davidkellis/keyboards/tkl/tkl1/README.md

# TKL v1: initial layout and KiCad design

This snapshot preserves the first TKL design iteration after the original
[v0 project](../tkl0/README.md). The existing source and layout files are
preserved byte for byte.

- Open [tkl.kicad_pro](tkl.kicad_pro) in KiCad.
- [PCB](tkl.kicad_pcb) and [schematic](tkl.kicad_sch)
- [Layout data](keyboard-layout.json)
- [Layout preview](keyboard-layout.png) and [alternate preview](keyboard-layout2.png)
- [Plate outline](keyboard-plate.svg)

The KiCad project is still named `tkl`; the directory name identifies this
snapshot as v1. See the [repository index](../../README.md) for later revisions.
