davidkellis/keyboards/tkl/tkl8/manufacturing/drill-report.txt

Drill report for keyboard.kicad_pcb
Created on 2026-09-25T14:55:08

Copper Layer Stackup:
    =============================================================
    L1 :  F.Cu                      front
    L2 :  In1.Cu                    in1
    L3 :  In2.Cu                    in2
    L4 :  B.Cu                      back

Drill file 'keyboard-PTH.drl' contains
    plated through holes:
    =============================================================
    T1  0.300mm  0.0118"  (188 holes))
    T2  0.305mm  0.0120"  (93 holes))
    T3  0.600mm  0.0236"  (4 holes)  (with 4 slots)
    T4  0.750mm  0.0295"  (4 holes))
    T5  1.200mm  0.0472"  (172 holes))
    T6  1.600mm  0.0630"  (86 holes))

    Total plated holes count 547

Drill file 'keyboard-NPTH.drl' contains
    unplated through holes:
    =============================================================
    T1  0.650mm  0.0256"  (2 holes))
    T2  0.900mm  0.0354"  (2 holes))
    T3  0.991mm  0.0390"  (3 holes))
    T4  5.050mm  0.1988"  (86 holes))

    Total unplated holes count 93
