davidkellis/keyboards/tkl/tkl5/keyboard-layout2.png

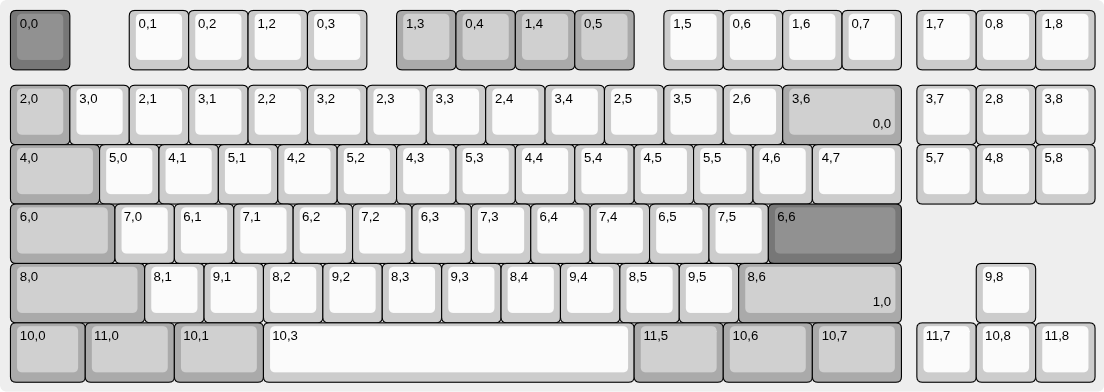
tkl/tkl5/keyboard-layout2.png
