davidkellis/keyboards/tkl/tkl5/keyboard-layout.png

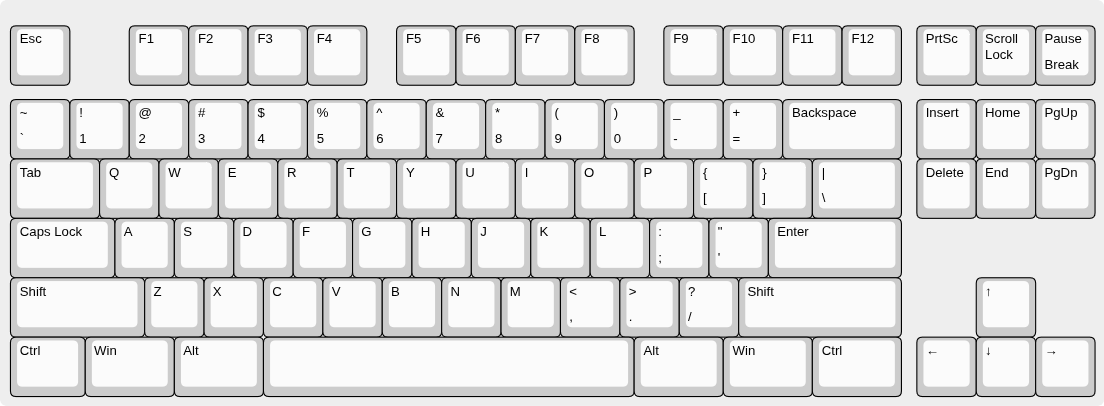
tkl/tkl5/keyboard-layout.png
