davidkellis/keyboards/tkl/tkl7.5/reference/usb-extension-dimensions-listing.png

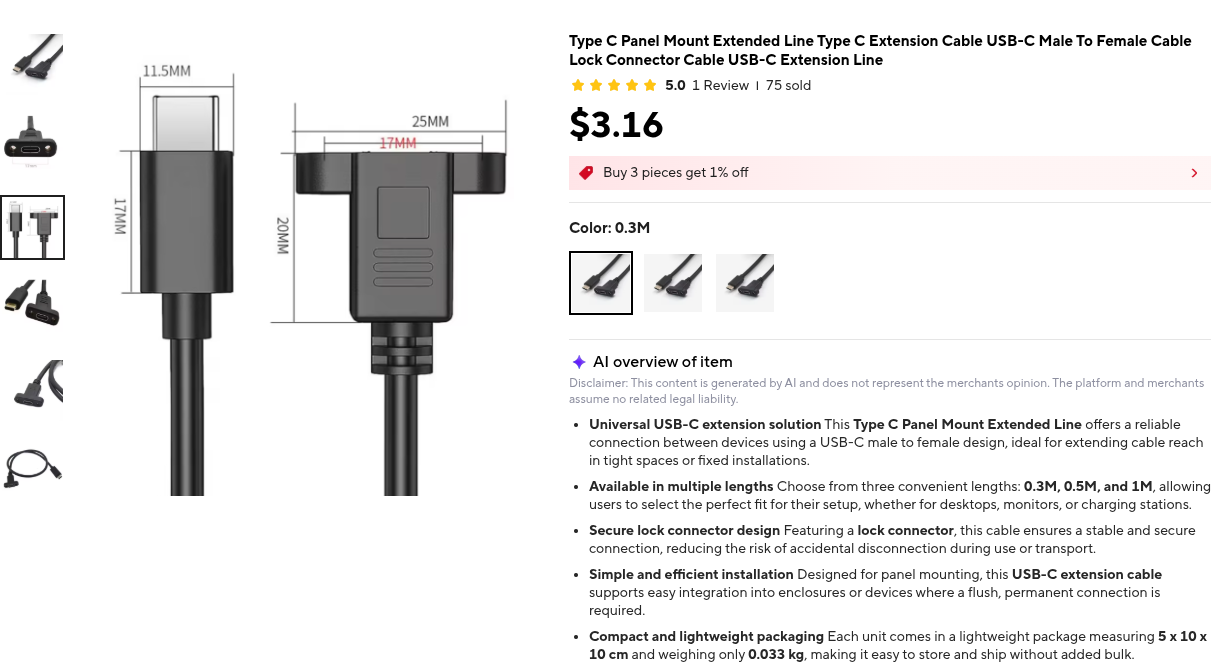
tkl/tkl7.5/reference/usb-extension-dimensions-listing.png
