davidkellis/keyboards/tkl/tkl7.5/reference/usb-extension-front-listing.png

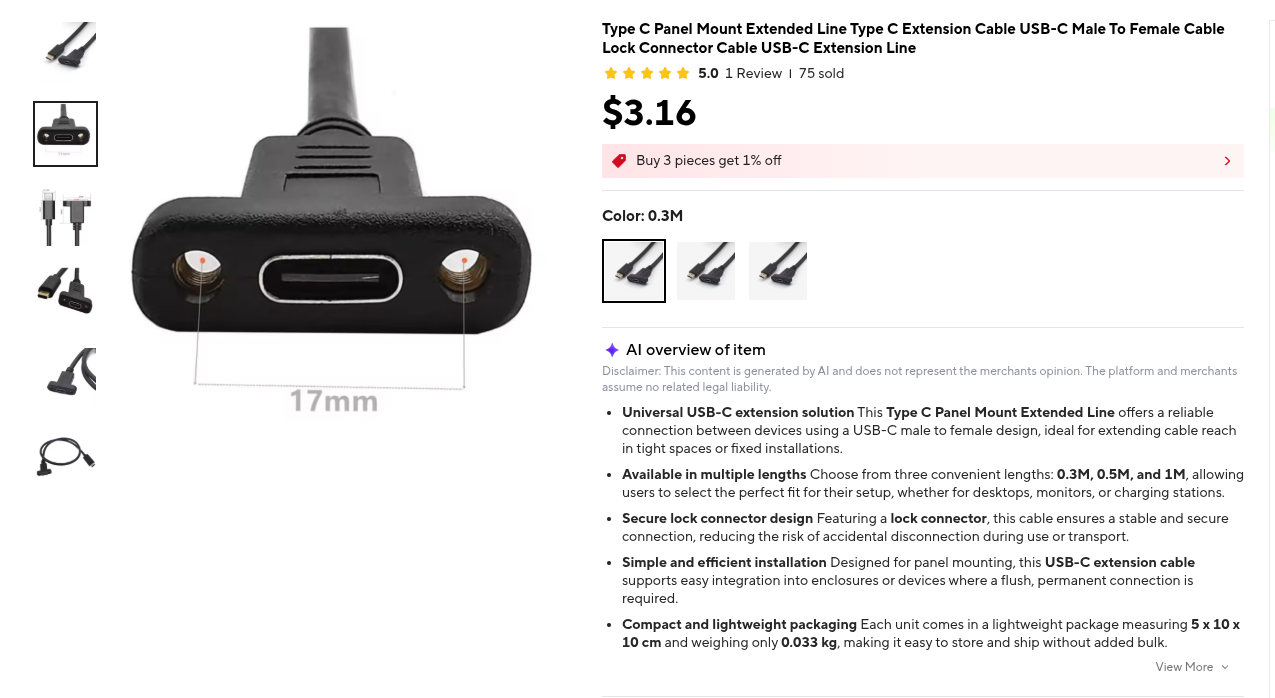
tkl/tkl7.5/reference/usb-extension-front-listing.png
