davidkellis/keyboards/tkl/tkl8/case/fit-preview.png

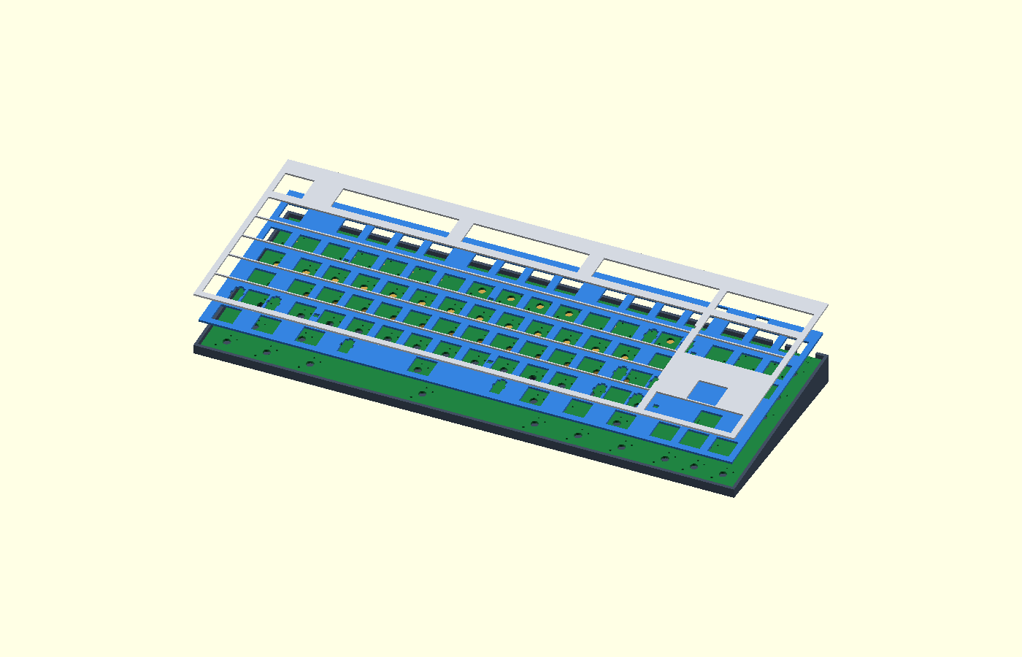
tkl/tkl8/case/fit-preview.png
