davidkellis/keyboards/tkl/tkl9.1/case/upper-preview.png

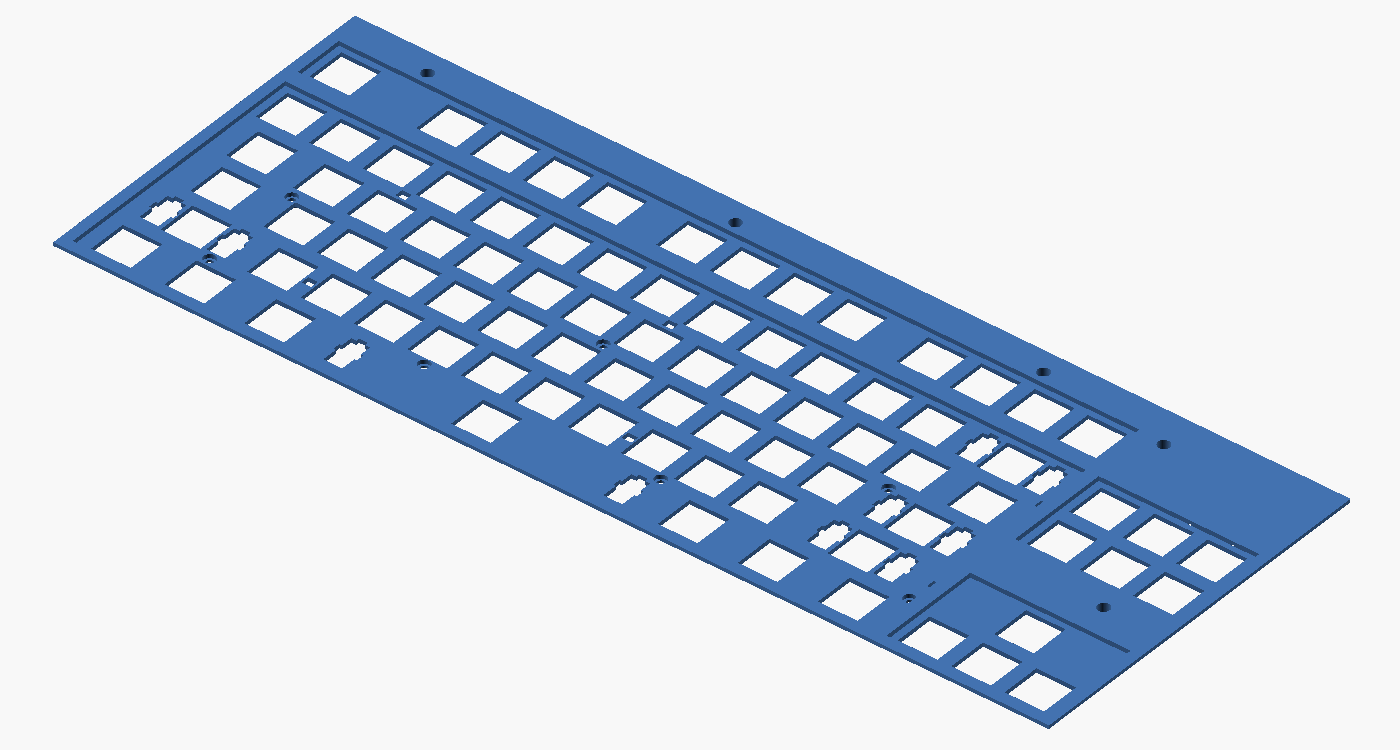
tkl/tkl9.1/case/upper-preview.png
