davidkellis/keyboards/tkl/tkl9.1/reference/tenstar-clone-reference.png

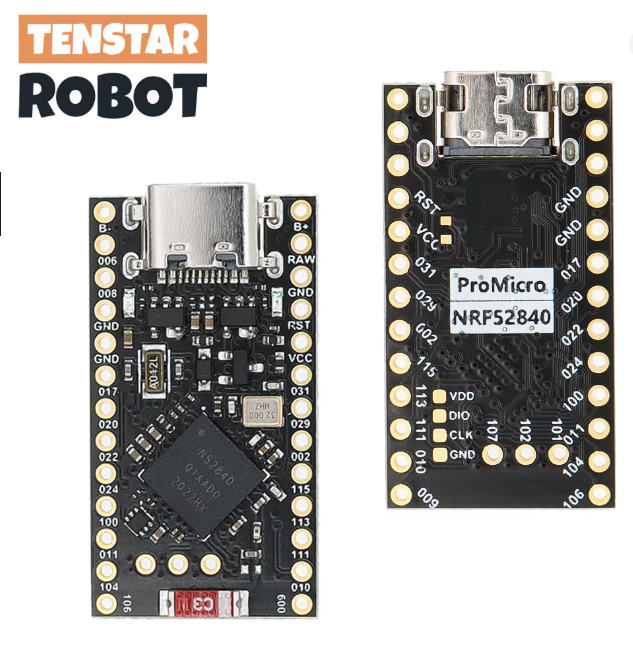
tkl/tkl9.1/reference/tenstar-clone-reference.png
