davidkellis/keyboards/tkl/tkl9.1/reference/tenstar-dimensions-listing.png

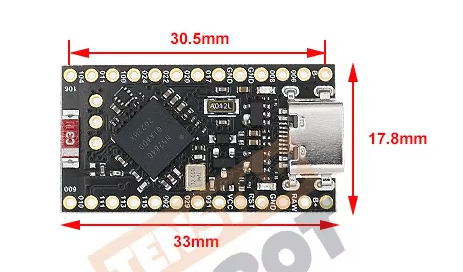
tkl/tkl9.1/reference/tenstar-dimensions-listing.png
