davidkellis/keyboards/tkl/tkl10/case-18650-study/comparison.png

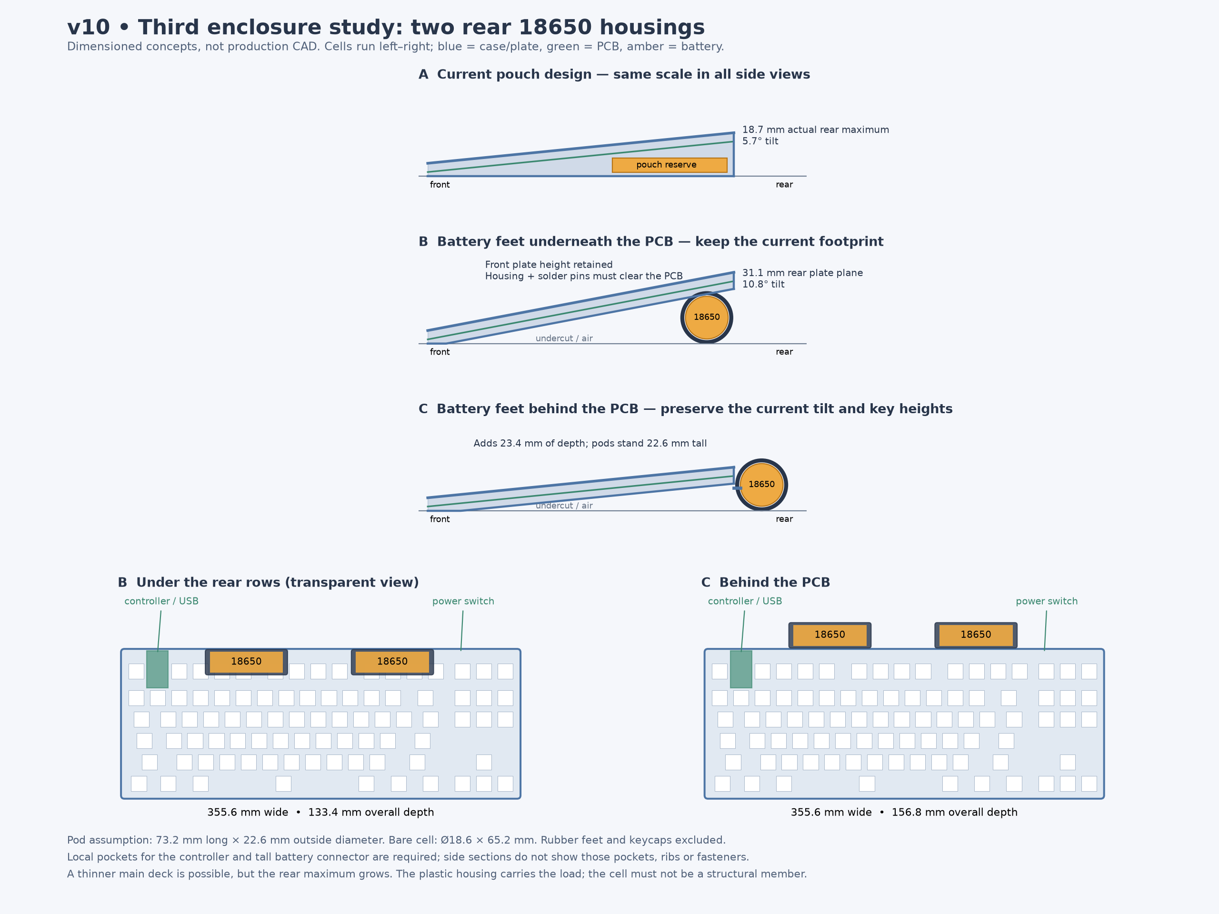
tkl/tkl10/case-18650-study/comparison.png
