davidkellis/keyboards/tkl/tkl10/case-hidden-mounts/completed-overview.png

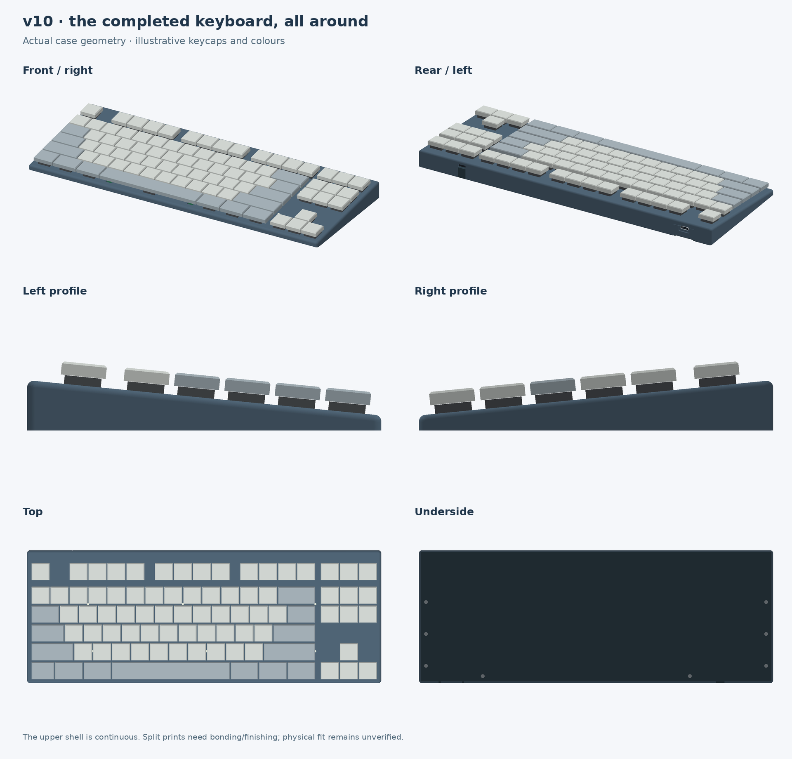
tkl/tkl10/case-hidden-mounts/completed-overview.png
