davidkellis/keyboards/tkl/tkl10/case-hidden-mounts/completed-views/bottom.png

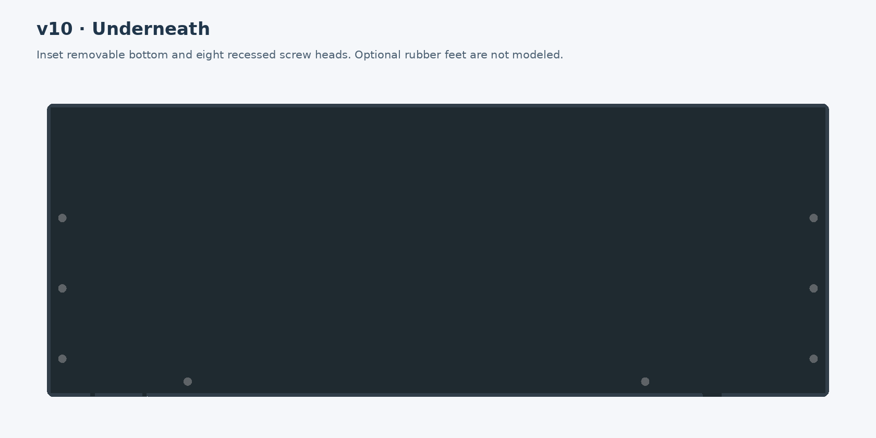
tkl/tkl10/case-hidden-mounts/completed-views/bottom.png
