davidkellis/keyboards/tkl/tkl10/case-hidden-mounts/completed-views/front.png

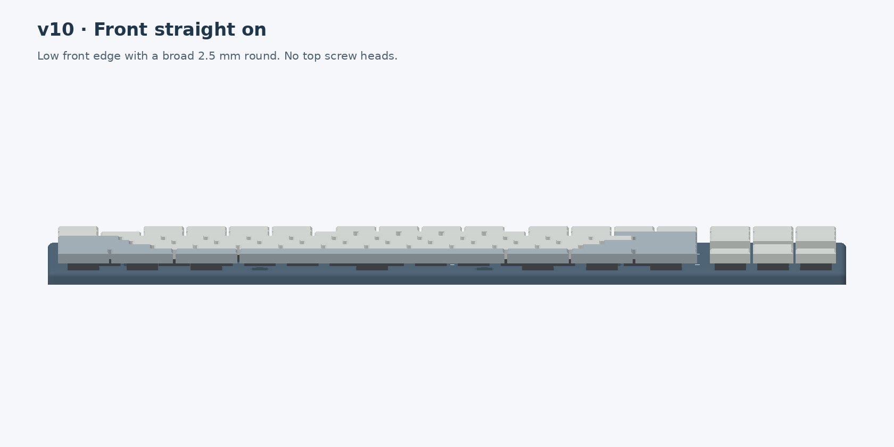
tkl/tkl10/case-hidden-mounts/completed-views/front.png
