davidkellis/keyboards/tkl/tkl10/case-hidden-mounts/completed-views/left.png

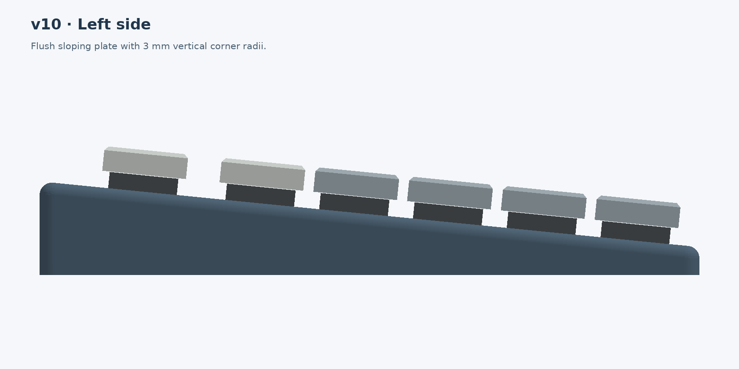
tkl/tkl10/case-hidden-mounts/completed-views/left.png
