davidkellis/keyboards/tkl/tkl10/case-hidden-mounts/completed-views/orbit-02.png

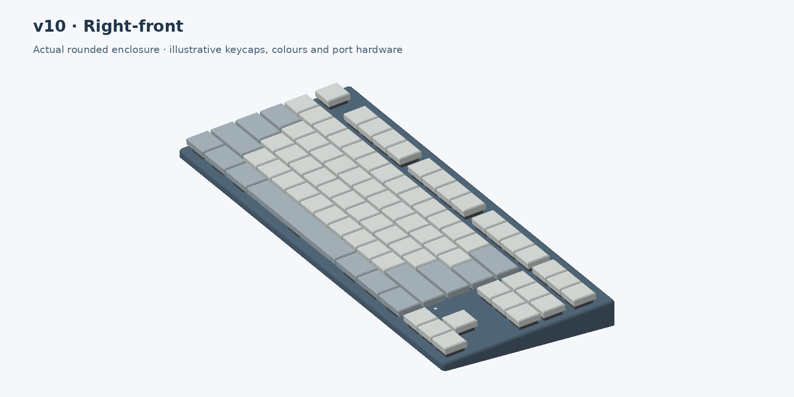
tkl/tkl10/case-hidden-mounts/completed-views/orbit-02.png
