davidkellis/keyboards/tkl/tkl10/case-hidden-mounts/completed-views/orbit-09.png

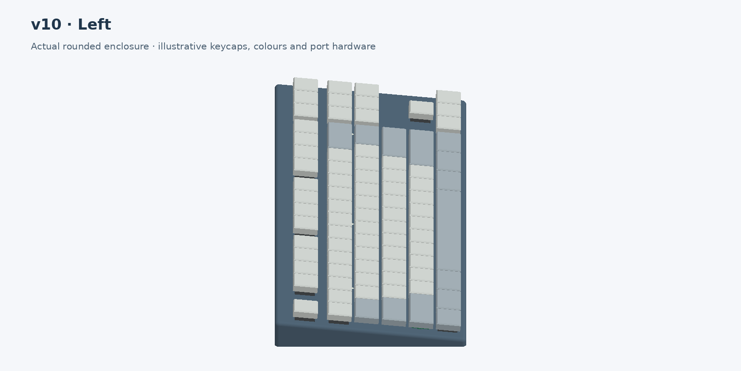
tkl/tkl10/case-hidden-mounts/completed-views/orbit-09.png
