davidkellis/keyboards/tkl/tkl10/case-hidden-mounts/completed-views/rear.png

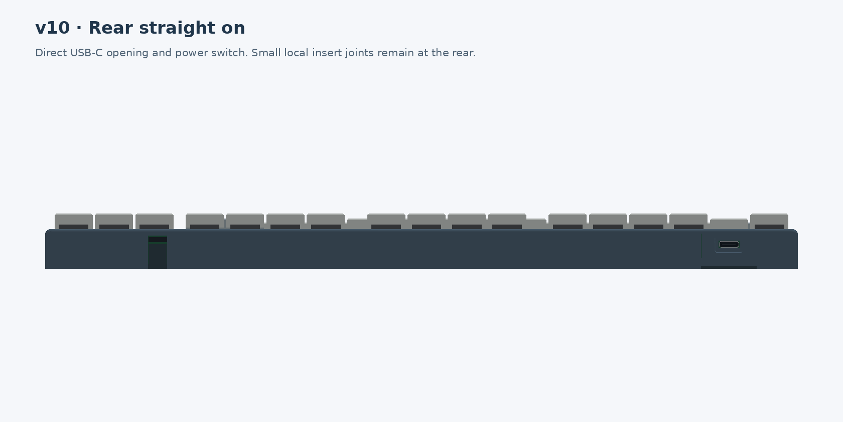
tkl/tkl10/case-hidden-mounts/completed-views/rear.png
