davidkellis/keyboards/tkl/tkl10/case-hidden-mounts/completed-views/right.png

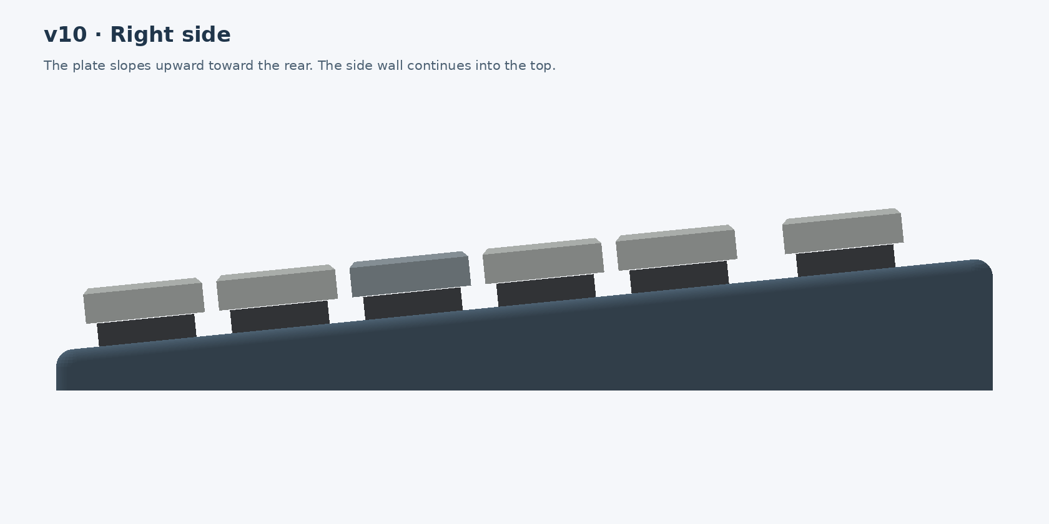
tkl/tkl10/case-hidden-mounts/completed-views/right.png
