davidkellis/keyboards/tkl/tkl10/case-hidden-mounts/completed-views/top.png

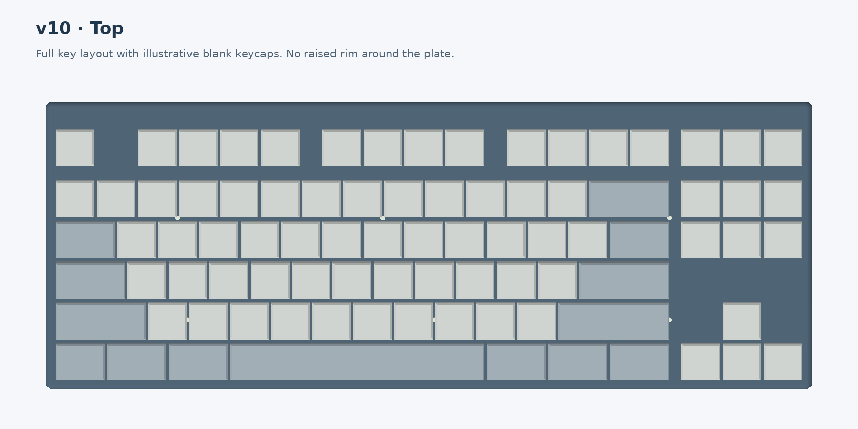
tkl/tkl10/case-hidden-mounts/completed-views/top.png
