davidkellis/keyboards/tkl/tkl10/case-hidden-mounts/exploded-preview.png

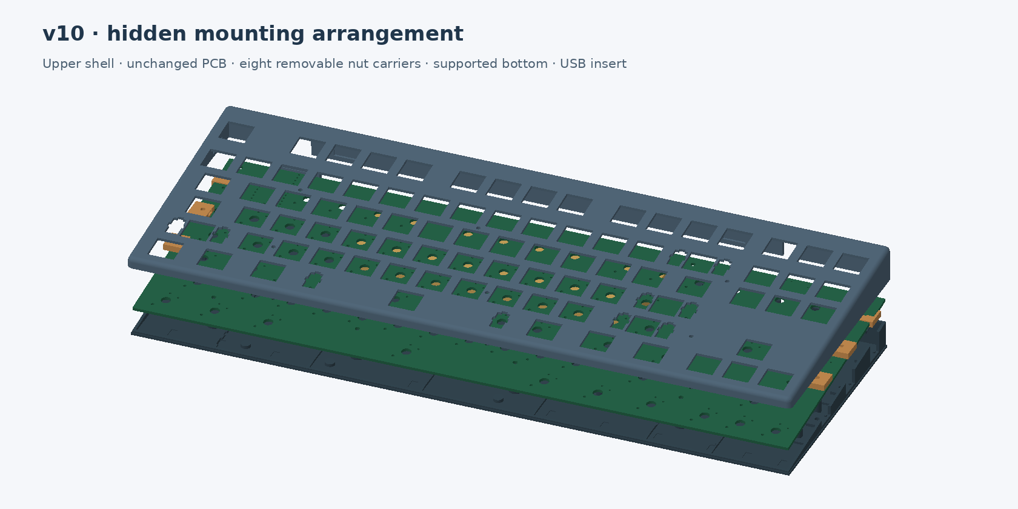
tkl/tkl10/case-hidden-mounts/exploded-preview.png
