davidkellis/keyboards/tkl/tkl10/case-hidden-mounts/mount-detail.png

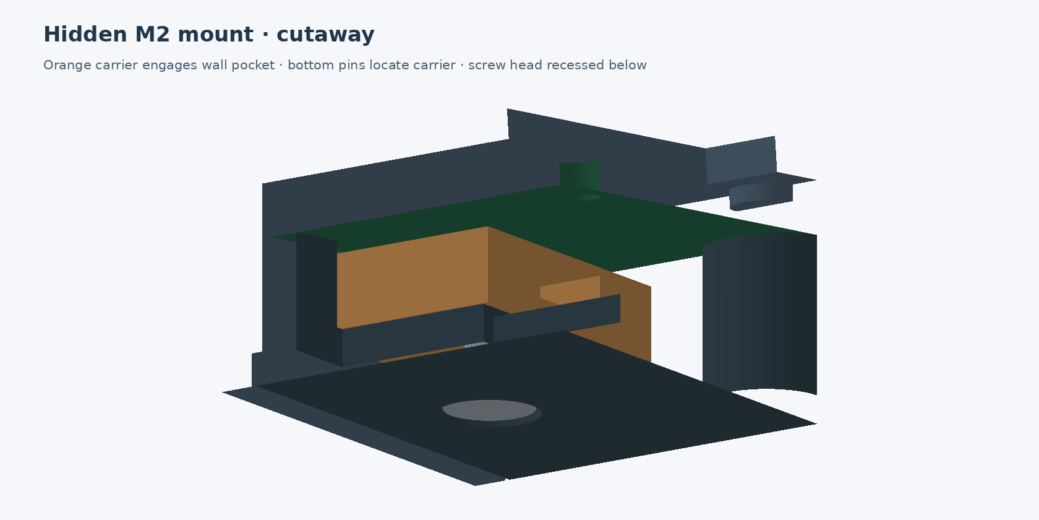
tkl/tkl10/case-hidden-mounts/mount-detail.png
