davidkellis/keyboards/tkl/tkl10/case-hidden-mounts/rounded-edge-detail.png

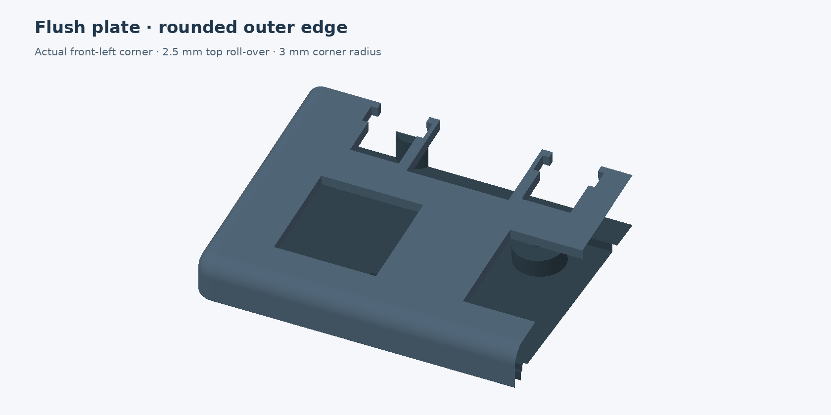
tkl/tkl10/case-hidden-mounts/rounded-edge-detail.png
