davidkellis/keyboards/tkl/tkl10/case-hidden-mounts/shell-section.png

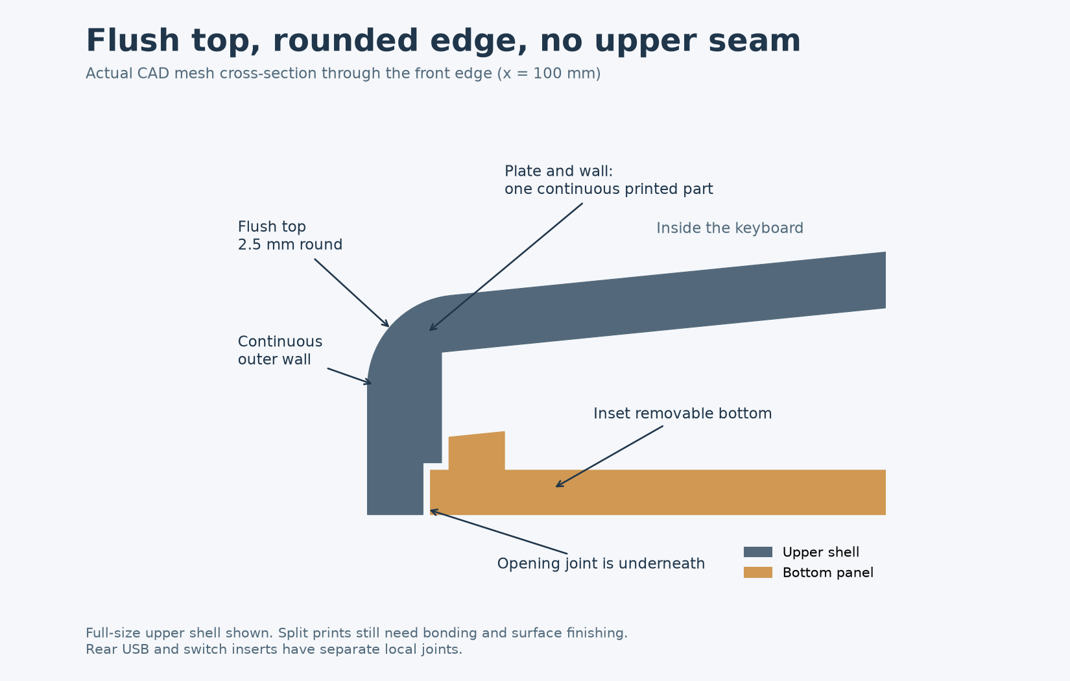
tkl/tkl10/case-hidden-mounts/shell-section.png
