davidkellis/keyboards/tkl/tkl10/case-hidden-mounts/top-preview.png

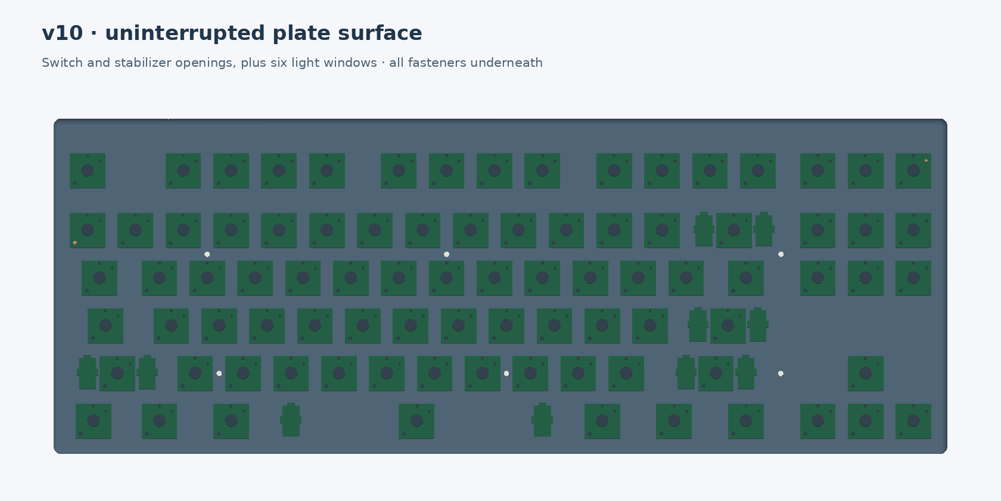
tkl/tkl10/case-hidden-mounts/top-preview.png
