davidkellis/keyboards/tkl/tkl10/case-hidden-mounts/underside-preview.png

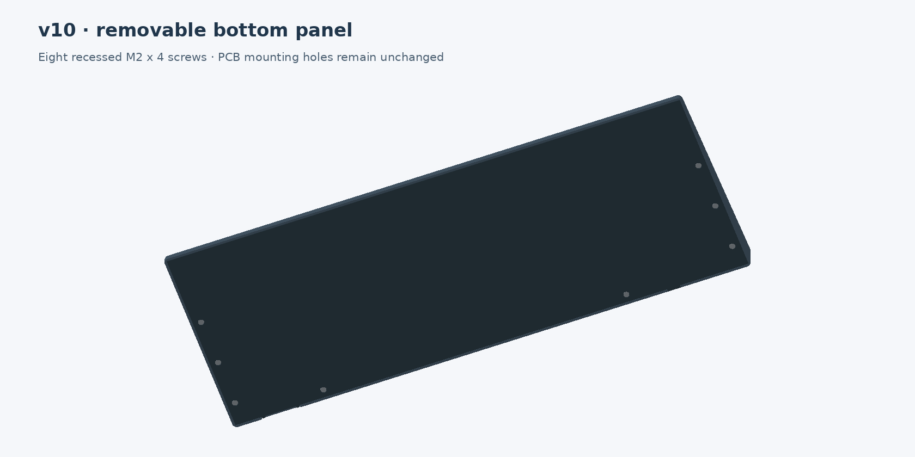
tkl/tkl10/case-hidden-mounts/underside-preview.png
