davidkellis/keyboards/tkl/tkl10/case-hidden-mounts/with-keycaps-preview.png

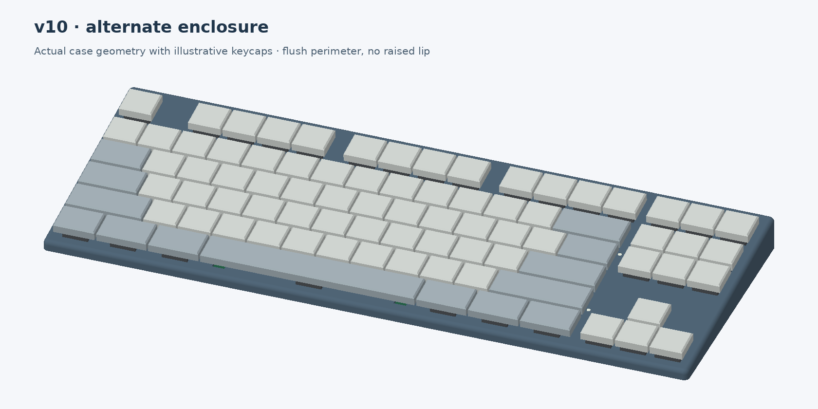
tkl/tkl10/case-hidden-mounts/with-keycaps-preview.png
