davidkellis/keyboards/tkl/tkl10/case-slim-study/height-options.png

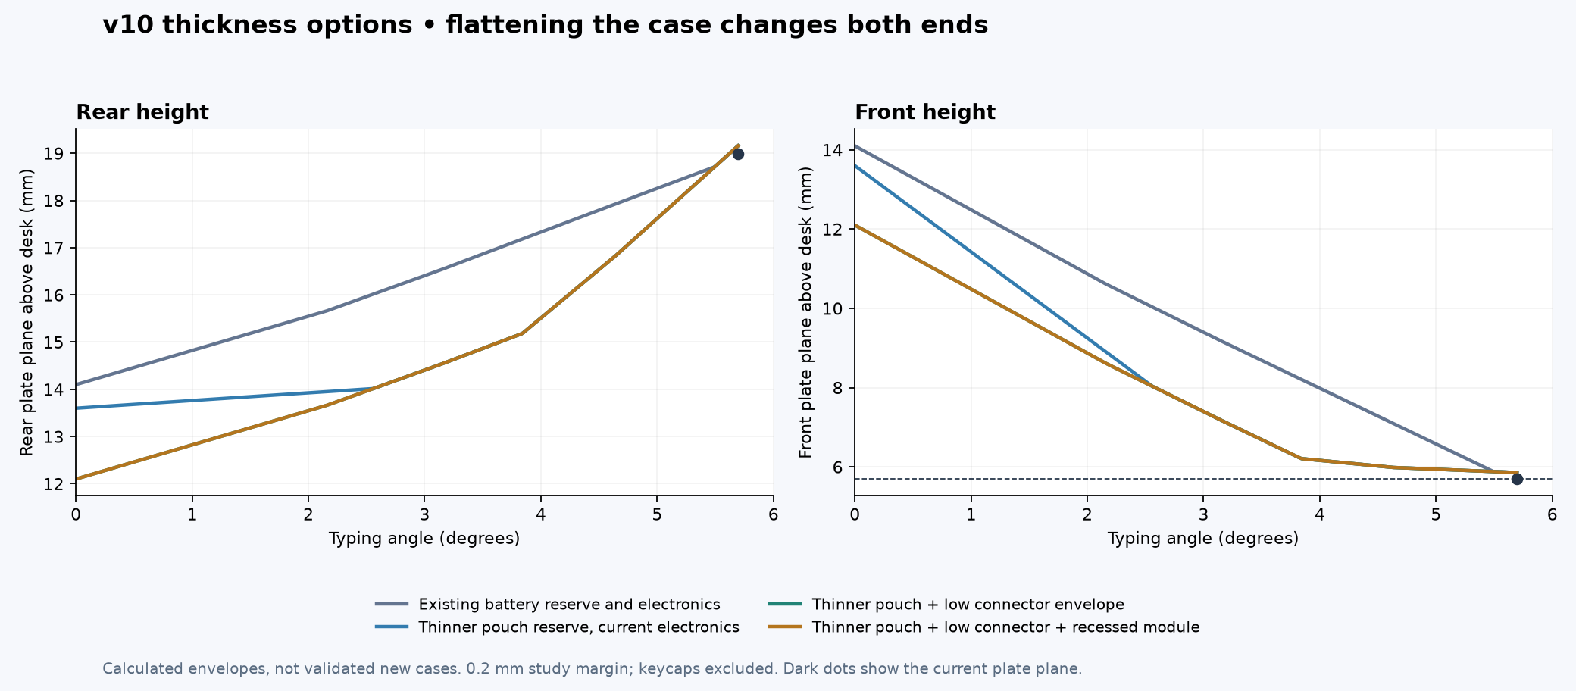
tkl/tkl10/case-slim-study/height-options.png
