davidkellis/keyboards/tkl/tkl10/case/base-preview.png

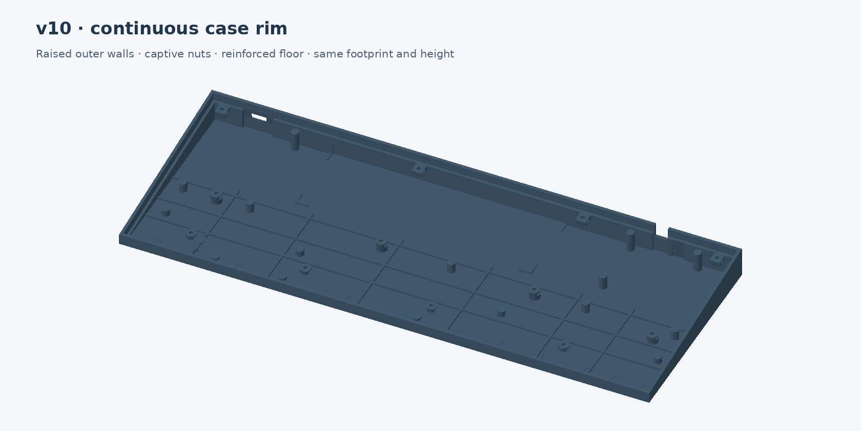
tkl/tkl10/case/base-preview.png
