davidkellis/keyboards/tkl/tkl10/case/module-fit.png

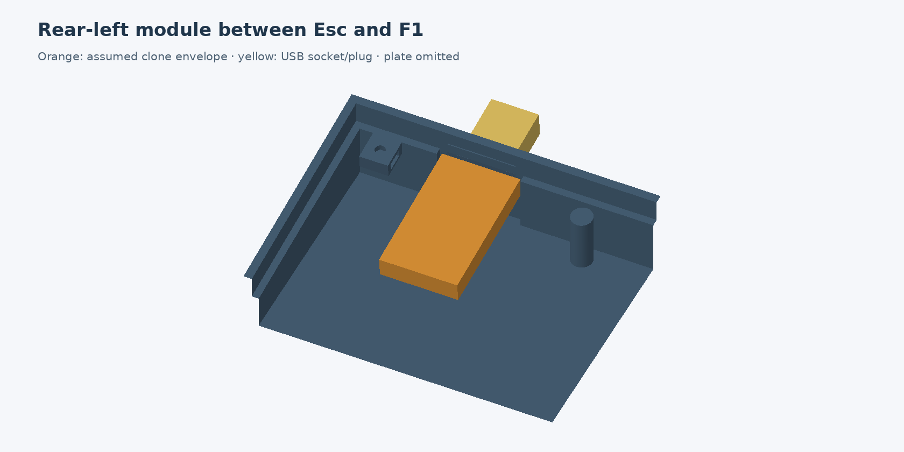
tkl/tkl10/case/module-fit.png
