davidkellis/keyboards/tkl/tkl10/case/mounting-plan.png

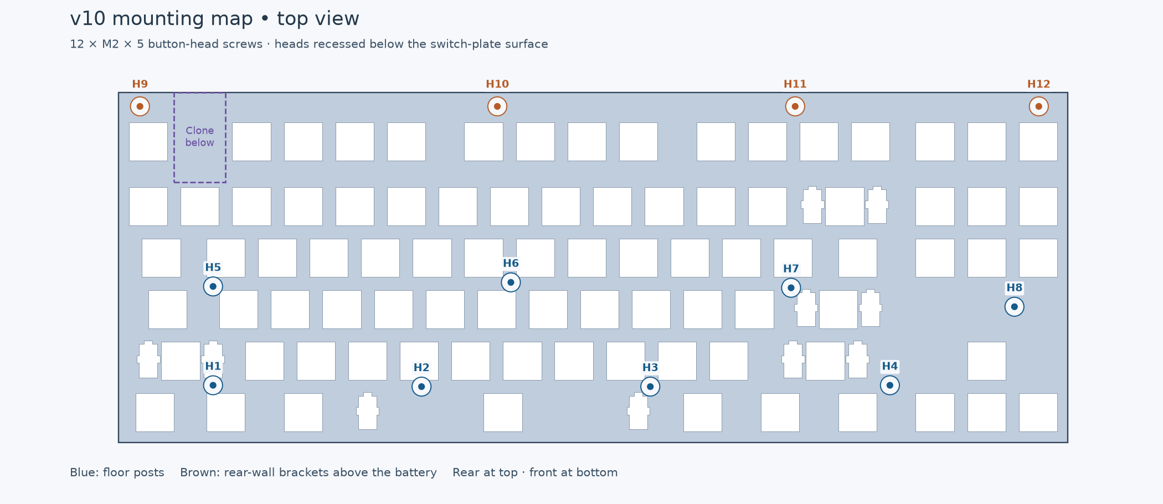
tkl/tkl10/case/mounting-plan.png
