davidkellis/keyboards/tkl/tkl10/case/plate-preview.png

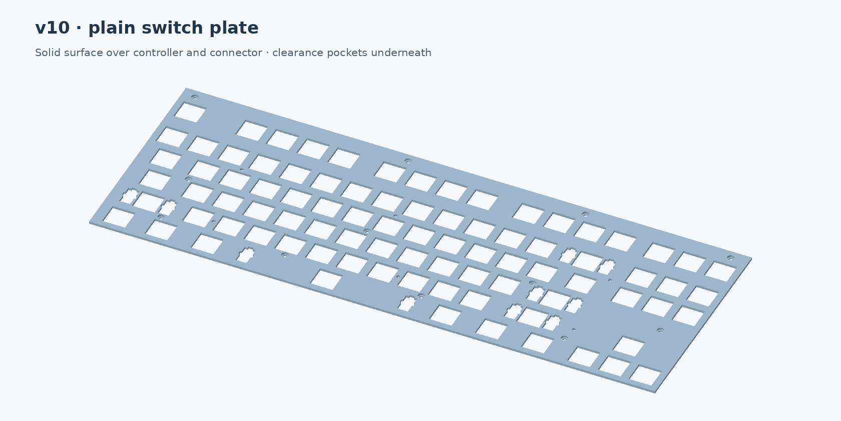
tkl/tkl10/case/plate-preview.png
