davidkellis/keyboards/tkl/tkl10/case/rear-detail.png

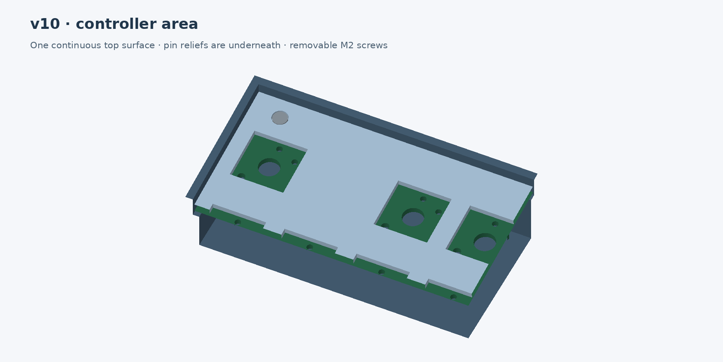
tkl/tkl10/case/rear-detail.png
