davidkellis/keyboards/tkl/tkl10/case/usb-surround.png

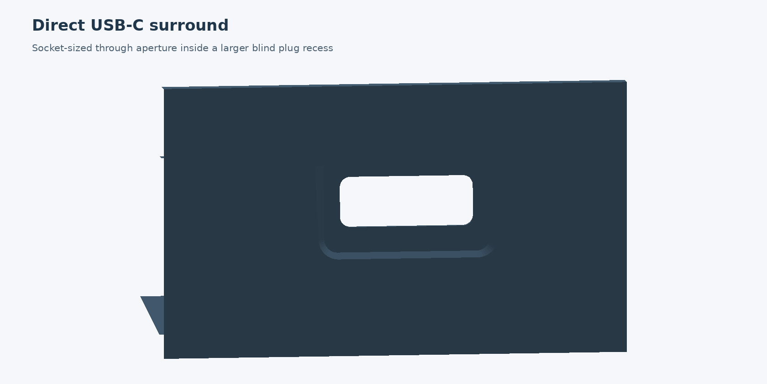
tkl/tkl10/case/usb-surround.png
