davidkellis/keyboards/tkl/tkl10/lighting-engineering-study/design-preview.png

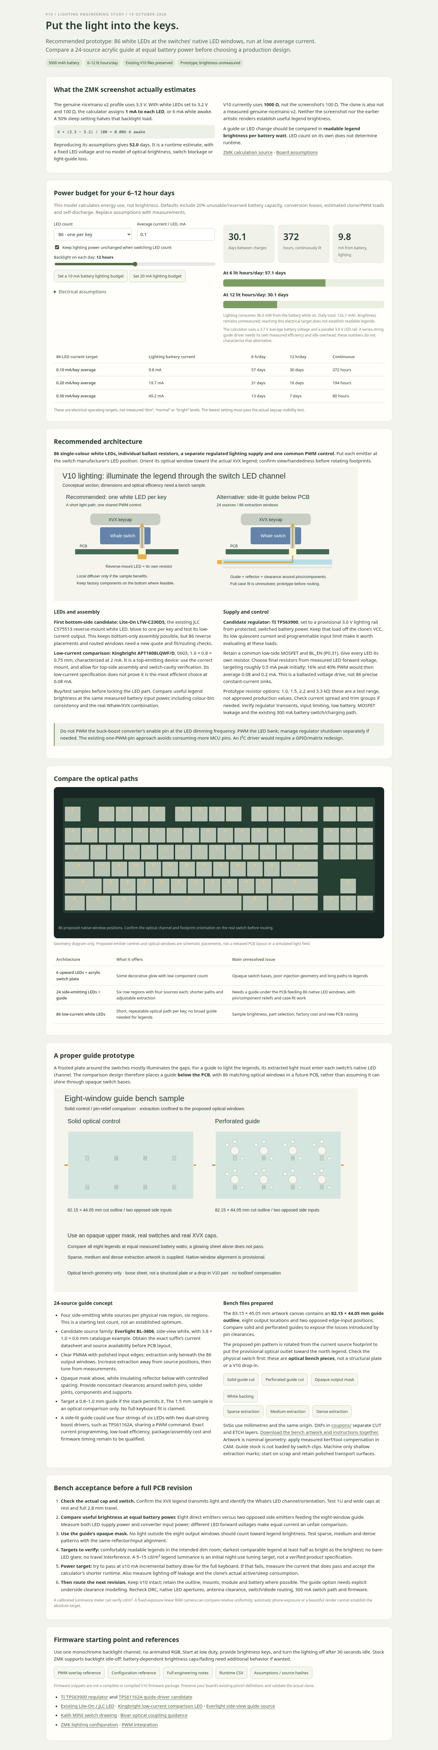
tkl/tkl10/lighting-engineering-study/design-preview.png
