davidkellis/keyboards/tkl/tkl10/lighting-engineering-study/lighting-section.png

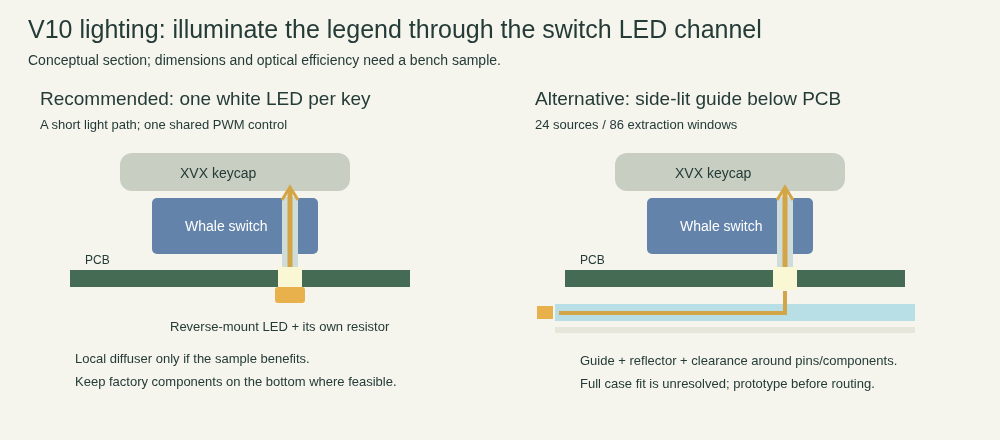
tkl/tkl10/lighting-engineering-study/lighting-section.png
