davidkellis/keyboards/tkl/tkl10/lighting-engineering-study/mobile-preview.png

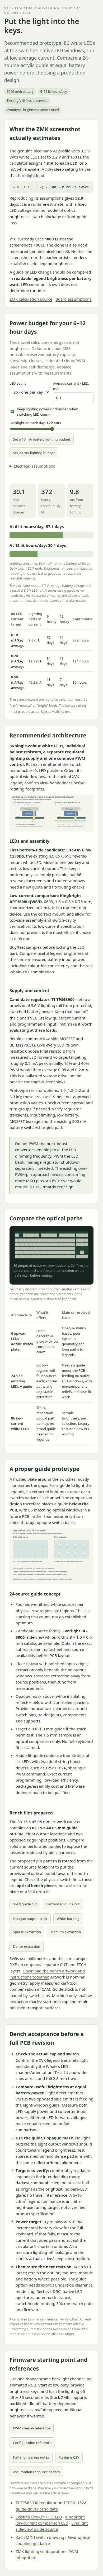
tkl/tkl10/lighting-engineering-study/mobile-preview.png
