davidkellis/keyboards/tkl/tkl10/lighting-engineering-study/power-budget-preview.png

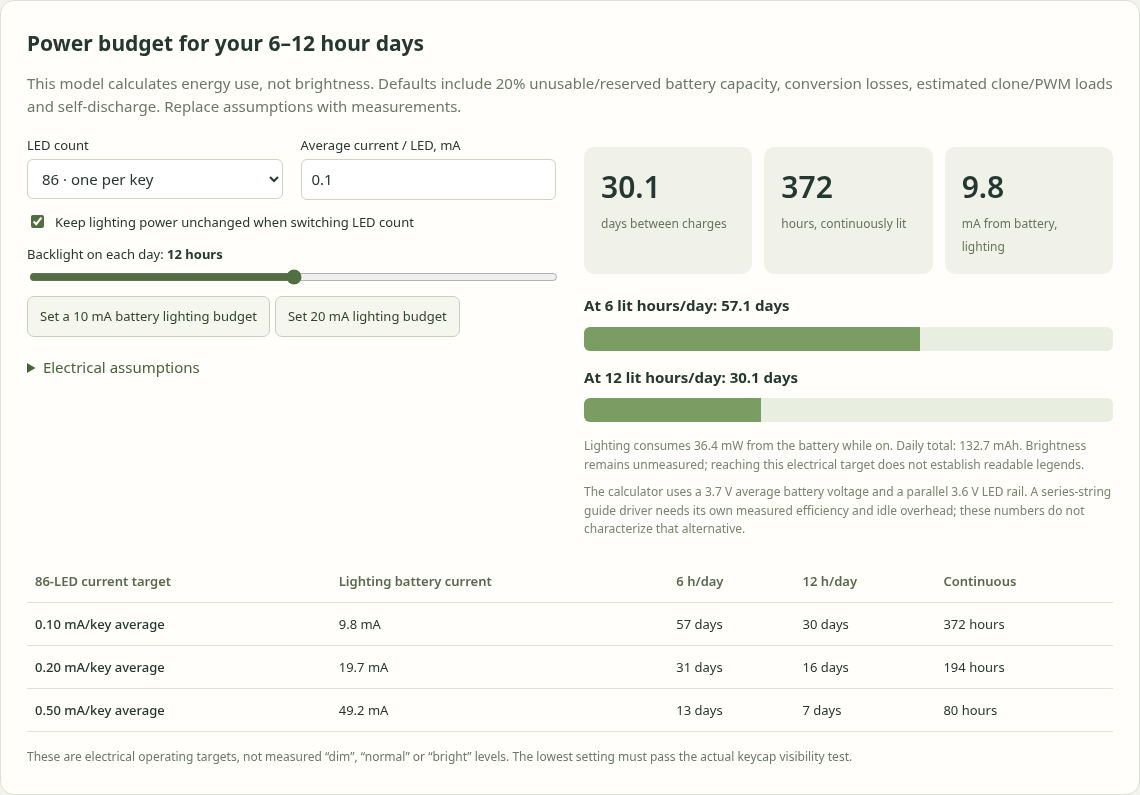
tkl/tkl10/lighting-engineering-study/power-budget-preview.png
