davidkellis/keyboards/tkl/tkl10/lighting-guide-12-study/design-preview.png

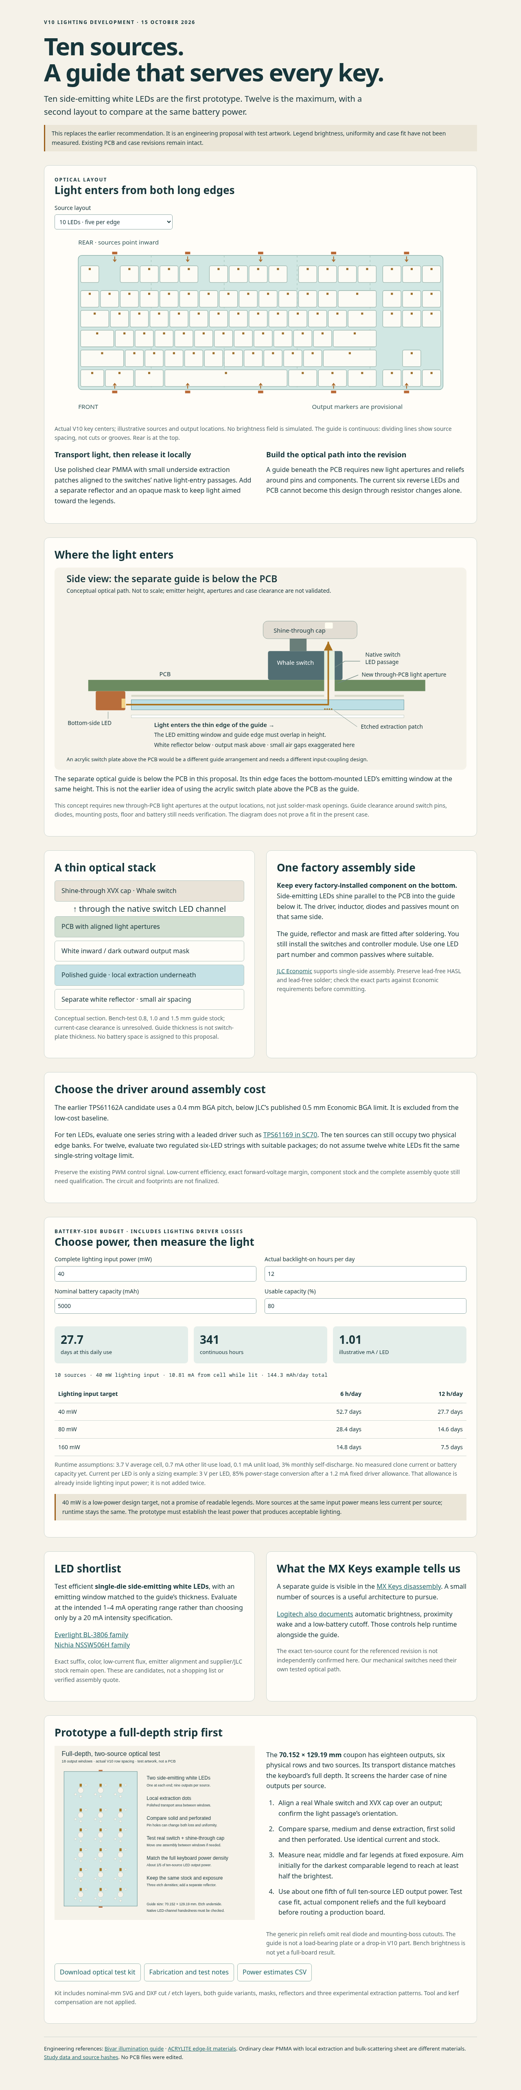
tkl/tkl10/lighting-guide-12-study/design-preview.png
