davidkellis/keyboards/tkl/tkl10/render-360/bottom.png

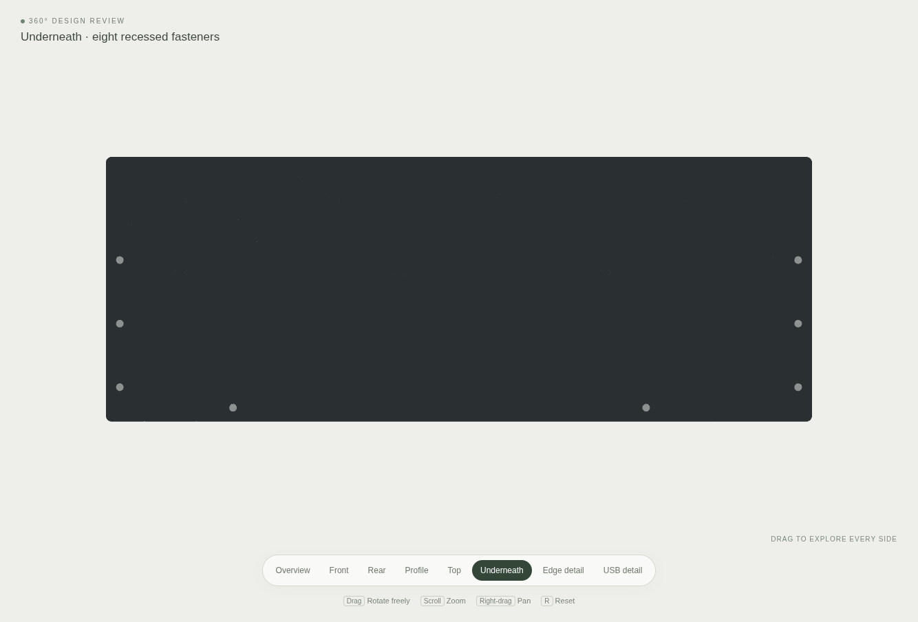
tkl/tkl10/render-360/bottom.png
