davidkellis/keyboards/tkl/tkl10/render-360/edge.png

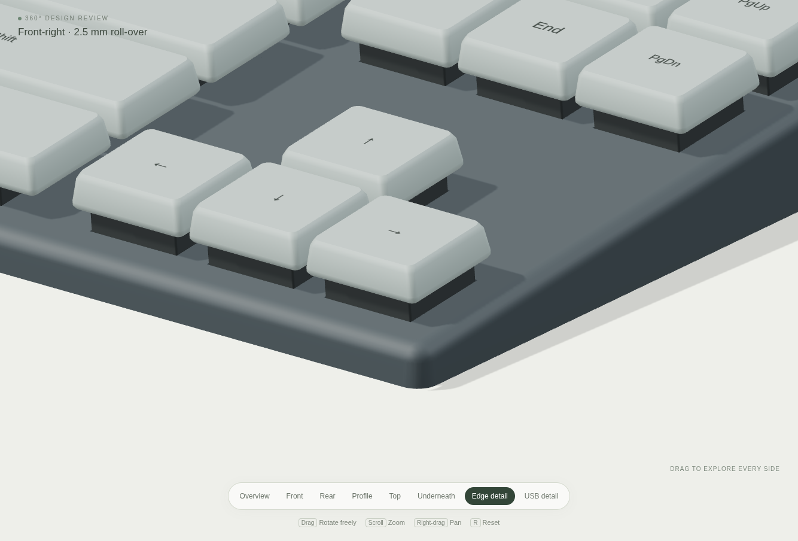
tkl/tkl10/render-360/edge.png
