davidkellis/keyboards/tkl/tkl10/render-360/front.png

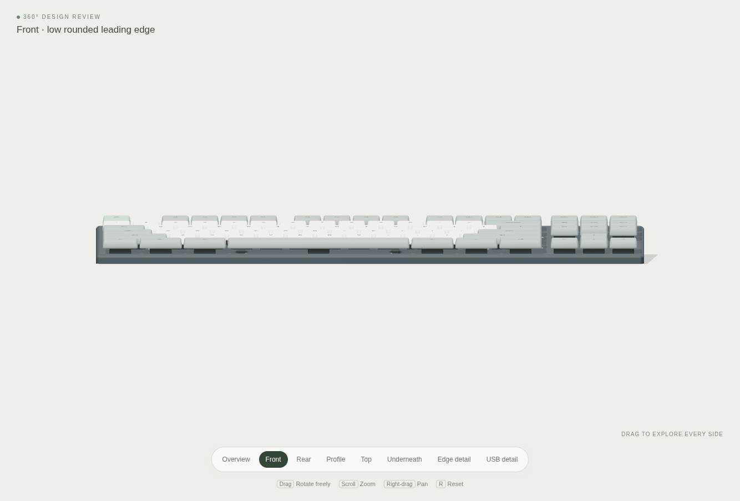
tkl/tkl10/render-360/front.png
