davidkellis/keyboards/tkl/tkl10/render-360/hero.png

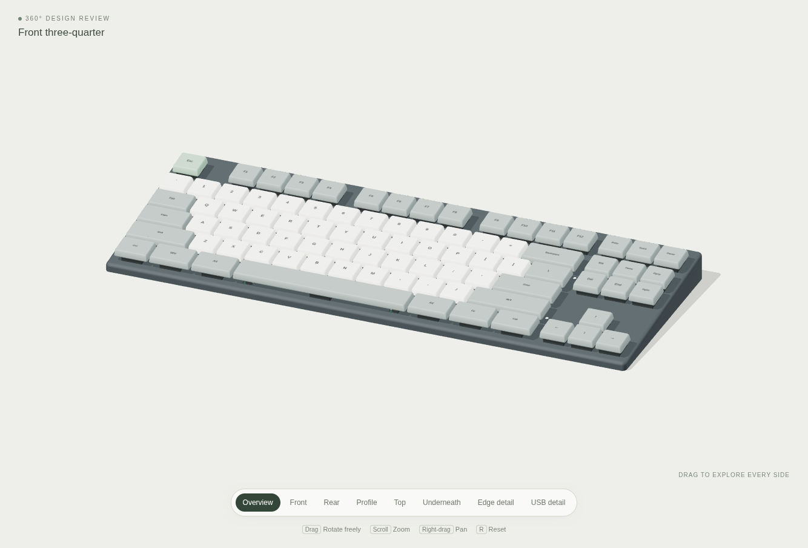
tkl/tkl10/render-360/hero.png
