davidkellis/keyboards/tkl/tkl10/render-360/mobile-preview.png

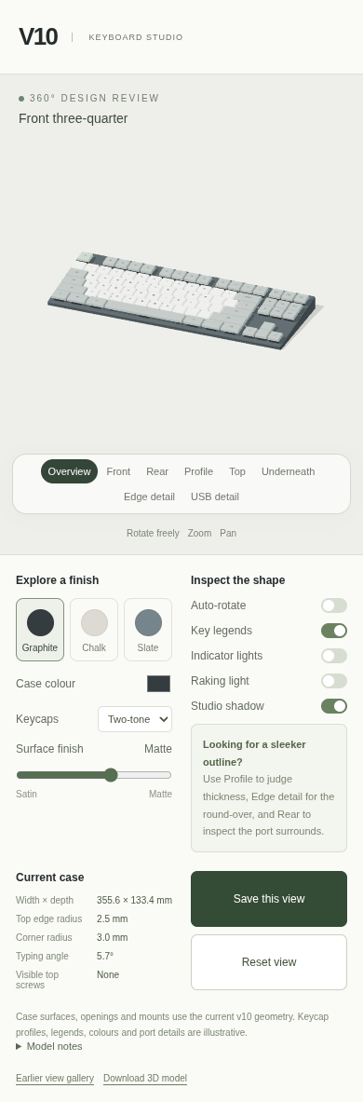
tkl/tkl10/render-360/mobile-preview.png
