davidkellis/keyboards/tkl/tkl10/render-360/rear.png

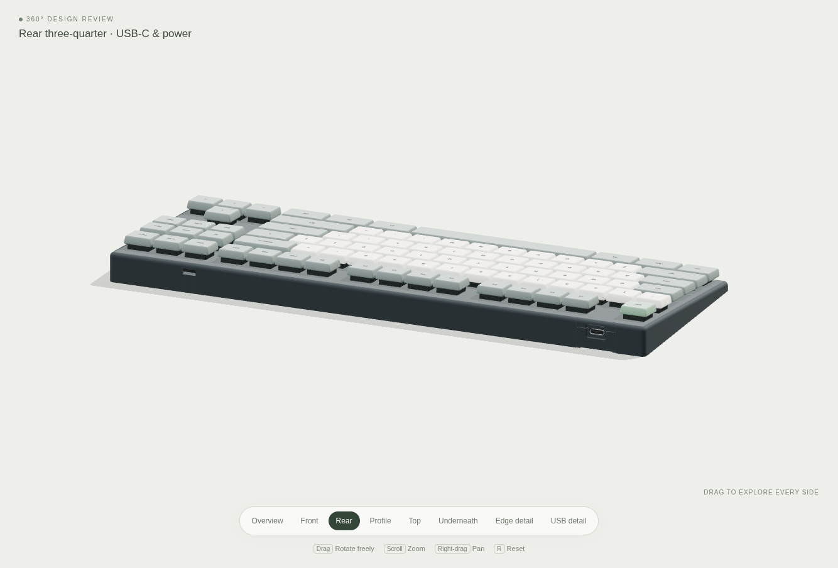
tkl/tkl10/render-360/rear.png
