davidkellis/keyboards/tkl/tkl10/render-360/side.png

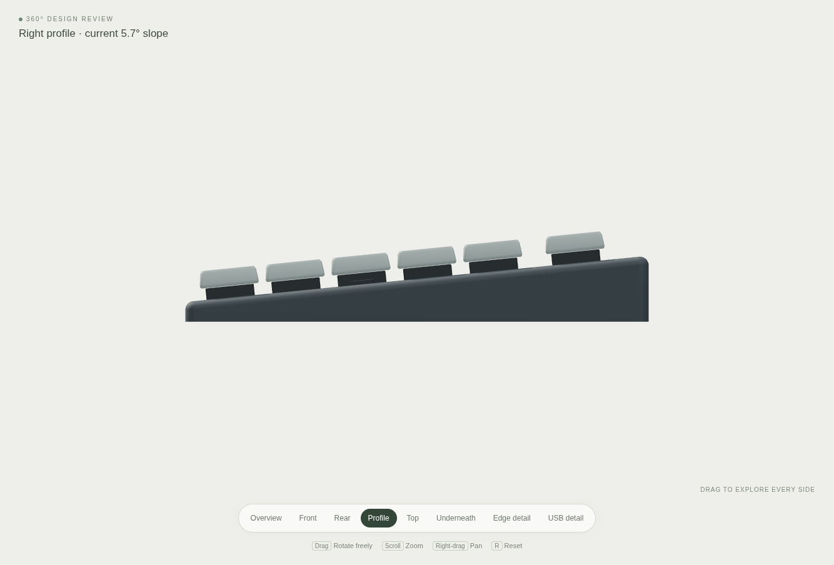
tkl/tkl10/render-360/side.png
