davidkellis/keyboards/tkl/tkl10/render-360/studio-preview.png

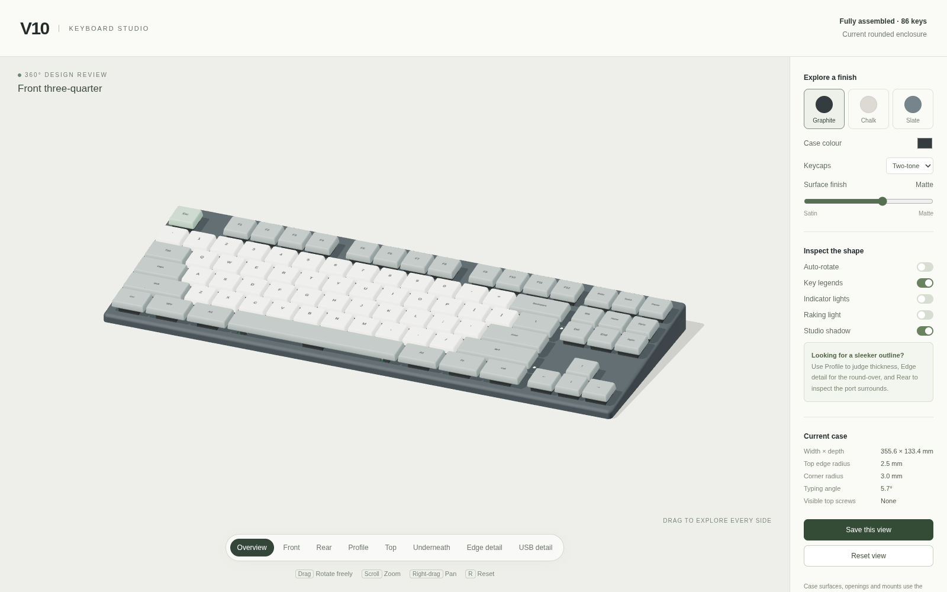
tkl/tkl10/render-360/studio-preview.png
