davidkellis/keyboards/tkl/tkl10/render-360/top.png

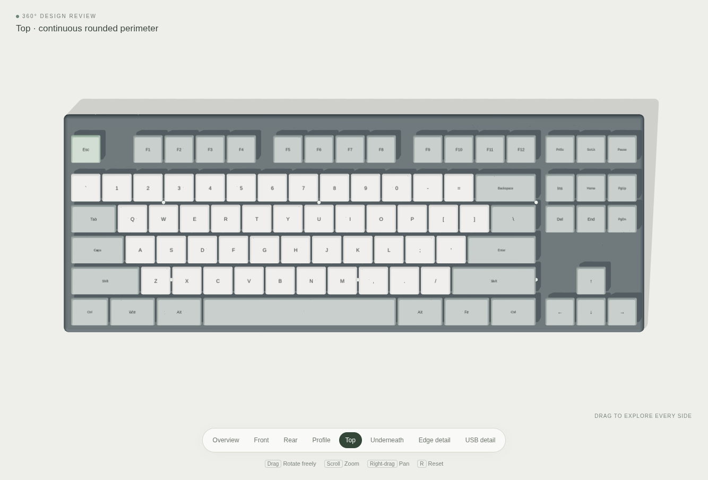
tkl/tkl10/render-360/top.png
