davidkellis/keyboards/tkl/tkl10/render-360/usb.png

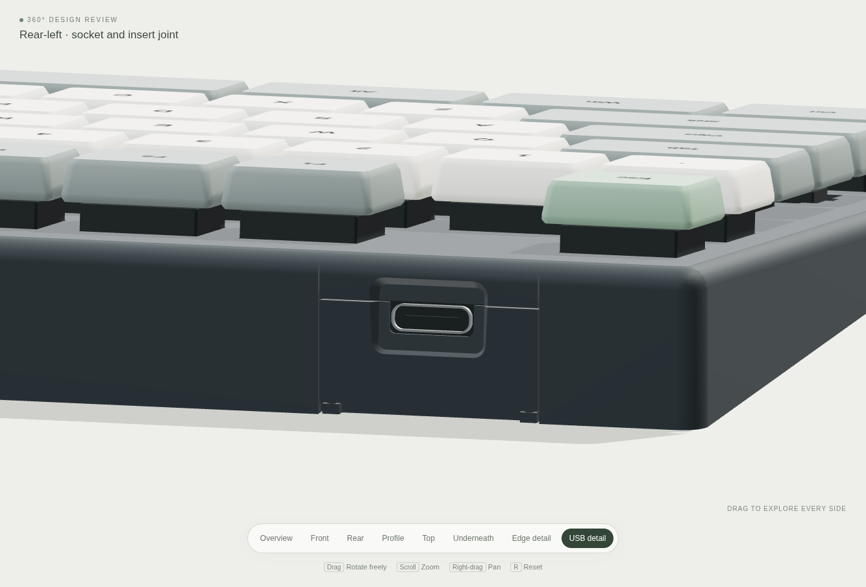
tkl/tkl10/render-360/usb.png
