davidkellis/keyboards/tkl/tkl10/render-360/v10-hero-high-resolution.png

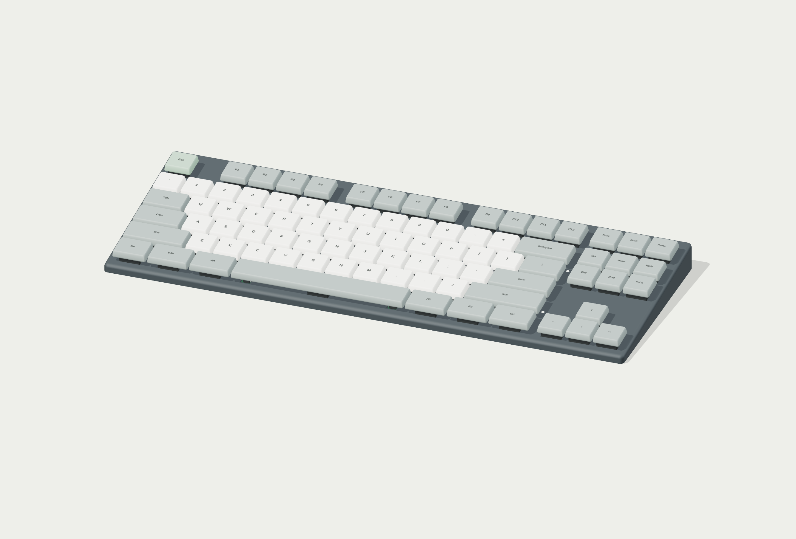
tkl/tkl10/render-360/v10-hero-high-resolution.png
