davidkellis/keyboards/tkl/tkl10/render-acrylic-study/acrylic-comparison.png

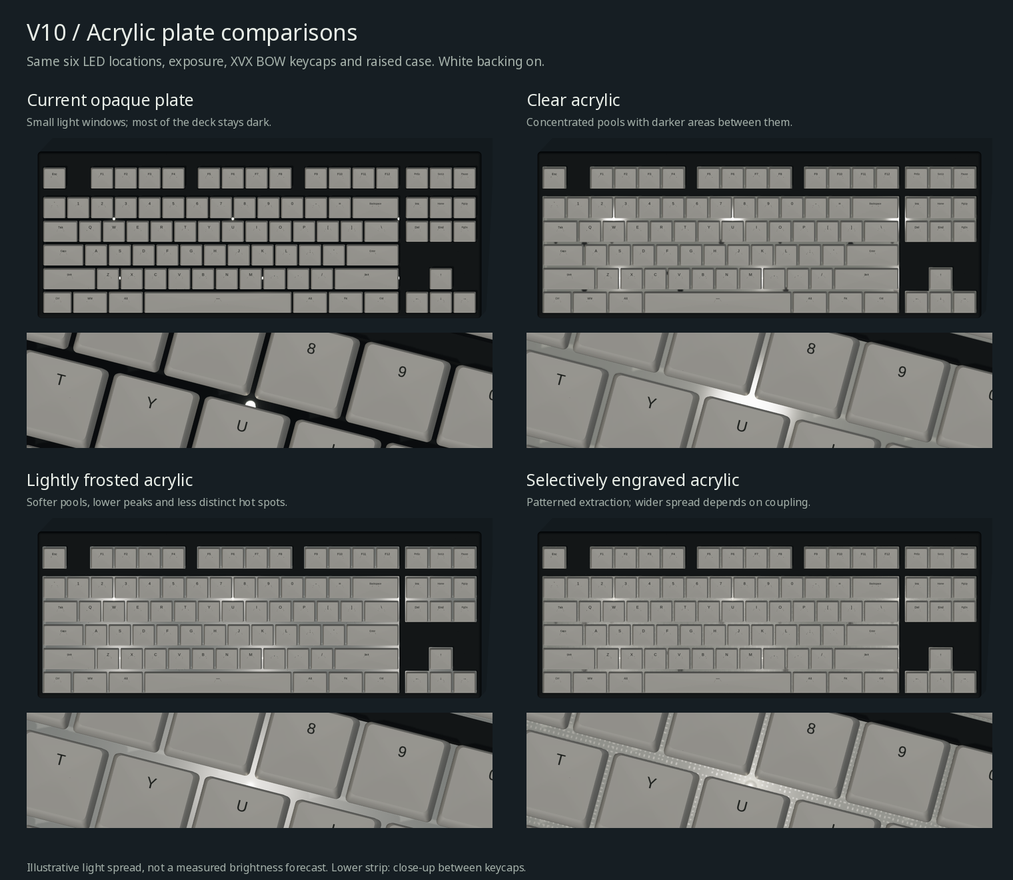
tkl/tkl10/render-acrylic-study/acrylic-comparison.png
