davidkellis/keyboards/tkl/tkl10/render-acrylic-study/acrylic-plate-revealed.png

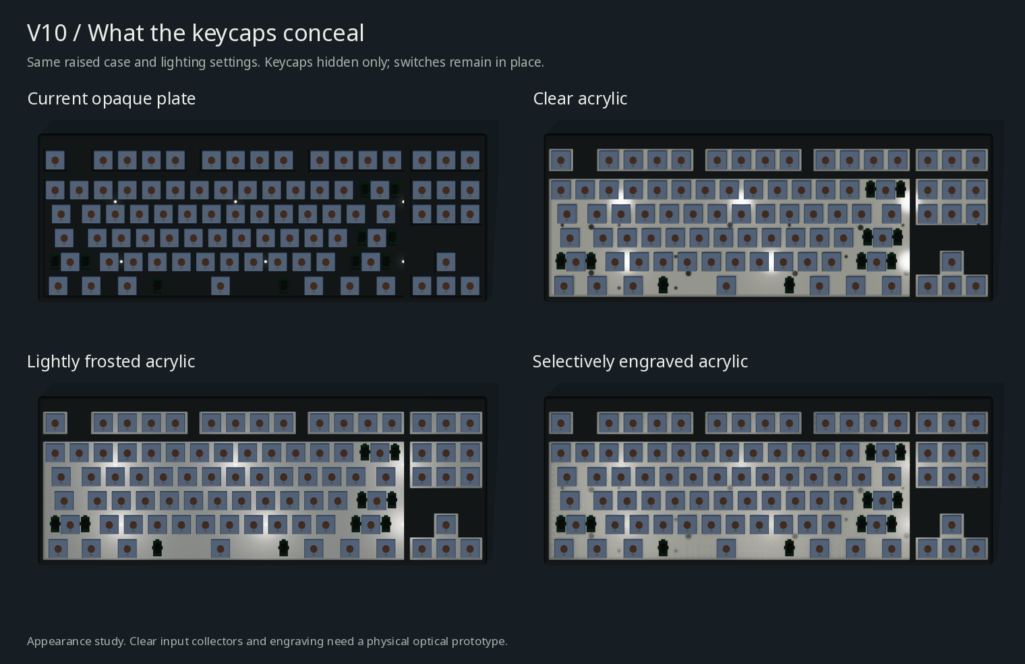
tkl/tkl10/render-acrylic-study/acrylic-plate-revealed.png
