davidkellis/keyboards/tkl/tkl10/render-acrylic-study/mobile-preview.png

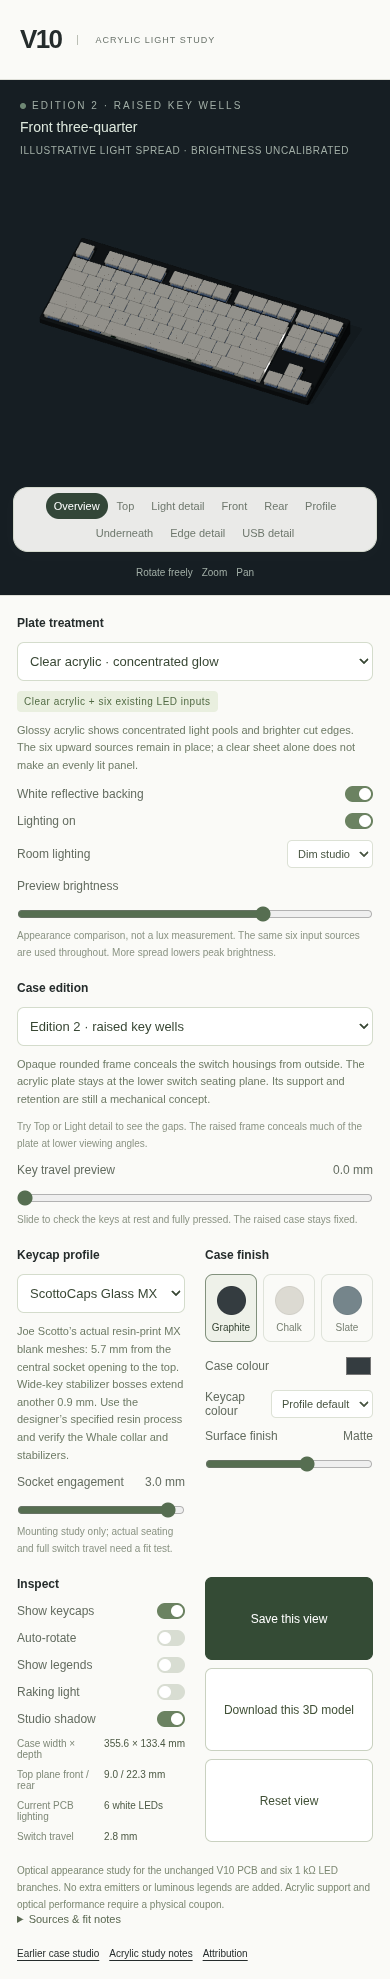
tkl/tkl10/render-acrylic-study/mobile-preview.png
