davidkellis/keyboards/tkl/tkl10/render-acrylic-study/studio-preview.png

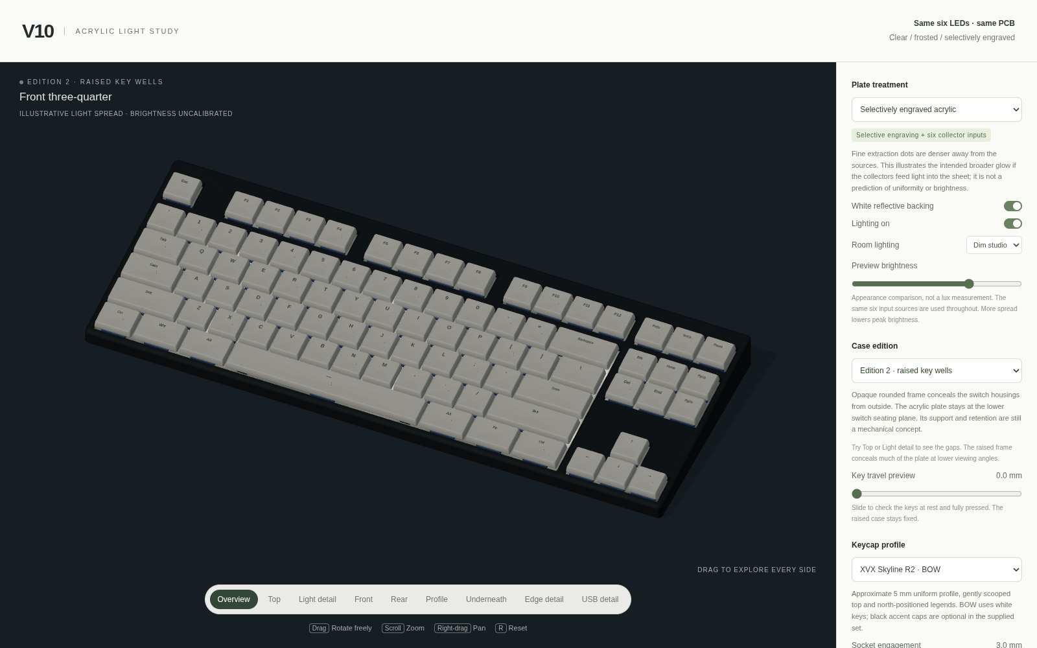
tkl/tkl10/render-acrylic-study/studio-preview.png
