davidkellis/keyboards/tkl/tkl10/render-acrylic-study/v10-acrylic-preview.png

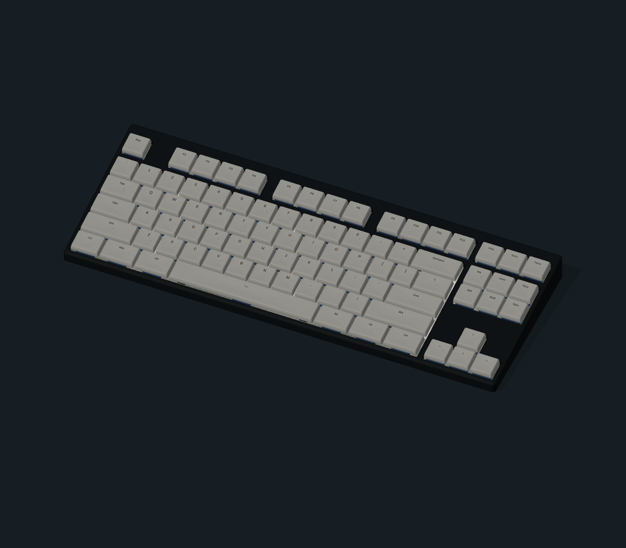
tkl/tkl10/render-acrylic-study/v10-acrylic-preview.png
