davidkellis/keyboards/tkl/tkl10/render-acrylic-study/views/caps-flat-frosted.png

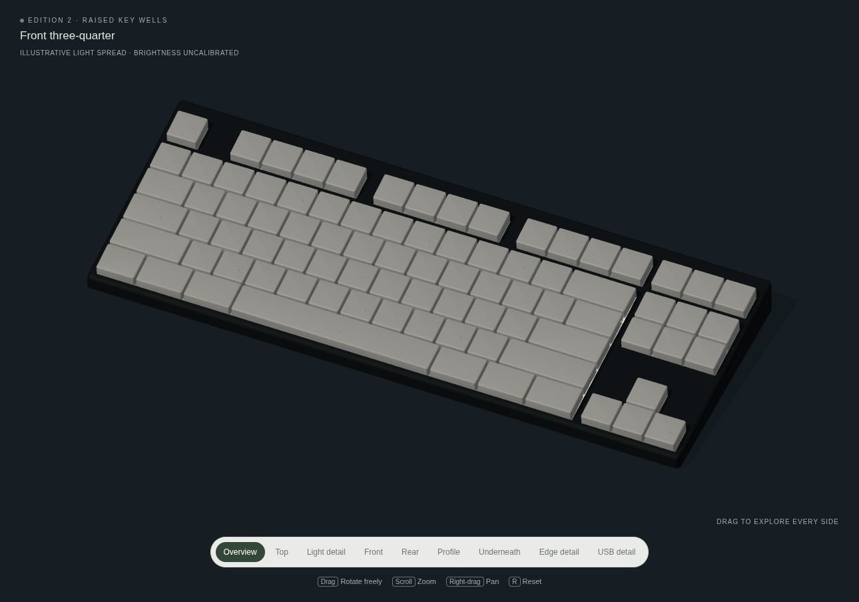
tkl/tkl10/render-acrylic-study/views/caps-flat-frosted.png
