davidkellis/keyboards/tkl/tkl10/render-acrylic-study/views/caps-xvx-wob-frosted.png

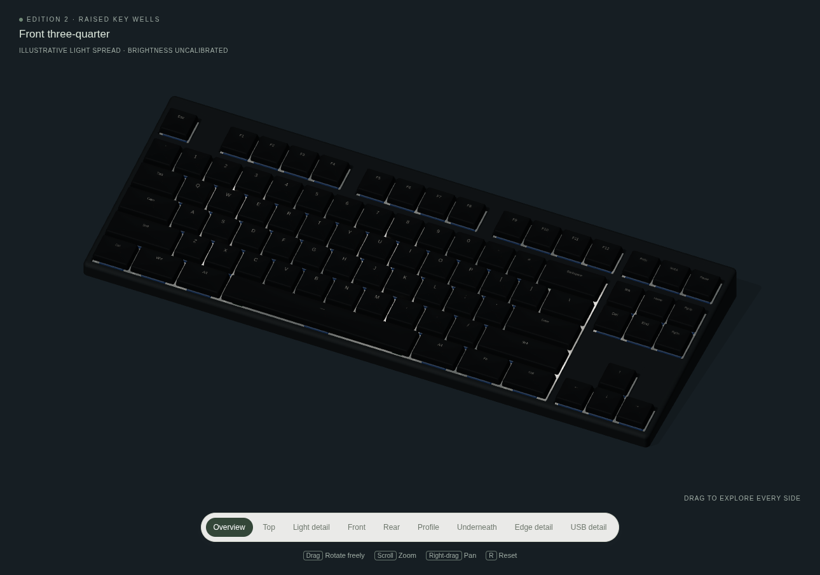
tkl/tkl10/render-acrylic-study/views/caps-xvx-wob-frosted.png
