davidkellis/keyboards/tkl/tkl10/render-acrylic-study/views/current-clear-top.png

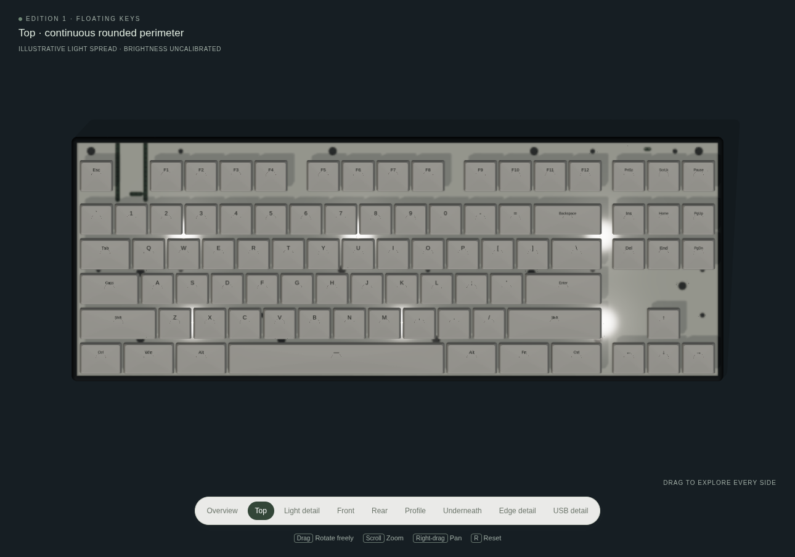
tkl/tkl10/render-acrylic-study/views/current-clear-top.png
