davidkellis/keyboards/tkl/tkl10/render-acrylic-study/views/current-etched-top.png

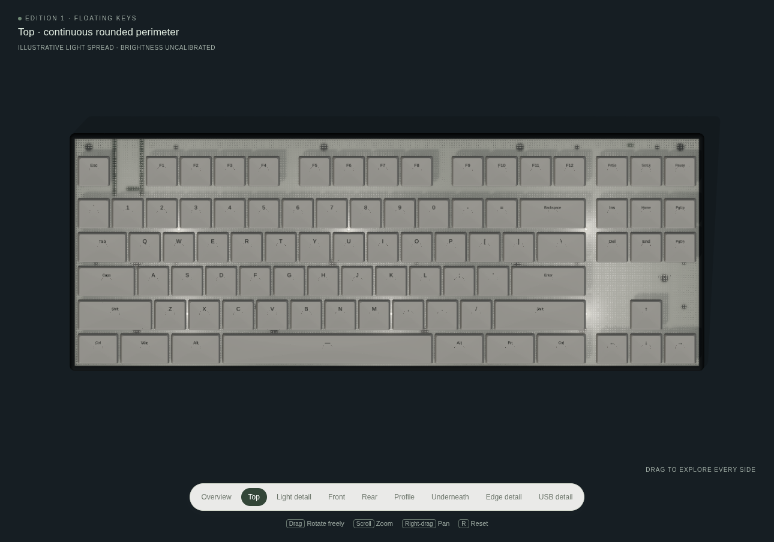
tkl/tkl10/render-acrylic-study/views/current-etched-top.png
