davidkellis/keyboards/tkl/tkl10/render-acrylic-study/views/current-original-top.png

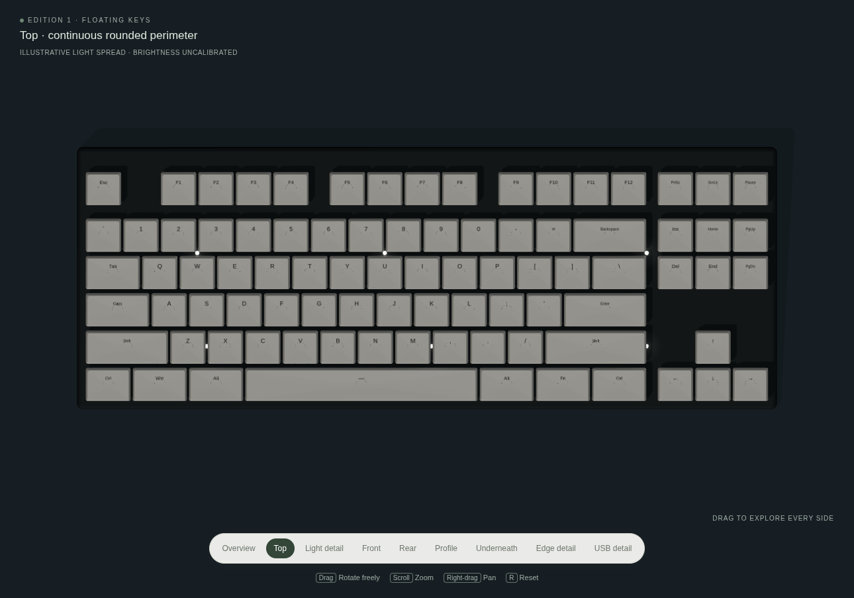
tkl/tkl10/render-acrylic-study/views/current-original-top.png
