davidkellis/keyboards/tkl/tkl10/render-acrylic-study/views/daylight-frosted-hero.png

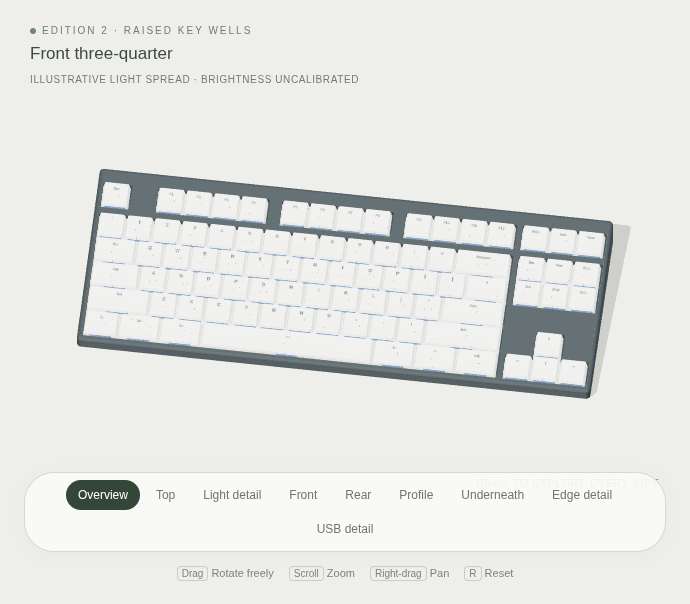
tkl/tkl10/render-acrylic-study/views/daylight-frosted-hero.png
