davidkellis/keyboards/tkl/tkl10/render-acrylic-study/views/etched-without-backing-top.png

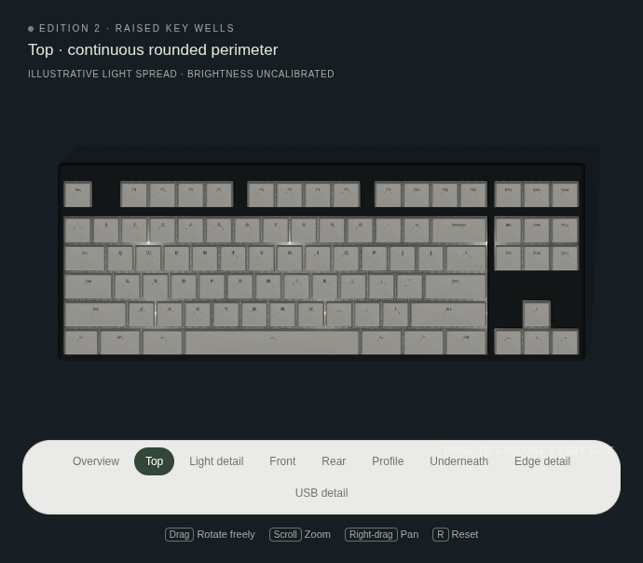
tkl/tkl10/render-acrylic-study/views/etched-without-backing-top.png
