davidkellis/keyboards/tkl/tkl10/render-acrylic-study/views/lights-off-top.png

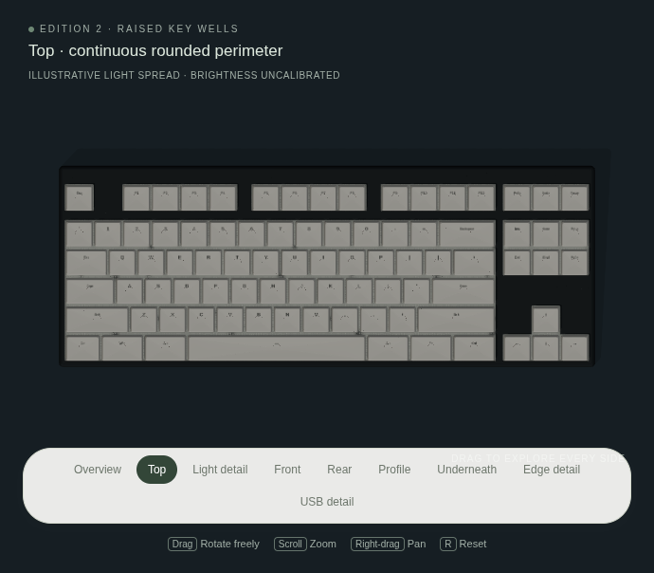
tkl/tkl10/render-acrylic-study/views/lights-off-top.png
