davidkellis/keyboards/tkl/tkl10/render-acrylic-study/views/raised-clear-detail.png

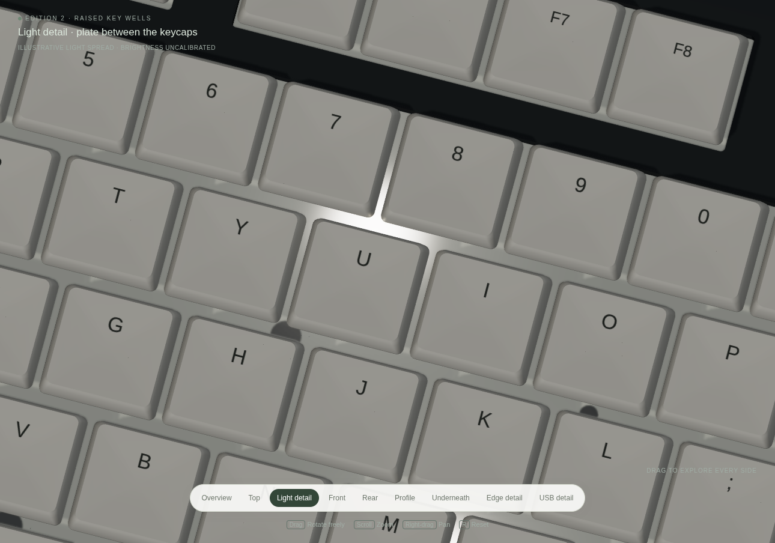
tkl/tkl10/render-acrylic-study/views/raised-clear-detail.png
