davidkellis/keyboards/tkl/tkl10/render-acrylic-study/views/raised-clear-plate.png

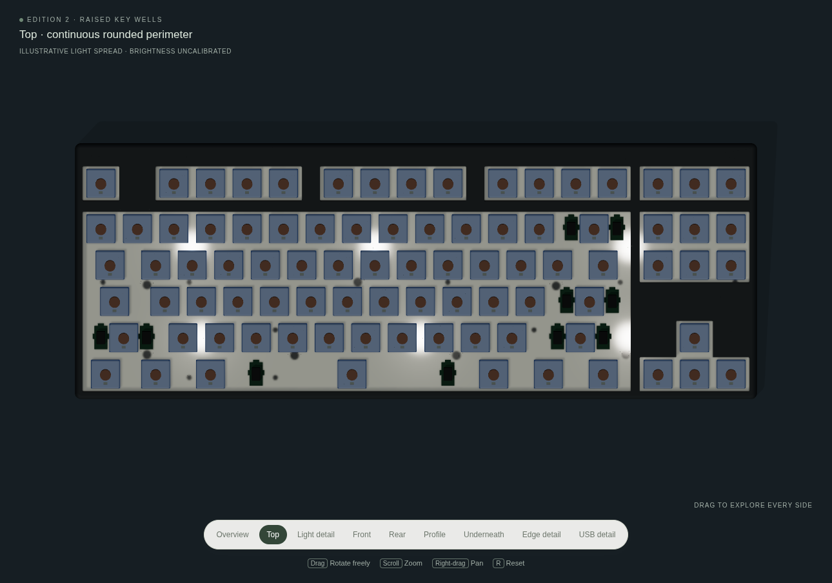
tkl/tkl10/render-acrylic-study/views/raised-clear-plate.png
