davidkellis/keyboards/tkl/tkl10/render-acrylic-study/views/raised-etched-detail.png

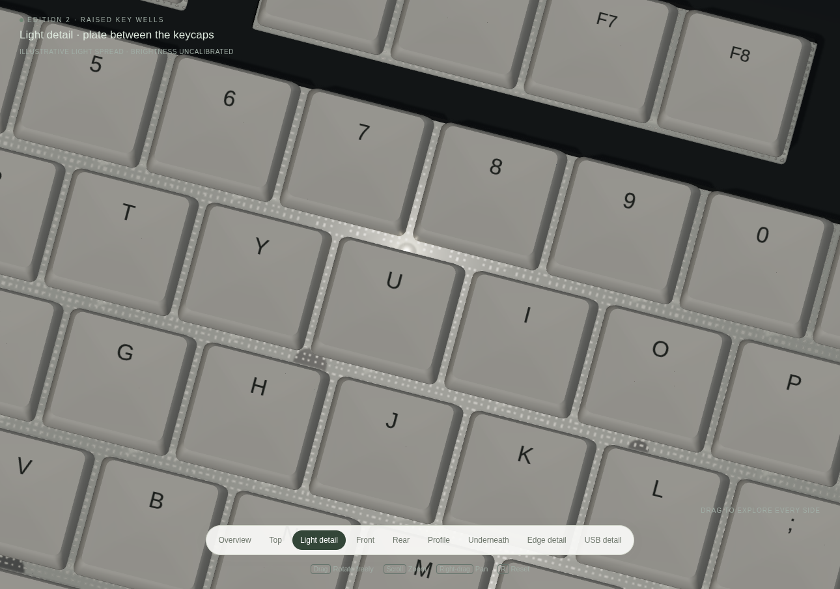
tkl/tkl10/render-acrylic-study/views/raised-etched-detail.png
