davidkellis/keyboards/tkl/tkl10/render-acrylic-study/views/raised-frosted-detail.png

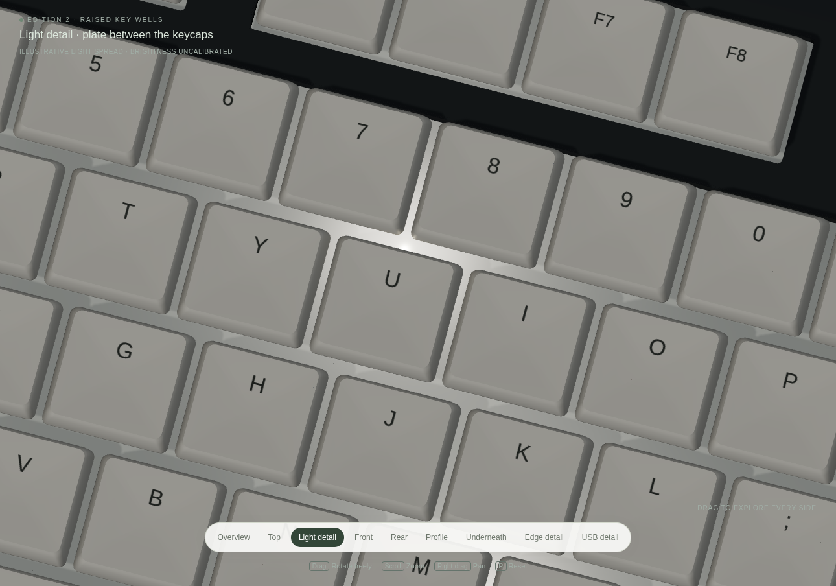
tkl/tkl10/render-acrylic-study/views/raised-frosted-detail.png
