davidkellis/keyboards/tkl/tkl10/render-acrylic-study/views/raised-original-detail.png

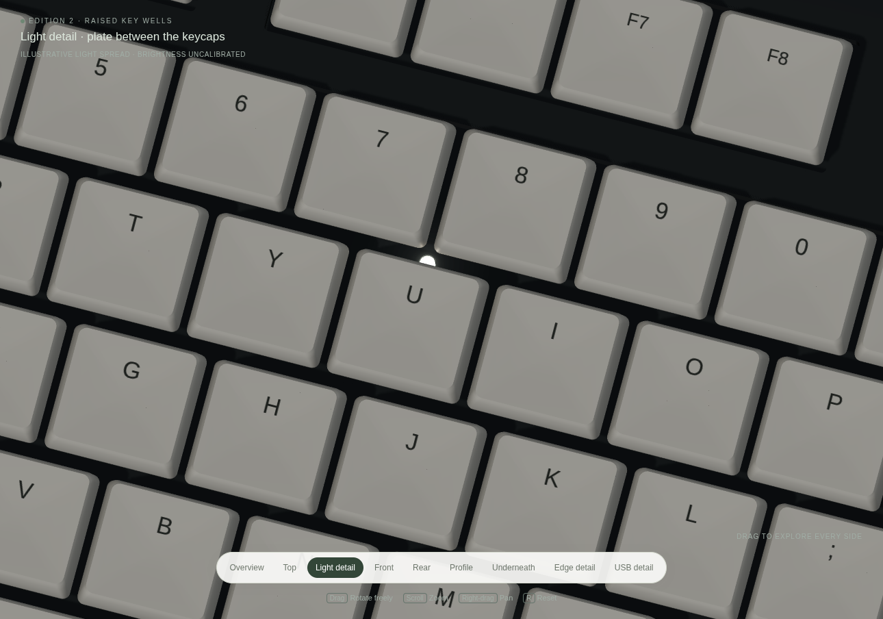
tkl/tkl10/render-acrylic-study/views/raised-original-detail.png
