davidkellis/keyboards/tkl/tkl10/render-acrylic-study/views/raised-original-plate.png

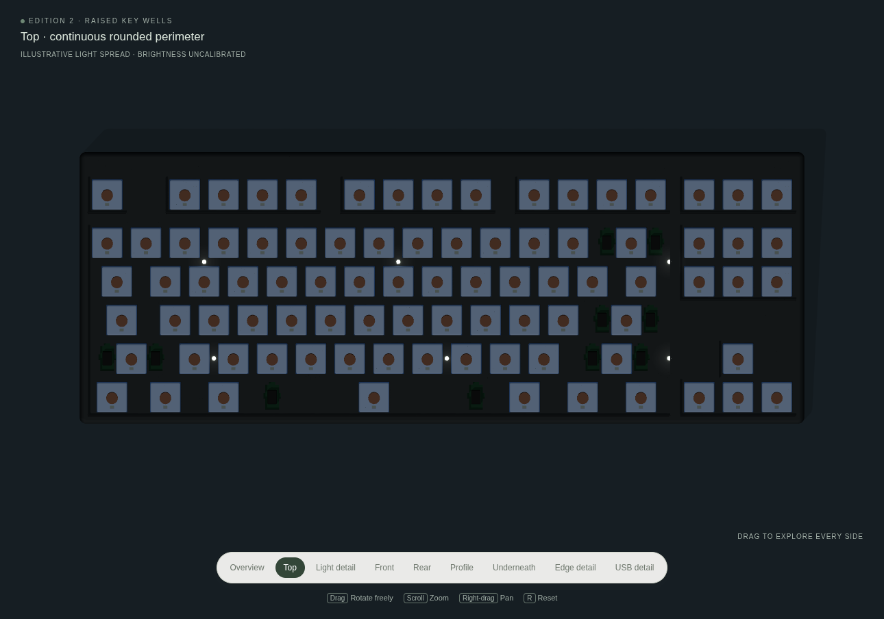
tkl/tkl10/render-acrylic-study/views/raised-original-plate.png
