davidkellis/keyboards/tkl/tkl10/render-case-editions/case-editions-comparison.png

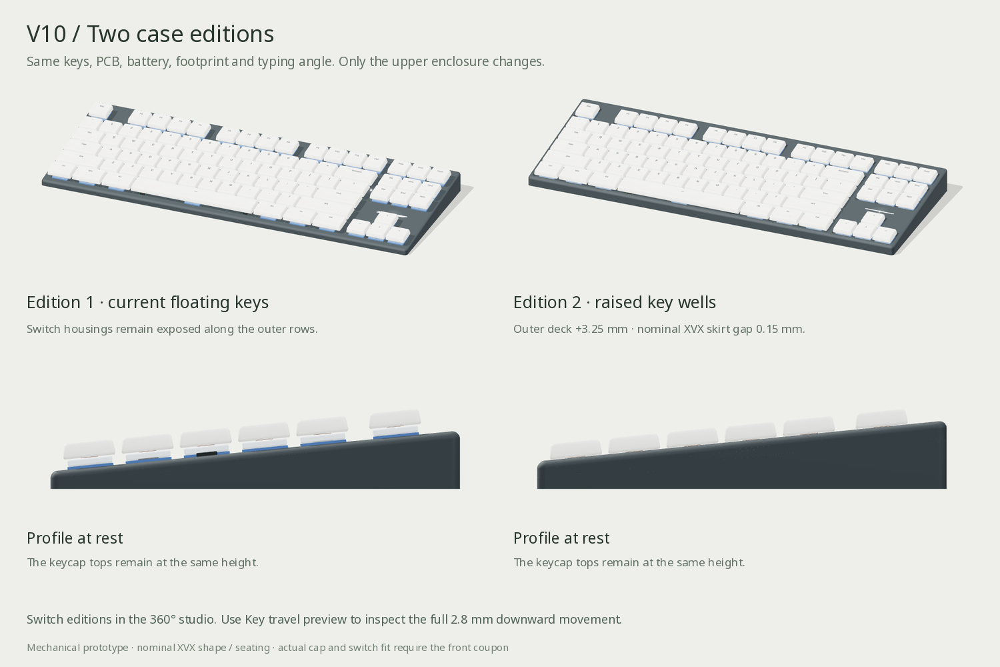
tkl/tkl10/render-case-editions/case-editions-comparison.png
