davidkellis/keyboards/tkl/tkl10/render-case-editions/mobile-preview.png

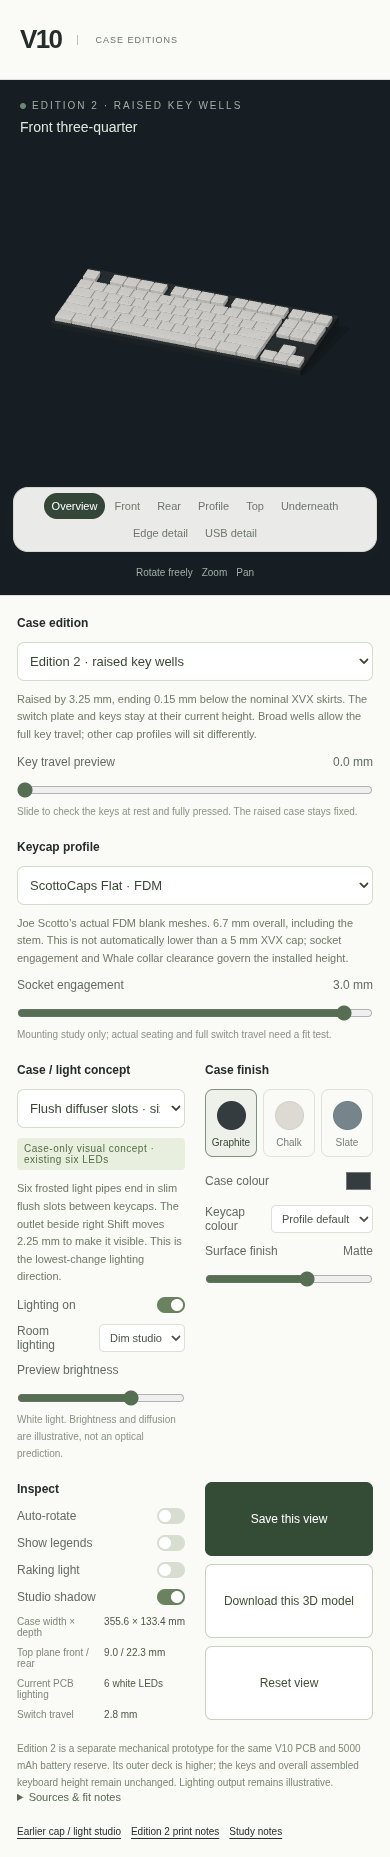
tkl/tkl10/render-case-editions/mobile-preview.png
