davidkellis/keyboards/tkl/tkl10/render-case-editions/studio-preview.png

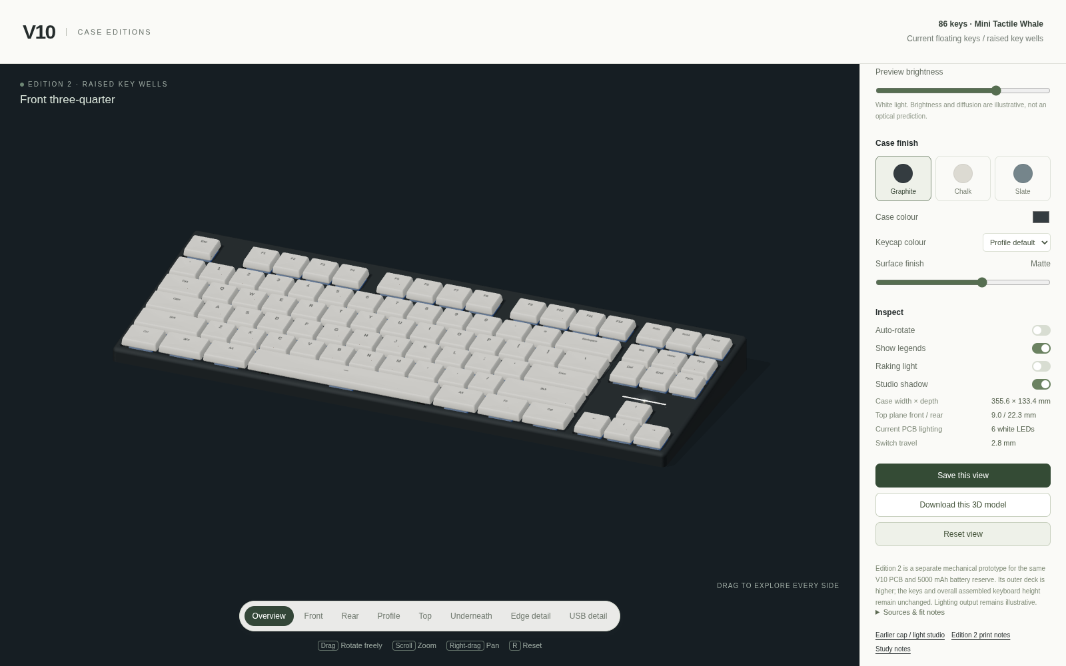
tkl/tkl10/render-case-editions/studio-preview.png
