davidkellis/keyboards/tkl/tkl10/render-case-editions/views/bottom.png

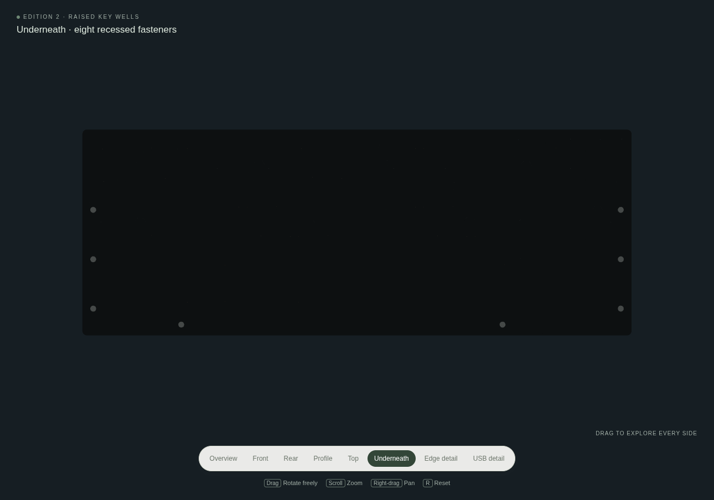
tkl/tkl10/render-case-editions/views/bottom.png
