davidkellis/keyboards/tkl/tkl10/render-case-editions/views/caps-flat-hero.png

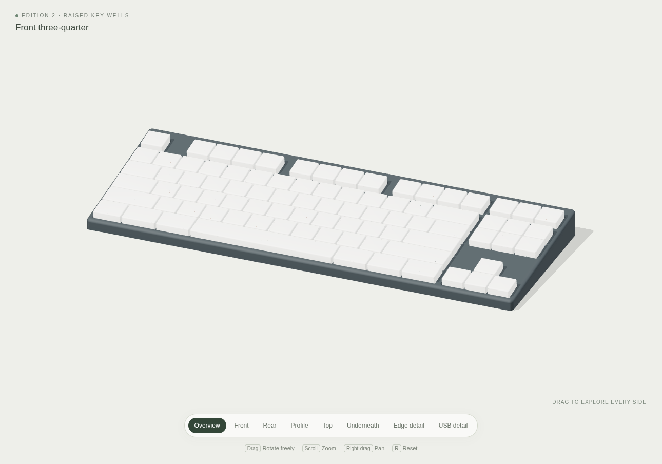
tkl/tkl10/render-case-editions/views/caps-flat-hero.png
