davidkellis/keyboards/tkl/tkl10/render-case-editions/views/caps-xvx-wob-hero.png

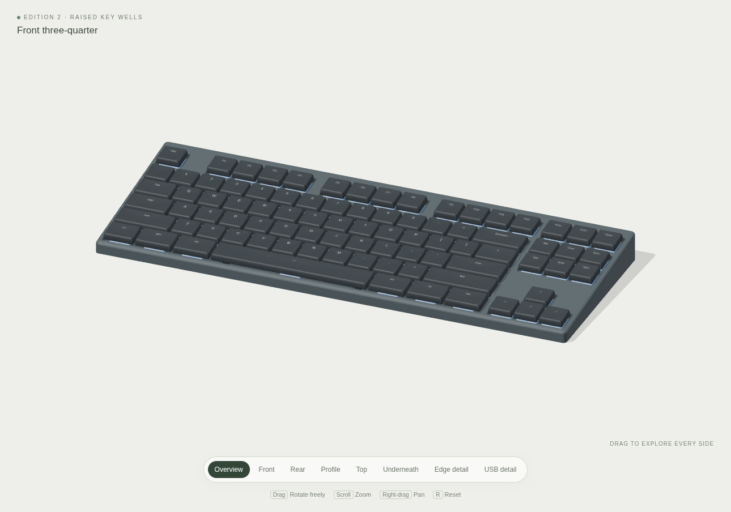
tkl/tkl10/render-case-editions/views/caps-xvx-wob-hero.png
