davidkellis/keyboards/tkl/tkl10/render-case-editions/views/current-edge.png

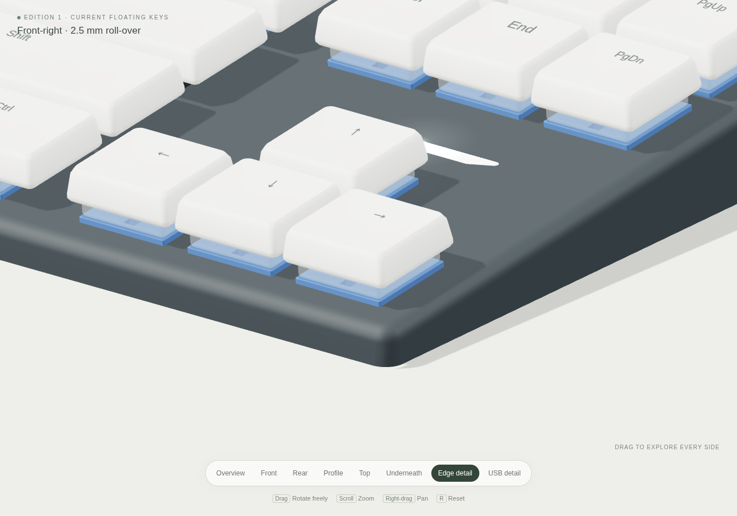
tkl/tkl10/render-case-editions/views/current-edge.png
