davidkellis/keyboards/tkl/tkl10/render-case-editions/views/current-front.png

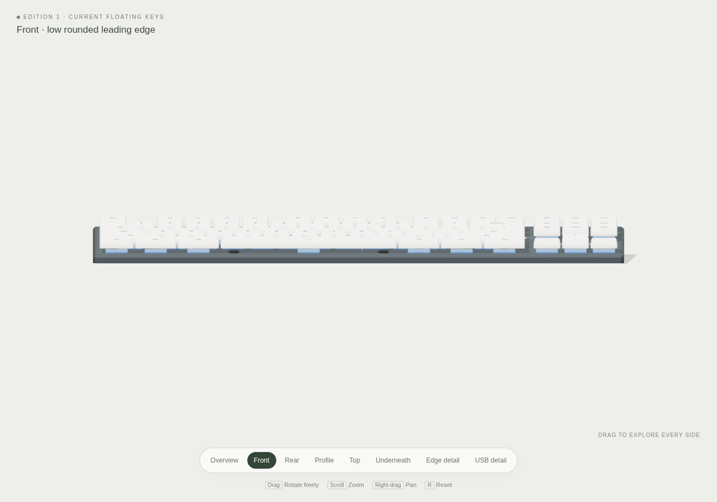
tkl/tkl10/render-case-editions/views/current-front.png
