davidkellis/keyboards/tkl/tkl10/render-case-editions/views/edge.png

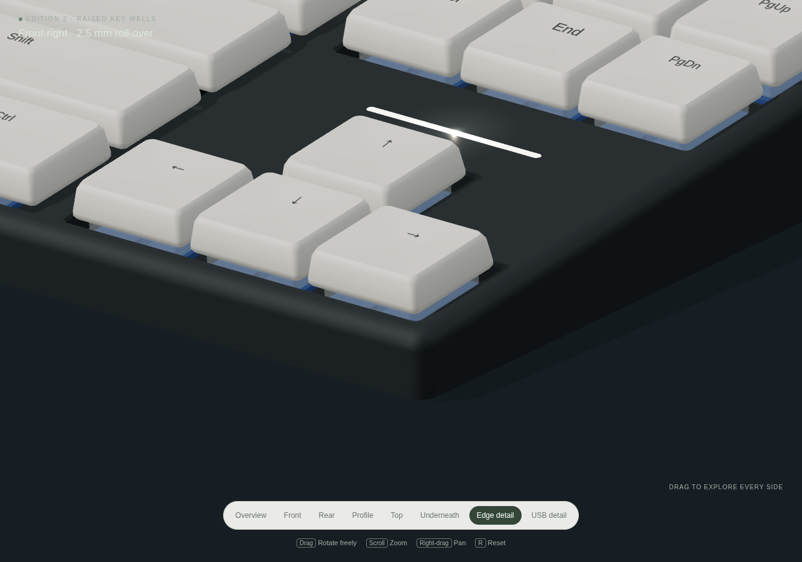
tkl/tkl10/render-case-editions/views/edge.png
