davidkellis/keyboards/tkl/tkl10/render-case-editions/views/front.png

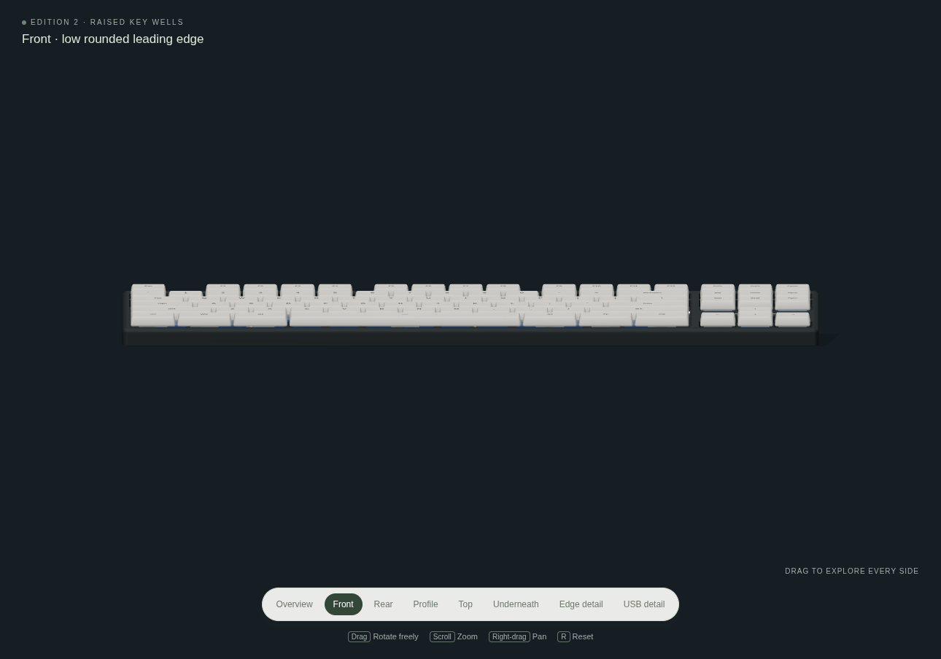
tkl/tkl10/render-case-editions/views/front.png
