davidkellis/keyboards/tkl/tkl10/render-case-editions/views/hero.png

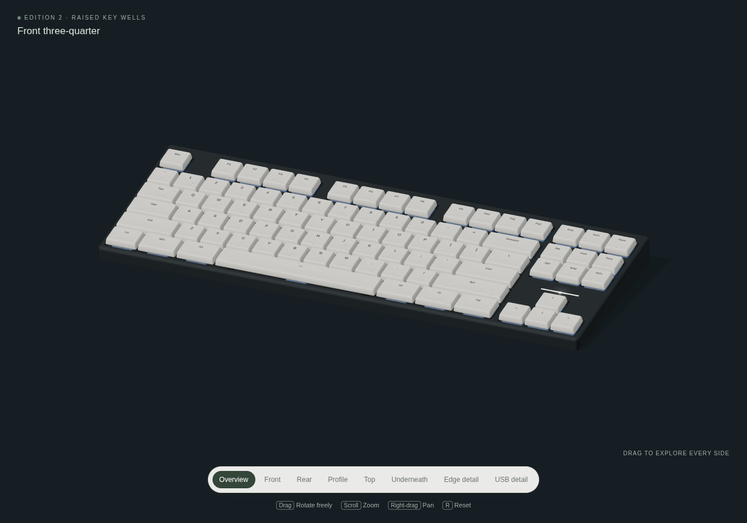
tkl/tkl10/render-case-editions/views/hero.png
