davidkellis/keyboards/tkl/tkl10/render-case-editions/views/lighting-deck.png

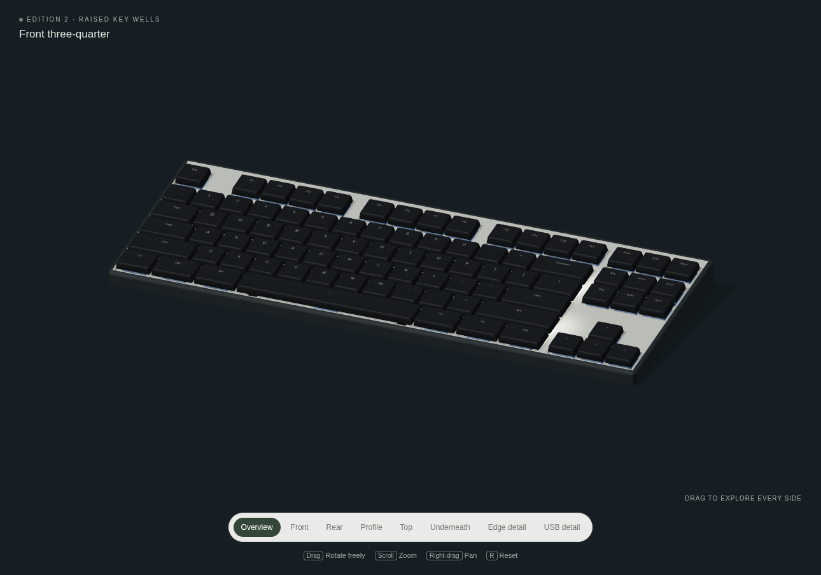
tkl/tkl10/render-case-editions/views/lighting-deck.png
