davidkellis/keyboards/tkl/tkl10/render-case-editions/views/lighting-halo.png

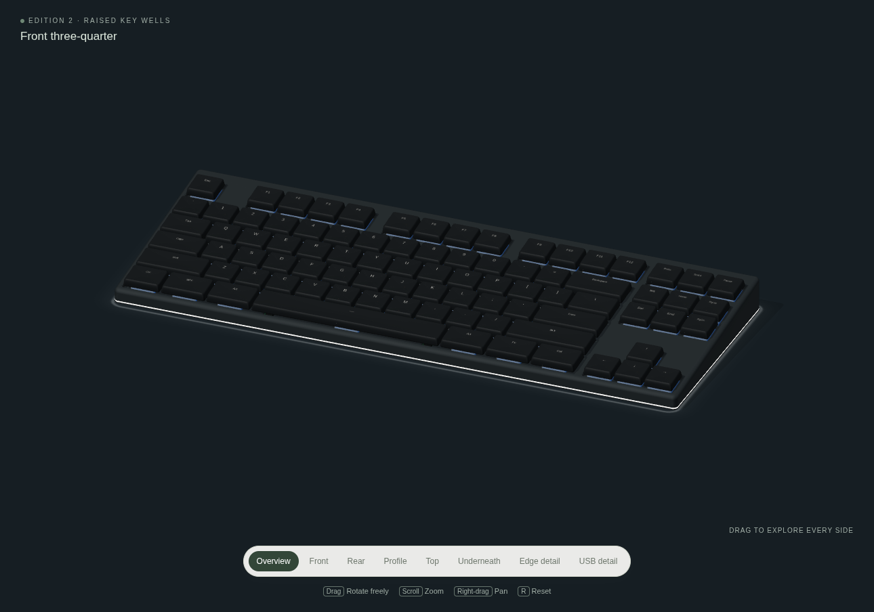
tkl/tkl10/render-case-editions/views/lighting-halo.png
