davidkellis/keyboards/tkl/tkl10/render-case-editions/views/rear.png

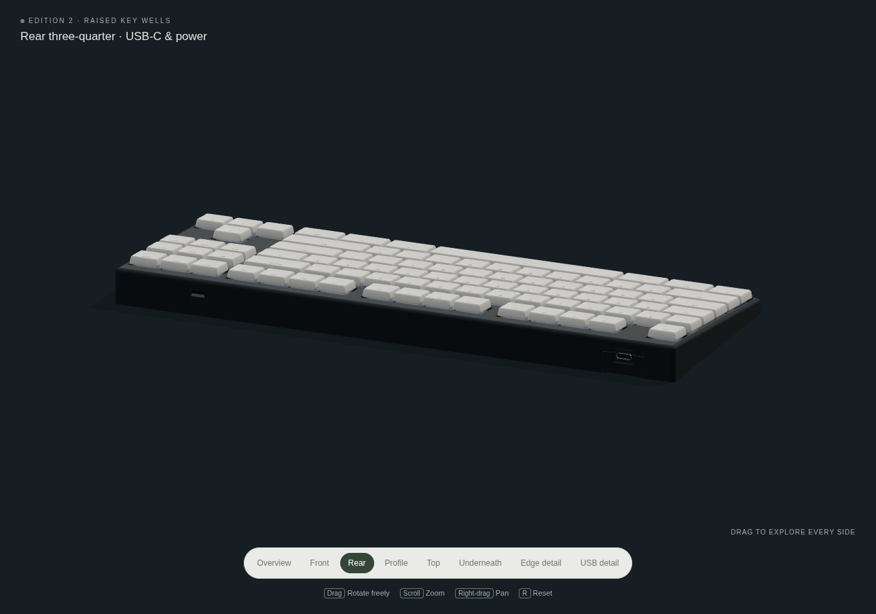
tkl/tkl10/render-case-editions/views/rear.png
