davidkellis/keyboards/tkl/tkl10/render-case-editions/views/side.png

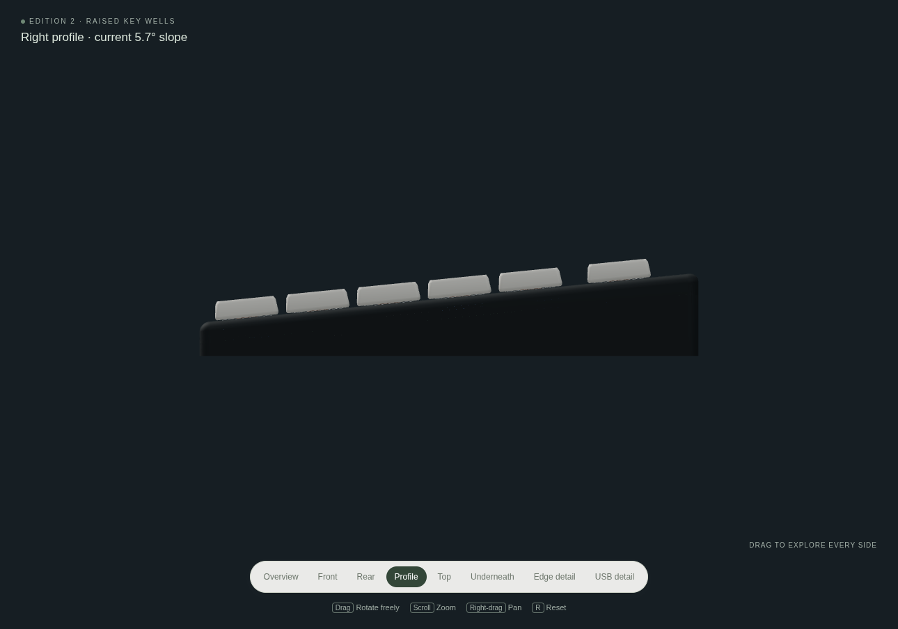
tkl/tkl10/render-case-editions/views/side.png
