davidkellis/keyboards/tkl/tkl10/render-case-editions/views/usb.png

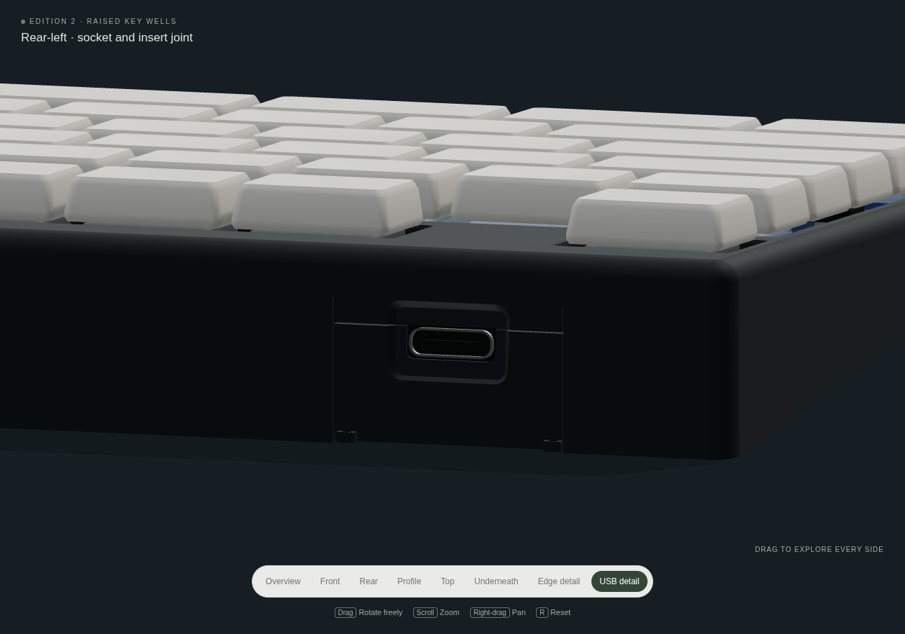
tkl/tkl10/render-case-editions/views/usb.png
