davidkellis/keyboards/tkl/tkl10/render-keycaps-lighting/keycap-comparison.png

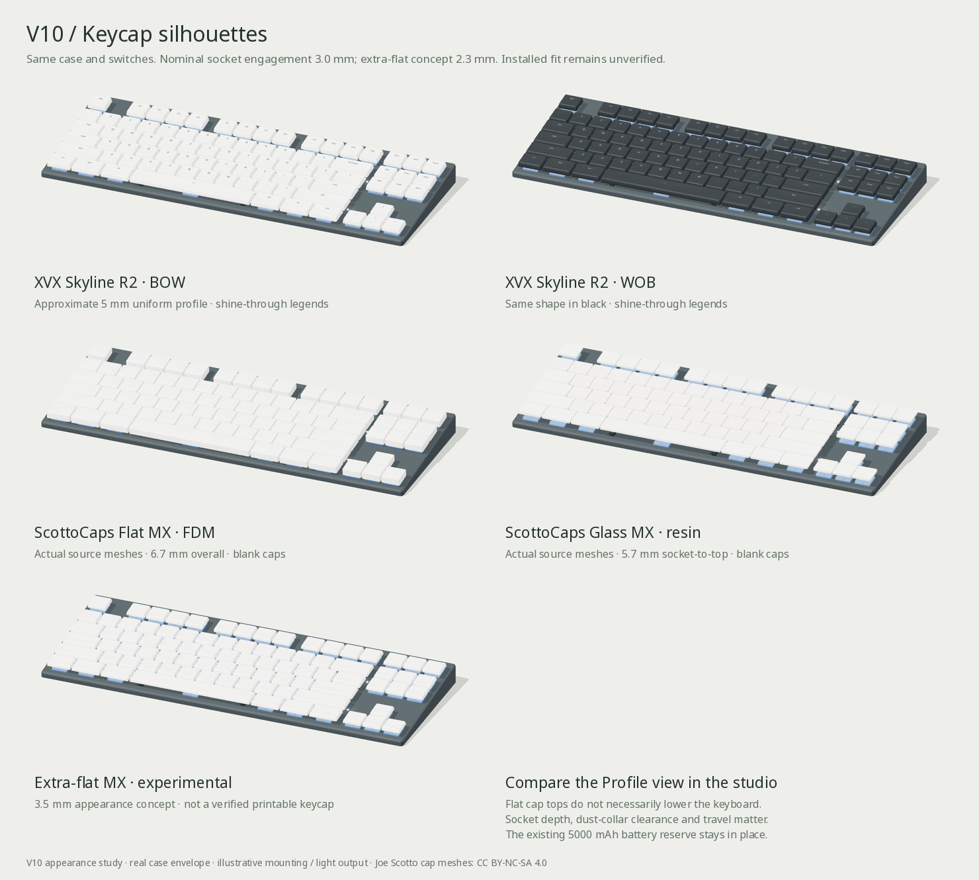
tkl/tkl10/render-keycaps-lighting/keycap-comparison.png
