davidkellis/keyboards/tkl/tkl10/render-keycaps-lighting/lighting-comparison.png

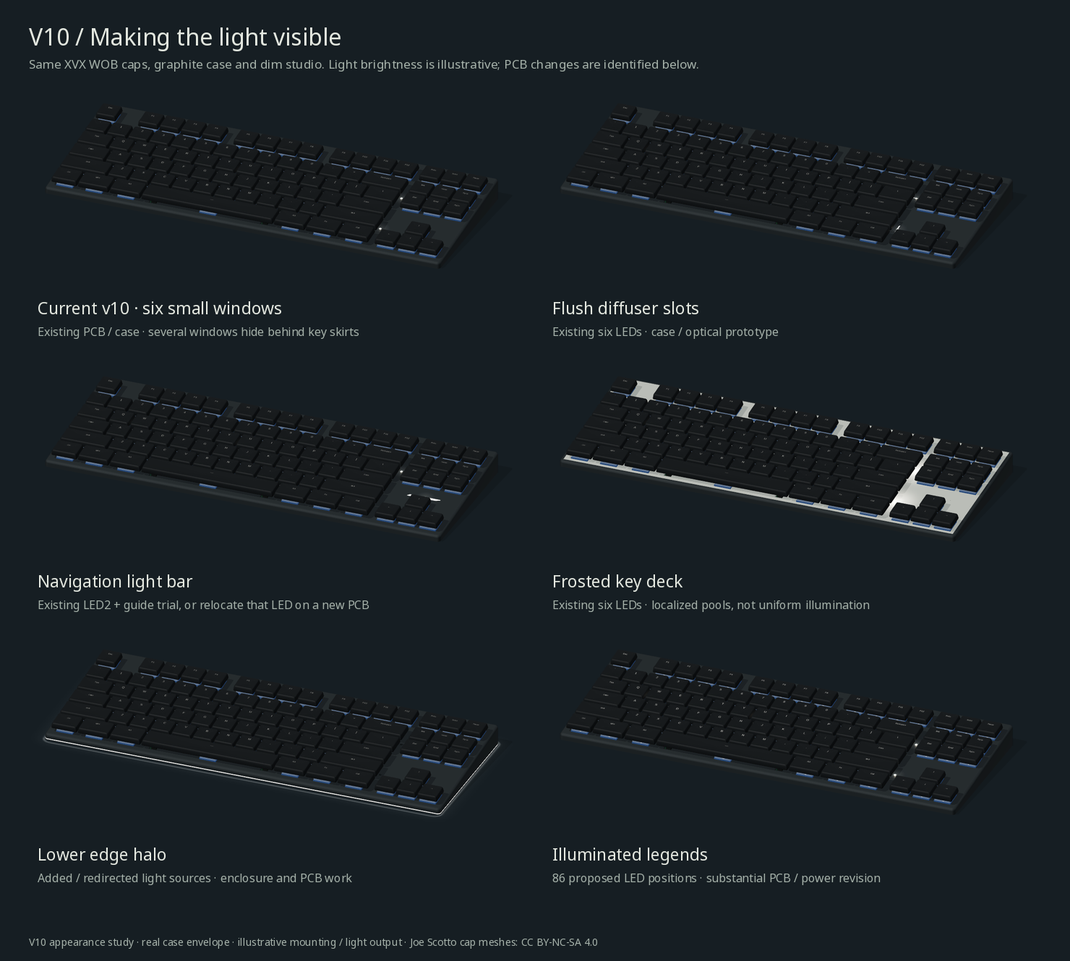
tkl/tkl10/render-keycaps-lighting/lighting-comparison.png
