davidkellis/keyboards/tkl/tkl10/render-keycaps-lighting/mobile-preview.png

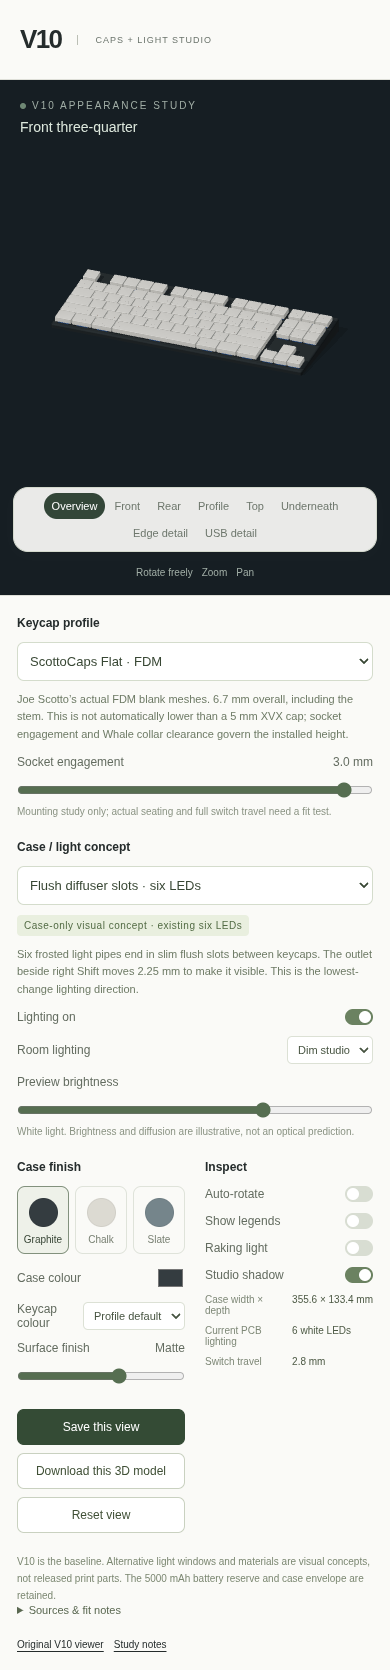
tkl/tkl10/render-keycaps-lighting/mobile-preview.png
