davidkellis/keyboards/tkl/tkl10/render-keycaps-lighting/views/edge.png

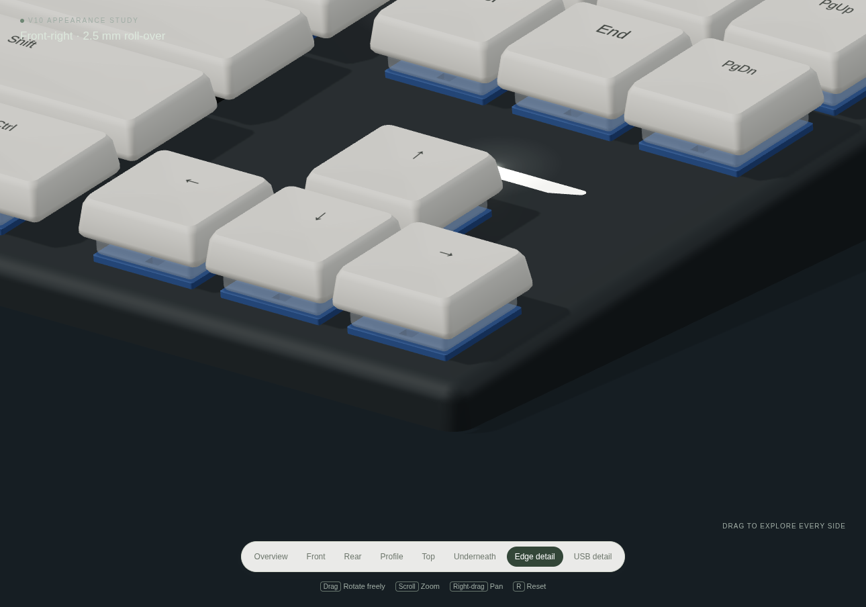
tkl/tkl10/render-keycaps-lighting/views/edge.png
