davidkellis/keyboards/tkl/tkl11/case/led1-placement.png

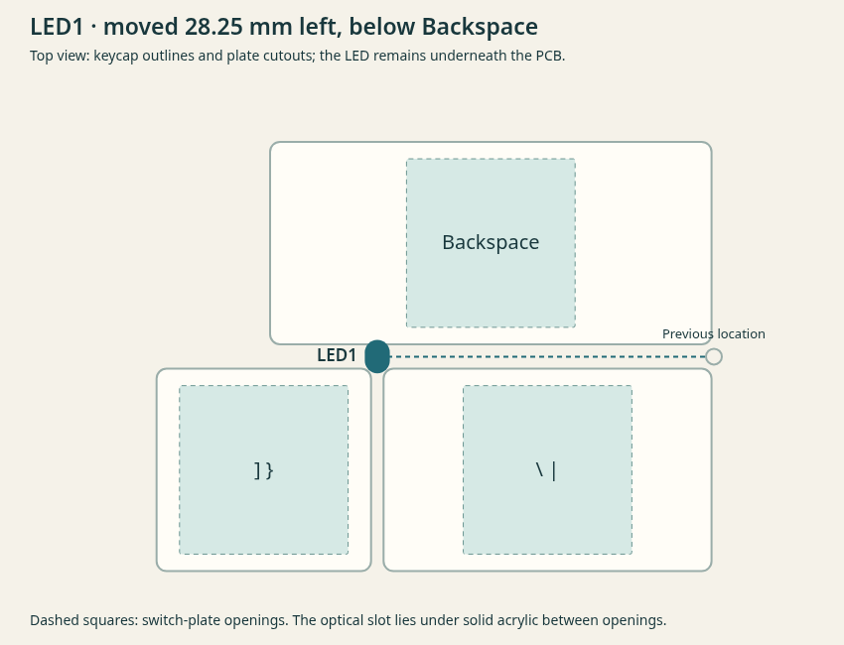
tkl/tkl11/case/led1-placement.png
