davidkellis/keyboards/tkl/tkl11/case/lighting-layout.png

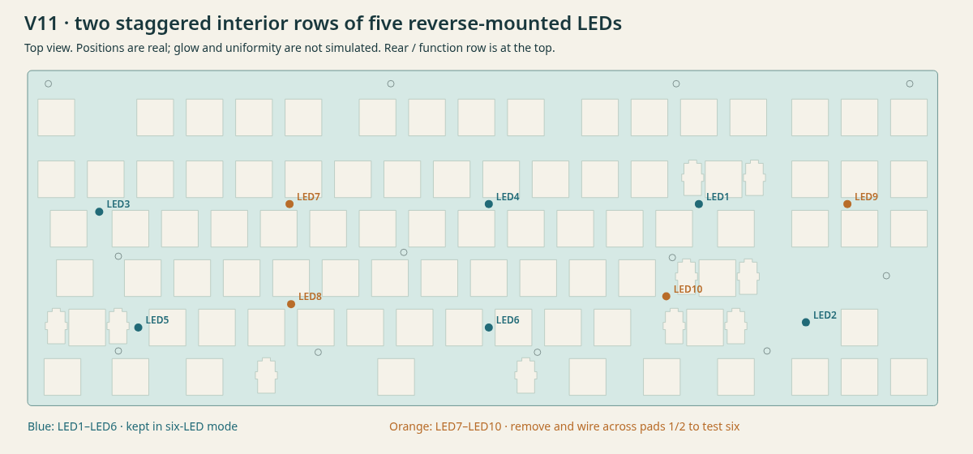
tkl/tkl11/case/lighting-layout.png
