davidkellis/keyboards/tkl/tkl11/case/v11-overview.png

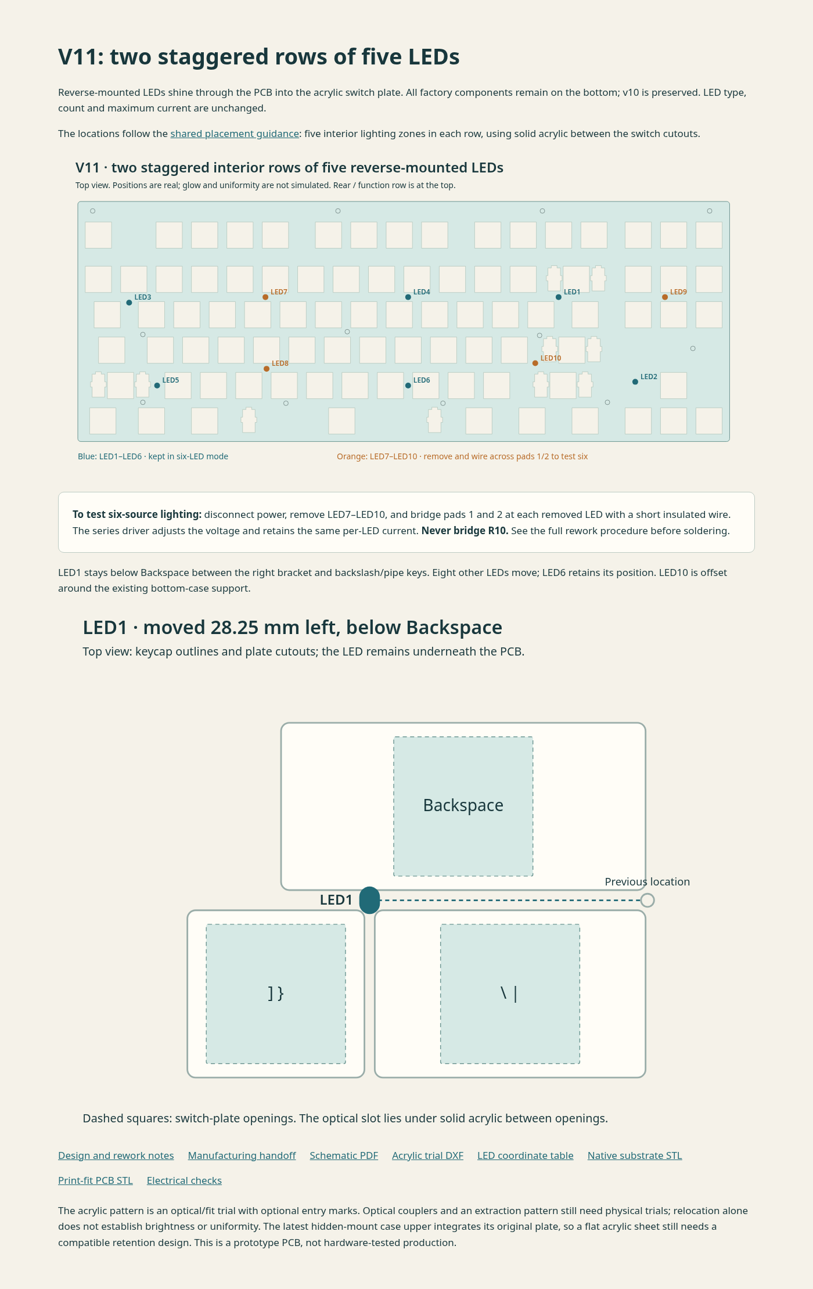
tkl/tkl11/case/v11-overview.png
