davidkellis/keyboards/tkl/tkl11/reference/switch-compatibility-study-2026-10-16/detailed-dimensions/footprint-comparison.png

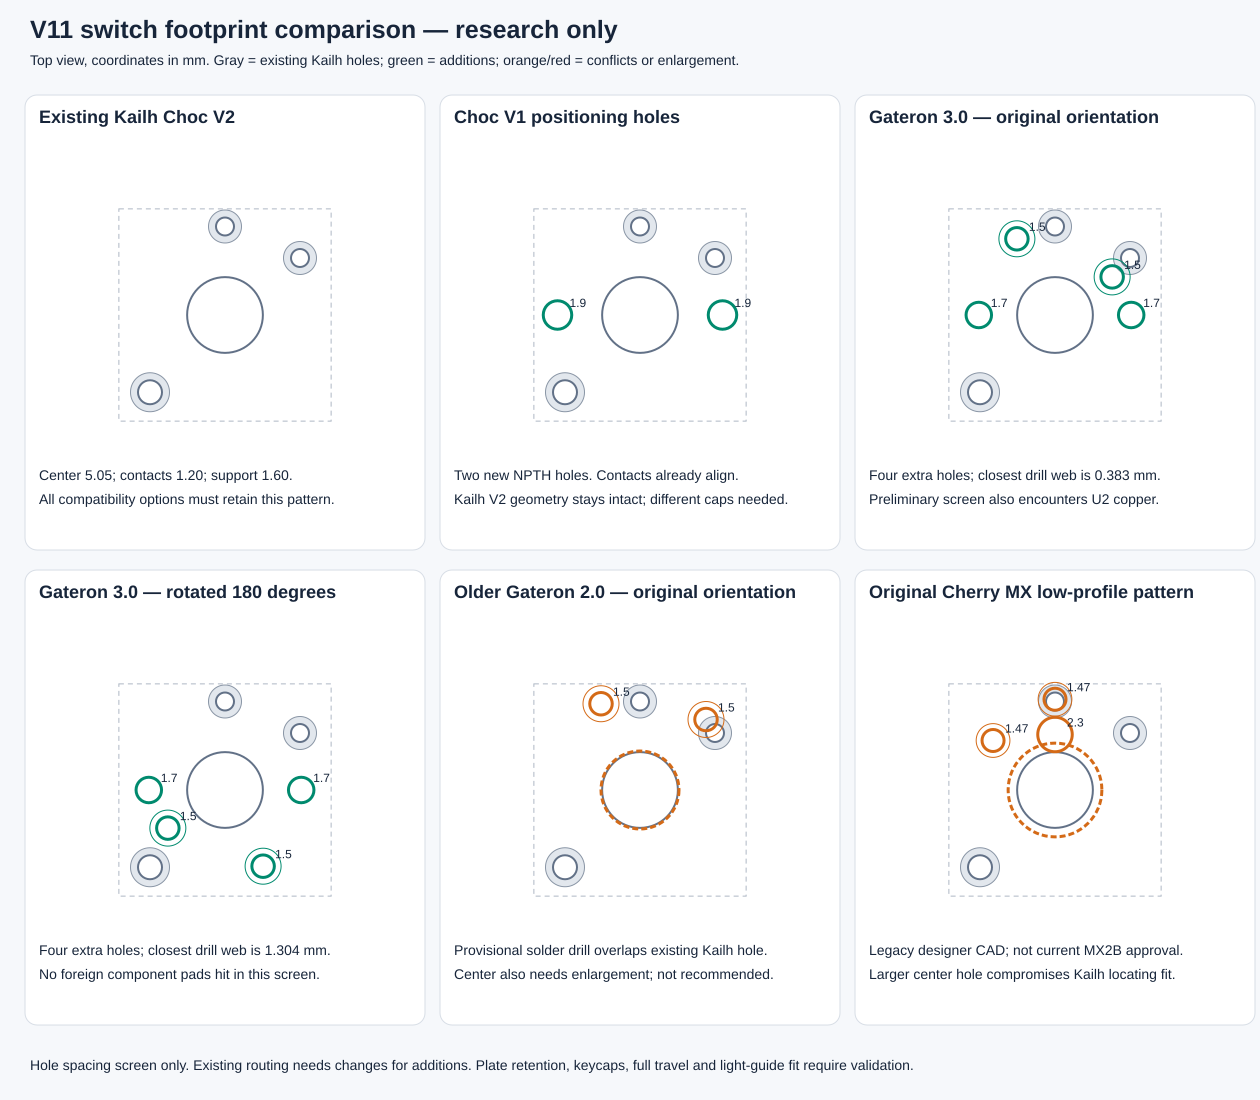
tkl/tkl11/reference/switch-compatibility-study-2026-10-16/detailed-dimensions/footprint-comparison.png
