davidkellis/keyboards/tkl/tkl12/back.png

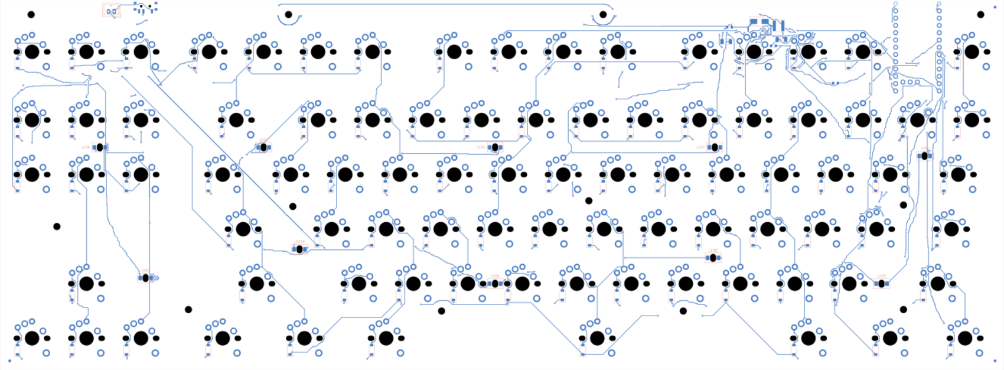
tkl/tkl12/back.png
