davidkellis/keyboards/tkl/tkl12/front.png

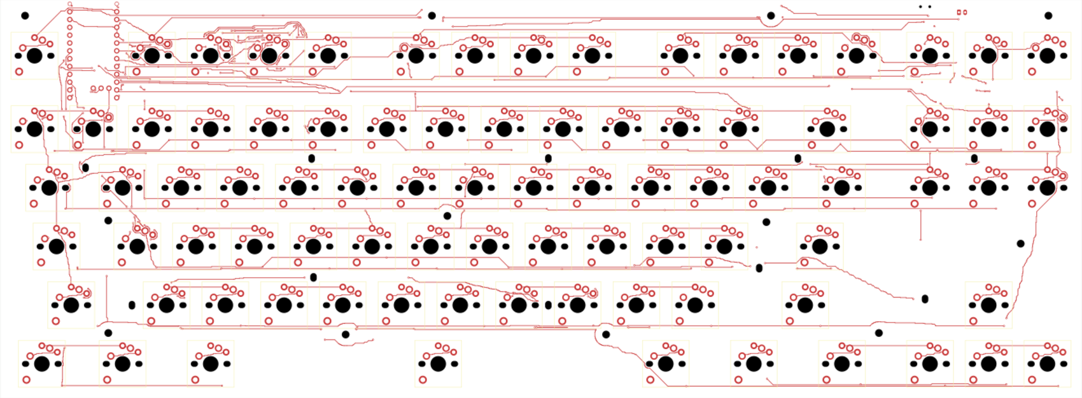
tkl/tkl12/front.png
