davidkellis/keyboards/tkl/tkl12/reference/switch-pattern.png

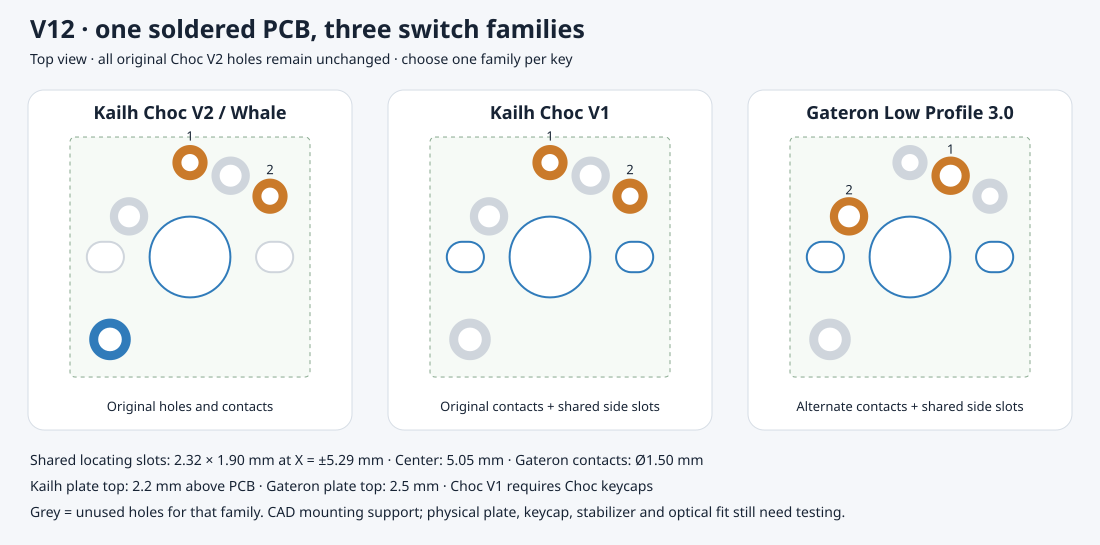
tkl/tkl12/reference/switch-pattern.png
