davidkellis/keyboards/tkl/tkl12/render-switches/views/chalk-two-tone.png

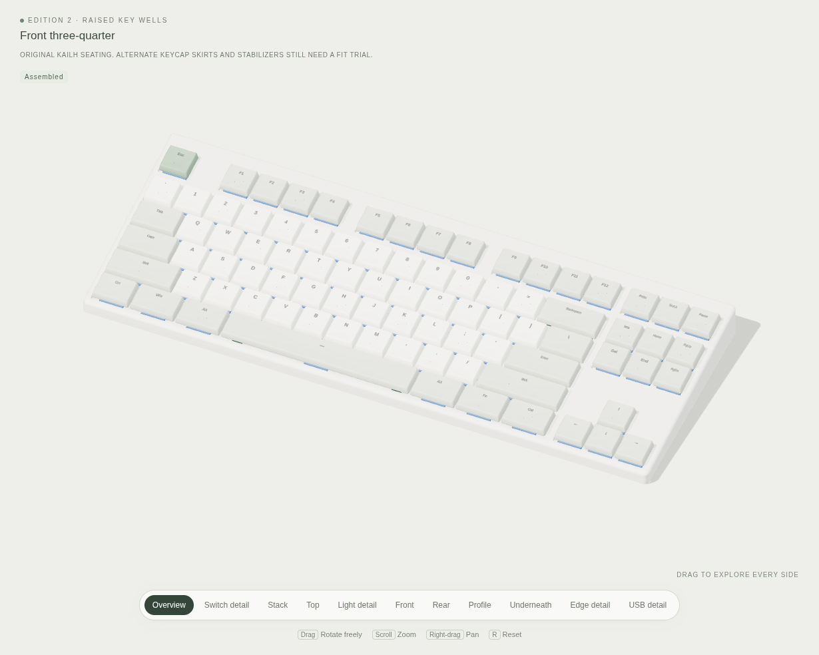
tkl/tkl12/render-switches/views/chalk-two-tone.png
