davidkellis/keyboards/tkl/tkl12/render-switches/views/choc-v1-cfx-white.png

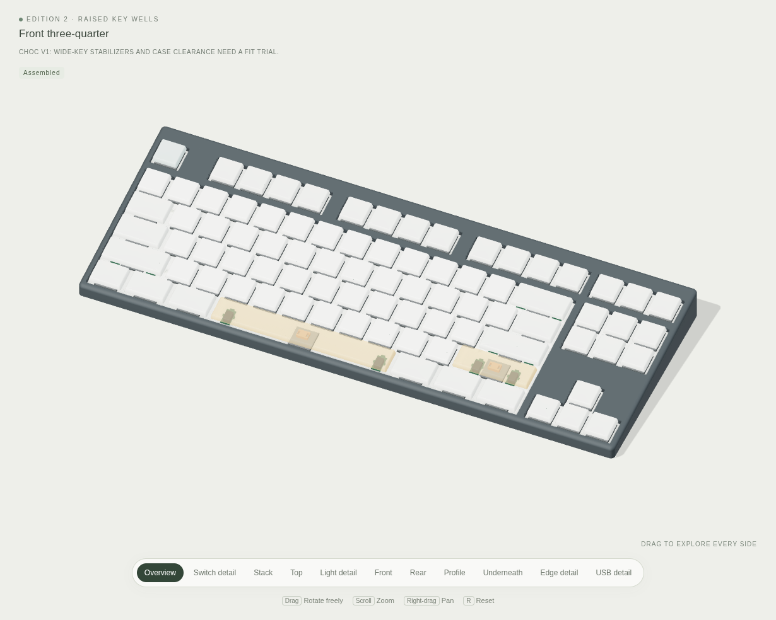
tkl/tkl12/render-switches/views/choc-v1-cfx-white.png
