davidkellis/keyboards/tkl/tkl12/render-switches/views/choc-v1-stems.png

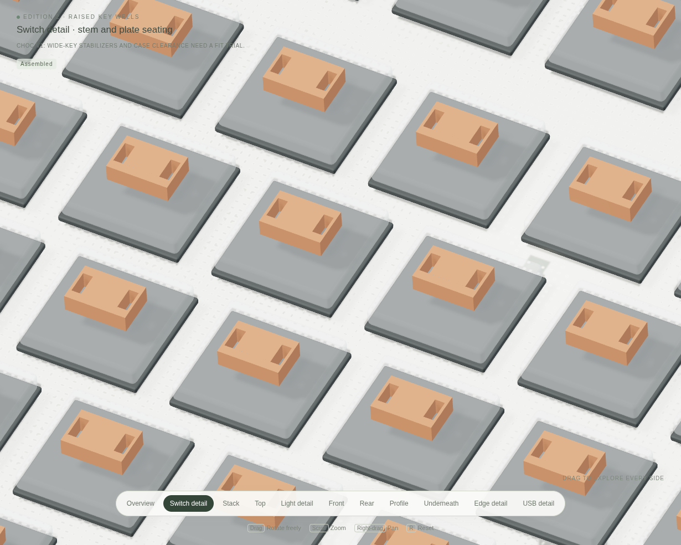
tkl/tkl12/render-switches/views/choc-v1-stems.png
