davidkellis/keyboards/tkl/tkl12/render-switches/views/choc-v2-flat.png

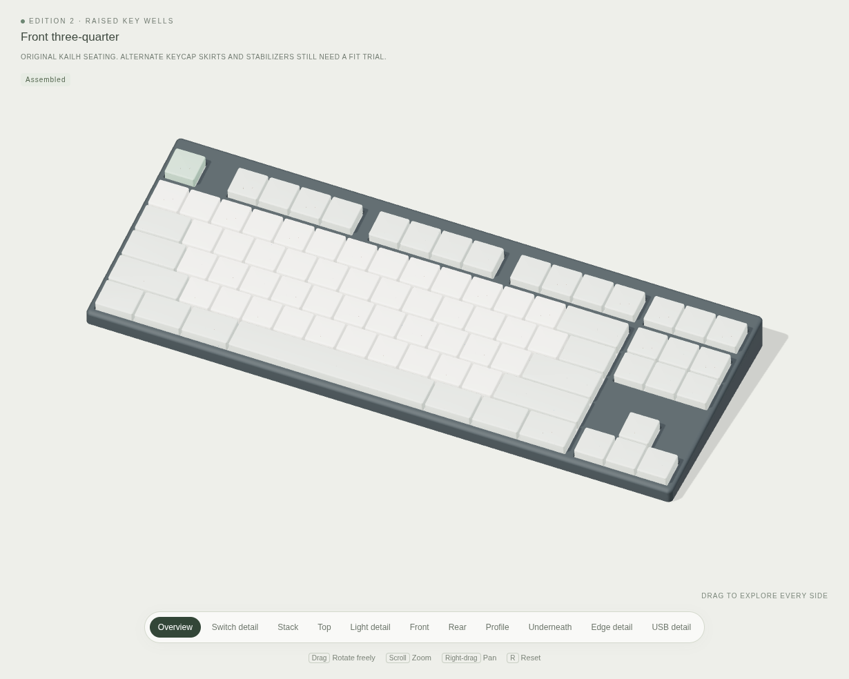
tkl/tkl12/render-switches/views/choc-v2-flat.png
