davidkellis/keyboards/tkl/tkl12/render-switches/views/choc-v2-nsa-coast.png

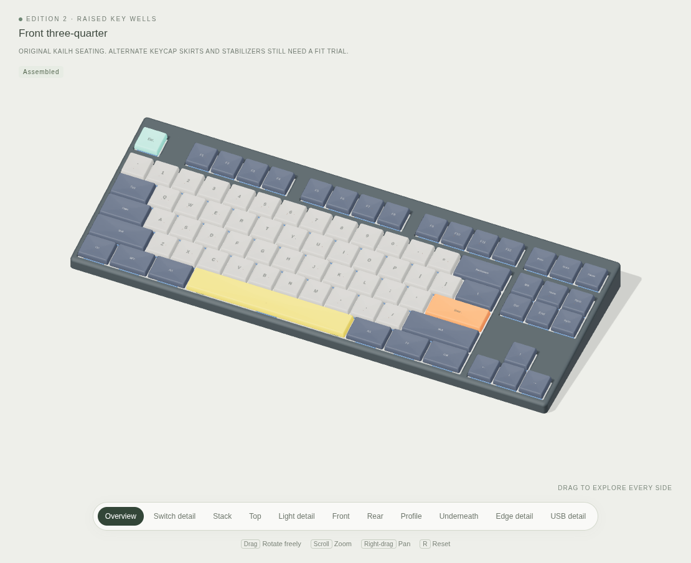
tkl/tkl12/render-switches/views/choc-v2-nsa-coast.png
