davidkellis/keyboards/tkl/tkl12/render-switches/views/choc-v2-xvx-wob.png

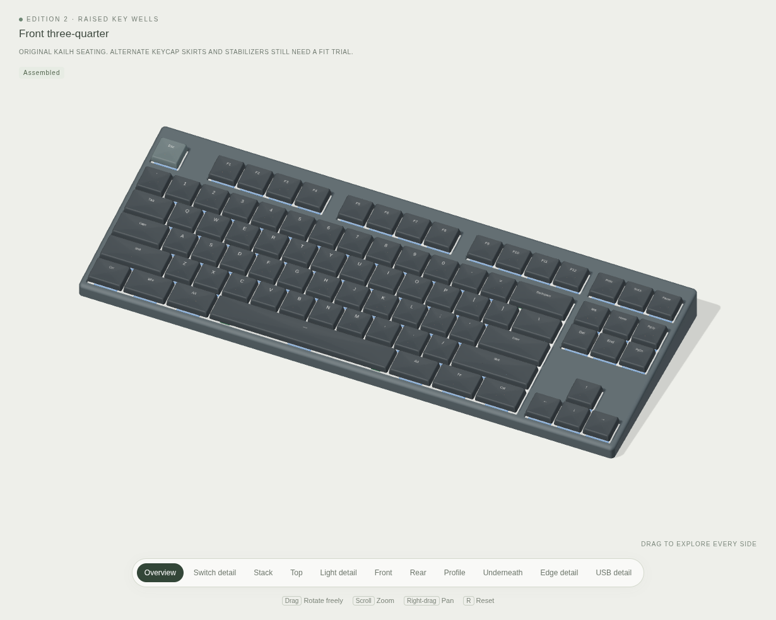
tkl/tkl12/render-switches/views/choc-v2-xvx-wob.png
