davidkellis/keyboards/tkl/tkl12/render-switches/views/dim-acrylic.png

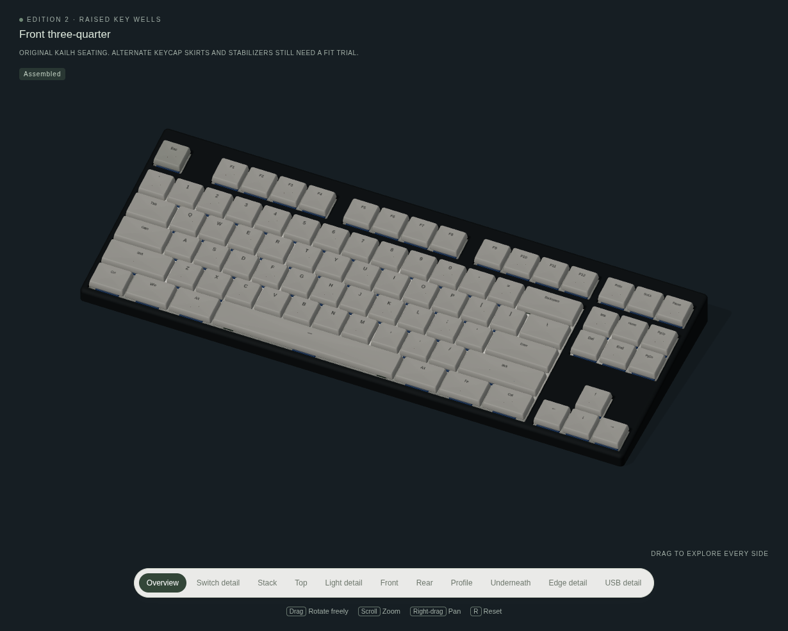
tkl/tkl12/render-switches/views/dim-acrylic.png
