davidkellis/keyboards/tkl/tkl12/render-switches/views/exploded.png

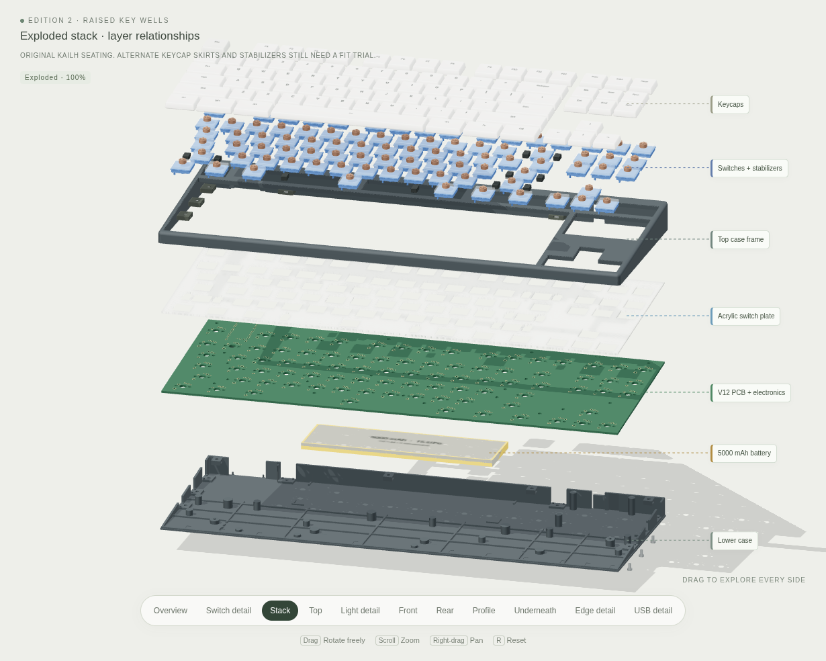
tkl/tkl12/render-switches/views/exploded.png
