davidkellis/keyboards/tkl/tkl12/render-switches/views/gateron-heron-stems.png

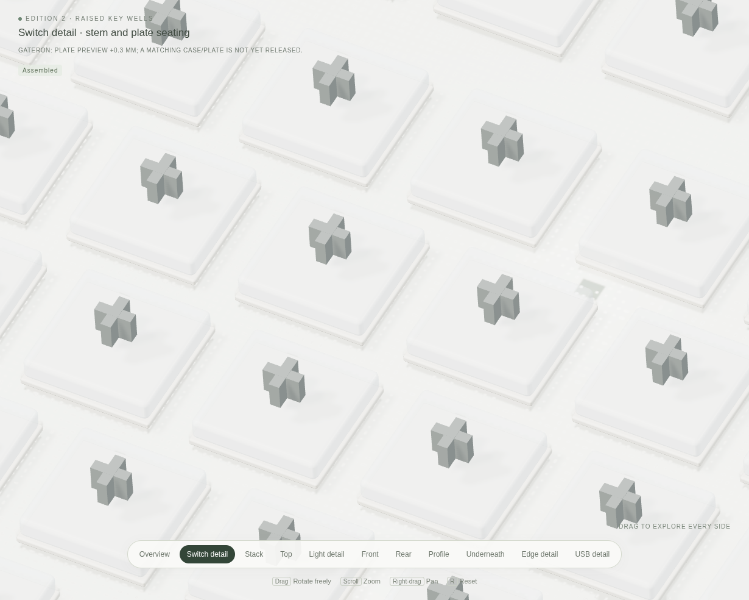
tkl/tkl12/render-switches/views/gateron-heron-stems.png
