davidkellis/keyboards/tkl/tkl12/render-switches/views/gateron-silver-stems.png

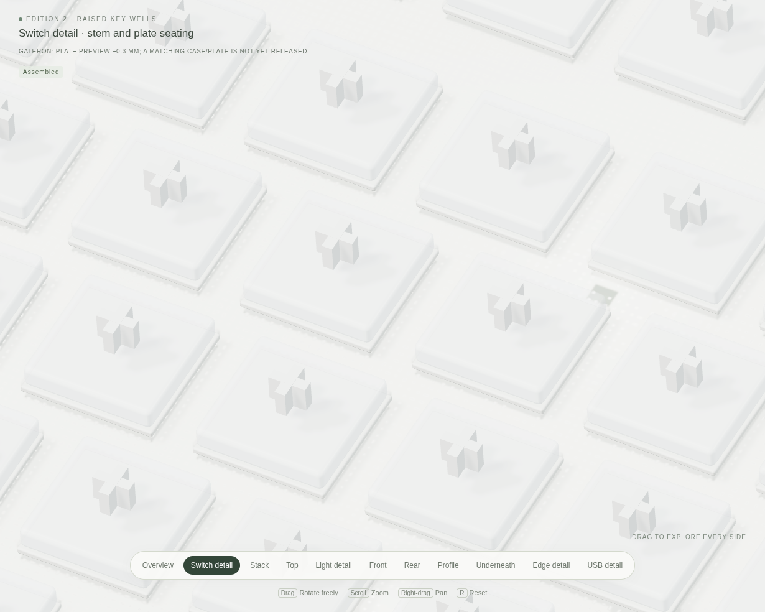
tkl/tkl12/render-switches/views/gateron-silver-stems.png
