davidkellis/keyboards/tkl/tkl12/render-switches/views/mobile.png

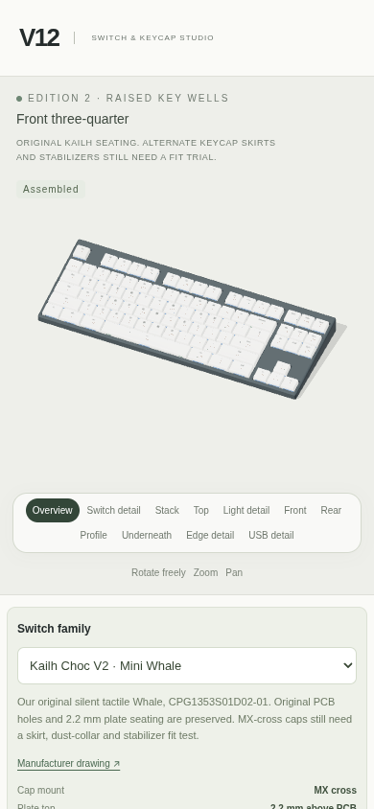
tkl/tkl12/render-switches/views/mobile.png
