davidkellis/keyboards/tkl/tkl7/manufacturing/quote-2026-09-25/economic-bom-screen.txt

24
SMT

Holiday Notice: JLCPCB factories will be closed on Sep. 25, Sep. 27 & Oct. 1–4. Please order 3–5 days early to prevent delays. Learn more>

24-hour PCB production. Fast Delivery to United States.
 Coupons
 Download APP
USD 
JLCPCB
Products
Capabilities
Support 
About Us 
1
Order Now
My Account 
tkl-v7.1-gerbers 
Automatically saved, last updated on 25 September, 13:49
PCB
Bill of Materials
Component Placements
Quote & Order
Bottom Side
Total  
31
  parts detected
 
31
  Parts confirmed
Complete File
 Upload BOM/CPL
Uploaded BOM Data	Review Matched Parts	
Bottom Designator	Comment	Footprint	Matched Part Detail	Qty	Source	Lib Type	Total Cost	
 Select 
	
C1,C2,C17,C18
	
GRM1555C1H120GA01D
	
0402
	
GRM1555C1H120GA01D
C161527
12pF 50V C0G ±2% 0402 Multilayer Ceramic Capacitors MLCC - SMD/SMT ROHS
	
30
	
JLCPCB
	
Extended
	
$0.4500

C3
	
GJM1555C1H1R0WB01D
	
0402
	
GJM1555C1H1R0WB01D
C72134
1pF 50V C0G 0402 Multilayer Ceramic Capacitors MLCC - SMD/SMT ROHS
	
20
	
JLCPCB
	
Extended
	
$0.6640

C4
	
GJM1555C1H1R2WB01D
	
0402
	
GJM1555C1H1R2WB01D
C76899
1.2pF 50V C0G 0402 Multilayer Ceramic Capacitors MLCC - SMD/SMT ROHS
	
20
	
JLCPCB
	
Extended
	
$0.6140

C5,C7,C8,C12
	
CL05B104KO5NNNC
	
0402
	
CL05B104KO5NNNC
C1525
100nF 16V X7R ±10% 0402 Multilayer Ceramic Capacitors MLCC - SMD/SMT ROHS
	
20
	
JLCPCB
	
Basic
	
$0.0900

C6,C19,C20,C21,C23,C24
	
GRM188Z71A475KE15D
	
0603
	
GRM188Z71A475KE15D
C913474
10V 4.7uF X7R ±10% 0603 Multilayer Ceramic Capacitors MLCC - SMD/SMT ROHS
	
35
	
JLCPCB
	
Extended
	
$2.3765

C9
	
GRM1555C1H821JA01D
	
0402
	
GRM1555C1H821JA01D
C85943
50V 820pF C0G ±5% 0402 Multilayer Ceramic Capacitors MLCC - SMD/SMT ROHS
	
20
	
JLCPCB
	
Extended
	
$0.1460

C11
	
GRM1555C1H101JA01D
	
0402
	
GRM1555C1H101JA01D
C77177
100pF 50V C0G ±5% 0402 Multilayer Ceramic Capacitors MLCC - SMD/SMT ROHS
	
20
	
JLCPCB
	
Extended
	
$0.2160

C14,C15,C22
	
0603B105K160CT
	
0603
	
0603B105K160CT
C108463
16V 1uF X7R ±10% 0603 Multilayer Ceramic Capacitors MLCC - SMD/SMT ROHS
	
25
	
JLCPCB
	
Extended
	
$0.4025

C16
	
GRM155R71H473KE14D
	
0402
	
GRM155R71H473KE14D
C117757
47nF 50V X7R ±10% 0402 Multilayer Ceramic Capacitors MLCC - SMD/SMT ROHS
	
20
	
JLCPCB
	
Extended
	
$0.2380

C25
	
CL10B104KB8NNNC
	
0603
	
CL10B104KB8NNNC
C1591
100nF 50V X7R ±10% 0603 Multilayer Ceramic Capacitors MLCC - SMD/SMT ROHS
	
20
	
JLCPCB
	
Extended
	
$0.1740

D1,D2,D3,D4,D5,D6,D7,D8,D9,D10,D11,D12,D13,D14,D15,D16,D17,D18,D19,D20,D21,D22,D23,D24,D25,D26,D27,D28,D29,D30,D31,D32,D33,D34,D35,D36,D37,D38,D39,D40,D41,D42,D43,D44,D45,D46,D47,D48,D49,D50,D51,D52,D53,D54,D55,D56,D57,D58,D59,D60,D61,D62,D63,D64,D65,D66,D67,D68,D69,D70,D71,D72,D73,D74,D75,D76,D77,D78,D79,D80,D81,D82,D83,D84,D85,D86
	
BAT46W-7-F
	
SOD-123
	
BAT46W-7-F
C83152
-55℃~+125℃ 1 Independent 100V 150mA 2uA@75V 450mV@10mA 750mA SOD-123 Schottky Diodes ROHS
	
435
	
JLCPCB
	
Extended
	
$39.6720

J1,J5
	
B2B-PH-K-S(LF)(SN)
	
JSTPH2.00mmTHTvertical
	
B2B-PH-K-S(LF)(SN)
C131337
-25℃~+85℃ 1 100V 1x2P 2 2A 2P 2mm 4.5mm 5.9mm 6mm Brass K Pin PA66 PH Through Hole Tin UL94V-0 White 插件,P=2mm Wire To Board Connector ROHS
	
11
	
JLCPCB
	
Extended
	
$0.3883

J3
	
HC-TYPE-C-16P-01A
	
USB-C16-pinSMThybrid
	
HC-TYPE-C-16P-01A
C2894897 
-55℃~+85℃ 1 16P 20V 5A 7.35mm Black Female Surface Mount, Right Angle Type-C SMD USB Connectors ROHS
	
0
	
JLCPCB
	
Extended

J4
	
U.FL-R-SMT-1(10)
	
U.FLSMT
	
U.FL-R-SMT-1(10)
C88373
-40℃~+90℃ 1 1.25mm 2mm 50Ω 6GHz Board Side IPEX Male Pin SMD Coaxial Connectors (RF) ROHS
	
5
	
JLCPCB
	
Extended
	
$1.1085

L1
	
LQW15AN4N7G80D
	
0402
	
LQW15AN4N7G80D
C412337
1.2A 4.7nH 71mΩ Unshielded Inductor ±2% 0402 Power Inductors ROHS
	
9
	
JLCPCB
	
Extended
	
$0.6363

L2,L4
	
LQM18DN100M70L
	
0603
	
LQM18DN100M70L
C713281
1.365Ω 100mA 10uH 300mA 32MHz ±20% 0603 Inductors (SMD) ROHS
	
14
	
JLCPCB
	
Extended
	
$1.4574

L3
	
LQG15HN15NJ02D
	
0402
	
LQG15HN15NJ02D
C97979
15nH 2.3GHz 400mA 450mΩ 8@100MHz ±5% 0402 Inductors (SMD) ROHS
	
20
	
JLCPCB
	
Extended
	
$0.5700

L5
	
LQW15AN2N2G80D
	
0402
	
LQW15AN2N2G80D
C412264
2.2nH 2.53A 22mΩ Unshielded Inductor ±2% 0402 Power Inductors ROHS
	
9
	
JLCPCB
	
Extended
	
$0.7038

LED1,LED2,LED3,LED4,LED5,LED6
	
LTW-C230DS
	
1206reverse-mount
	
LTW-C230DS
C575513 
-30℃~+85℃ 130° 20mA 3.2V 315mcd 72mW Discrete Diode Reverse Mount White Yellow Lens 1206 LED Indication - Discrete ROHS
	
32
	
JLCPCB
	
Extended
	
$2.1536

Q1
	
DMN2056U-7
	
SOT-23
	
DMN2056U-7
C332302
-55℃~+150℃ 1 N-channel 1V 20V 339pF 34pF 4.3nC@4.5V 45mΩ@2.5V 47pF 4A 940mW N-Channel SOT-23 MOSFETs ROHS
	
9
	
JLCPCB
	
Extended
	
$0.5994

R1,R2,R3,R4,R5,R6
	
0603WAF1001T5E
	
0603
	
0603WAF1001T5E
C21190
-55℃~+155℃ 100mW 1kΩ 75V Thick Film Resistor ±1% ±100ppm/℃ 0603 Chip Resistor - Surface Mount ROHS
	
30
	
JLCPCB
	
Basic
	
$0.0780

R9
	
0603WAF1003T5E
	
0603
	
0603WAF1003T5E
C25803
-55℃~+155℃ 100kΩ 100mW 75V Thick Film Resistor ±1% ±100ppm/℃ 0603 Chip Resistor - Surface Mount ROHS
	
5
	
JLCPCB
	
Basic
	
$0.0155

R11
	
0603WAF2001T5E
	
0603
	
0603WAF2001T5E
C22975
-55℃~+155℃ 100mW 2kΩ 75V Thick Film Resistor ±1% ±100ppm/℃ 0603 Chip Resistor - Surface Mount ROHS
	
5
	
JLCPCB
	
Basic
	
$0.0120

R12
	
0603WAF3481T5E
	
0603
	
0603WAF3481T5E
C22996
-55℃~+155℃ 100mW 3.48kΩ 75V Thick Film Resistor ±1% ±100ppm/℃ 0603 Chip Resistor - Surface Mount ROHS
	
20
	
JLCPCB
	
Extended
	
$0.0560

R13,R14
	
0603WAF5101T5E
	
0603
	
0603WAF5101T5E
C23186
-55℃~+155℃ 100mW 5.1kΩ 75V Thick Film Resistor ±1% ±100ppm/℃ 0603 Chip Resistor - Surface Mount ROHS
	
10
	
JLCPCB
	
Basic
	
$0.0150

SW87
	
PCM12SMTR
	
PCM12SMTSPDT
	
PCM12SMTR
C221841
-20℃~+85℃ 6V PC Pin Rectangular Columnar SPDT Surface Mount,Vertical SMD Slide Switches ROHS
	
5
	
JLCPCB
	
Extended
	
$8.2255

U1
	
NRF52840-QIAA-R7
	
aQFN73-7x7
	
NRF52840-QIAA-R7
C1851953
-95dBm 1.7V~5.5V 2.4GHz 2.4GHz~2.4835GHz 2Mbps 4.82mA 6.26mA 8dBm SPI、USB、UART、I2S、PDM、PWM ZigBee、Bluetooth transceiver AQFN-73-EP(7x7) RF Transceiver ICs ROHS
	
5
	
JLCPCB
	
Extended
	
$30.3270
	
Standard Only

U2
	
BQ24072RGTR
	
VQFN16-3x3-EP
	
BQ24072RGTR
C140288
-40℃~+125℃ 1 1.5A 1.5mA 4.2V 4.35V~6.6V Charging IC Lithium Battery Support QFN-16-EP(3x3) Battery Management ROHS
	
5
	
JLCPCB
	
Extended
	
$5.4325

U3
	
USBLC6-2SC6
	
SOT-23-6
	
USBLC6-2SC6
C7519
-40℃~+125℃ 150nA 17V 2 3.5pF 5.25V 5A 6V ESD IEC 61000-4-2 Unidirectional SOT-23-6L ESD and Surge Protection (TVS/ESD) ROHS
	
7
	
JLCPCB
	
Extended
	
$1.2313

X1
	
X201632MKB4SI
	
2016-4P
	
X201632MKB4SI
C718072
-40℃~+85℃ 32MHz 80Ω 8pF Crystal Oscillator ±10ppm ±20ppm SMD2016-4P Crystals ROHS
	
7
	
JLCPCB
	
Extended
	
$0.7665

X2
	
FC31M2-32.768-N09LLDT
	
3215-2P
	
FC31M2-32.768-N09LLDT
C2848222
-40℃~+85℃ 32.768kHz 50kΩ 9pF Crystal Oscillator ±20ppm ±20ppm SMD3215-2P Crystals ROHS
	
5
	
JLCPCB
	
Extended
	
$1.1555
	
+ Add Part

Please carefully check the packages of selected parts before proceeding.

NEXT
Online Chat >
Chat with our live agent for fast reply.
Mon-Fri: 24 hours, Sat: 9am-6pm, GMT+8
Email Us >
Contact us at supportjlcpcb.com
Typically reply within hours.
Help Center >
Get instant answers.
24/7 Available.
PCB Service
FR-4 PCBs
Flexible PCBs
Metal Core PCBs
High-Frequency PCBs
PCBA Service
PCB Layout
SMT Stencil
Flex Heater
Support
Help Center
Contact Us
Community
Shipping Guide
Payment Methods
How to Order
How to Track
After-Sales Service
Blog
Company
About Us
Quality Assurance
How We Work
Certifications
Security
Environment
JLCAPI
News
Cooperation
Electronics
EasyEDA
JLCPCB
JLCDFM
LCSC
OSHWLAB
Mechanical
JLC3DP
JLCCNC
JLCMC
Order on JLCONE Desktop, Save $1–$20 Every Time
Windows
MAC
Android
IOS
CONNECT WITH US
© 2026 JLCPCB.COM All Rights Reserved.
Privacy Policy
Terms & Conditions
Cookies Policy
Do Not Sell or Share My Personal Information
