davidkellis/keyboards/tkl/tkl12/manufacturing/jlcpcb-bom.csv

Comment | Designator | Footprint | LCSC Part # | Quantity | Manufacturer | Manufacturer Part Number
BAT46W | D1,D2,D3,D4,D5,D6,D7,D8,D9,D10,D11,D12,D13,D14,D15,D16,D17,D18,D19,D20,D21,D22,D23,D24,D25,D26,D27,D28,D29,D30,D31,D32,D33,D34,D35,D36,D37,D38,D39,D40,D41,D42,D43,D44,D45,D46,D47,D48,D49,D50,D51,D52,D53,D54,D55,D56,D57,D58,D59,D60,D61,D62,D63,D64,D65,D66,D67,D68,D69,D70,D71,D72,D73,D74,D75,D76,D77,D78,D79,D80,D81,D82,D83,D84,D85,D86 | SOD-123 | C54110 | 86 | Jiangsu Changjing Electronics Technology Co., Ltd. | BAT46W
LTW-C230DS | LED1,LED2,LED3,LED4,LED5,LED6,LED7,LED8,LED9,LED10 | 1206 reverse-mount | C575513 | 10 | Lite-On | LTW-C230DS
B2B-PH-K-S(LF)(SN) | J1 | JST PH 2.00mm THT vertical | C131337 | 1 | JST | B2B-PH-K-S(LF)(SN)
PCM12SMTR | SW87 | PCM12 SMT SPDT | C221841 | 1 | C&K | PCM12SMTR
0603WAF1004T5E | R9,R11 | 0603 | C22935 | 2 | UNI-ROYAL | 0603WAF1004T5E
TPS61169DCKR | U2 | SC-70-5 | C71045 | 1 | Texas Instruments | TPS61169DCKR
FNR4018S100MT | L1 | 4x4x1.8mm shielded | C167808 | 1 | cjiang | FNR4018S100MT
SS16 | D87 | SMA | C3034074 | 1 | ShunYe | SS16
CL31B475KBHNNNE | C1,C2 | 1206 | C51205 | 2 | Samsung Electro-Mechanics | CL31B475KBHNNNE
0603WAF1000T5E | R10 | 0603 | C22775 | 1 | UNI-ROYAL | 0603WAF1000T5E
