davidkellis/keyboards/tkl/tkl5/jlcpcb/bom-top.csv

Comment | Designator | Footprint | LCSC Part #
White LED 0603 | LED1,LED2,LED3,LED4,LED5,LED6 | 0603 | C84265
560R 1% 0603 | R1,R2,R3,R4,R5,R6 | 0603 | C114629
100K 1% 0603 | R9 | 0603 | C25803
AO3400A | Q1 | SOT-23 | C20917
