davidkellis/keyboards/tkl/tkl9/validation/preorder-2026-09-26/bench-test-connections.csv

Emulated switch | Column net | Column GPIO to switch | Row net | Row GPIO to diode cathode
SW1 | COL0 | P0.06 | ROW0 | P1.06
SW2 | COL1 | P0.08 | ROW0 | P1.06
SW10 | COL2 | P0.17 | ROW1 | P0.09
SW17 | COL0 | P0.06 | ROW2 | P0.10
SW64 | COL0 | P0.06 | ROW9 | P1.01
SW71 | COL1 | P0.08 | ROW9 | P1.01
SW77 | COL0 | P0.06 | ROW10 | P1.02
SW83 | COL0 | P0.06 | ROW11 | P1.07
