davidkellis/keyboards/tkl/research/module-controller-2026-09-25/removed-quote-groups.csv

Scenario | References | Part | FiveBoardQuotedPartCostUSD | FeederFeeUSD
controller_only_keep_carrier_charger_and_usb | C1,C2,C17,C18 | GRM1555C1H120GA01D | 0.4500 | 1.50
controller_only_keep_carrier_charger_and_usb | C3 | GJM1555C1H1R0WB01D | 0.6640 | 1.50
controller_only_keep_carrier_charger_and_usb | C4 | GJM1555C1H1R2WB01D | 0.6140 | 1.50
controller_only_keep_carrier_charger_and_usb | C5,C7,C8,C12 | CL05B104KO5NNNC | 0.1350 | 1.50
controller_only_keep_carrier_charger_and_usb | C9 | GRM1555C1H821JA01D | 0.1460 | 1.50
controller_only_keep_carrier_charger_and_usb | C11 | GRM1555C1H101JA01D | 0.2160 | 1.50
controller_only_keep_carrier_charger_and_usb | C16 | GRM155R71H473KE14D | 0.2380 | 1.50
controller_only_keep_carrier_charger_and_usb | J4 | U.FL-R-SMT-1(10) | 1.1085 | 1.50
controller_only_keep_carrier_charger_and_usb | L1 | LQW15AN4N7G80D | 0.6363 | 1.50
controller_only_keep_carrier_charger_and_usb | L2,L4 | LQM18DN100M70L | 1.4574 | 1.50
controller_only_keep_carrier_charger_and_usb | L3 | LQG15HN15NJ02D | 0.5700 | 1.50
controller_only_keep_carrier_charger_and_usb | L5 | LQW15AN2N2G80D | 0.7038 | 1.50
controller_only_keep_carrier_charger_and_usb | U1 | NRF52840-QIAA-R | 29.5800 | 1.50
controller_only_keep_carrier_charger_and_usb | X1 | X201632MKB4SI | 0.7665 | 1.50
controller_only_keep_carrier_charger_and_usb | X2 | FC31M2-32.768-N09LLDT | 1.1555 | 1.50
controller_plus_module_usb_and_charger_conditional | C1,C2,C17,C18 | GRM1555C1H120GA01D | 0.4500 | 1.50
controller_plus_module_usb_and_charger_conditional | C3 | GJM1555C1H1R0WB01D | 0.6640 | 1.50
controller_plus_module_usb_and_charger_conditional | C4 | GJM1555C1H1R2WB01D | 0.6140 | 1.50
controller_plus_module_usb_and_charger_conditional | C5,C7,C8,C12 | CL05B104KO5NNNC | 0.1350 | 1.50
controller_plus_module_usb_and_charger_conditional | C6,C19,C20,C21,C23,C24 | GRM188Z71A475KE15D | 2.3765 | 1.50
controller_plus_module_usb_and_charger_conditional | C9 | GRM1555C1H821JA01D | 0.1460 | 1.50
controller_plus_module_usb_and_charger_conditional | C11 | GRM1555C1H101JA01D | 0.2160 | 1.50
controller_plus_module_usb_and_charger_conditional | C14,C15,C22 | 0603B105K160CT | 0.4025 | 1.50
controller_plus_module_usb_and_charger_conditional | C16 | GRM155R71H473KE14D | 0.2380 | 1.50
controller_plus_module_usb_and_charger_conditional | C25 | CL10B104KB8NNNC | 0.1740 | 1.50
controller_plus_module_usb_and_charger_conditional | J3 | HC-TYPE-C-16P-01A | 0.4980 | 1.50
controller_plus_module_usb_and_charger_conditional | J4 | U.FL-R-SMT-1(10) | 1.1085 | 1.50
controller_plus_module_usb_and_charger_conditional | L1 | LQW15AN4N7G80D | 0.6363 | 1.50
controller_plus_module_usb_and_charger_conditional | L2,L4 | LQM18DN100M70L | 1.4574 | 1.50
controller_plus_module_usb_and_charger_conditional | L3 | LQG15HN15NJ02D | 0.5700 | 1.50
controller_plus_module_usb_and_charger_conditional | L5 | LQW15AN2N2G80D | 0.7038 | 1.50
controller_plus_module_usb_and_charger_conditional | R11 | 0603WAF2001T5E | 0.0480 | 1.50
controller_plus_module_usb_and_charger_conditional | R12 | 0603WAF3481T5E | 0.0560 | 1.50
controller_plus_module_usb_and_charger_conditional | R13,R14 | 0603WAF5101T5E | 0.0300 | 1.50
controller_plus_module_usb_and_charger_conditional | U1 | NRF52840-QIAA-R | 29.5800 | 1.50
controller_plus_module_usb_and_charger_conditional | U2 | BQ24072RGTR | 5.4325 | 1.50
controller_plus_module_usb_and_charger_conditional | U3 | USBLC6-2SC6 | 1.2313 | 1.50
controller_plus_module_usb_and_charger_conditional | X1 | X201632MKB4SI | 0.7665 | 1.50
controller_plus_module_usb_and_charger_conditional | X2 | FC31M2-32.768-N09LLDT | 1.1555 | 1.50
