davidkellis/keyboards/tkl/tkl10/case-raised-deck/reference/upper-assembly.stl

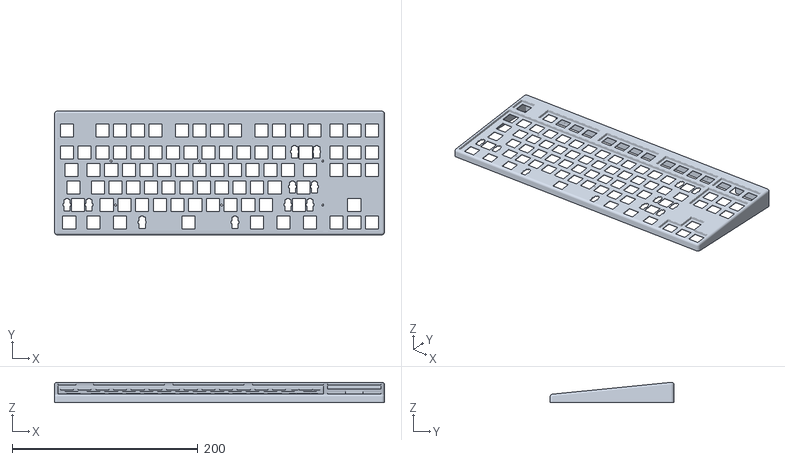
[picture p119: CAD file, 2026-10-31]
tkl/tkl10/case-raised-deck/reference/upper-assembly.stl
355.6 x 133.4 x 22.0
