davidkellis/keyboards/tkl/tkl10/case-hidden-mounts/mount-coupon-assembly.step

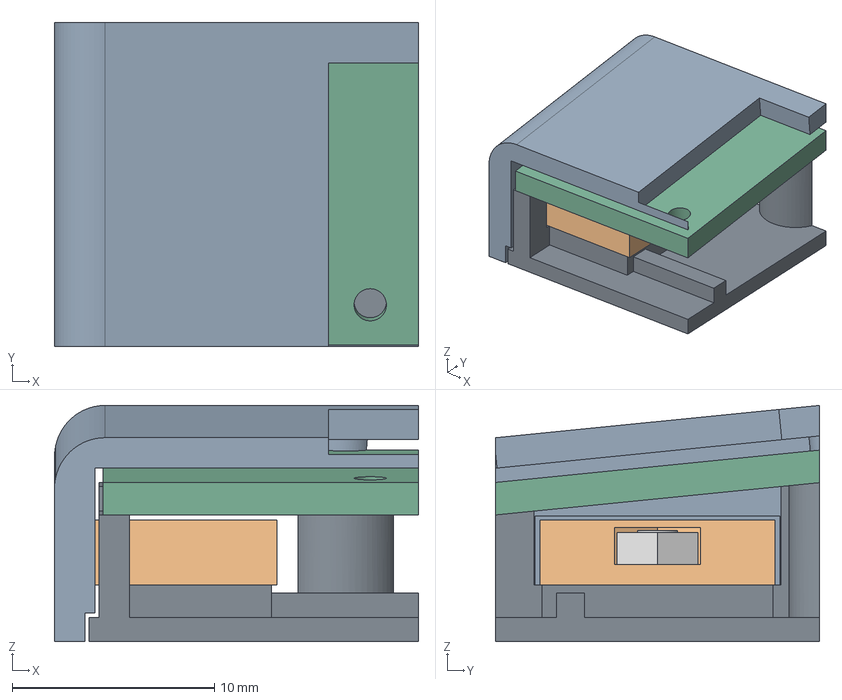
[picture p120: CAD file, 2026-10-31]
tkl/tkl10/case-hidden-mounts/mount-coupon-assembly.step
18.0 x 16.0 x 11.7 mm
upper
bottom
PCB
carrier
screw
nut
