davidkellis/keyboards/tkl/tkl10/case/fit-assembly.step

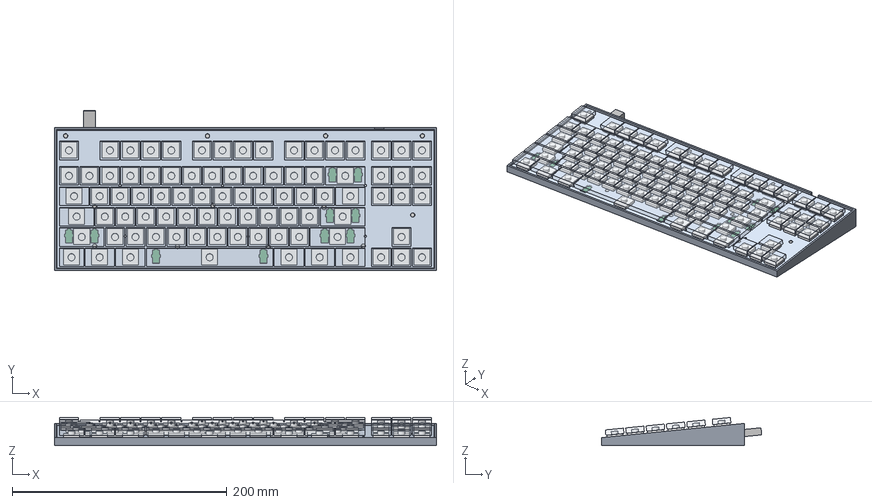
[picture p121: CAD file, 2026-10-31]
tkl/tkl10/case/fit-assembly.step
355.6 x 149.4 x 26.1 mm
case
separate-plate
LED1-diffuser
LED2-diffuser
LED3-diffuser
LED4-diffuser
LED5-diffuser
LED6-diffuser
H1-screw
H1-nut
H2-screw
H2-nut
H3-screw
H3-nut
H4-screw
H4-nut
H5-screw
H5-nut
H6-screw
H6-nut
H7-screw
H7-nut
H8-screw
H8-nut
H9-screw
H9-nut
H10-screw
H10-nut
H11-screw
H11-nut
H12-screw
H12-nut
PCB
D1
D10
D11
D12
D13
D14
D15
D16
D17
D18
D19
D2
D20
D21
D22
D23
D24
D25
D26
D27
D28
D29
D3
D30
D31
D32
D33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
