davidkellis/keyboards/tkl/tkl10/case-raised-deck/reference/navigation-guide-assembly.stl

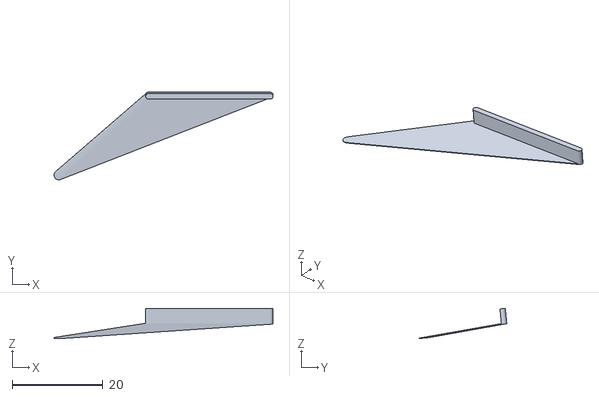
[picture p122: CAD file, 2026-10-31]
tkl/tkl10/case-raised-deck/reference/navigation-guide-assembly.stl
48.2 x 19.3 x 6.66
