davidkellis/keyboards/tkl/tkl10/case-hidden-mounts/reference/M7-carrier-assembly.stl

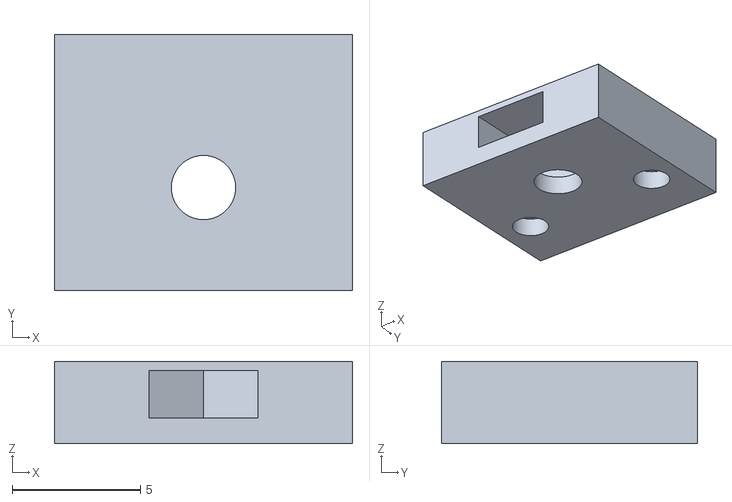
[picture p123: CAD file, 2026-10-31]
tkl/tkl10/case-hidden-mounts/reference/M7-carrier-assembly.stl
11.6 x 9.95 x 3.20
