davidkellis/keyboards/tkl/tkl10/case-hidden-mounts/usb-coupon-assembly.step

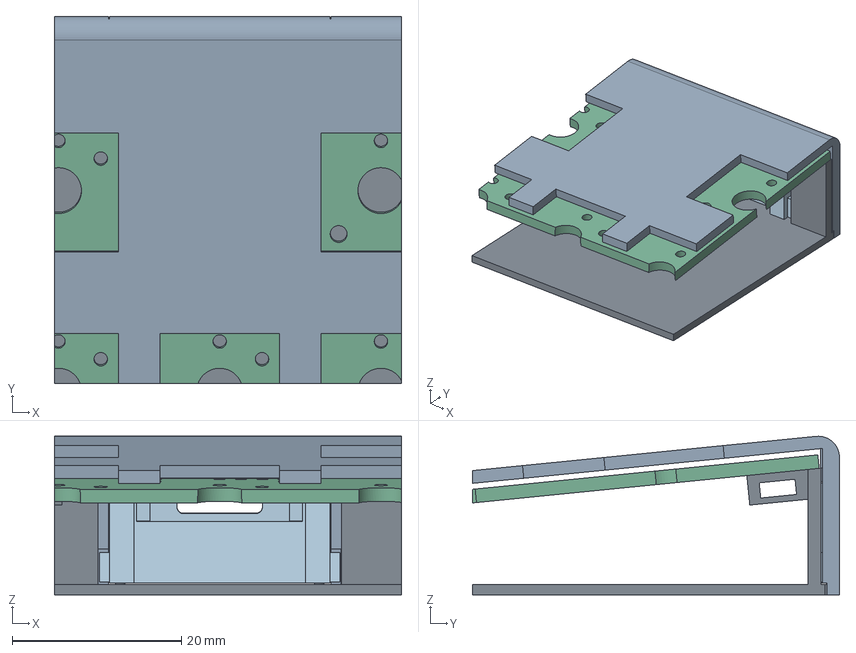
[picture p125: CAD file, 2026-10-31]
tkl/tkl10/case-hidden-mounts/usb-coupon-assembly.step
41.0 x 43.4 x 18.7 mm
upper
bottom
PCB-gauge
USB-insert
