davidkellis/keyboards/tkl/tkl10/case-hidden-mounts/reference/bezel-assembly.stl

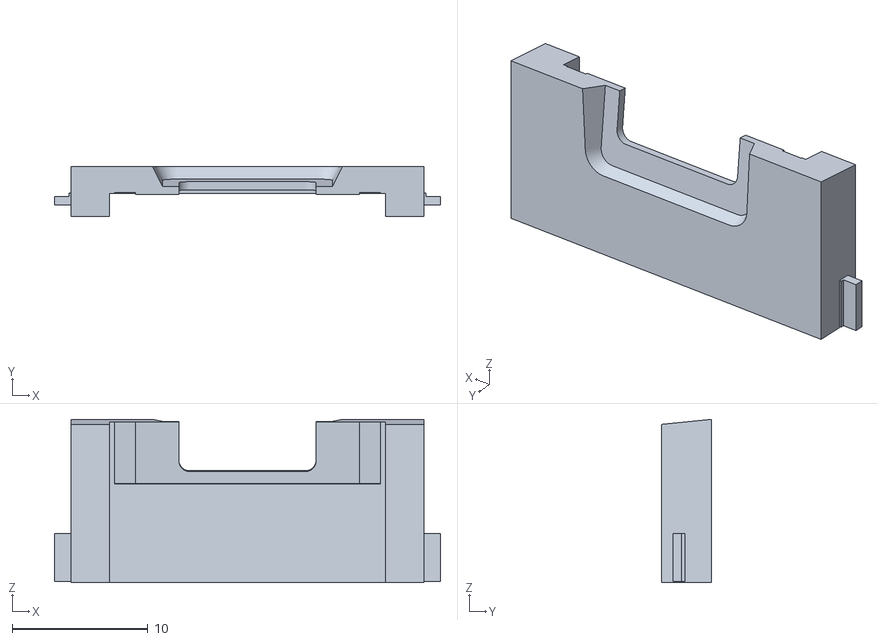
[picture p126: CAD file, 2026-10-31]
tkl/tkl10/case-hidden-mounts/reference/bezel-assembly.stl
28.4 x 3.70 x 12.0
