davidkellis/keyboards/tkl/tkl10/case/mount-coupon-assembly.step

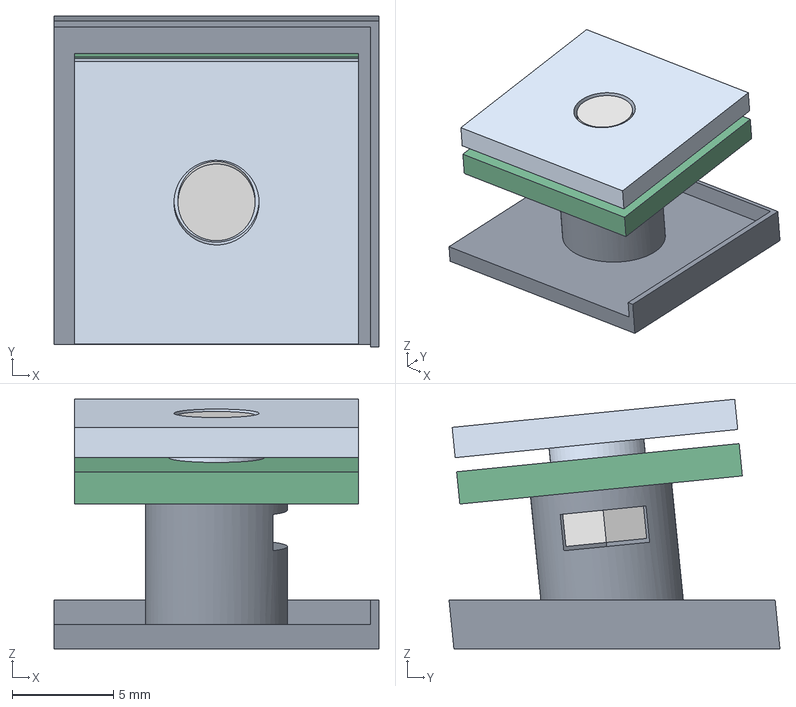
[picture p127: CAD file, 2026-10-31]
tkl/tkl10/case/mount-coupon-assembly.step
16.0 x 16.3 x 12.3 mm
case
pcb
upper
H5-screw
H5-nut
