davidkellis/keyboards/tkl/tkl8/case/stabilizer-test/2u-assembly.step

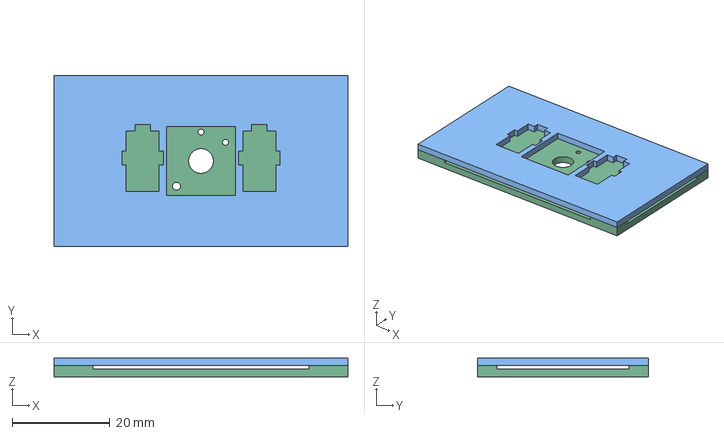
[picture p128: CAD file, 2026-10-31]
tkl/tkl8/case/stabilizer-test/2u-assembly.step
60.0 x 35.0 x 3.80 mm
PCB-with-0.7mm-supports
plate-top-2.2mm-above-PCB
