davidkellis/keyboards/tkl/tkl10/case/rim-coupon-assembly.step

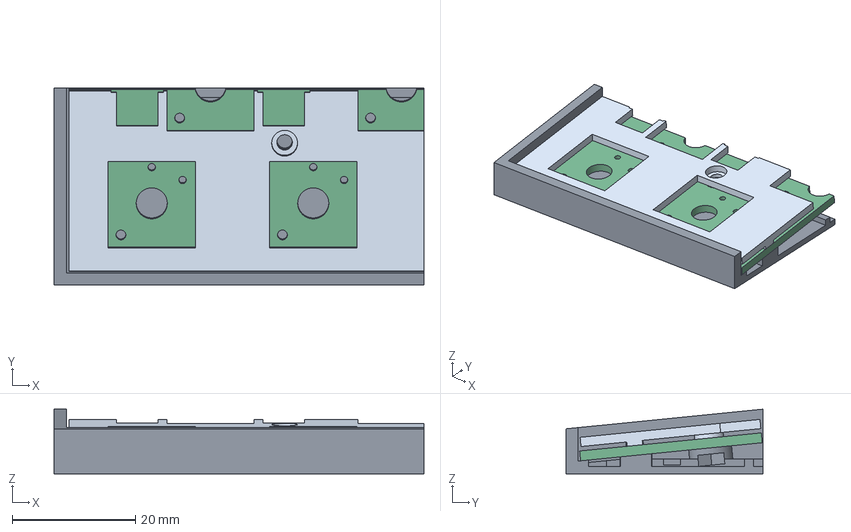
[picture p129: CAD file, 2026-10-31]
tkl/tkl10/case/rim-coupon-assembly.step
60.0 x 32.0 x 10.5 mm
case
plate
pcb
