davidkellis/keyboards/tkl/tkl10/case-hidden-mounts/assembly.step

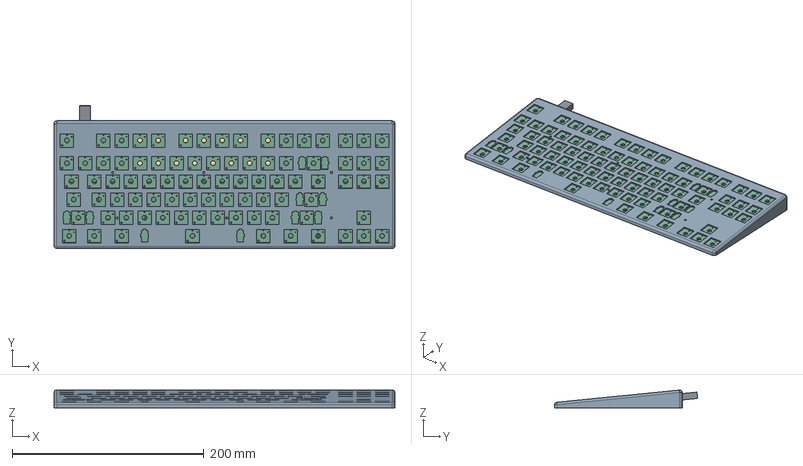
[picture p130: CAD file, 2026-10-31]
tkl/tkl10/case-hidden-mounts/assembly.step
355.6 x 149.4 x 18.7 mm
plate-upper
case-bottom
usb-bezel
unchanged-v10-PCB
battery-reserve
M1-carrier
M2-carrier
M3-carrier
M4-carrier
M5-carrier
M6-carrier
M7-carrier
M8-carrier
M1-screw
M1-nut
M2-screw
M2-nut
M3-screw
M3-nut
M4-screw
M4-nut
M5-screw
M5-nut
M6-screw
M6-nut
M7-screw
M7-nut
M8-screw
M8-nut
D1
D10
D11
D12
D13
D14
D15
D16
D17
D18
D19
D2
D20
D21
D22
D23
D24
D25
D26
D27
D28
D29
D3
D30
D31
D32
D33
D34
D35
D36
D37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
