davidkellis/keyboards/tkl/tkl10/case-hidden-mounts/reference/board-assembly.stl

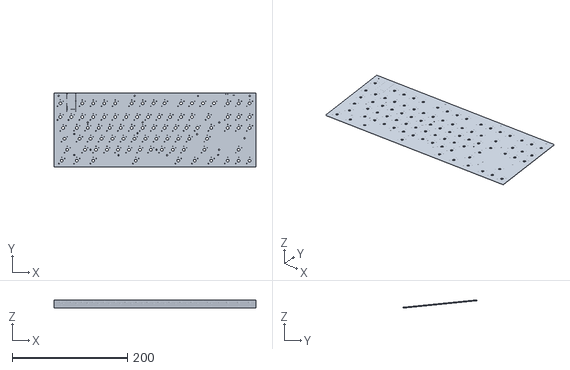
[picture p131: CAD file, 2026-10-31]
tkl/tkl10/case-hidden-mounts/reference/board-assembly.stl
350.8 x 128.7 x 14.4
