davidkellis/keyboards/tkl/tkl10/case-hidden-mounts/reference/upper-assembly.stl

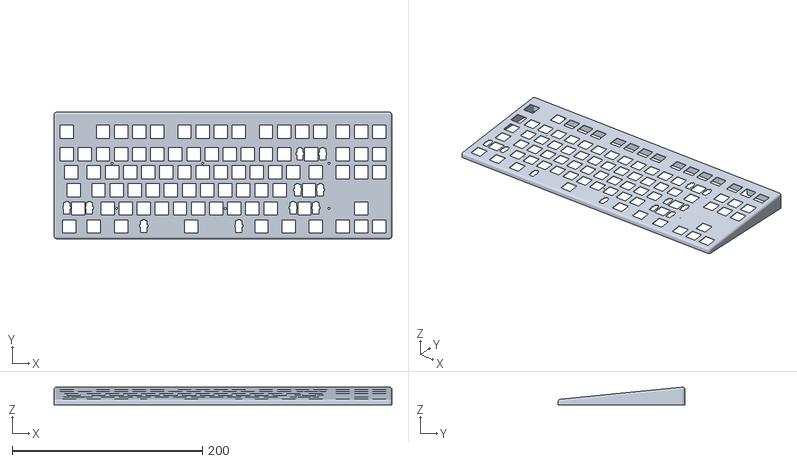
[picture p132: CAD file, 2026-10-31]
tkl/tkl10/case-hidden-mounts/reference/upper-assembly.stl
355.6 x 133.4 x 18.7
