davidkellis/keyboards/tkl/tkl10/case-hidden-mounts/reference/battery-assembly.stl

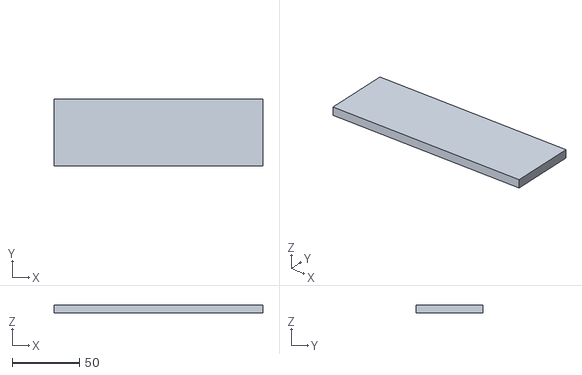
[picture p133: CAD file, 2026-10-31]
tkl/tkl10/case-hidden-mounts/reference/battery-assembly.stl
155.0 x 50.0 x 6.30
