davidkellis/keyboards/tkl/tkl10/case-hidden-mounts/reference/bottom-assembly.stl

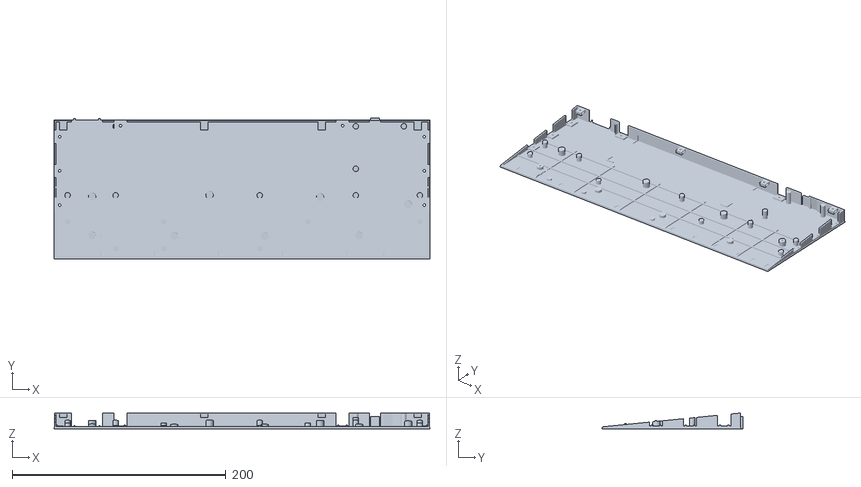
[picture p134: CAD file, 2026-10-31]
tkl/tkl10/case-hidden-mounts/reference/bottom-assembly.stl
352.2 x 131.7 x 15.0
