davidkellis/keyboards/tkl/tkl10/case/led-diffuser-assembly.step

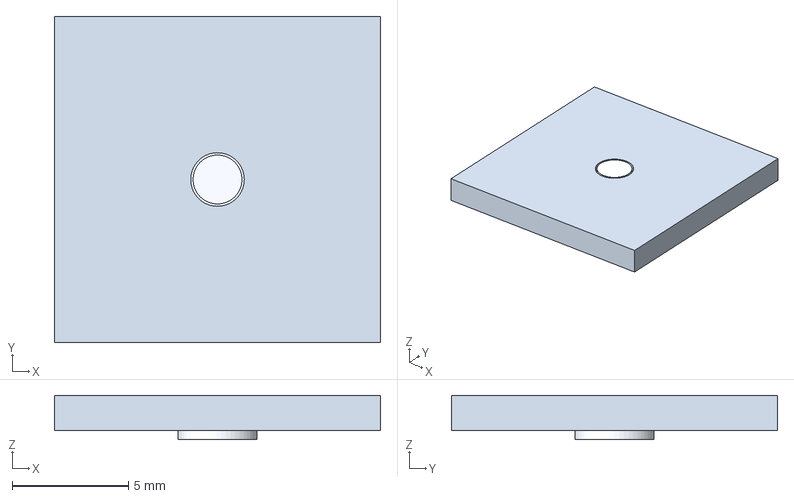
[picture p135: CAD file, 2026-10-31]
tkl/tkl10/case/led-diffuser-assembly.step
14.0 x 14.0 x 1.90 mm
plate
translucent-insert
