davidkellis/keyboards/tkl/tkl10/case-raised-deck/prints/plate-upper-left.stl

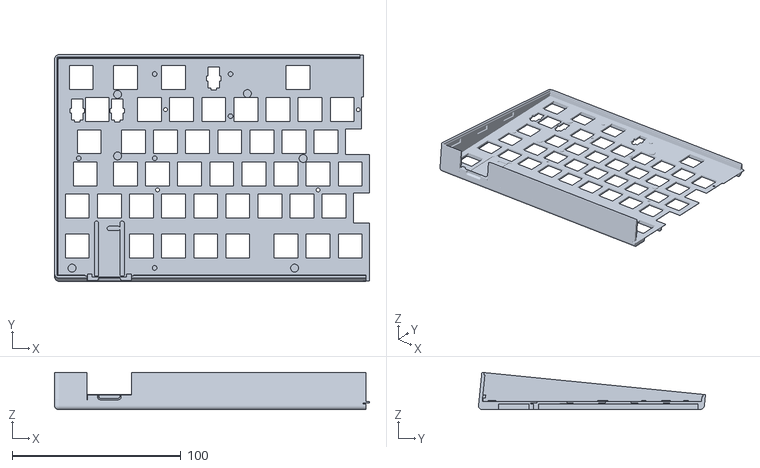
[picture p136: CAD file, 2026-10-31]
tkl/tkl10/case-raised-deck/prints/plate-upper-left.stl
186.8 x 134.7 x 22.1
