davidkellis/keyboards/tkl/tkl10/case/case-left.stl

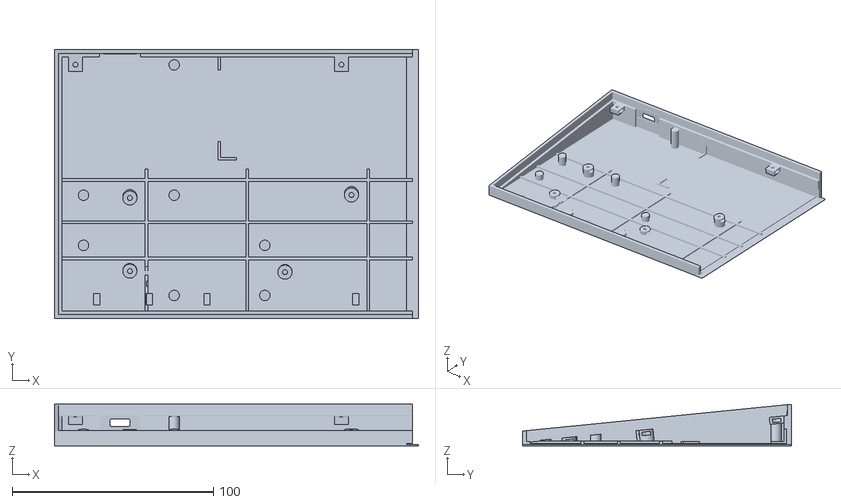
[picture p137: CAD file, 2026-10-31]
tkl/tkl10/case/case-left.stl
180.7 x 133.4 x 20.6
