davidkellis/keyboards/tkl/tkl10/render-case-editions/reference/glass-1.00u.stl

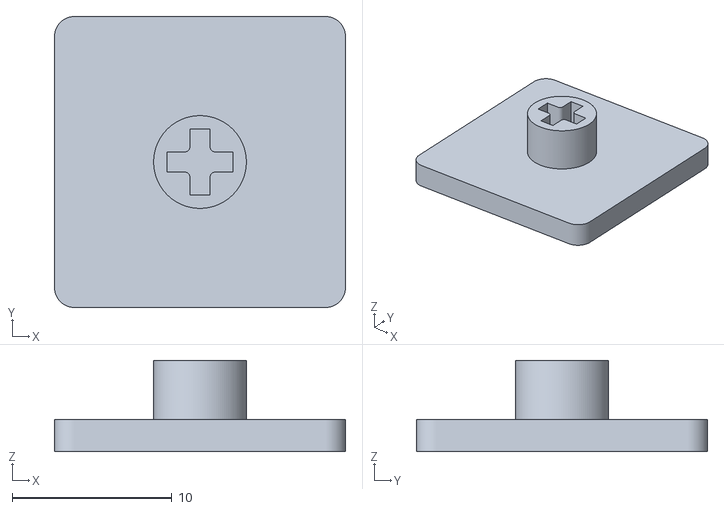
[picture p139: CAD file, 2026-10-31]
tkl/tkl10/render-case-editions/reference/glass-1.00u.stl
18.2 x 18.2 x 5.70
