davidkellis/keyboards/tkl/tkl10/render-keycaps-lighting/reference/flat-6.25u.3mf

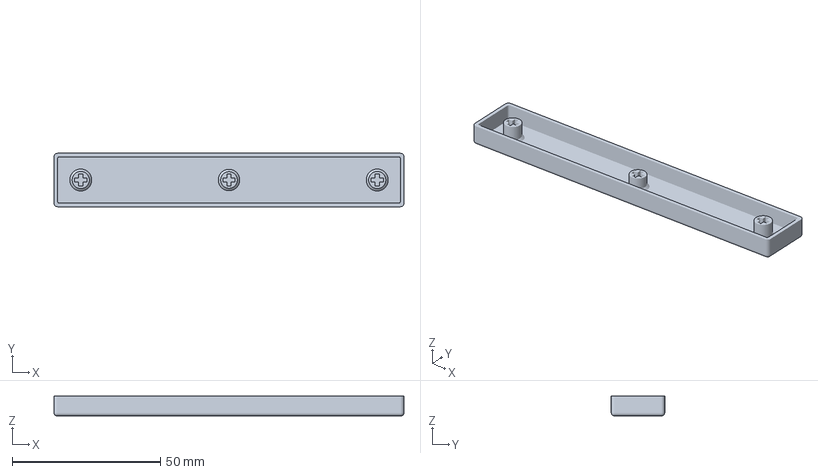
[picture p140: CAD file, 2026-10-31]
tkl/tkl10/render-keycaps-lighting/reference/flat-6.25u.3mf
118.1 x 18.0 x 6.70 mm
