davidkellis/keyboards/tkl/tkl12/case/switch-fit-coupon.stl

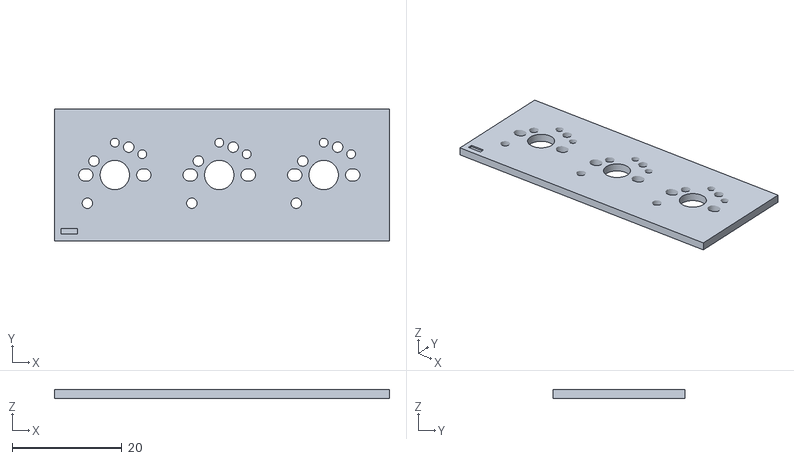
[picture p141: CAD file, 2026-10-31]
tkl/tkl12/case/switch-fit-coupon.stl
61.1 x 24.0 x 1.60
