davidkellis/keyboards/tkl/tkl6/case/keycaps-right.stl

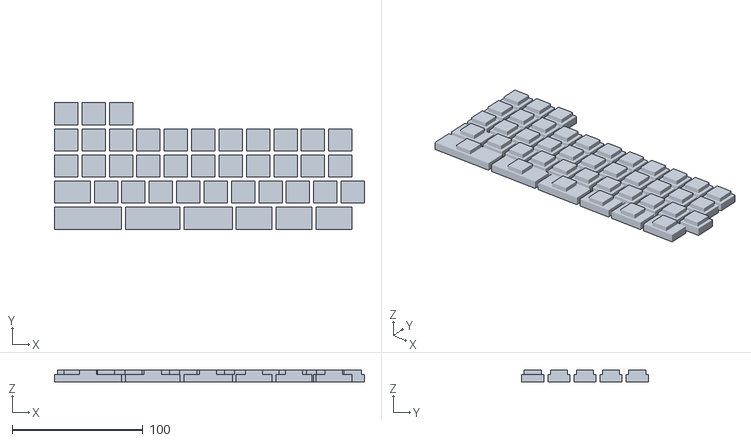
[picture p142: CAD file, 2026-10-31]
tkl/tkl6/case/keycaps-right.stl
237.5 x 97.0 x 9.40
