davidkellis/keyboards/tkl/tkl7.5/case/usb_male-reported-6.6mm-gauge.stl

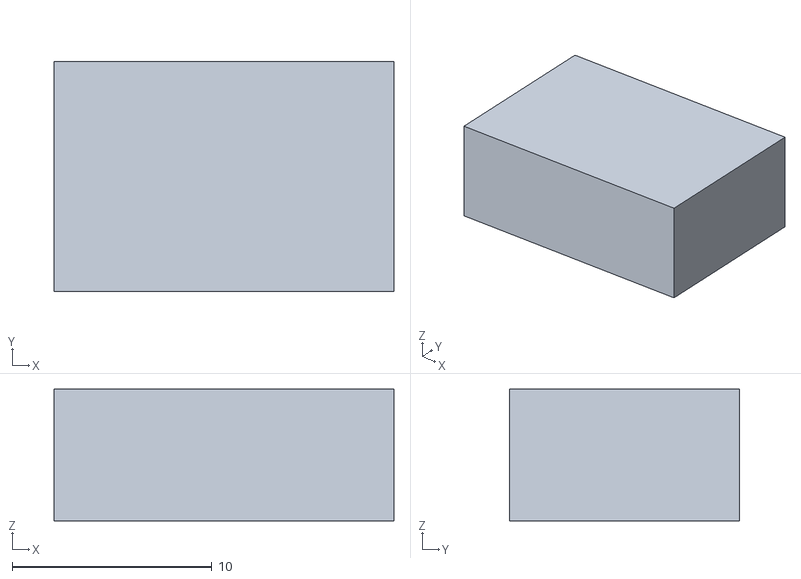
[picture p143: CAD file, 2026-10-31]
tkl/tkl7.5/case/usb_male-reported-6.6mm-gauge.stl
17.0 x 11.5 x 6.60
