davidkellis/keyboards/tkl/tkl7/keyboard-plate.dxf

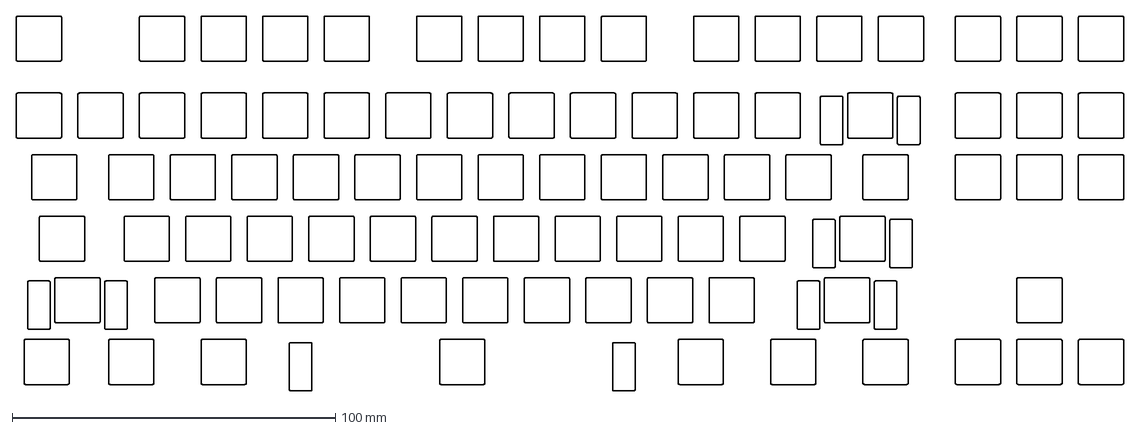
[picture p144: CAD file, 2026-10-31]
tkl/tkl7/keyboard-plate.dxf
342.6 x 116.0 mm
