davidkellis/keyboards/tkl/tkl8/case/stabilizer-test/2u-pcb-for-1.5mm-plate.stl

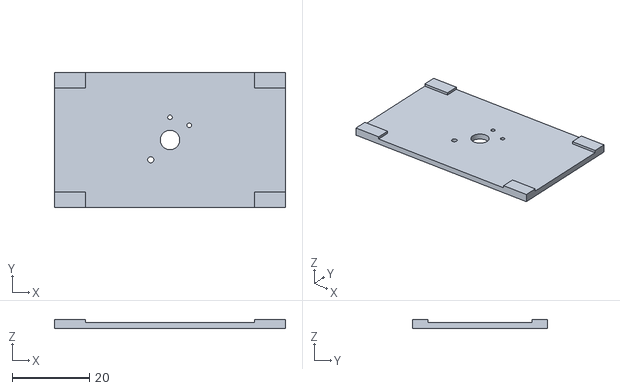
[picture p145: CAD file, 2026-10-31]
tkl/tkl8/case/stabilizer-test/2u-pcb-for-1.5mm-plate.stl
60.0 x 35.0 x 2.30
