davidkellis/keyboards/tkl/tkl9.1/case/battery-reserve-gauge-270x52x6.3-right.stl

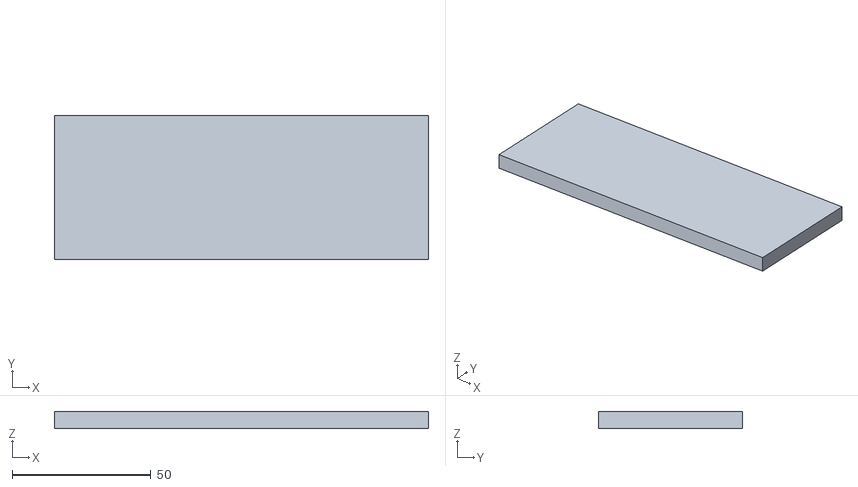
[picture p146: CAD file, 2026-10-31]
tkl/tkl9.1/case/battery-reserve-gauge-270x52x6.3-right.stl
135.0 x 52.0 x 6.30
