davidkellis/keyboards/tkl/tkl9.2/case/battery-reserve-gauge-270x52x6.3.stl

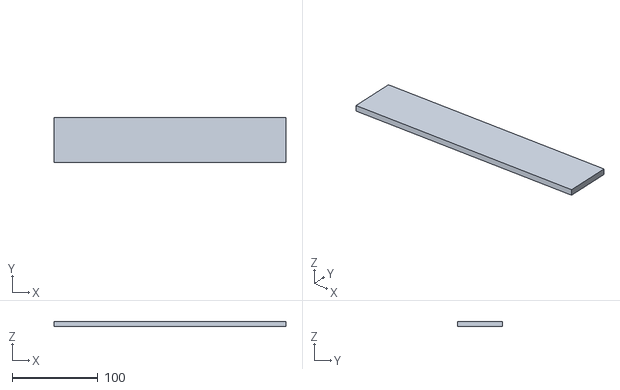
[picture p147: CAD file, 2026-10-31]
tkl/tkl9.2/case/battery-reserve-gauge-270x52x6.3.stl
270.0 x 52.0 x 6.30
