davidkellis/keyboards/tkl/tkl9.3/case/battery-pack-max-gauge-264x50x5.5-right.stl

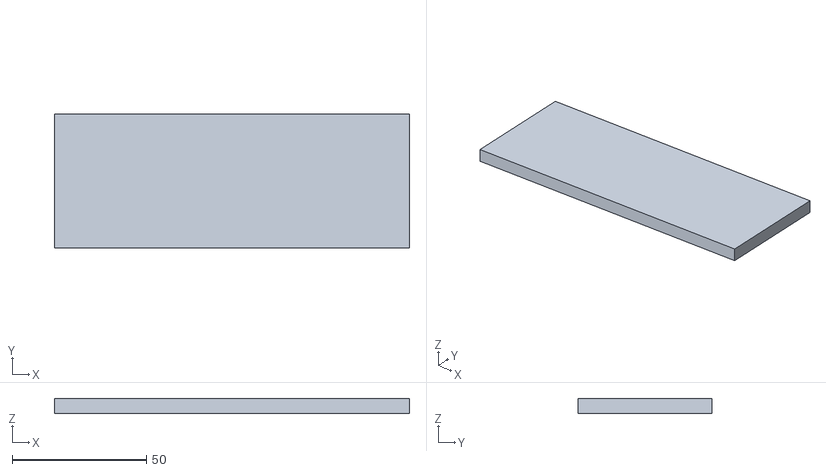
[picture p148: CAD file, 2026-10-31]
tkl/tkl9.3/case/battery-pack-max-gauge-264x50x5.5-right.stl
132.0 x 50.0 x 5.50
