davidkellis/keyboards/tkl/tkl9/case/plate-supported-right.stl

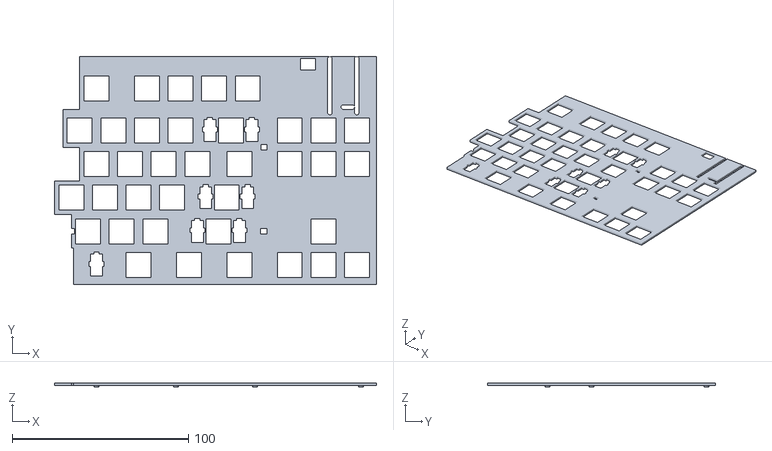
[picture p149: CAD file, 2026-10-31]
tkl/tkl9/case/plate-supported-right.stl
182.5 x 129.2 x 2.20
