davidkellis/keyboards/tkl/tkl10/case-raised-deck/prints/plate-upper-navigation-right.stl

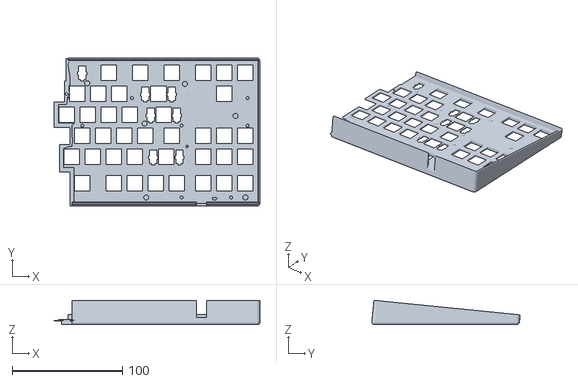
[picture p150: CAD file, 2026-10-31]
tkl/tkl10/case-raised-deck/prints/plate-upper-navigation-right.stl
186.8 x 134.7 x 22.1
