davidkellis/keyboards/tkl/tkl10/case/print-fit/pcb-right-easy-fit.stl

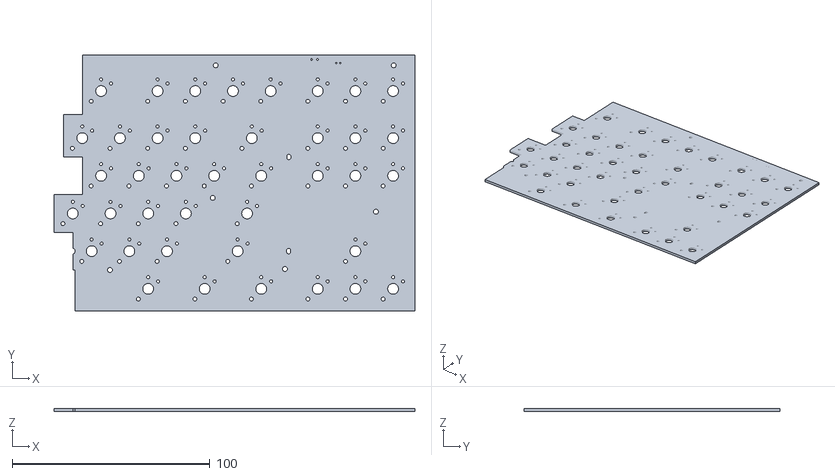
[picture p151: CAD file, 2026-10-31]
tkl/tkl10/case/print-fit/pcb-right-easy-fit.stl
182.5 x 129.2 x 1.60
