davidkellis/keyboards/tkl/tkl10/render-case-editions/reference/flat-2.00u.3mf

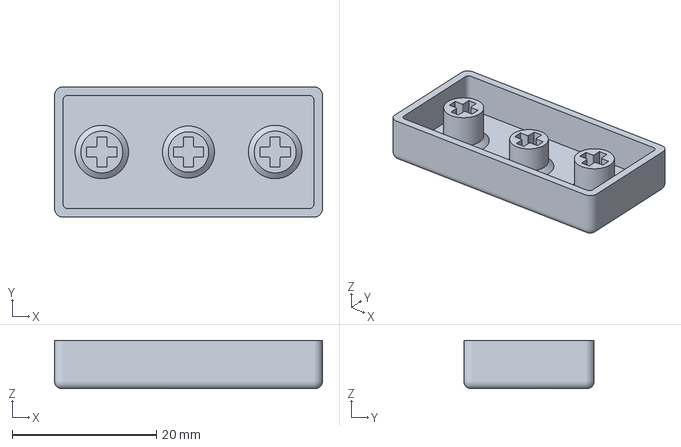
[picture p152: CAD file, 2026-10-31]
tkl/tkl10/render-case-editions/reference/flat-2.00u.3mf
37.1 x 18.0 x 6.70 mm
