davidkellis/keyboards/tkl/tkl10/render-keycaps-lighting/reference/flat-1.00u.3mf

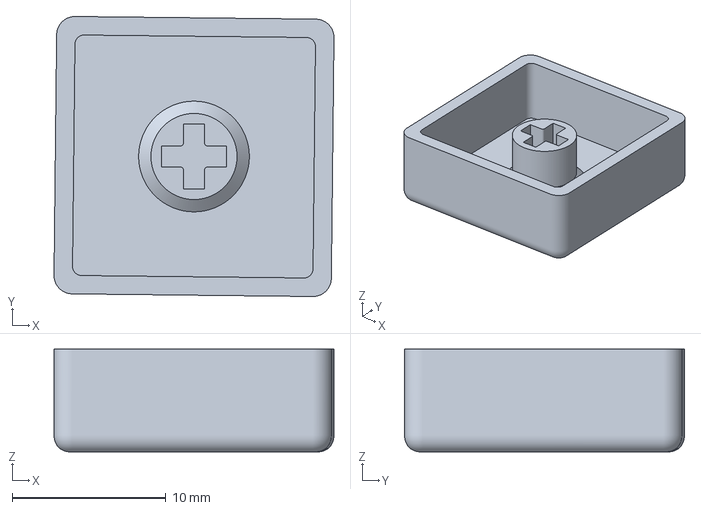
[picture p153: CAD file, 2026-10-31]
tkl/tkl10/render-keycaps-lighting/reference/flat-1.00u.3mf
18.2 x 18.2 x 6.70 mm
