davidkellis/keyboards/tkl/tkl12/case/pcb-fit-check.stl

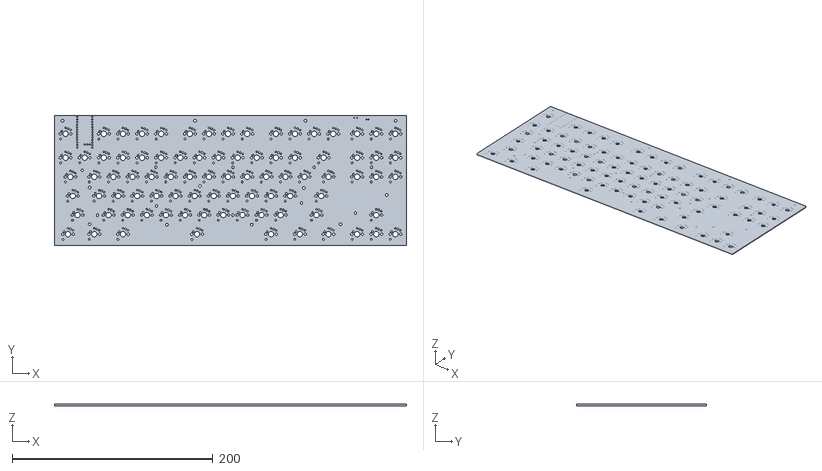
[picture p154: CAD file, 2026-10-31]
tkl/tkl12/case/pcb-fit-check.stl
350.8 x 129.2 x 1.60
