davidkellis/keyboards/tkl/tkl7.5/case/usb_male-envelope.stl

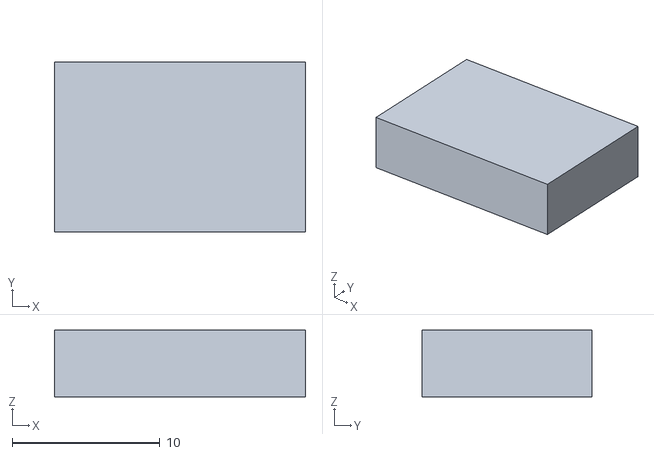
[picture p155: CAD file, 2026-10-31]
tkl/tkl7.5/case/usb_male-envelope.stl
17.0 x 11.5 x 4.53
