davidkellis/keyboards/tkl/tkl7/tklplate.stl

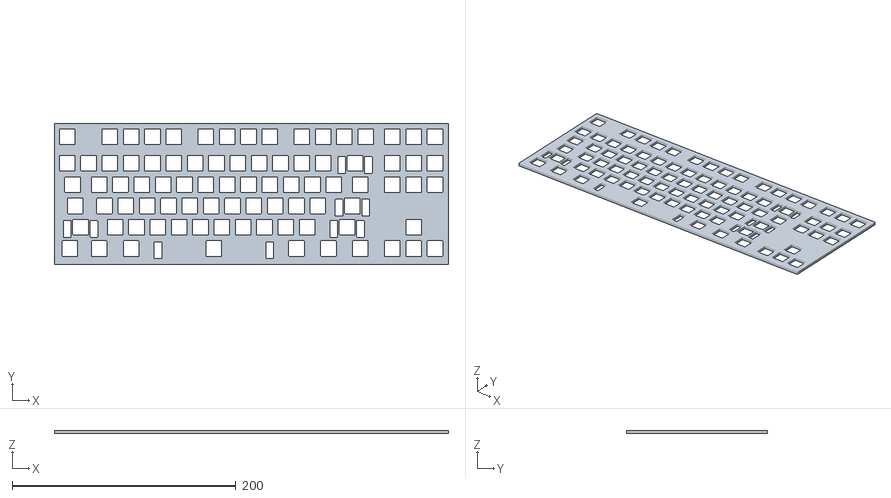
[picture p156: CAD file, 2026-10-31]
tkl/tkl7/tklplate.stl
352.1 x 125.8 x 3.00
