davidkellis/keyboards/tkl/tkl8/case/stabilizer-test/spacebar-6.25u-plate-1.2mm.stl

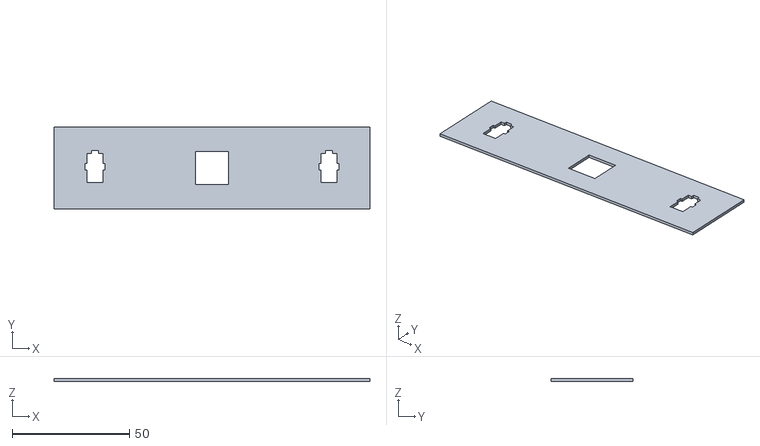
[picture p157: CAD file, 2026-10-31]
tkl/tkl8/case/stabilizer-test/spacebar-6.25u-plate-1.2mm.stl
135.0 x 35.0 x 1.20
