davidkellis/keyboards/tkl/tkl9.2/case/battery-pack-max-gauge-264x50x5.5.stl

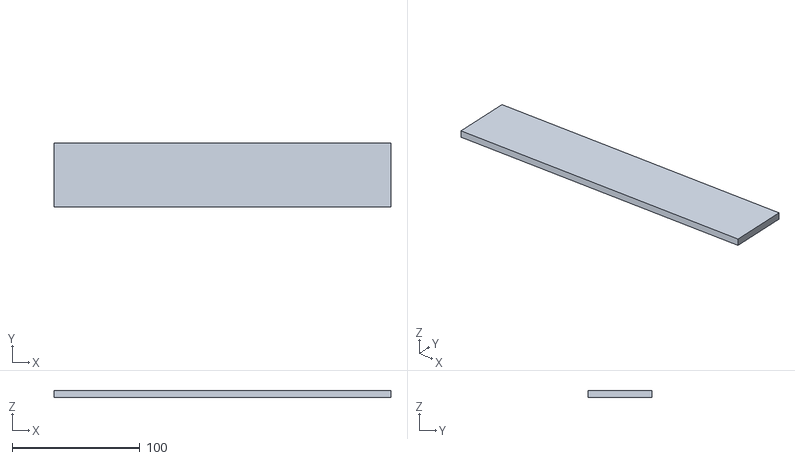
[picture p159: CAD file, 2026-10-31]
tkl/tkl9.2/case/battery-pack-max-gauge-264x50x5.5.stl
264.0 x 50.0 x 5.50
