davidkellis/keyboards/tkl/tkl9/case/cover.stl

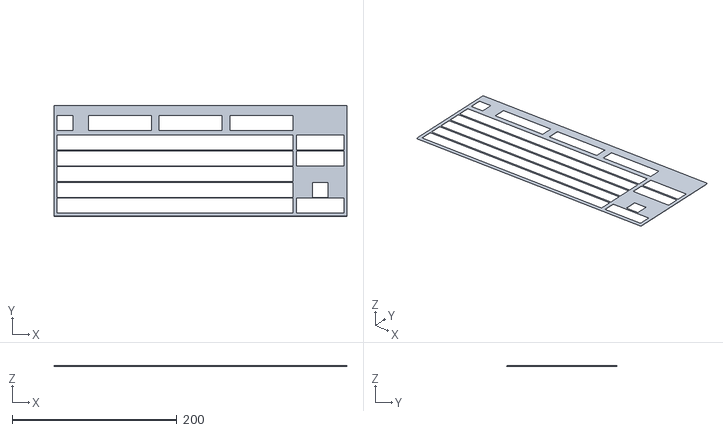
[picture p160: CAD file, 2026-10-31]
tkl/tkl9/case/cover.stl
355.6 x 134.1 x 1.60
