davidkellis/keyboards/tkl/tkl10/case-hidden-mounts/usb-coupon-pcb.stl

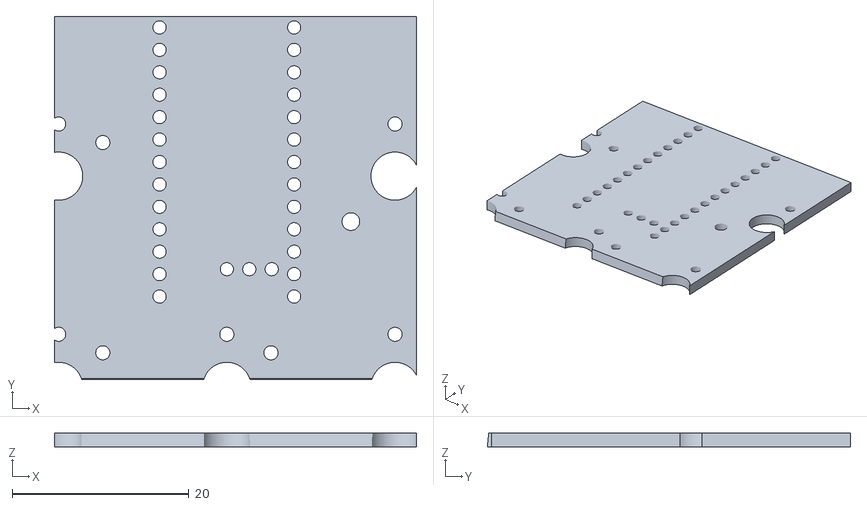
[picture p161: CAD file, 2026-10-31]
tkl/tkl10/case-hidden-mounts/usb-coupon-pcb.stl
41.0 x 41.2 x 1.60
