davidkellis/keyboards/tkl/tkl10/case/print-fit/single-switch-easy-fit.stl

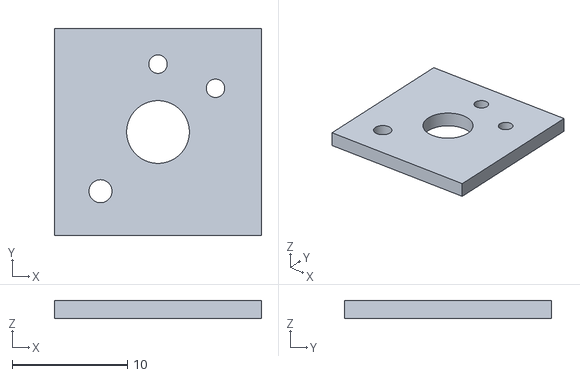
[picture p162: CAD file, 2026-10-31]
tkl/tkl10/case/print-fit/single-switch-easy-fit.stl
18.0 x 18.0 x 1.60
