davidkellis/keyboards/tkl/tkl10/render-case-editions/reference/flat-1.75u.3mf

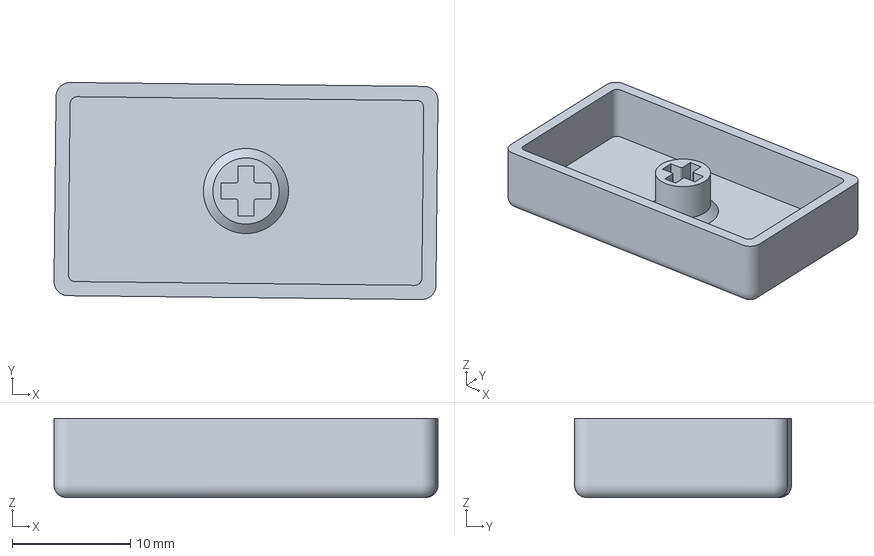
[picture p163: CAD file, 2026-10-31]
tkl/tkl10/render-case-editions/reference/flat-1.75u.3mf
32.5 x 18.4 x 6.70 mm
