davidkellis/keyboards/tkl/tkl12/case/pcb-bare.stl

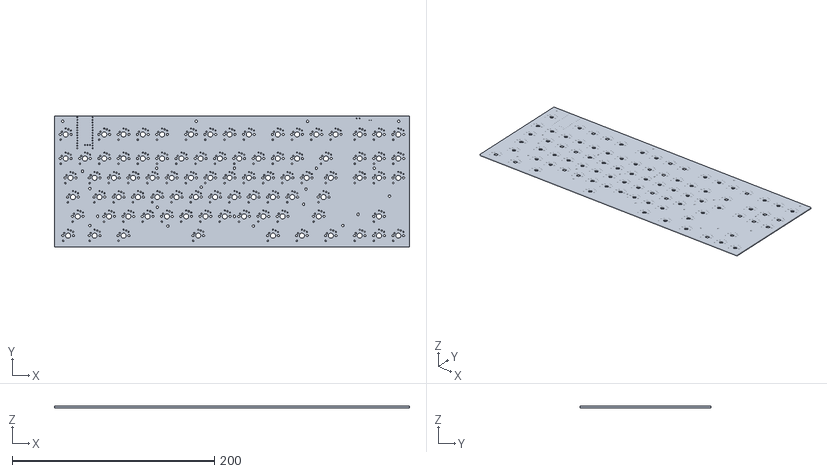
[picture p164: CAD file, 2026-10-31]
tkl/tkl12/case/pcb-bare.stl
350.8 x 129.2 x 1.53
