davidkellis/keyboards/tkl/tkl6/case/plug.stl

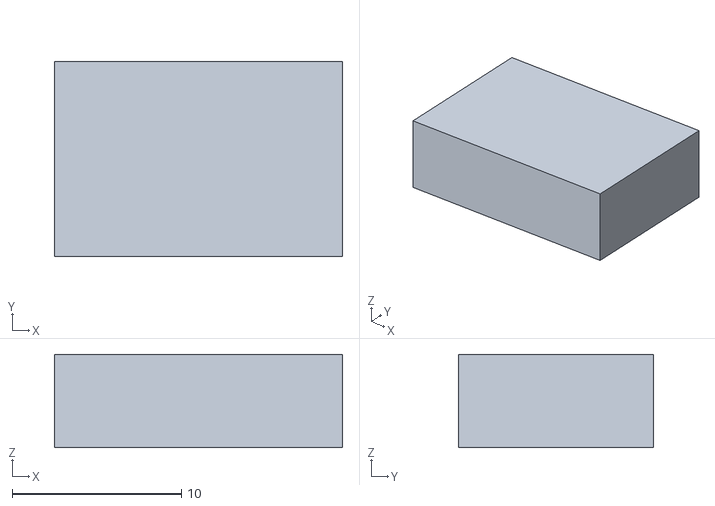
[picture p165: CAD file, 2026-10-31]
tkl/tkl6/case/plug.stl
17.0 x 11.5 x 5.50
