davidkellis/keyboards/tkl/tkl7.5/case/usb_rear-envelope.stl

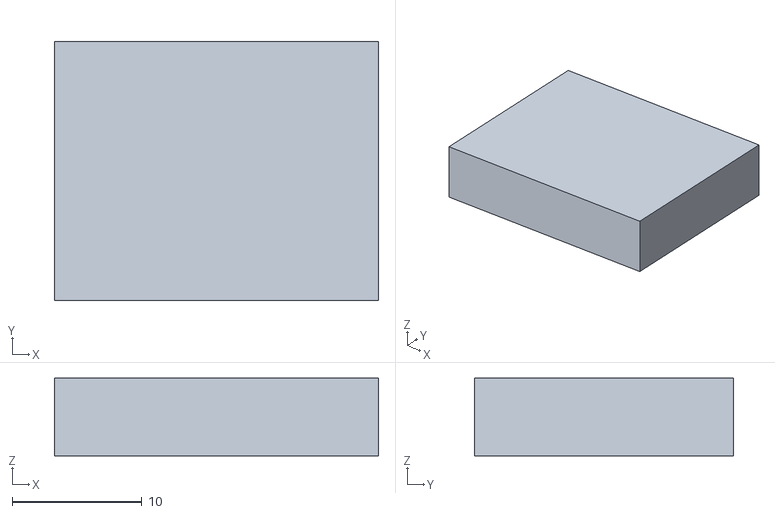
[picture p166: CAD file, 2026-10-31]
tkl/tkl7.5/case/usb_rear-envelope.stl
25.0 x 20.0 x 6.00
