davidkellis/keyboards/tkl/tkl10/case/print-fit/pcb-bare-easy-fit.stl

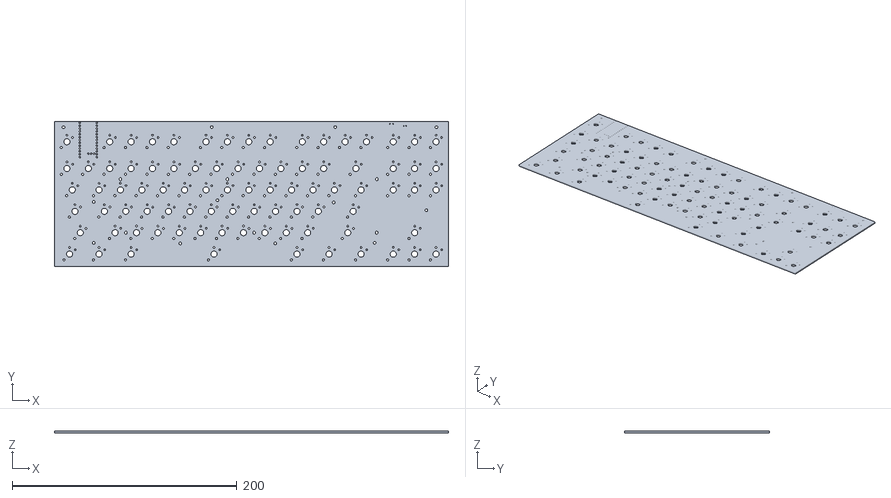
[picture p169: CAD file, 2026-10-31]
tkl/tkl10/case/print-fit/pcb-bare-easy-fit.stl
350.8 x 129.2 x 1.60
