davidkellis/keyboards/tkl/tkl10/render-case-editions/reference/glass-2.00u.stl

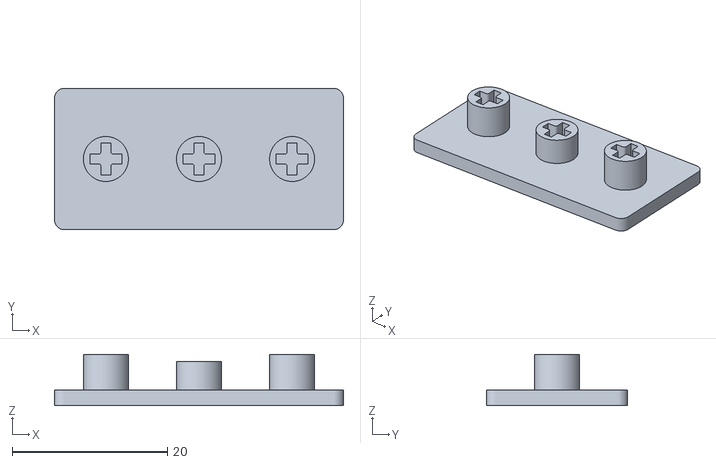
[picture p170: CAD file, 2026-10-31]
tkl/tkl10/render-case-editions/reference/glass-2.00u.stl
37.2 x 18.2 x 6.60
