davidkellis/keyboards/tkl/tkl10/render-keycaps-lighting/reference/flat-1.25u.3mf

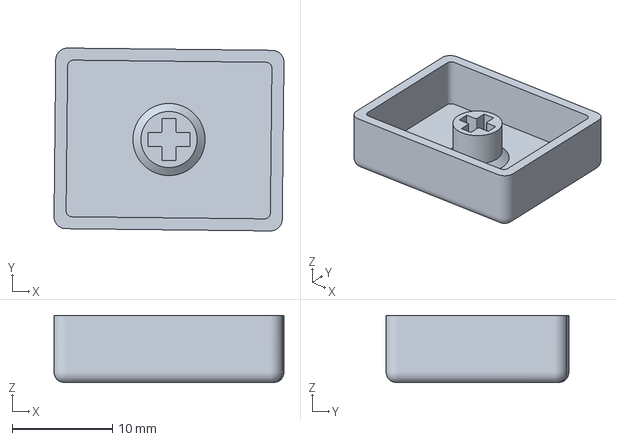
[picture p171: CAD file, 2026-10-31]
tkl/tkl10/render-keycaps-lighting/reference/flat-1.25u.3mf
23.0 x 18.3 x 6.70 mm
