davidkellis/keyboards/tkl/tkl6/case/keycaps-left.stl

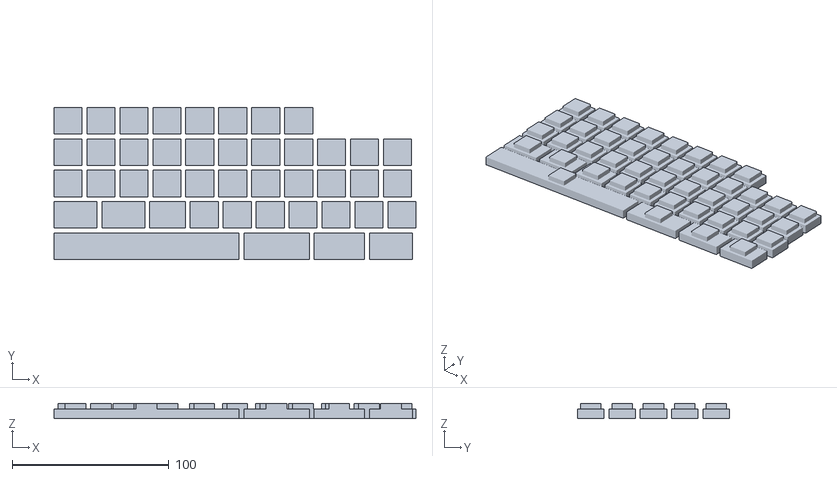
[picture p172: CAD file, 2026-10-31]
tkl/tkl6/case/keycaps-left.stl
230.8 x 97.0 x 9.40
