davidkellis/keyboards/tkl/tkl8/case/stabilizer-test/2u-plate-1.6mm.stl

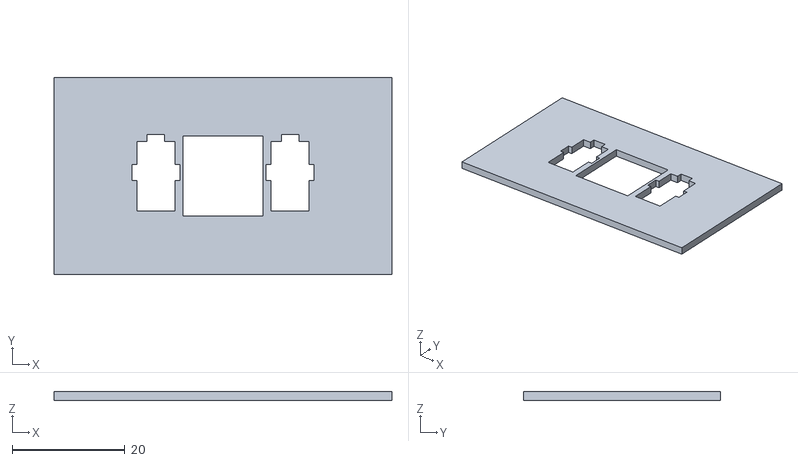
[picture p173: CAD file, 2026-10-31]
tkl/tkl8/case/stabilizer-test/2u-plate-1.6mm.stl
60.0 x 35.0 x 1.60
