davidkellis/keyboards/tkl/tkl9/case/cover-left.stl

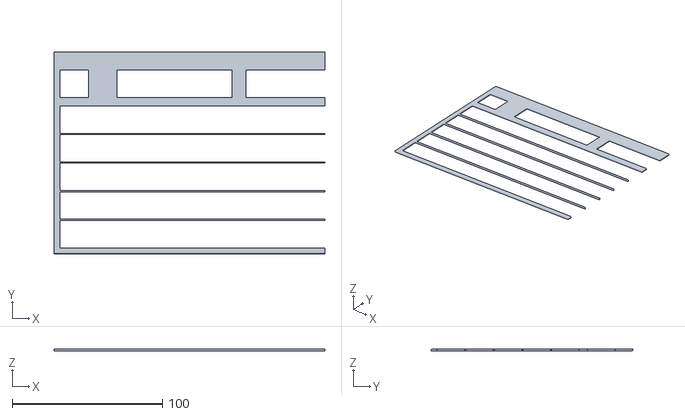
[picture p174: CAD file, 2026-10-31]
tkl/tkl9/case/cover-left.stl
180.2 x 134.1 x 1.20
