davidkellis/keyboards/tkl/tkl10/case-hidden-mounts/plate-upper-right.stl

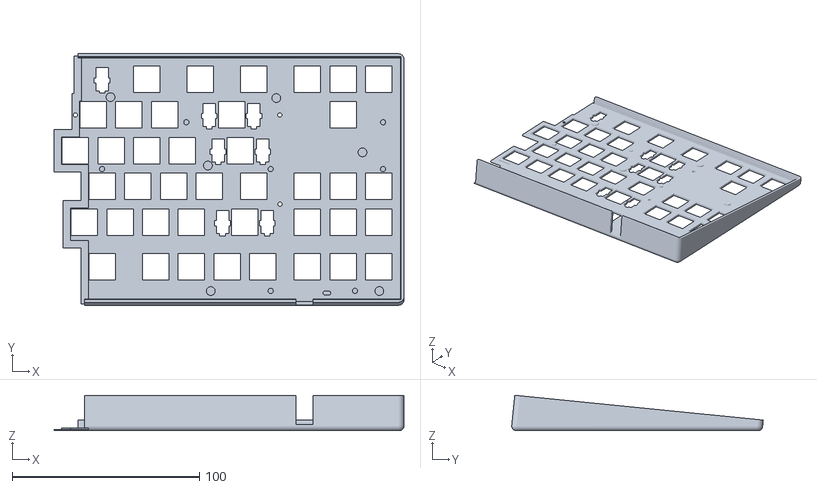
[picture p175: CAD file, 2026-10-31]
tkl/tkl10/case-hidden-mounts/plate-upper-right.stl
186.8 x 134.3 x 18.9
