davidkellis/keyboards/tkl/tkl10/case-raised-deck/prints/led-diffuser.stl

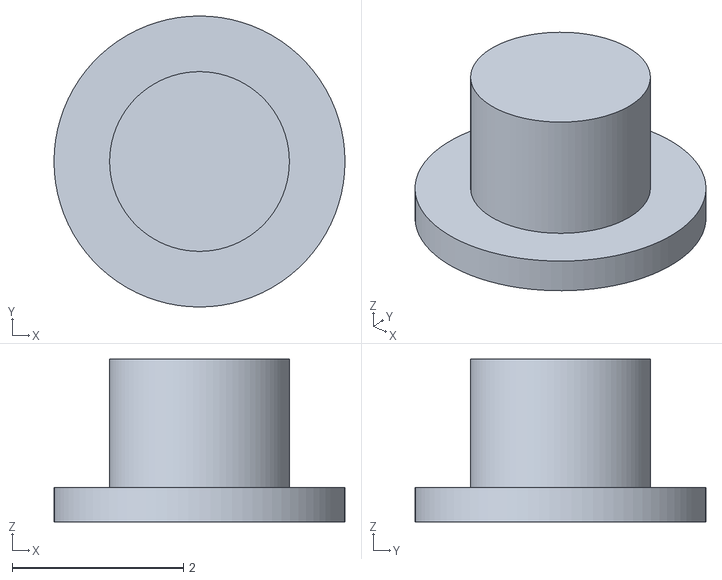
[picture p176: CAD file, 2026-10-31]
tkl/tkl10/case-raised-deck/prints/led-diffuser.stl
3.40 x 3.40 x 1.90
