davidkellis/keyboards/tkl/tkl10/case/fit-coupon-case.stl

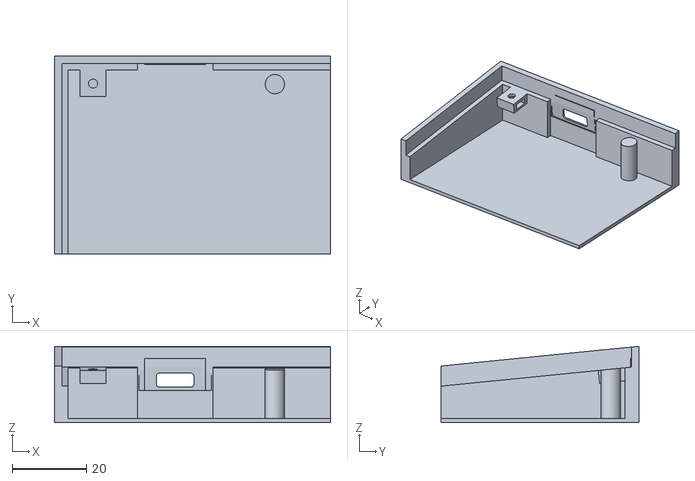
[picture p177: CAD file, 2026-10-31]
tkl/tkl10/case/fit-coupon-case.stl
74.4 x 53.3 x 20.6
