davidkellis/keyboards/tkl/tkl10/case/print-fit/fit-coupon-pcb-easy-fit.stl

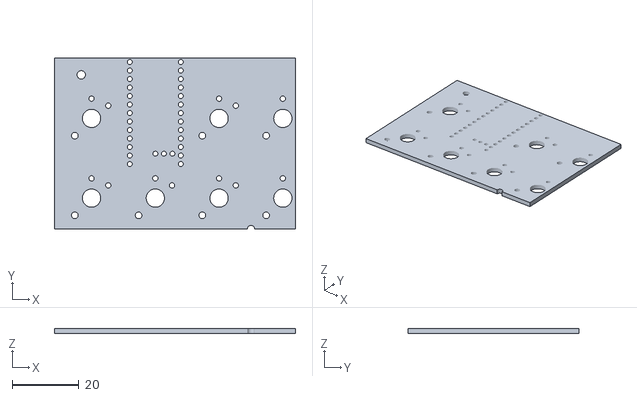
[picture p178: CAD file, 2026-10-31]
tkl/tkl10/case/print-fit/fit-coupon-pcb-easy-fit.stl
72.0 x 51.2 x 1.60
