davidkellis/keyboards/tkl/tkl10/render-keycaps-lighting/reference/glass-2.75u.stl

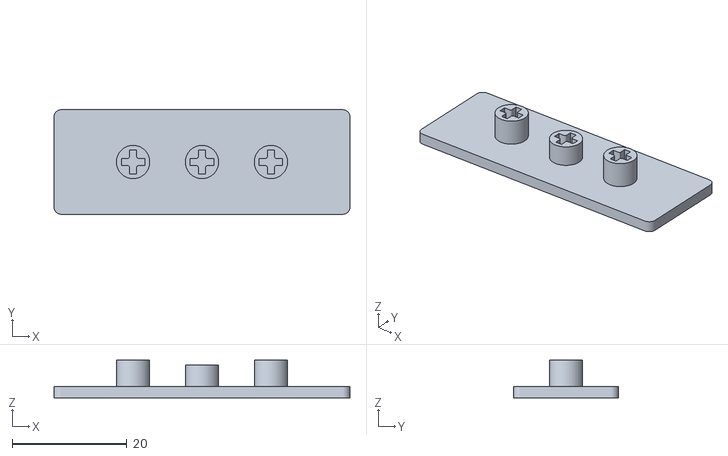
[picture p179: CAD file, 2026-10-31]
tkl/tkl10/render-keycaps-lighting/reference/glass-2.75u.stl
51.5 x 18.2 x 6.60
