davidkellis/keyboards/tkl/tkl8/case/stabilizer-test/2u-plate-1.5mm.stl

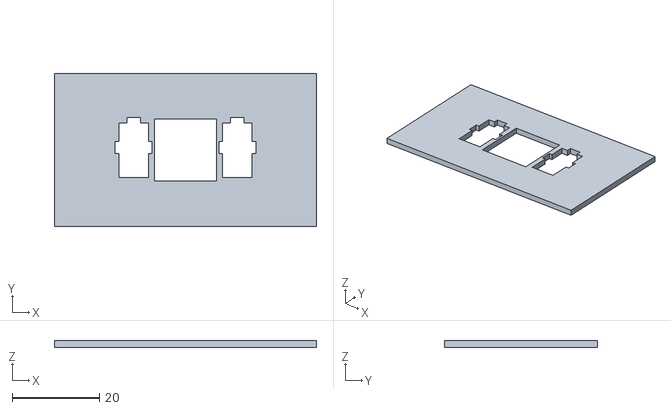
[picture p180: CAD file, 2026-10-31]
tkl/tkl8/case/stabilizer-test/2u-plate-1.5mm.stl
60.0 x 35.0 x 1.50
