davidkellis/keyboards/tkl/tkl9/case/cover-right.stl

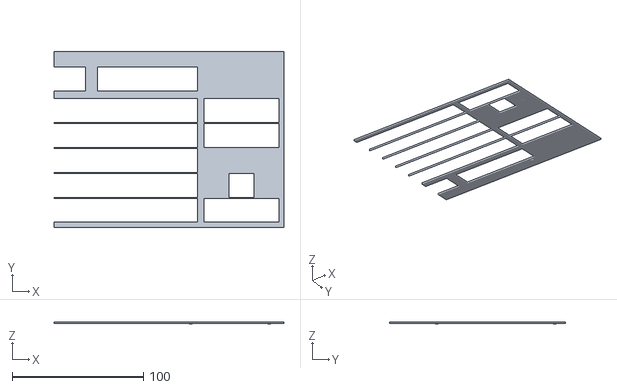
[picture p181: CAD file, 2026-10-31]
tkl/tkl9/case/cover-right.stl
175.4 x 134.1 x 1.60
