davidkellis/keyboards/tkl/tkl10/case-hidden-mounts/usb-coupon-bottom.stl

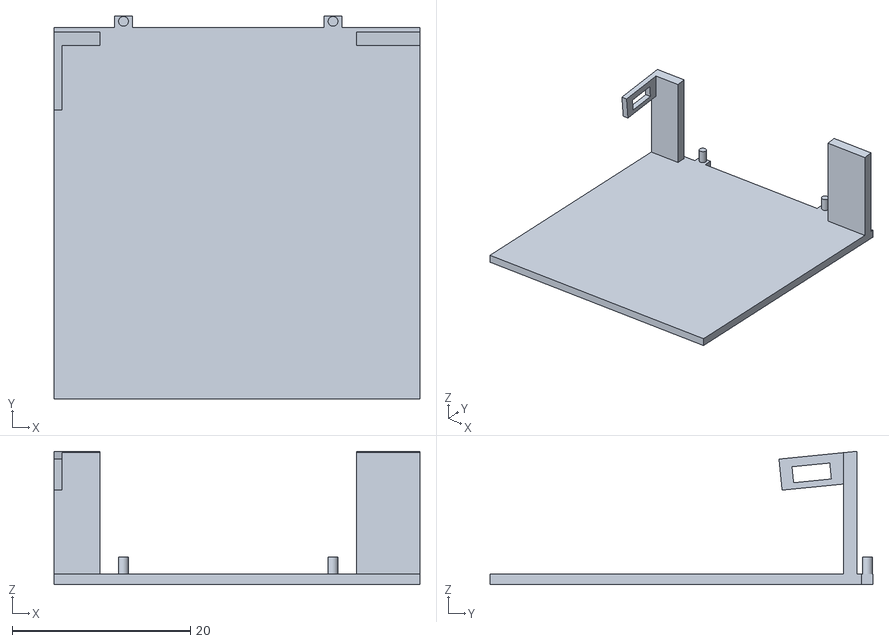
[picture p182: CAD file, 2026-10-31]
tkl/tkl10/case-hidden-mounts/usb-coupon-bottom.stl
41.0 x 43.0 x 15.0
