davidkellis/keyboards/tkl/tkl10/case-raised-deck/prints/case-bottom-right.stl

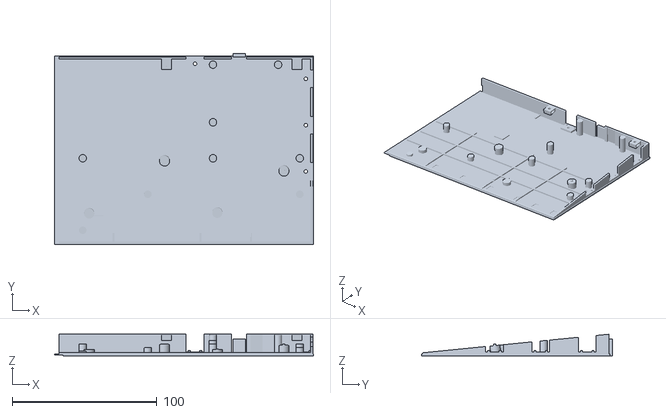
[picture p183: CAD file, 2026-10-31]
tkl/tkl10/case-raised-deck/prints/case-bottom-right.stl
179.0 x 131.7 x 15.0
