davidkellis/keyboards/tkl/tkl10/case/keycap-envelopes-left.stl

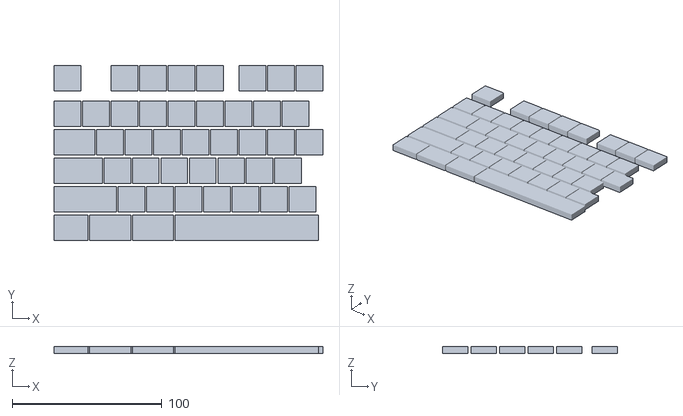
[picture p184: CAD file, 2026-10-31]
tkl/tkl10/case/keycap-envelopes-left.stl
179.9 x 117.0 x 5.00
