davidkellis/keyboards/tkl/tkl10/case/print-fit/rim-coupon-pcb-easy-fit.stl

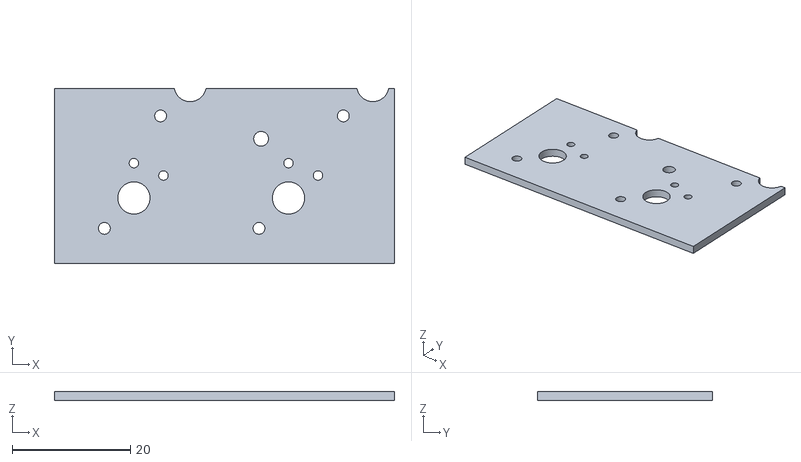
[picture p185: CAD file, 2026-10-31]
tkl/tkl10/case/print-fit/rim-coupon-pcb-easy-fit.stl
57.6 x 29.6 x 1.60
