davidkellis/keyboards/tkl/tkl9.1/case/upper-right.stl

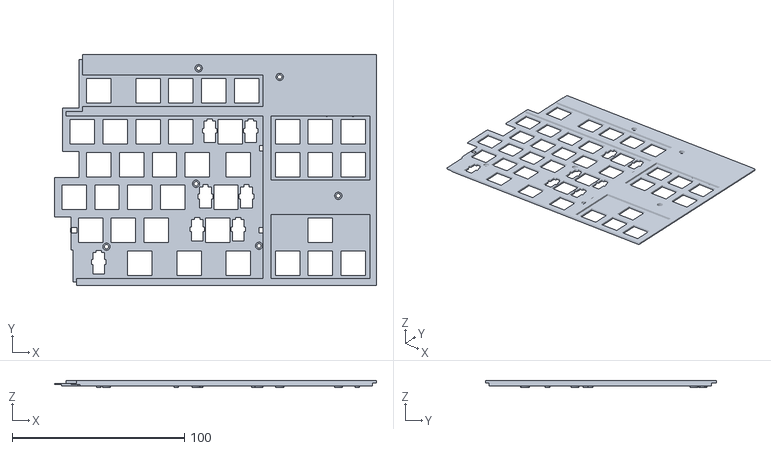
[picture p187: CAD file, 2026-10-31]
tkl/tkl9.1/case/upper-right.stl
186.8 x 134.1 x 3.80
