davidkellis/keyboards/tkl/tkl10/case-hidden-mounts/mount-coupon-bottom.stl

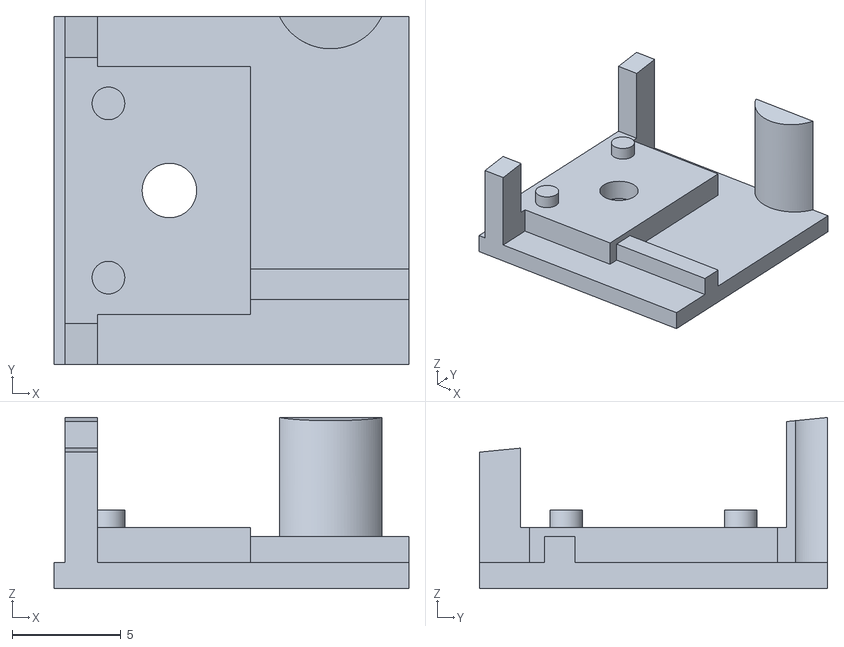
[picture p188: CAD file, 2026-10-31]
tkl/tkl10/case-hidden-mounts/mount-coupon-bottom.stl
16.3 x 16.0 x 7.86
