davidkellis/keyboards/tkl/tkl10/case/led-fit-coupon.stl

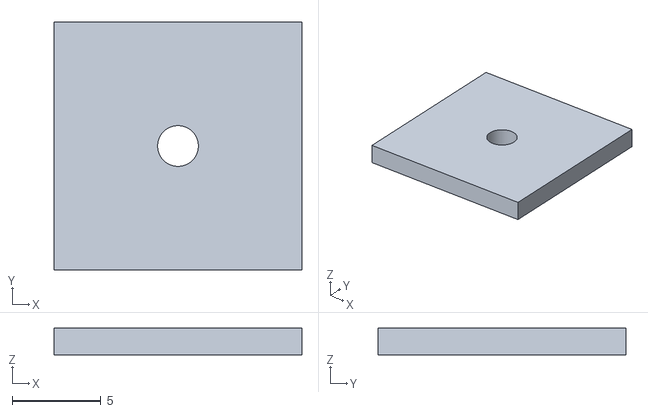
[picture p189: CAD file, 2026-10-31]
tkl/tkl10/case/led-fit-coupon.stl
14.0 x 14.0 x 1.50
