davidkellis/keyboards/tkl/tkl10/render-case-editions/reference/glass-1.25u.stl

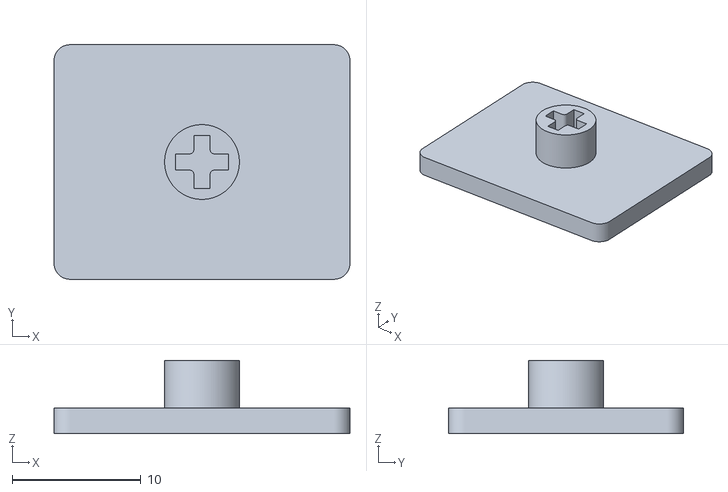
[picture p190: CAD file, 2026-10-31]
tkl/tkl10/render-case-editions/reference/glass-1.25u.stl
23.0 x 18.2 x 5.70
