davidkellis/keyboards/tkl/tkl10/case-hidden-mounts/usb-coupon-upper.stl

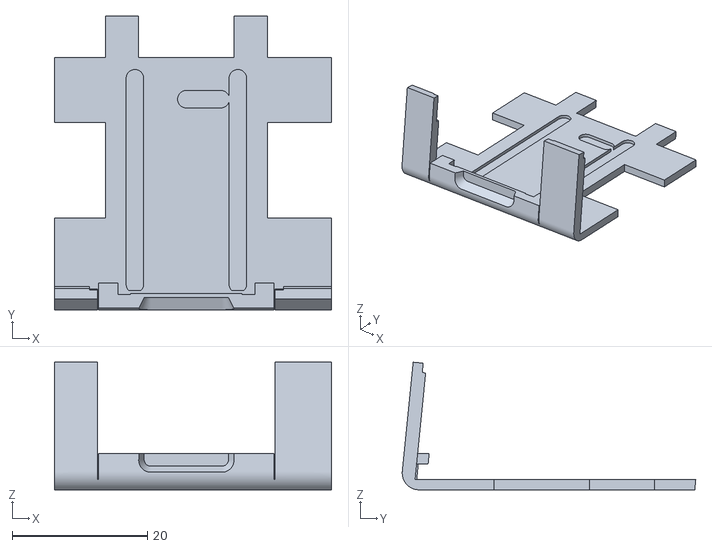
[picture p191: CAD file, 2026-10-31]
tkl/tkl10/case-hidden-mounts/usb-coupon-upper.stl
41.0 x 43.5 x 18.9
