davidkellis/keyboards/tkl/tkl10/render-case-editions/reference/flat-2.75u.3mf

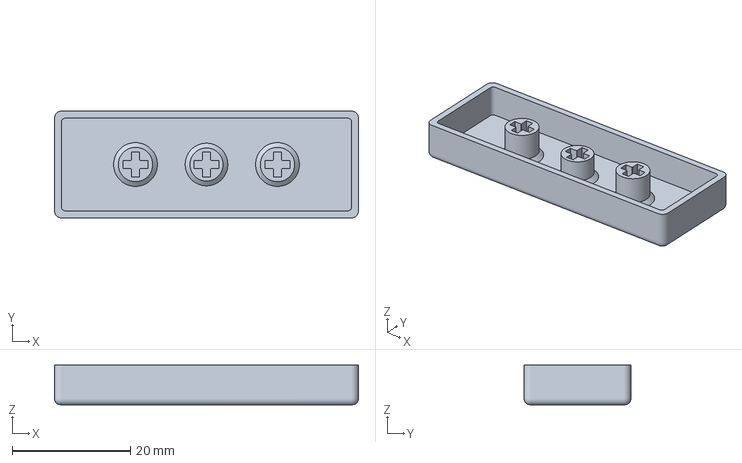
[picture p192: CAD file, 2026-10-31]
tkl/tkl10/render-case-editions/reference/flat-2.75u.3mf
51.4 x 18.0 x 6.70 mm
