davidkellis/keyboards/tkl/tkl10/render-keycaps-lighting/reference/flat-1.50u.3mf

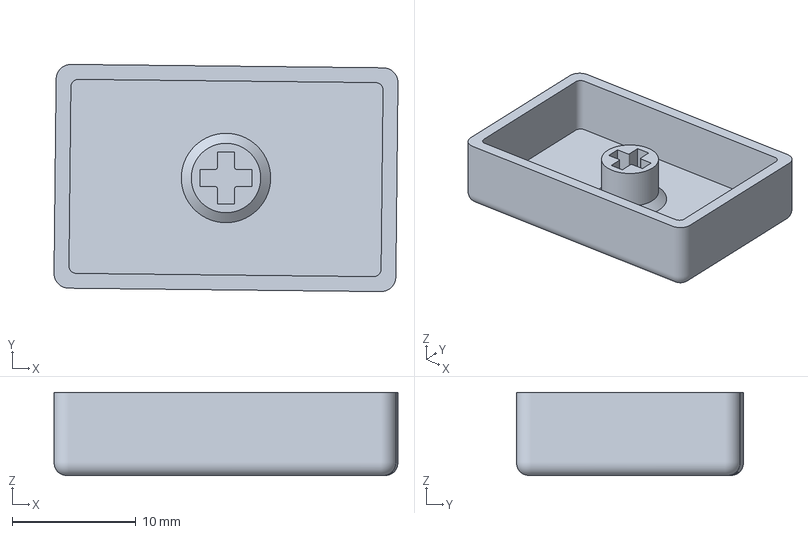
[picture p193: CAD file, 2026-10-31]
tkl/tkl10/render-keycaps-lighting/reference/flat-1.50u.3mf
27.7 x 18.3 x 6.70 mm
