davidkellis/keyboards/tkl/tkl9/case/plate-supported-left.stl

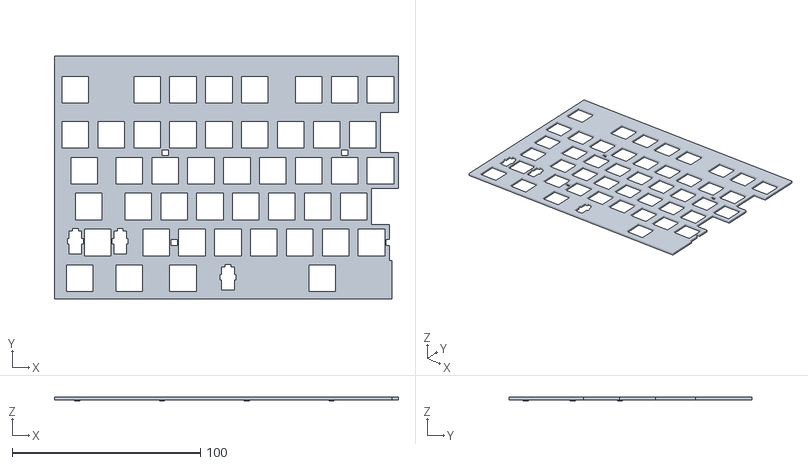
[picture p194: CAD file, 2026-10-31]
tkl/tkl9/case/plate-supported-left.stl
182.5 x 129.2 x 2.20
