davidkellis/keyboards/tkl/tkl10/render-case-editions/reference/glass-1.50u.stl

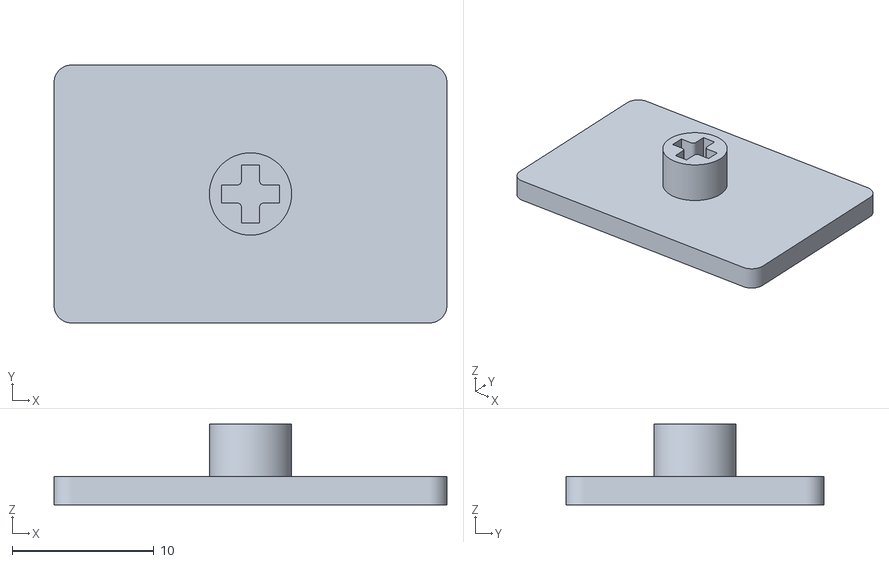
[picture p195: CAD file, 2026-10-31]
tkl/tkl10/render-case-editions/reference/glass-1.50u.stl
27.7 x 18.2 x 5.70
