davidkellis/keyboards/tkl/tkl9/case/plate-supported.step

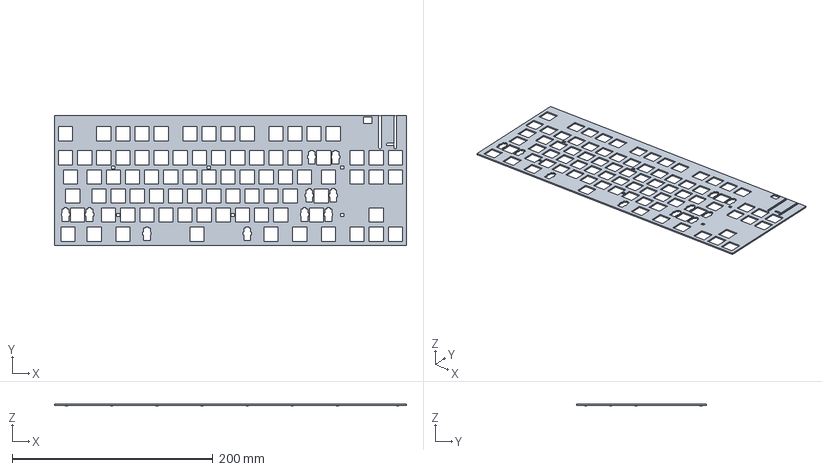
[picture p198: CAD file, 2026-10-31]
tkl/tkl9/case/plate-supported.step
350.8 x 129.2 x 2.20 mm
