davidkellis/keyboards/tkl/tkl10/case-raised-deck/prints/front-fit-coupon.stl

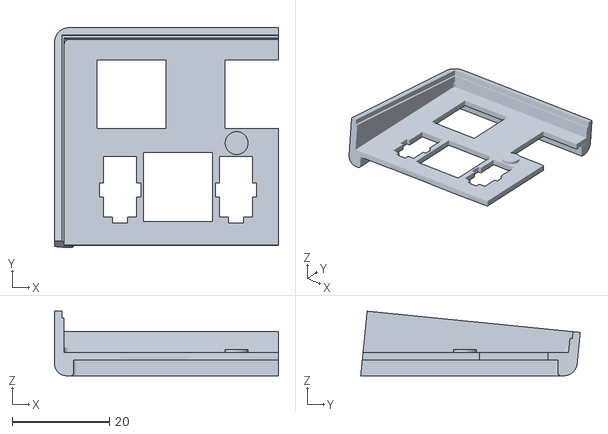
[picture p199: CAD file, 2026-10-31]
tkl/tkl10/case-raised-deck/prints/front-fit-coupon.stl
46.0 x 45.1 x 13.3
