davidkellis/keyboards/tkl/tkl8/case/stabilizer-test/spacebar-6.25u-pcb-for-1.6mm-plate.stl

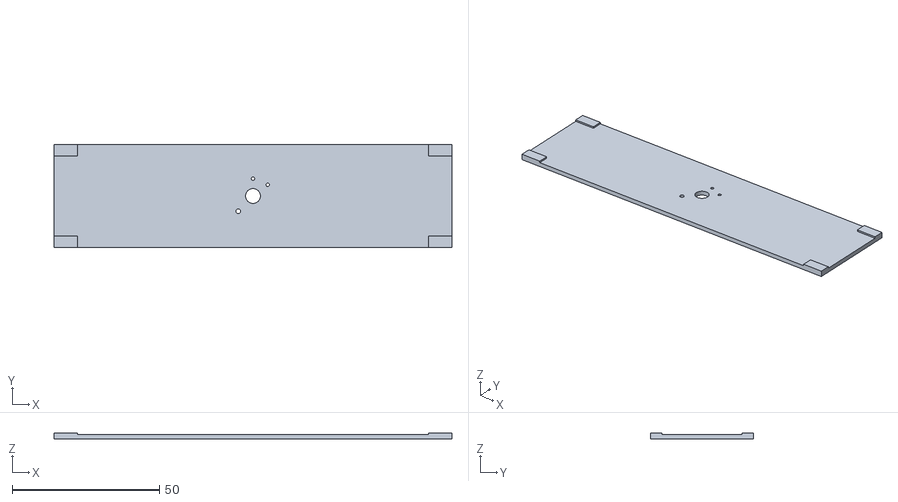
[picture p200: CAD file, 2026-10-31]
tkl/tkl8/case/stabilizer-test/spacebar-6.25u-pcb-for-1.6mm-plate.stl
135.0 x 35.0 x 2.20
