davidkellis/keyboards/tkl/tkl9.1/case/upper-split.step

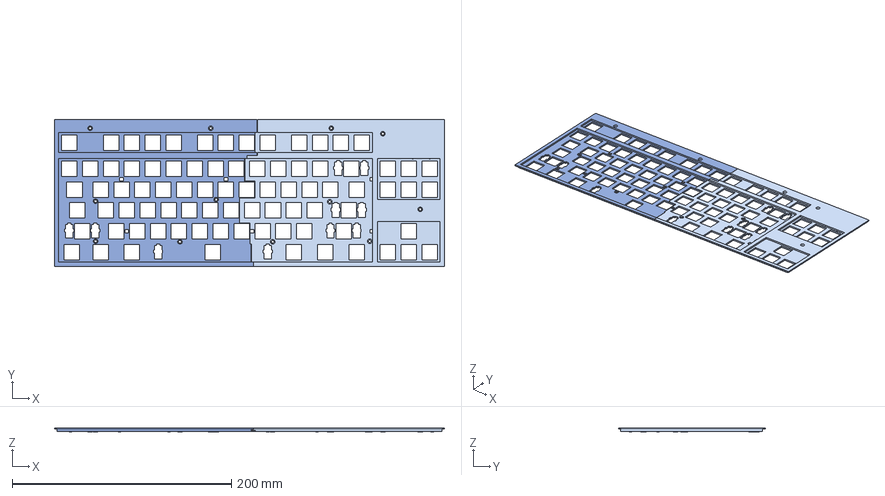
[picture p201: CAD file, 2026-10-31]
tkl/tkl9.1/case/upper-split.step
355.6 x 134.1 x 3.80 mm
left
right
