davidkellis/keyboards/tkl/tkl10/case-hidden-mounts/case-bottom-left.stl

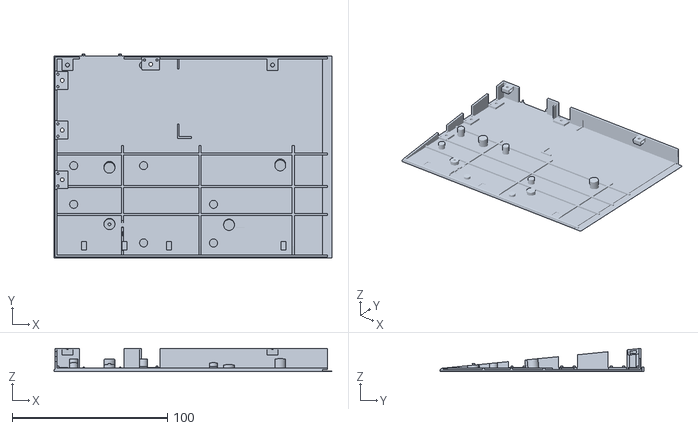
[picture p202: CAD file, 2026-10-31]
tkl/tkl10/case-hidden-mounts/case-bottom-left.stl
179.0 x 131.3 x 15.0
