davidkellis/keyboards/tkl/tkl10/case/mount-coupon-pcb.stl

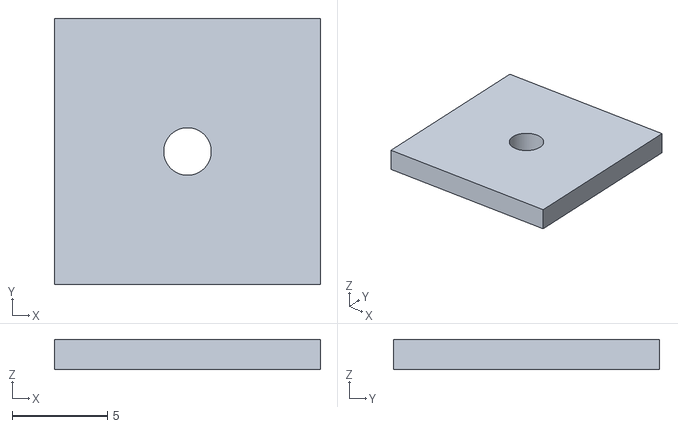
[picture p203: CAD file, 2026-10-31]
tkl/tkl10/case/mount-coupon-pcb.stl
14.0 x 14.0 x 1.60
