davidkellis/keyboards/tkl/tkl10/render-case-editions/reference/glass-1.75u.stl

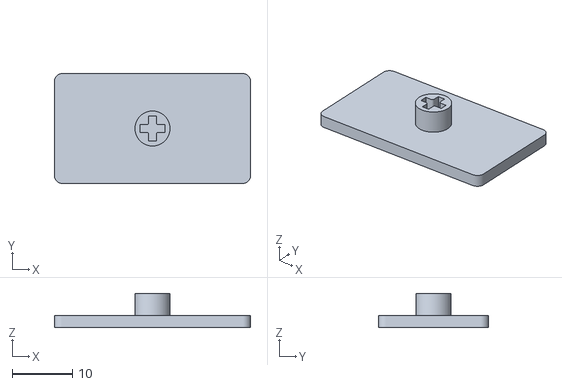
[picture p204: CAD file, 2026-10-31]
tkl/tkl10/render-case-editions/reference/glass-1.75u.stl
32.5 x 18.2 x 5.70
