davidkellis/keyboards/tkl/tkl10/case/case.scad

// Generated fit case; build_fit.py is the parametric source.
import("case.stl");
