davidkellis/keyboards/tkl/tkl10/case/module-envelopes.scad

// Design envelopes, not manufacturer CAD. Dimensions require measurement.
module module_envelopes() {
  // U1
  color([0.95,0.48,0.12]) translate([20.619999999999997,96.19,-6.0]) cube([19.000000000000007,33.0,5.0]);
  // USB_SOCKET
  color([0.95,0.78,0.18]) translate([25.369999999999997,129.19,-5.1]) cube([9.5,0.8400000000000034,3.2]);
  // USB_PLUG_EXTERNAL
  color([0.95,0.78,0.18]) translate([24.369999999999997,130.03,-6.8]) cube([11.5,17.0,6.6]);
}
