davidkellis/keyboards/tkl/tkl9.1/case/base-preview.scad

// Base with floor ribs, captive-nut mounts and recessed USB bezel.
color([0.45,0.60,0.74]) import("case.stl");
