davidkellis/keyboards/tkl/tkl9.1/case/upper-preview.scad

// Integrated plate and frame. No raised strips between typing rows.
color([0.45,0.60,0.74]) import("upper-integrated.stl");
