davidkellis/keyboards/tkl/tkl9.2/case/base-preview.scad

color([0.25,0.34,0.43]) import("case.stl");
