davidkellis/keyboards/tkl/tkl9.2/case/plate-preview.scad

color([0.56,0.66,0.77]) import("plate.stl");
