davidkellis/keyboards/(list of files, cad)

Other CAD files:
tkl/tkl10/case-raised-deck/reference/upper-navigation-assembly.stl
tkl/tkl10/case-hidden-mounts/reference/M5-carrier-assembly.stl
tkl/tkl10/case-hidden-mounts/reference/M4-carrier-assembly.stl
tkl/tkl10/case-hidden-mounts/reference/M6-carrier-assembly.stl
tkl/tkl10/case-hidden-mounts/reference/M3-carrier-assembly.stl
tkl/tkl10/case-hidden-mounts/reference/M8-carrier-assembly.stl
tkl/tkl10/case-hidden-mounts/reference/M2-carrier-assembly.stl
tkl/tkl10/case-hidden-mounts/reference/M1-carrier-assembly.stl
tkl/tkl10/case-hidden-mounts/plate-upper.stl
tkl/tkl10/lighting-engineering-study/coupons/guide-medium-perforated.dxf
tkl/tkl10/lighting-guide-12-study/coupons/guide-sparse-perforated.dxf
tkl/tkl11/case/acrylic-plate-trial.dxf
tkl/tkl11/reference/before-staggered-layout/case/acrylic-plate-trial.dxf
tkl/tkl10/lighting-engineering-study/coupons/guide-dense-perforated.dxf
tkl/tkl10/lighting-guide-12-study/coupons/guide-sparse-solid.dxf
tkl/tkl6/case/plate-laser.dxf
tkl/tkl10/case-raised-deck/prints/plate-upper-navigation.stl
tkl/tkl10/case/plate-left.stl
tkl/tkl10/lighting-engineering-study/coupons/guide-sparse-perforated.dxf
tkl/tkl10/lighting-guide-12-study/coupons/guide-medium-solid.dxf
tkl/tkl10/case-hidden-mounts/case-bottom.stl
tkl/tkl10/case-raised-deck/prints/usb-bezel.stl
tkl/tkl10/lighting-engineering-study/coupons/guide-sparse-solid.dxf
tkl/tkl10/lighting-guide-12-study/coupons/guide-medium-perforated.dxf
tkl/tkl10/lighting-engineering-study/coupons/opaque-output-mask.dxf
tkl/tkl10/lighting-guide-12-study/coupons/upper-mask-perforated.dxf
tkl/tkl10/lighting-engineering-study/coupons/guide-medium-solid.dxf
tkl/tkl10/lighting-guide-12-study/coupons/guide-dense-perforated.dxf
tkl/tkl10/case-raised-deck/prints/plate-upper.stl
tkl/tkl10/lighting-engineering-study/coupons/guide-dense-solid.dxf
tkl/tkl10/lighting-guide-12-study/coupons/upper-mask-solid.dxf
tkl/tkl10/case/pcb-bare.step
tkl/tkl10/lighting-guide-12-study/coupons/guide-dense-solid.dxf
tkl/tkl10/case/plate-right.stl
tkl/tkl10/case-raised-deck/prints/case-bottom.stl
tkl/tkl9.2/case/assembled-exploded.scad
tkl/tkl9.2/case/assembled-preview.scad
tkl/tkl10/case-hidden-mounts/edge-coupon-upper.stl
tkl/tkl10/case-hidden-mounts/mount-coupon-pcb.stl
tkl/tkl10/case-hidden-mounts/mount-coupon-upper.stl
tkl/tkl10/case-hidden-mounts/nut-carrier.stl
tkl/tkl10/case-hidden-mounts/plate-upper-left.stl
tkl/tkl10/case-hidden-mounts/reference/M1-nut-assembly.stl
tkl/tkl10/case-hidden-mounts/reference/M1-screw-assembly.stl
tkl/tkl10/case-hidden-mounts/reference/M2-nut-assembly.stl
tkl/tkl10/case-hidden-mounts/reference/M2-screw-assembly.stl
tkl/tkl10/case-hidden-mounts/reference/M3-nut-assembly.stl
tkl/tkl10/case-hidden-mounts/reference/M3-screw-assembly.stl
tkl/tkl10/case-hidden-mounts/reference/M4-nut-assembly.stl
tkl/tkl10/case-hidden-mounts/reference/M4-screw-assembly.stl
tkl/tkl10/case-hidden-mounts/reference/M5-nut-assembly.stl
tkl/tkl10/case-hidden-mounts/reference/M5-screw-assembly.stl
tkl/tkl10/case-hidden-mounts/reference/M6-nut-assembly.stl
tkl/tkl10/case-hidden-mounts/reference/M6-screw-assembly.stl
tkl/tkl10/case-hidden-mounts/reference/M7-nut-assembly.stl
tkl/tkl10/case-hidden-mounts/reference/M7-screw-assembly.stl
tkl/tkl10/case-hidden-mounts/reference/M8-nut-assembly.stl
tkl/tkl10/case-hidden-mounts/reference/M8-screw-assembly.stl
tkl/tkl10/case-hidden-mounts/usb-bezel.stl
tkl/tkl10/case-raised-deck/prints/nut-carrier.stl
tkl/tkl10/case-raised-deck/prints/plate-upper-navigation-left.stl
tkl/tkl10/case-raised-deck/prints/plate-upper-right.stl
tkl/tkl10/case-raised-deck/prints/usb-fit-coupon-upper.stl
tkl/tkl10/case/base-split.step
tkl/tkl10/case/battery-pack-max-gauge-149x46x5.5.stl
tkl/tkl10/case/battery-reserve-gauge-155x50x6.3.stl
tkl/tkl10/case/case-right.stl
tkl/tkl10/case/case.stl
tkl/tkl10/case/fit-coupon-upper.stl
tkl/tkl10/case/module-gap-gauge.stl
tkl/tkl10/case/mount-coupon-case.stl
tkl/tkl10/case/mount-coupon-upper.stl
tkl/tkl10/case/pcb-populated-left.stl
tkl/tkl10/case/pcb-populated-right.stl
tkl/tkl10/case/pcb-populated.step
tkl/tkl10/case/pcb-populated.stl
tkl/tkl10/case/plate-diagnostic.dxf
tkl/tkl10/case/plate-split.step
tkl/tkl10/case/plate.step
tkl/tkl10/case/plate.stl
tkl/tkl10/case/rim-coupon-case.stl
tkl/tkl10/case/rim-coupon-plate.stl
tkl/tkl10/case/u1-envelope.stl
tkl/tkl10/case/usb_plug_external-envelope.stl
tkl/tkl10/case/usb_socket-envelope.stl
tkl/tkl10/render-case-editions/reference/flat-2.25u.3mf
tkl/tkl10/render-case-editions/reference/glass-2.25u.stl
tkl/tkl10/render-case-editions/reference/glass-6.25u.stl
tkl/tkl10/render-keycaps-lighting/reference/flat-2.25u.3mf
tkl/tkl10/render-keycaps-lighting/reference/glass-2.25u.stl
tkl/tkl10/render-keycaps-lighting/reference/glass-6.25u.stl
tkl/tkl8/case/stabilizer-test/2u-pcb-diagnostic-relief.stl
tkl/tkl8/case/stabilizer-test/2u-pcb-for-1.2mm-plate.stl
tkl/tkl8/case/stabilizer-test/2u-plate-1.2mm.stl
tkl/tkl8/case/stabilizer-test/pcb-as-mounting-plate-1.6mm.stl
tkl/tkl8/case/stabilizer-test/pcb-with-diagnostic-relief.stl
tkl/tkl8/case/stabilizer-test/plate-1.2mm.stl
tkl/tkl8/case/stabilizer-test/spacebar-6.25u-pcb-diagnostic-relief.stl
tkl/tkl8/case/stabilizer-test/spacebar-6.25u-pcb-for-1.2mm-plate.stl
tkl/tkl8/case/stabilizer-test/spacebar-6.25u-plate-1.5mm.stl
tkl/tkl9.1/case/upper-integrated.stl
tkl/tkl9/case/fit-coupon-cover.stl
tkl/tkl9/case/fit-coupon-plate.stl
tkl/tkl9/case/plate-flat-1.5mm.stl
tkl/tkl9/case/plate-supported.stl
