davidkellis/keyboards/tkl/tkl7.3/manufacturing/fabrication-estimate-six-layer-osp.txt

24
SMT

Holiday Notice: JLCPCB factories will be closed on Sep. 25, Sep. 27 & Oct. 1–4. Please order 3–5 days early to prevent delays. Learn more>

4
USD 
My Account 

Select Product

Standard PCB/PCBA

Advanced PCB/PCBA

SMT Stencil

Flex Heater

Mechatronic Parts

3D Printing

CNC Machining

PCB Layout

Sheet Metal

Online PCB Quote

| Support POFV

Instructions For Ordering>
Upload History 
 Add gerber file
Only accept zip or rar, Max 100 MB, View example >
 All uploads are secure and confidential.
Base Material
FR-4
Flex
Aluminum
Copper Core
Rogers
PTFE Teflon
HDI
Layers
124
High Precision PCB
6 
8
10
12
14
16
Dimensions
 *  
PCB Qty
5
Product Type
Industrial/Consumer electronicsAerospaceMedical
PCB Specifications
Different Design
1 234 
Delivery Format
Single PCB Panel by Customer Panel by JLCPCB
PCB Thickness
0.4mm0.6mm0.8mm1.0mm1.2mm1.6mm2.0mm
PCB Color
Green
 
Purple
 
Red
 
Yellow
 
Blue
 
White
 
Black
Silkscreen
White
Material Type
FR4 TG135FR4 TG155Nan Ya NP-140FNan Ya NP-155FKB-6165 - TG155S1000H TG155Shengyi S1000-2M - TG170
Surface Finish
OSP
New
 ENIG HASL(with lead) LeadFree HASL
High-spec Options
Outer Copper Weight
1 oz2 oz
Inner Copper Weight
0.5 oz1 oz2 oz
Specify Stackup
No Yes Impedance calculator >
Layer Stackup
No requirementJLC06161H-3313JLC06161H-7628JLC06161H-7628DJLC06161H-1080JLC06161H-2116AJLC06161H-1080AJLC06161H-3313CJLC06161H-1080BJLC06161H-3313EJLC06161H-2116BJLC06161H-2116JLC06161H-7628BJLC06161H-3313DJLC06161H-2116CJLC06161H-7628A 
View Stackup
Impedance Control
No requirement±10% (±5Ω if value≤50Ω)
Via Covering
TentedEpoxy Filled & UntentedPluggedEpoxy Filled & CappedCopper paste Filled & Capped
Min via hole size/diameter
0.3mm/(0.4/0.45mm)0.25mm/(0.35/0.4mm)0.2mm/(0.3/0.35mm)0.15mm/(0.25/0.3mm)0.1mm/(0.2/0.25mm)
Board Outline Tolerance
±0.2mm(Regular)±0.1mm(Precision)
Confirm Production file
NoYes
Mark on PCB
Remove Mark2D barcode (Serial Number)
Electrical Test
Flying Probe Fully Test
Gold Fingers
No Yes
Castellated Holes
No Yes
Press-Fit Hole
NoYes (Tolerance +/-0.05mm)
Edge Plating
NoYes
Blind Slots
NoYes
UL Marking
NoYes (Any Position)Yes (Specify Position)
Backdrill
NoYes
Humidity Indicator Card
NoYes
Advanced Options
PCB Remark 
PCB Assembly
 Assembly cost starting from $0 with coupon>
Stencil
Stencil Order Guide>
Order together with PCB
Charge Details
Engineering fee
$33.00
Via Covering
$0.00
Stackup fee
$33.08
Surface Finish
$0.00
Board
$31.50
PCB Build Time 
 8-9 days
$0.00
Calculated Price
$97.58

Additional charges may apply for special cases

Order on JLCONE Desktop: Save $1–$20 Per Order
SAVE TO CART
Shipping Estimate
$29.69
DHL Express (DDP)
2-4 business days
Weight 
0.98kg
Coupons 
Save $30.00Save $20.00 
Online Chat >
Chat with our live agent for fast reply.
Mon-Fri: 24 hours, Sat: 9am-6pm, GMT+8
Email Us >
Contact us at supportjlcpcb.com
Typically reply within hours.
Help Center >
Get instant answers.
24/7 Available.
PCB Service
FR-4 PCBs
Flexible PCBs
Metal Core PCBs
High-Frequency PCBs
PCBA Service
PCB Layout
SMT Stencil
Flex Heater
Support
Help Center
Contact Us
Community
Shipping Guide
Payment Methods
How to Order
How to Track
After-Sales Service
Blog
Company
About Us
Quality Assurance
How We Work
Certifications
Security
Environment
JLCAPI
News
Cooperation
Electronics
EasyEDA
JLCPCB
JLCDFM
LCSC
OSHWLAB
Mechanical
JLC3DP
JLCCNC
JLCMC
Order on JLCONE Desktop, Save $1–$20 Every Time
Windows
MAC
Android
IOS
CONNECT WITH US
© 2026 JLCPCB.COM All Rights Reserved.
Privacy Policy
Terms & Conditions
Cookies Policy
Do Not Sell or Share My Personal Information
