davidkellis/keyboards/tkl/tkl7.4/manufacturing/fabrication-estimate-four-layer-osp.txt

24
SMT

Holiday Notice: JLCPCB factories will be closed on Sep. 25, Sep. 27 & Oct. 1–4. Please order 3–5 days early to prevent delays. Learn more>

4
USD
My Account

Select Product

Standard PCB/PCBA

Advanced PCB/PCBA

SMT Stencil

Flex Heater

Mechatronic Parts

3D Printing

CNC Machining

PCB Layout

Sheet Metal

Online PCB Quote
Instructions For Ordering>
Upload History
 Add gerber file
Only accept zip or rar, Max 100 MB, View example >
 All uploads are secure and confidential.
Base Material
FR-4
Flex
Aluminum
Copper Core
Rogers
PTFE Teflon
HDI
Layers
124
High Precision PCB
6
8
10
12
14
16
Dimensions
 *
PCB Qty
5
Product Type
Industrial/Consumer electronicsAerospaceMedical
PCB Specifications
Different Design
1 234
Delivery Format
Single PCB Panel by Customer Panel by JLCPCB
PCB Thickness
0.4mm0.6mm0.8mm1.0mm1.2mm1.6mm2.0mm
PCB Color
Green

Purple

Red

Yellow

Blue

White

Black
Silkscreen
White
Material Type
FR4 TG135FR4 TG155Nan Ya NP-140FKB6164 - TG135Nan Ya NP-155FKB-6165 - TG155S1141 TG140S1000H TG155
Surface Finish
OSP
New
 HASL(with lead) LeadFree HASL ENIG
High-spec Options
Outer Copper Weight
1 oz2 oz
Inner Copper Weight
0.5 oz1 oz2 oz
Specify Stackup
No Yes Impedance calculator >
Layer Stackup
No requirementJLC04161H-7628JLC04161H-3313JLC04161H-1080JLC04161H-7628AJLC04161H-3313AJLC04161H-1080AJLC04161H-7628BJLC04161H-2116AJLC04161H-2116BJLC04161H-2116CJLC04161H-7628GJLC04161H-2116JLC04161H-7628EJLC04161H-2116DJLC04161H-7628FJLC04161H-2116EJLC04161H-7628C
View Stackup
Impedance Control
No requirement±10% (±5Ω if value≤50Ω)
Via Covering
PluggedUntentedEpoxy Filled & CappedCopper paste Filled & CappedTented
Via Plating Method
Not SpecifiedConductive AdhesiveHorizontal Electroless Copper Plating
Epoxy-filled or copper-paste-filled vias require Horizontal Electroless Copper Plating.
Min via hole size/diameter
0.3mm/(0.4/0.45mm)0.25mm/(0.35/0.4mm)0.2mm/(0.3/0.35mm)0.15mm/(0.25/0.3mm)0.1mm/(0.2/0.25mm)
Board Outline Tolerance
±0.2mm(Regular)±0.1mm(Precision)
Confirm Production file
NoYes
Mark on PCB
Remove Mark2D barcode (Serial Number)
Electrical Test
Flying Probe Fully Test
Gold Fingers
No Yes
Castellated Holes
No Yes
Press-Fit Hole
NoYes (Tolerance +/-0.05mm)
Edge Plating
NoYes
Blind Slots
NoYes
UL Marking
NoYes (Any Position)Yes (Specify Position)
Backdrill
NoYes
Humidity Indicator Card
NoYes
Advanced Options
PCB Remark
PCB Assembly
 Assembly cost starting from $0 with coupon>
Stencil
Stencil Order Guide>
Order together with PCB
Charge Details
Engineering fee
$25.00
Via Covering
$22.60
Surface Finish
$0.00
Board
$30.10
Via Plating Method
$3.91
PCB Build Time
 3-4 days
$0.00
 3 days PCBA Only
$0.00
Calculated Price
$81.61

Additional charges may apply for special cases

Order on JLCONE Desktop: Save $1–$20 Per Order
SAVE TO CART
Shipping Estimate
$29.69
DHL Express (DDP)
2-4 business days
Weight
0.98kg
Coupons
Save $30.00Save $20.00
Online Chat >
Chat with our live agent for fast reply.
Mon-Fri: 24 hours, Sat: 9am-6pm, GMT+8
Email Us >
Contact us at supportjlcpcb.com
Typically reply within hours.
Help Center >
Get instant answers.
24/7 Available.
PCB Service
FR-4 PCBs
Flexible PCBs
Metal Core PCBs
High-Frequency PCBs
PCBA Service
PCB Layout
SMT Stencil
Flex Heater
Support
Help Center
Contact Us
Community
Shipping Guide
Payment Methods
How to Order
How to Track
After-Sales Service
Blog
Company
About Us
Quality Assurance
How We Work
Certifications
Security
Environment
JLCAPI
News
Cooperation
Electronics
EasyEDA
JLCPCB
JLCDFM
LCSC
OSHWLAB
Mechanical
JLC3DP
JLCCNC
JLCMC
Order on JLCONE Desktop, Save $1–$20 Every Time
Windows
MAC
Android
IOS
CONNECT WITH US
© 2026 JLCPCB.COM All Rights Reserved.
Privacy Policy
Terms & Conditions
Cookies Policy
Do Not Sell or Share My Personal Information
