davidkellis/keyboards/tkl/tkl7.4/manufacturing/JLC_QUOTE_v7.4_2026-09-25.md

# JLCPCB v7.4 quote — 2026-09-25

**Five assembled v7.4 boards: $300.22 estimated delivered, about $60.04 each.**
This includes the displayed DHL DDP shipping estimate and $3.31 rail removal,
before tax, final shipping adjustment or engineering/fixture charges after review.
The unpaid quote is saved in the signed-in cart. Nothing has been purchased,
inventory is not reserved, and production has not been released.

| USD for five boards | Cost |
| --- | ---: |
| Four-layer OSP fabrication, including file confirmation | $82.66 |
| Components and Standard bottom-side assembly | $168.88 |
| DHL Express (DDP) shipping estimate | $45.37 |
| Rail removal, charged after review | $3.31 |
| **Comparable estimated total** | **$300.22** |

The cart displays **$296.91** because its subtotal excludes the $3.31 advanced
rail-removal charge. The assembly breakdown includes $70.82 in components,
$25.75 setup, $8.27 stencil, $46.50 feeder loading, $4.21 SMT assembly and
other confirmation, THT handling, X-ray and packaging fees. All 31 exact BOM
groups and 142 placements per board are selected, including J3 USB. There
were no inventory shortfalls shown when checked.

This is **$22.95 below v7.2's comparable $323.17 estimate**: $22.20 from OSP
and $0.75 from the controller ordering-code change after quotation rounding.

## Cheapest complete option checked

JLC disables **Economic** after applying this board's configured PCB
specifications. The UI tooltip says those PCB specs are unsupported; it does
not identify the individual limiting setting. No parts or via treatment were
removed to force eligibility. Standard is the lowest complete service quote
obtained for this configuration; see [eligibility evidence](quote-v7.4-2026-09-25/economic-eligibility.json).

Shipping was checked with **only the v7.4 batch selected**. DHL DDP is $45.37,
UPS DDP $46.11 and FedEx DDP $75.18. The lower-cost postal/direct-line service
is unavailable for this shipment. The $2 "My carrier account" entries are
handling charges, not inclusive freight prices. Final shipping is confirmed
at checkout; no checkout or payment was performed.

Reverse-LED support-fixture review was explicitly requested in the assembly
remark, and that remark is still **Quote after review**. No additional fixture
price is included yet. This is an estimate, not a firm final production bill.

## Saved files and configuration

PCB reference **Y8-5054573A**; PCBA reference **SMT026092563335-5054573A**.
The quote uses four layers, JLC04161H-7628, nominal 1.6 mm, OSP, green/white,
0.30 mm minimum vias, epoxy fill/cap and ordinary flying-probe electrical test.
Lead-free high-temperature SMT and lead-free THT solder are explicitly specified.
Manual production-file and parts-placement confirmation remain enabled.
Factory pin/polarity approval and the existing physical prototype tests remain pending.

The BOM excludes the 86 user-installed switches, battery, external antenna,
NTC lead, keycaps, stabilizers, case and firmware. These are assembled electronics
PCBs, not complete keyboards.

See [the quote record](quote-v7.4-2026-09-25/record.json),
[complete charge breakdown](quote-v7.4-2026-09-25/final-quote.txt),
[saved PCB settings](quote-v7.4-2026-09-25/saved-pcb-details.txt),
[saved assembly settings](quote-v7.4-2026-09-25/saved-pcba-details.txt),
[BOM matches](quote-v7.4-2026-09-25/bom-matches.json), and
[shipping options](quote-v7.4-2026-09-25/shipping-options.json).
Use the [v7.4 Gerber ZIP](tkl-v7.4-gerbers.zip), [BOM](jlcpcb-bom.csv) and
[CPL](jlcpcb-cpl.csv) together. Older revisions and their saved quotes are unchanged.
