davidkellis/keyboards/tkl/tkl8/manufacturing/JLC_QUOTE_2026-09-25.md

# Saved v8.1 JLCPCB quote — 2026-09-25

Configured through the signed-in JLCPCB browser UI and saved to cart; not
checked out, paid or released to production.

- Cart: https://cart.jlcpcb.com/shopcart/cart
- Draft: https://cart.jlcpcb.com/smt-order/?pcbFileNo=REDACTED
- Cart item: `tkl-v8.1-gerbers_Y3`, PCB reference `Y3-5054573A`.
- Assembly reference: `SMT026092562919-5054573A`.
- Quantity: five fabricated and five assembled boards.

## Price observed

| Item | USD |
| --- | ---: |
| PCB fabrication | 151.75 |
| Standard assembly, including components | 248.11 |
| Displayed total | 399.86 |
| Rail removal, excluded from displayed total until review | 3.31 |
| Comparable total including rail removal | 403.17 |
| Cart shipping estimate | 45.37 |
| Estimated total with shipping and rail removal | 448.54 |
| Original v8 quote including rail removal | 425.77 |
| Confirmed quote reduction | 22.60 |

The saved cart shows $445.23 with estimated shipping, excluding the $3.31
rail removal charge. Tax and any assembly-remark charge determined after
review are additional; shipping is an estimate. The $248.11 assembly subtotal includes $99.49 components,
$51.50 setup, $46.50 feeders, $16.54 stencil, $16.54 fixture, $8.25 X-ray,
$4.21 SMT placement, $3.61 hand soldering, $0.36 manual assembly, $0.45
placement confirmation, $0.51 packaging and $0.15 special handling.

The actual PCB minimum via is 0.20 mm drill / 0.45 mm pad. The generic
0.20 mm form option still adds $22.60 and forces $19.77 Kelvin testing.
The saved PCB remark requests review of these fees; no additional discount
is confirmed. Selecting a false 0.30 mm minimum was not used to lower pricing.

## Saved fabrication settings

- FR-4 Tg155, four layers, 1.6 mm, green mask / white silkscreen.
- Original board 350.76 × 129.19 mm; 350.76 × 139.19 mm including JLC rails.
- Stack JLC04161H-7628; 1 oz outer / 0.5 oz inner copper.
- ENIG 1 microinch; Epoxy Filled & Capped vias.
- Horizontal Electroless Copper Plating, required by the form for filled vias.
- Generic minimum-via button `0.2mm/(0.3/0.35mm)`; actual pad size in remark.
- Full flying-probe electrical test and required Kelvin test.
- Regular ±0.2 mm outline tolerance, Remove Mark, normal production time.
- Production-file confirmation enabled; automatic confirmation disabled.
- Impedance control not requested: USB/RF performance remains a bench hold.

Saved PCB remark:

> V8.1: min via drill 0.20mm/pad 0.45mm. Apply published multilayer no-surcharge rule; review Kelvin fee. Epoxy fill/cap all 0.20/0.305mm vias, not component holes. Stack JLC04161H-7628.

## Assembly and uploaded files

- `tkl-v8.1-gerbers.zip`, `jlcpcb-bom.csv`, `jlcpcb-cpl.csv` from this directory.
- Standard PCBA, both sides, five boards, JLC-added rails/fiducials.
- All 31 BOM groups matched the specified MPN and LCSC codes and were selected;
  no shortage was shown at quote time. J3 was explicitly included.
- 142 fitted parts per board: six top LEDs, 134 bottom SMT parts and two
  bottom through-hole JST connectors. Stock and prices can change.
- C14/C15/C22 use Walsin 0603B105K160CT / C108463.
- BAT46W-7-F / C83152 diodes retained; J3 C2894897 retained with $0.03 per-board
  special handling. No unverified component substitutions.
- Top and bottom placement overviews inspected for side and gross alignment.
  No manual position/rotation edits. These overviews do not constitute final
  pin-by-pin orientation approval.
- Parts-placement confirmation enabled; automatic confirmation disabled.
- Depanel/rail removal enabled; cheapest 5–6 day assembly option selected.
- Assembly remark enabled, with `assembly-top.pdf` and `assembly-bottom.pdf`
  attached. No separate stencil purchase or expedited build.
- Product description: Office Appliance and Accessories / Keyboard — HS 847330.

Saved assembly remark:

> TKL v8.1: 6 LEDs on TOP; 134 SMT parts and J1/J5 THT connectors on BOTTOM. Insert J1/J5 from bottom. Check U1/U2 pin 1, diode/LED polarity and USB/power-switch orientation against attached drawings. X-ray U1/U2 exposed-pad joints. Remove added edge rails before delivery. Switches, battery, antenna and firmware excluded. Quote/prototype only; production requires explicit confirmation after fit review.

## Remaining production holds

This is a prototype quote, not a validated working keyboard. Choc V2 switch,
plate-mount stabilizer and low-profile keycap fit/travel still need physical
verification. Battery selection and temperature sensing, firmware/bring-up,
USB/RF bench tests and final factory placement review remain open. The BOM
does not supply switches, keycaps, case, battery, antenna or firmware.

Configuration and price evidence is retained in the project's
`manufacturing/quote-2026-09-25/` directory (outside the supplier handoff ZIP). The
browser window remains on the saved cart for the user to review.
