davidkellis/keyboards/tkl/tkl7/manufacturing/quote-2026-09-25/shipping-options.txt

United States Of America
	Shipping Method	Costs 	Delivery Time	Rating	Restriction	
	
UPS Express Saver(DDP)
	
$46.11
	
2-4 business days
	
--
	
≤10000kg
≤270cm

DHL Express (DDP)
	
$45.37
	
2-4 business days
	
--
	
≤10000kg
≤295x195cm

DHL Express
	
$45.37
	
2-4 business days
	
Details >
	
≤10000kg
≤295x195cm

FedEx Express （DDP)
	
$75.18
	
2-5 business days
	
--
	
≤10000kg
≤270cm

My DHL Account
	
$2.00

Details >
	
≤10000kg
≤295x195cm

My UPS Account
	
$2.00

Details >
	
≤10000kg
≤270cm

My FedEx Account
	
$2.00

Details >
	
≤10000kg
≤270cm

Global Standard Direct Line
	
—
	
—
	
Details >
	
≤1.5kg
≤$59
≤55x40cm

Sea Shipment
	
—
	
—
	
Details >
	
100-10000kg
