davidkellis/keyboards/tkl/tkl10/lighting-guide-12-study/index.html

V10 lighting development · 15 October 2026

# Ten sources. A guide that serves every key.

Ten side-emitting white LEDs are the first prototype. Twelve is the maximum, with a second layout to compare at the same battery power.

This replaces the earlier recommendation. It is an engineering proposal with test artwork. Legend brightness, uniformity and case fit have not been measured. Existing PCB and case revisions remain intact.

Optical layout

## Light enters from both long edges

Source layout

Actual V10 key centers; illustrative sources and output locations. No brightness field is simulated. The guide is continuous: dividing lines show source spacing, not cuts or grooves. Rear is at the top.

### Transport light, then release it locally

Use polished clear PMMA with small underside extraction patches aligned to the switches’ native light-entry passages. Add a separate reflector and an opaque mask to keep light aimed toward the legends.

### Build the optical path into the revision

A guide beneath the PCB requires new light apertures and reliefs around pins and components. The current six reverse LEDs and PCB cannot become this design through resistor changes alone.

## Where the light enters

Section showing a bottom-mounted LED emitting sideways into the edge of a separate guide below the PCB; a local extraction patch sends light upward through a new PCB aperture into the switch channel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

The separate optical guide is below the PCB in this proposal. Its thin edge faces the bottom-mounted LED’s emitting window at the same height. This is not the earlier idea of using the acrylic switch plate above the PCB as the guide.

This concept requires new through-PCB light apertures at the output locations, not just solder-mask openings. Guide clearance around switch pins, diodes, mounting posts, floor and battery still needs verification. The diagram does not prove a fit in the present case.

## A thin optical stack

Shine-through XVX cap · Whale switch

↑ through the native switch LED channel

PCB with aligned light apertures

White inward / dark outward output mask

Polished guide · local extraction underneath

Separate white reflector · small air spacing

Conceptual section. Bench-test 0.8, 1.0 and 1.5 mm guide stock; current-case clearance is unresolved. Guide thickness is not switch-plate thickness. No battery space is assigned to this proposal.

## One factory assembly side

Keep every factory-installed component on the bottom. Side-emitting LEDs shine parallel to the PCB into the guide below it. The driver, inductor, diodes and passives mount on that same side.

The guide, reflector and mask are fitted after soldering. You still install the switches and controller module. Use one LED part number and common passives where suitable.

JLC Economic (https://jlcpcb.com/capabilities/pcb-assembly-capabilities) supports single-side assembly. Preserve lead-free HASL and lead-free solder; check the exact parts against Economic requirements before committing.

## Choose the driver around assembly cost

The earlier TPS61162A candidate uses a 0.4 mm BGA pitch, below JLC’s published 0.5 mm Economic BGA limit. It is excluded from the low-cost baseline.

For ten LEDs, evaluate one series string with a leaded driver such as TPS61169 in SC70 (https://www.ti.com/product/TPS61169). The ten sources can still occupy two physical edge banks. For twelve, evaluate two regulated six-LED strings with suitable packages; do not assume twelve white LEDs fit the same single-string voltage limit.

Preserve the existing PWM control signal. Low-current efficiency, exact forward-voltage margin, component stock and the complete assembly quote still need qualification. The circuit and footprints are not finalized.

Battery-side budget · includes lighting driver losses

## Choose power, then measure the light

Complete lighting input power (mW) Actual backlight-on hours per day Nominal battery capacity (mAh) Usable capacity (%)

—days at this daily use

—continuous hours

—illustrative mA / LED

Lighting input target | 6 h/day | 12 h/day

Runtime assumptions: 3.7 V average cell, 0.7 mA other lit-use load, 0.1 mA unlit load, 3% monthly self-discharge. No measured clone current or battery capacity yet. Current per LED is only a sizing example: 3 V per LED, 85% power-stage conversion after a 1.2 mA fixed driver allowance. That allowance is already inside lighting input power; it is not added twice.

40 mW is a low-power design target, not a promise of readable legends. More sources at the same input power means less current per source; runtime stays the same. The prototype must establish the least power that produces acceptable lighting.

## LED shortlist

Test efficient single-die side-emitting white LEDs, with an emitting window matched to the guide’s thickness. Evaluate at the intended 1–4 mA operating range rather than choosing only by a 20 mA intensity specification.

Everlight BL-3806 family (https://en.everlight.com/visible_led/category-backlight_led/side_view_product__bl_3806/)
Nichia NSSW506H family (https://led-ld.nichia.co.jp/en/product/backlighting_sideview.html)

Exact suffix, color, low-current flux, emitter alignment and supplier/JLC stock remain open. These are candidates, not a shopping list or verified assembly quote.

## What the MX Keys example tells us

A separate guide is visible in the MX Keys disassembly (https://www.ifixit.com/Guide/Logitech+MX+Keys+disassembly+guide/148050). A small number of sources is a useful architecture to pursue.

Logitech also documents (https://support.logi.com/hc/en-ca/articles/360034762774-Getting-Started-MX-Keys) automatic brightness, proximity wake and a low-battery cutoff. Those controls help runtime alongside the guide.

The exact ten-source count for the referenced revision is not independently confirmed here. Our mechanical switches need their own tested optical path.

## Prototype a full-depth strip first

Two-source guide test coupon with eighteen output windows and switch-pin reliefs

The 70.152 × 129.19 mm coupon has eighteen outputs, six physical rows and two sources. Its transport distance matches the keyboard’s full depth. It screens the harder case of nine outputs per source.

1. Align a real Whale switch and XVX cap over an output; confirm the light passage’s orientation.
2. Compare sparse, medium and dense extraction, first solid and then perforated. Use identical current and stock.
3. Measure near, middle and far legends at fixed exposure. Aim initially for the darkest comparable legend to reach at least half the brightest.
4. Use about one fifth of full ten-source LED output power. Test case fit, actual component reliefs and the full keyboard before routing a production board.

The generic pin reliefs omit real diode and mounting-boss cutouts. The guide is not a load-bearing plate or a drop-in V10 part. Bench brightness is not yet a full-board result.

Download optical test kitFabrication and test notesPower estimates CSV

Kit includes nominal-mm SVG and DXF cut / etch layers, both guide variants, masks, reflectors and three experimental extraction patterns. Tool and kerf compensation are not applied.

Engineering references: Bivar illumination guide (https://www.bivar.com/Files/Content/Handbook-to-Illumination-Design-101.pdf) · ACRYLITE edge-lit materials (https://www.acrylite.co/products/brands/acrylite-led/light-guiding-edge-lit-sheet). Ordinary clear PMMA with local extraction and bulk-scattering sheet are different materials. Study data and source hashes. No PCB files were edited.
