davidkellis/keyboards/tkl/tkl11/render-assembly/index.html

V11 ASSEMBLY STUDIO

Ten reverse LEDs · current V11 PCB
Assembled / exploded · freely orbitable

Edition 2 · raised key wells

Front three-quarter

Illustrative light spread · brightness uncalibrated

Assembled

Preparing the assembled keyboard…

DRAG TO EXPLORE EVERY SIDE

Drag Rotate freelyScroll ZoomRight-drag PanR Reset

## Assembly view

AssembledExploded

Layer separation0%

Parts seatedSpread apart

Fit view while separating

Exploded layer labels

Transparent case

Visible parts

Lower case

Battery

PCB + controller

Key plate + backing

Top case frame

Switches + stabilizers

Nuts, screws + carriers

Separate acrylic plate / frame concept. The original printed upper combines these pieces. This shows the stack, not a disassembly procedure.

Light transfer into the detached plate is turned off in exploded views.

## Plate treatment

White reflective backing

Lighting on

Room lighting

Preview brightness

Appearance comparison, not a lux measurement. The same ten V11 input sources are used throughout. More spread lowers peak brightness.

## Case edition

Try Top or Light detail to see the gaps. The raised frame conceals much of the plate at lower viewing angles.

Key travel preview0.0 mm

Slide to check the keys at rest and fully pressed. The raised case stays fixed.

## Keycap profile

Socket engagement3.0 mm

Mounting study only; actual seating and full switch travel need a fit test.

## Case finish

Graphite Chalk Slate

Case colour

Keycap colour

Surface finishMatte

## Inspect

Show keycaps

Auto-rotate

Show legends

Raking light

Studio shadow

Case width × depth355.6 × 133.4 mmTop plane front / rear9.0 / 22.3 mmCurrent PCB lighting10 white LEDsSwitch travel2.8 mm

Save this viewDownload this 3D modelReset view

Current V11 PCB and ten reverse-mounted LEDs. Lighting is an appearance comparison, not measured brightness. The separate acrylic plate and frame need a retention design and fit trial.

Sources & fit notes

The acrylic is shown inside the opaque printed surround, with a removable white backing. Its visual thickness is the existing 1.5 mm CAD envelope. Kailh's drawing references 1.2 mm aluminum; actual acrylic thickness and Whale clip fit are not yet specified.

The emission maps use ten normalized source kernels. They illustrate concentrated, scattered and patterned extraction, not measured PMMA properties or a ray trace. Engraved acrylic needs effective entry coupling to achieve the intended appearance. Expect real hot spots and dark regions.

ScottoCaps Flat and Glass MX meshes by Joe Scotto (https://github.com/joe-scotto/scottokeebs/tree/main/Extras/ScottoCaps), used under CC BY-NC-SA 4.0 (https://creativecommons.org/licenses/by-nc-sa/4.0/). XVX shapes and seating are approximate. The raised case targets nominal XVX skirts; other caps sit differently.

At zero separation, the nominal battery, real V11 PCB and all 86 switch centers use the existing assembly coordinates. The V10 upper integrates the switch plate; the acrylic view partitions it into a frame and separate plate as a fit concept. Exploding these layers illustrates their relationship; soldered switches cannot be lifted from a soldered PCB this way in servicing.

V10 case studioAssembly notesAttribution
