davidkellis/keyboards/tkl/tkl12/manufacturing/quote-v12-2026-10-16/hasl-economic/checkout-review-summary.txt

SUMMARY
Merchandise Total
$93.39
Shipping Estimate
$49.73
Customs duties & taxes
$37.14
Grand Total
$180.26
Submit Order

Need some help? Explore our help pages or contact us

© 2026 JLCPCB.COM All Rights Reserved. Privacy Policy Terms & Conditions
