davidkellis/keyboards/tkl/tkl10/lighting-guide-12-study/power-targets.csv

led_count | battery_lighting_mw | lit_hours_day | lighting_battery_ma | days | continuous_hours | daily_mah | illustrative_led_ma
10 | 40 | 6 | 10.81081081081081 | 52.72532953330959 | 341.32185343916365 | 75.86486486486486 | 1.0075333333333334
10 | 40 | 12 | 10.81081081081081 | 27.714317815812148 | 341.32185343916365 | 144.3297297297297 | 1.0075333333333334
10 | 80 | 6 | 21.62162162162162 | 28.423276358747838 | 177.54141133425972 | 140.72972972972974 | 2.1408666666666667
10 | 80 | 12 | 21.62162162162162 | 14.595372872329936 | 177.54141133425972 | 274.05945945945945 | 2.1408666666666667
10 | 160 | 6 | 43.24324324324324 | 14.78964724692715 | 90.59699132288951 | 270.4594594594595 | 4.407533333333333
10 | 160 | 12 | 43.24324324324324 | 7.4973911105257285 | 90.59699132288951 | 533.518918918919 | 4.407533333333333
12 | 40 | 6 | 10.81081081081081 | 52.72532953330959 | 341.32185343916365 | 75.86486486486486 | 0.8396111111111112
12 | 40 | 12 | 10.81081081081081 | 27.714317815812148 | 341.32185343916365 | 144.3297297297297 | 0.8396111111111112
12 | 80 | 6 | 21.62162162162162 | 28.423276358747838 | 177.54141133425972 | 140.72972972972974 | 1.7840555555555555
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
