davidkellis/keyboards/tkl/tkl7.4/manufacturing/quote-v7.4-2026-09-25/final-quote.png

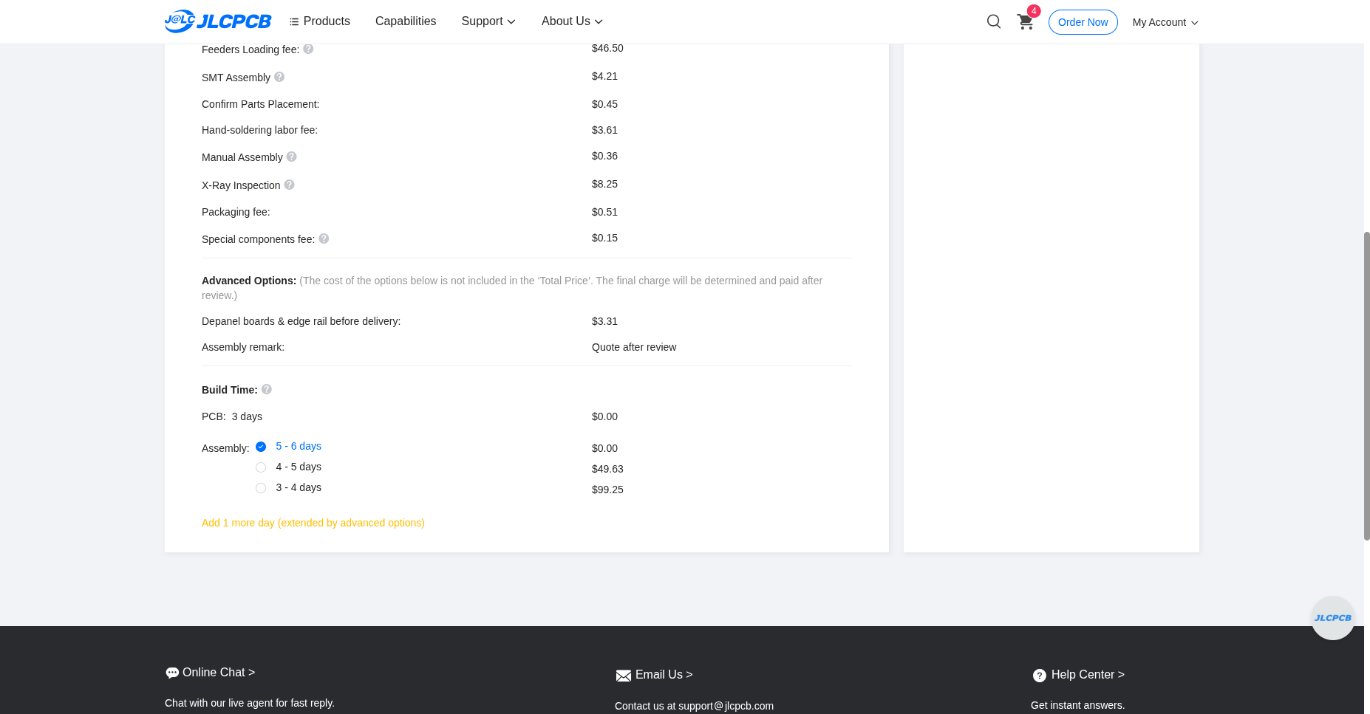
tkl/tkl7.4/manufacturing/quote-v7.4-2026-09-25/final-quote.png
