davidkellis/keyboards/tkl/tkl7.4/manufacturing/quote-v7.4-2026-09-25/placements-bottom.png

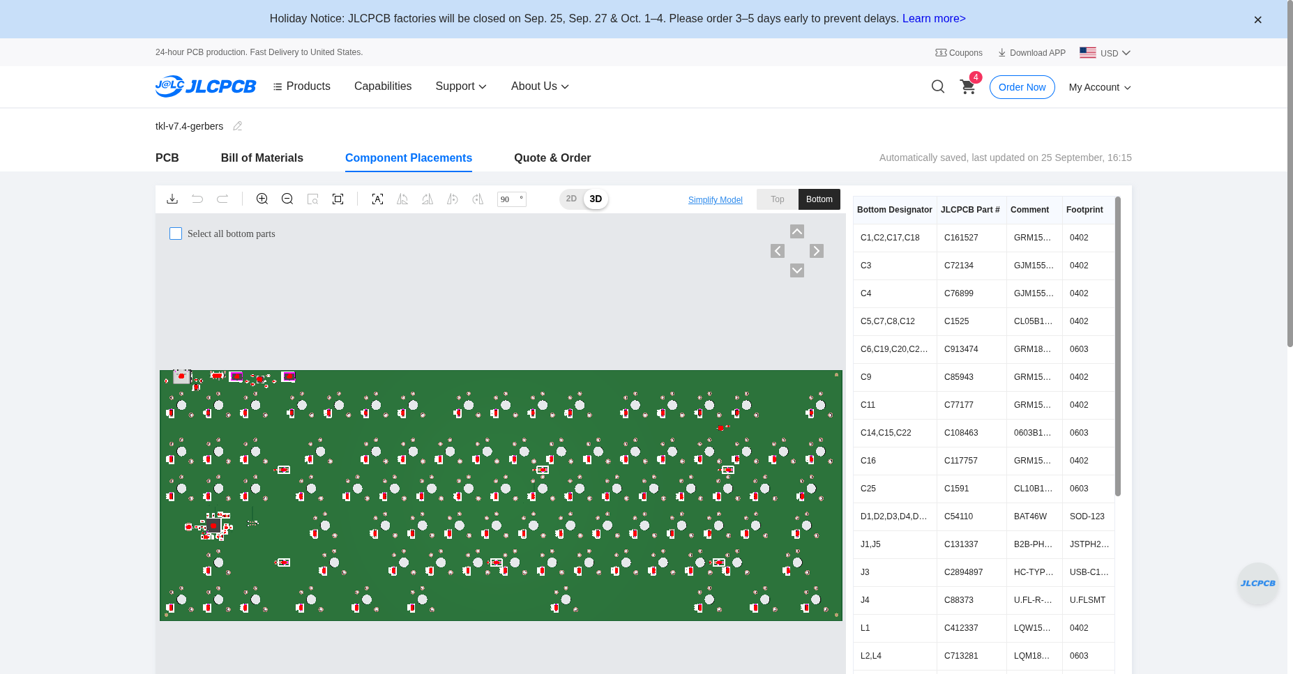
tkl/tkl7.4/manufacturing/quote-v7.4-2026-09-25/placements-bottom.png
