davidkellis/keyboards/tkl/tkl7/manufacturing/quote-2026-09-25/economic-standard-only.png

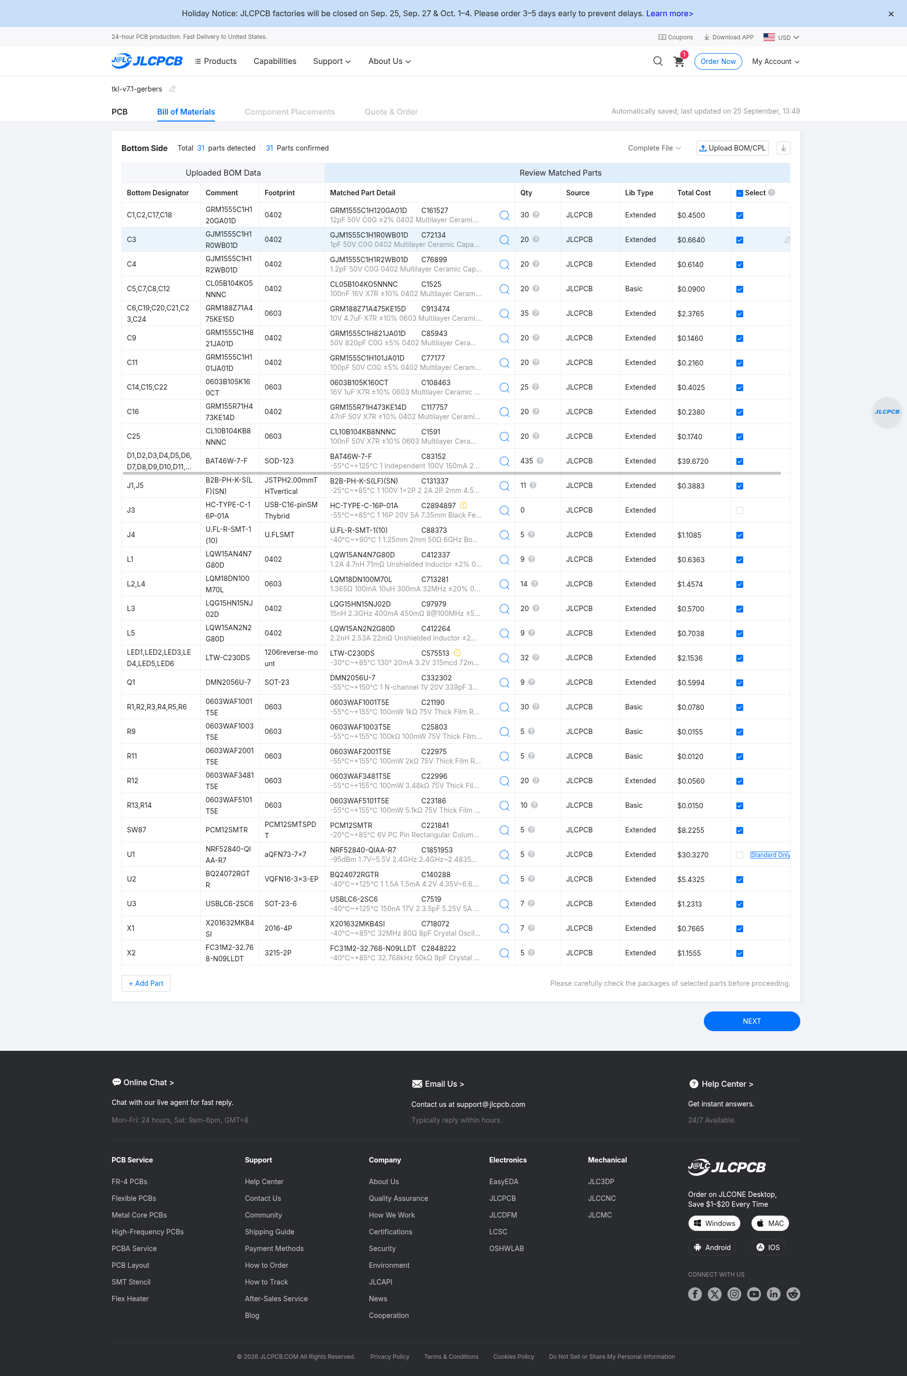
tkl/tkl7/manufacturing/quote-2026-09-25/economic-standard-only.png
