davidkellis/keyboards/tkl/tkl7/manufacturing/quote-2026-09-25/two-final-quote.png

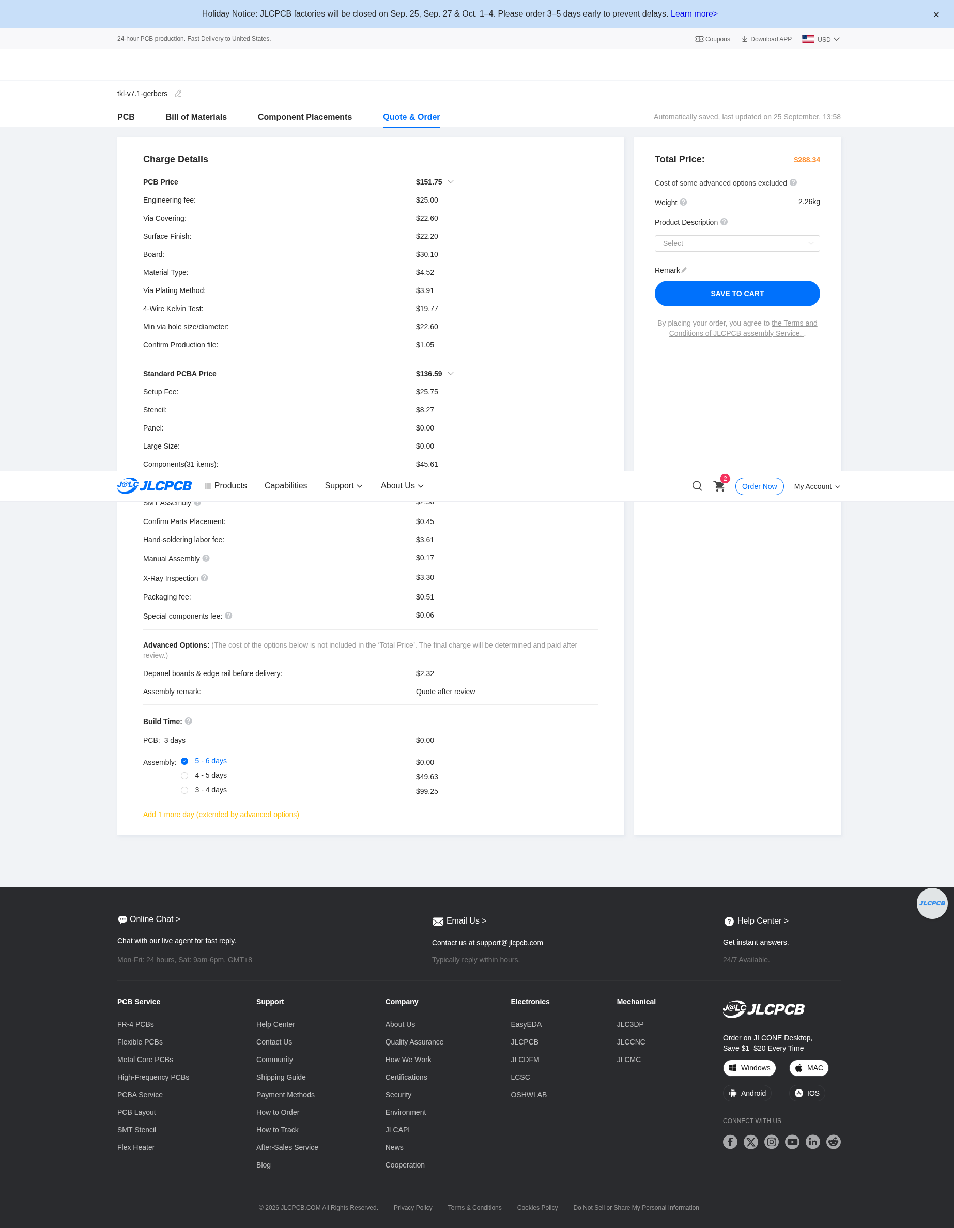
tkl/tkl7/manufacturing/quote-2026-09-25/two-final-quote.png
