davidkellis/keyboards/tkl/tkl7/manufacturing/quote-2026-09-25/two-saved-cart.png

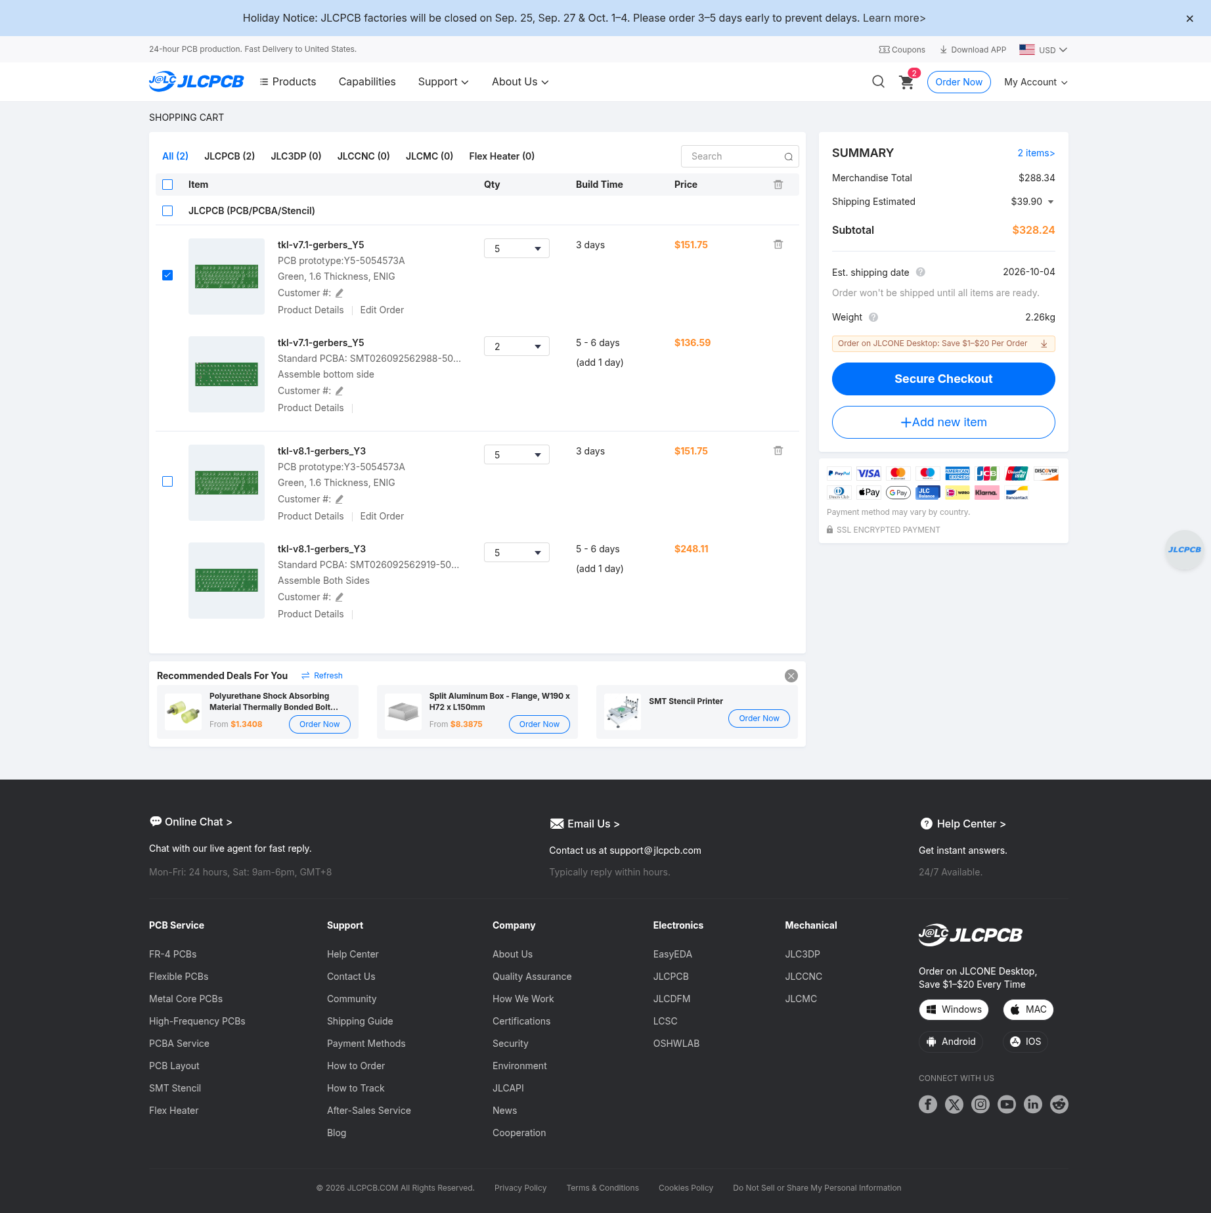
tkl/tkl7/manufacturing/quote-2026-09-25/two-saved-cart.png
