davidkellis/keyboards/tkl/tkl7/manufacturing/quote-v7.2-2026-09-25/final-quote.png

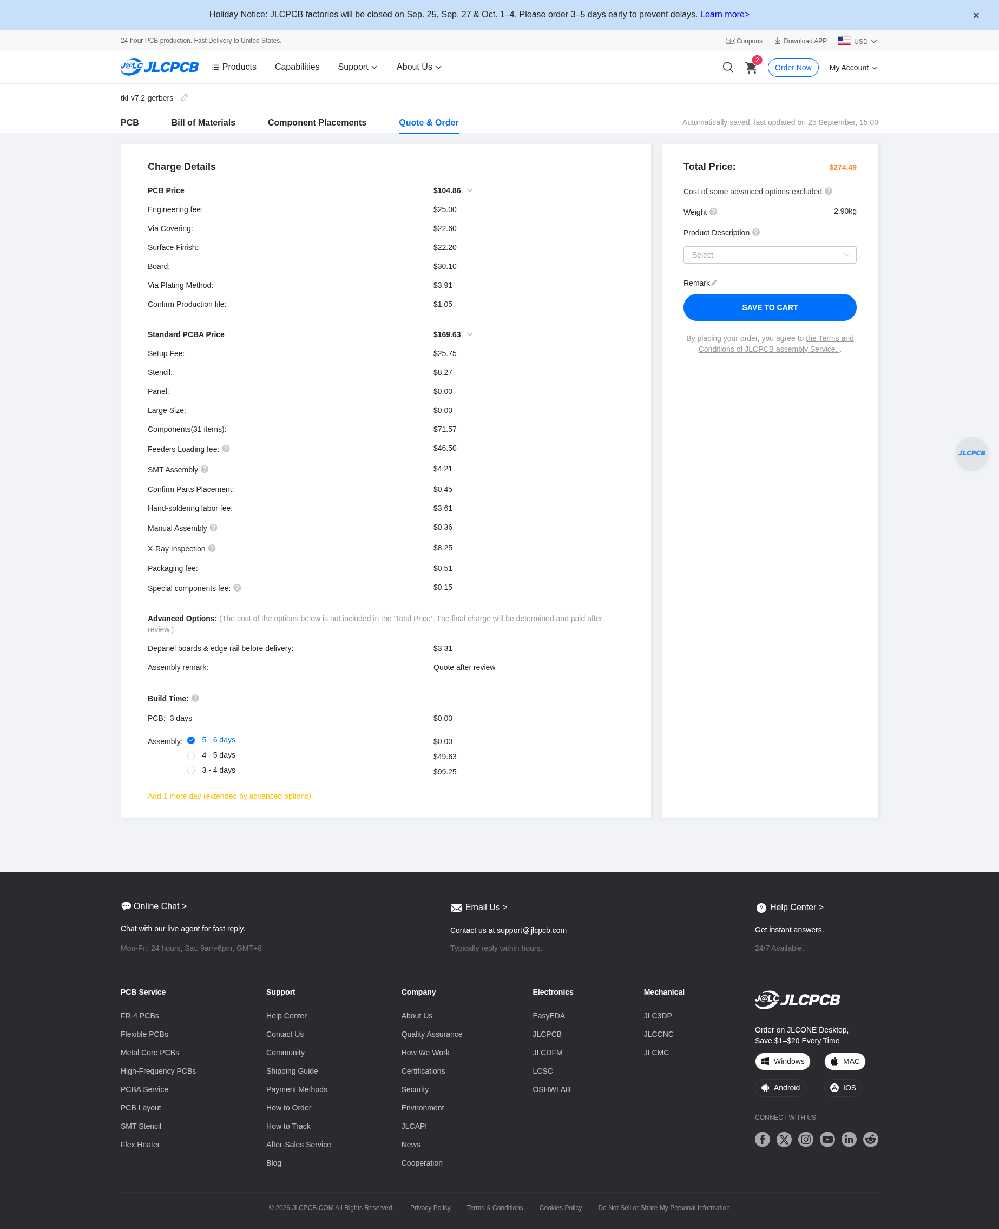
tkl/tkl7/manufacturing/quote-v7.2-2026-09-25/final-quote.png
