davidkellis/keyboards/tkl/tkl8/manufacturing/quote-2026-09-25/placements-top.png

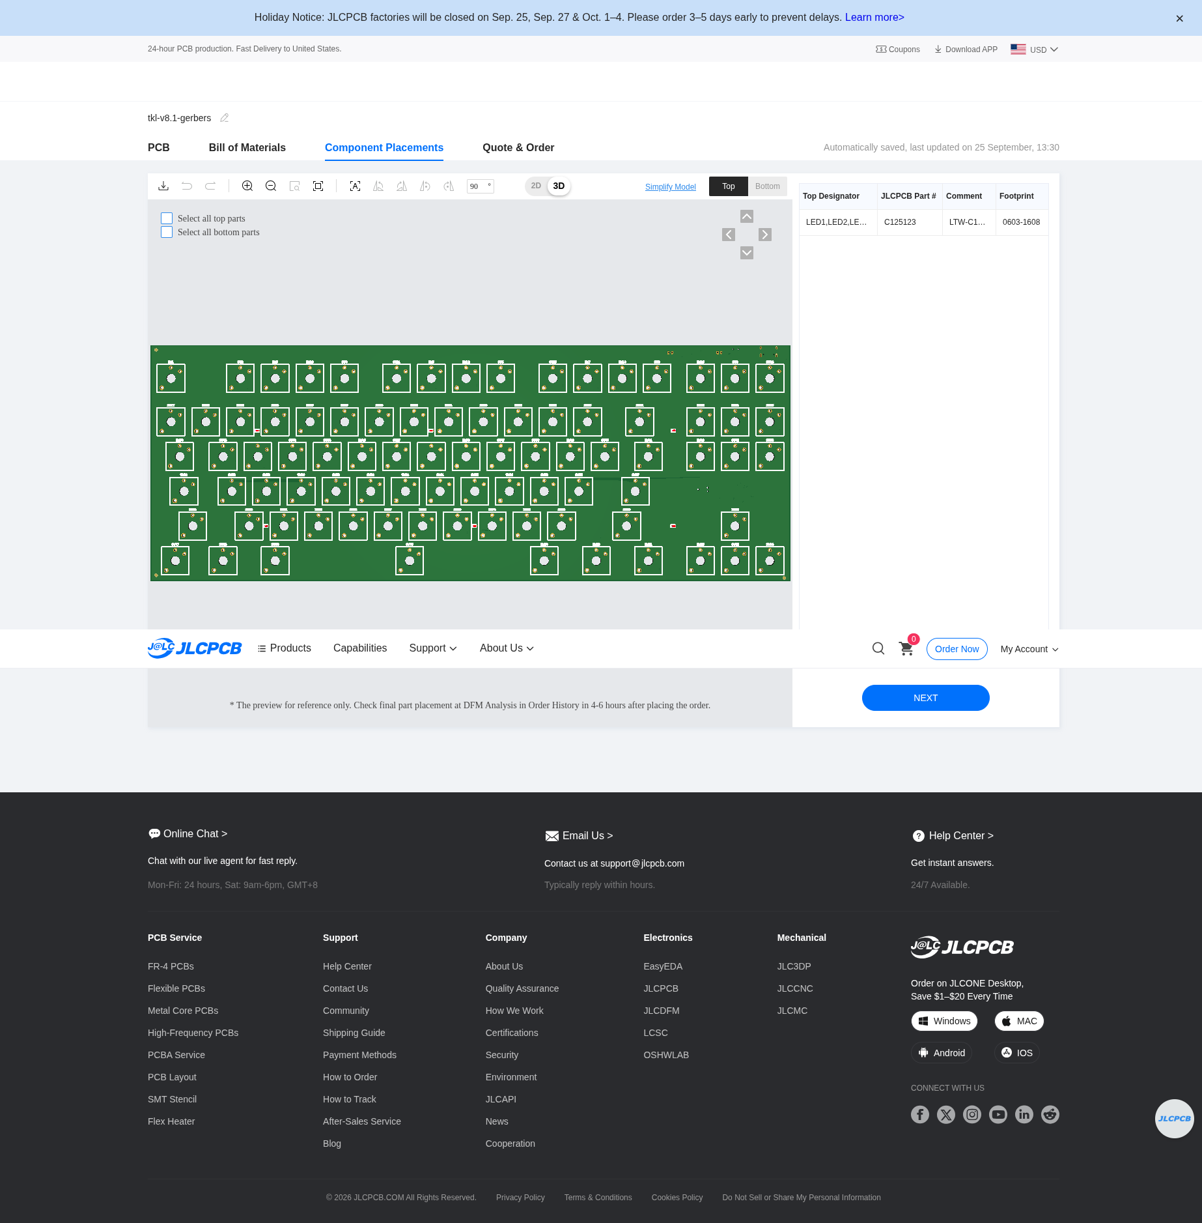
tkl/tkl8/manufacturing/quote-2026-09-25/placements-top.png
