davidkellis/keyboards/tkl/tkl8/manufacturing/quote-2026-09-25/saved-cart.png

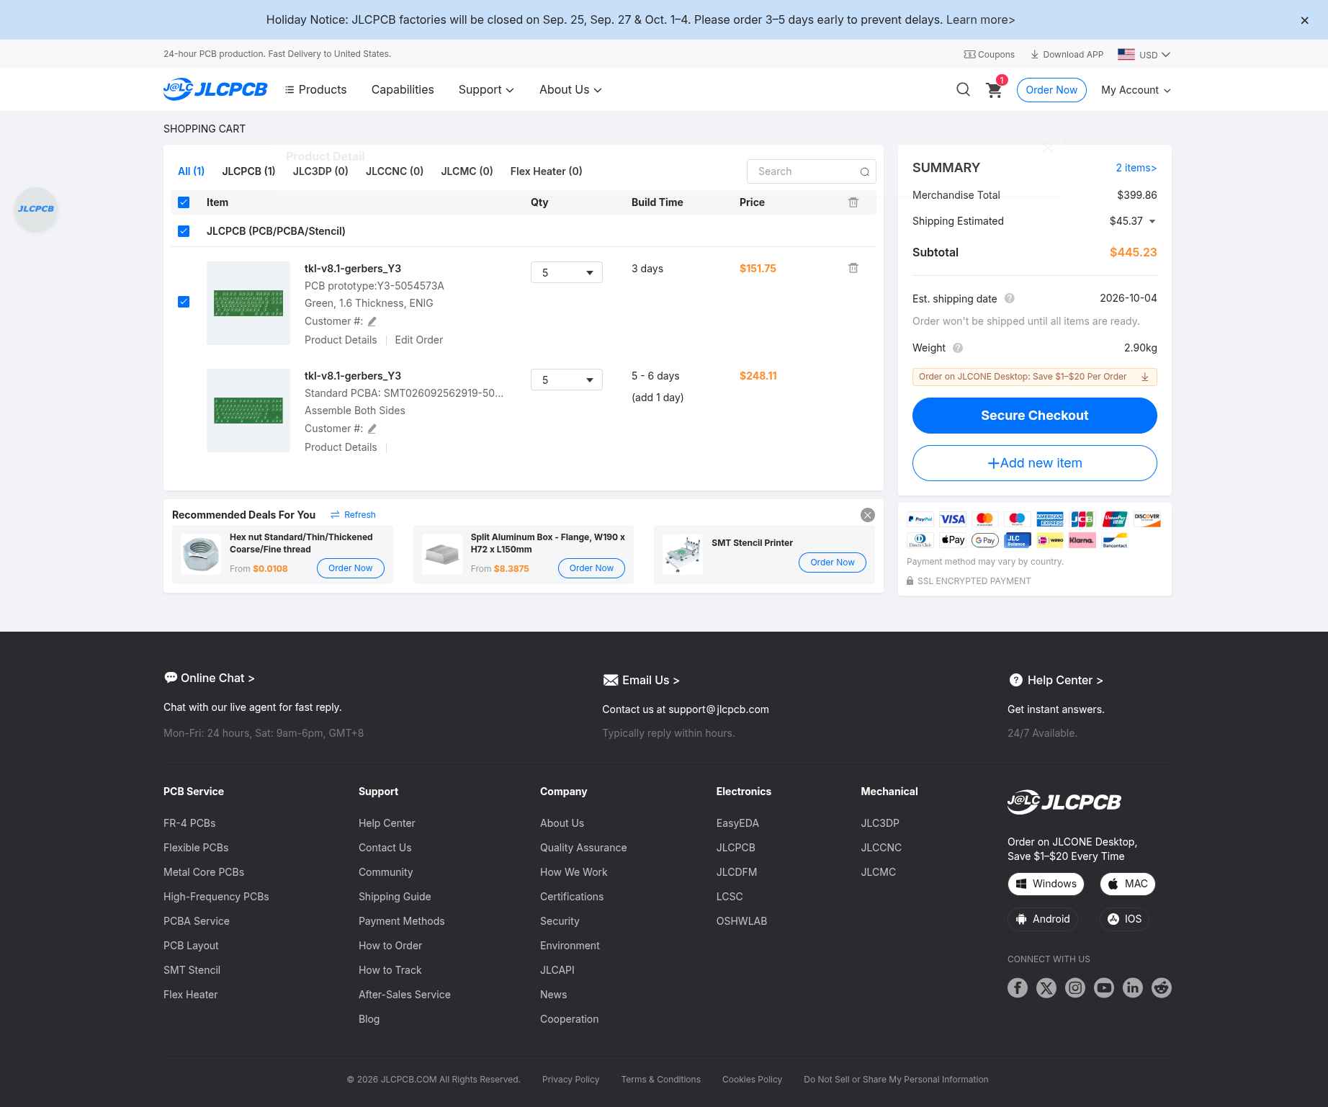
tkl/tkl8/manufacturing/quote-2026-09-25/saved-cart.png
