davidkellis/keyboards/tkl/tkl9/case/print-fit/preview.png

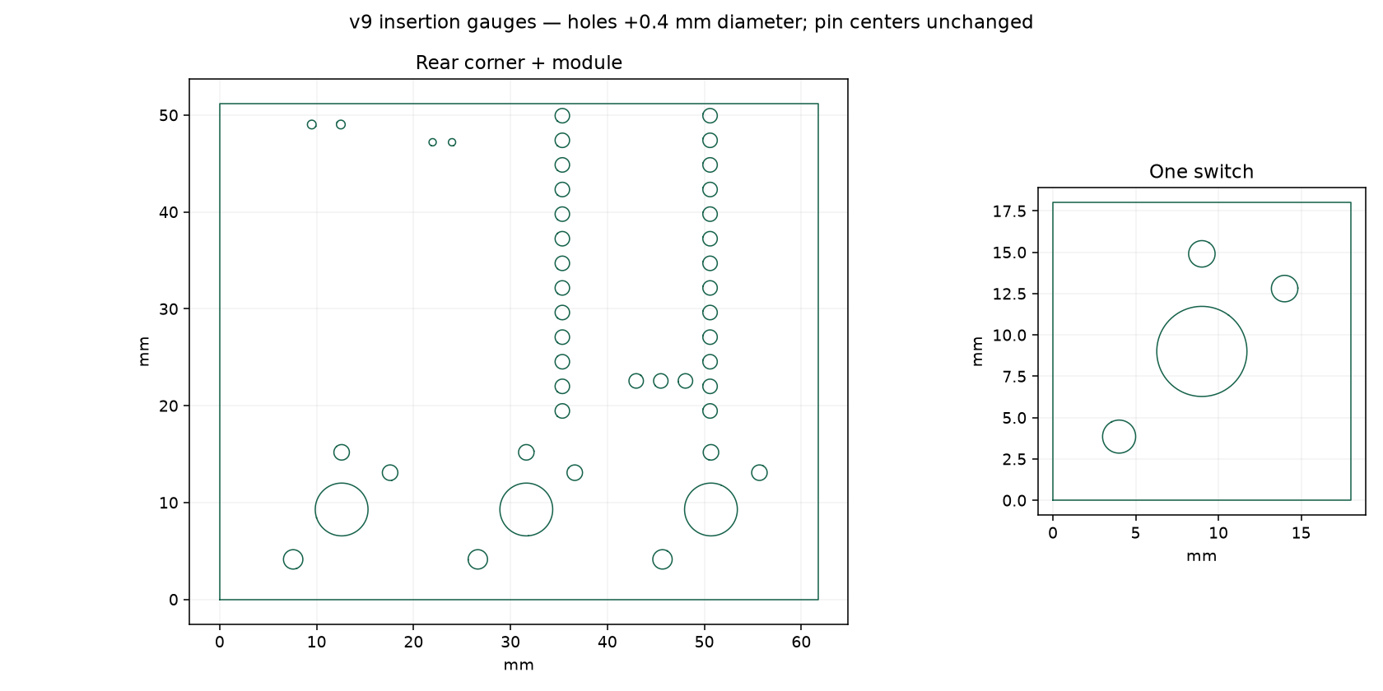
tkl/tkl9/case/print-fit/preview.png
