davidkellis/keyboards/tkl/tkl9/manufacturing/quote-v9-2026-09-26/hasl-economic/placements-top.png

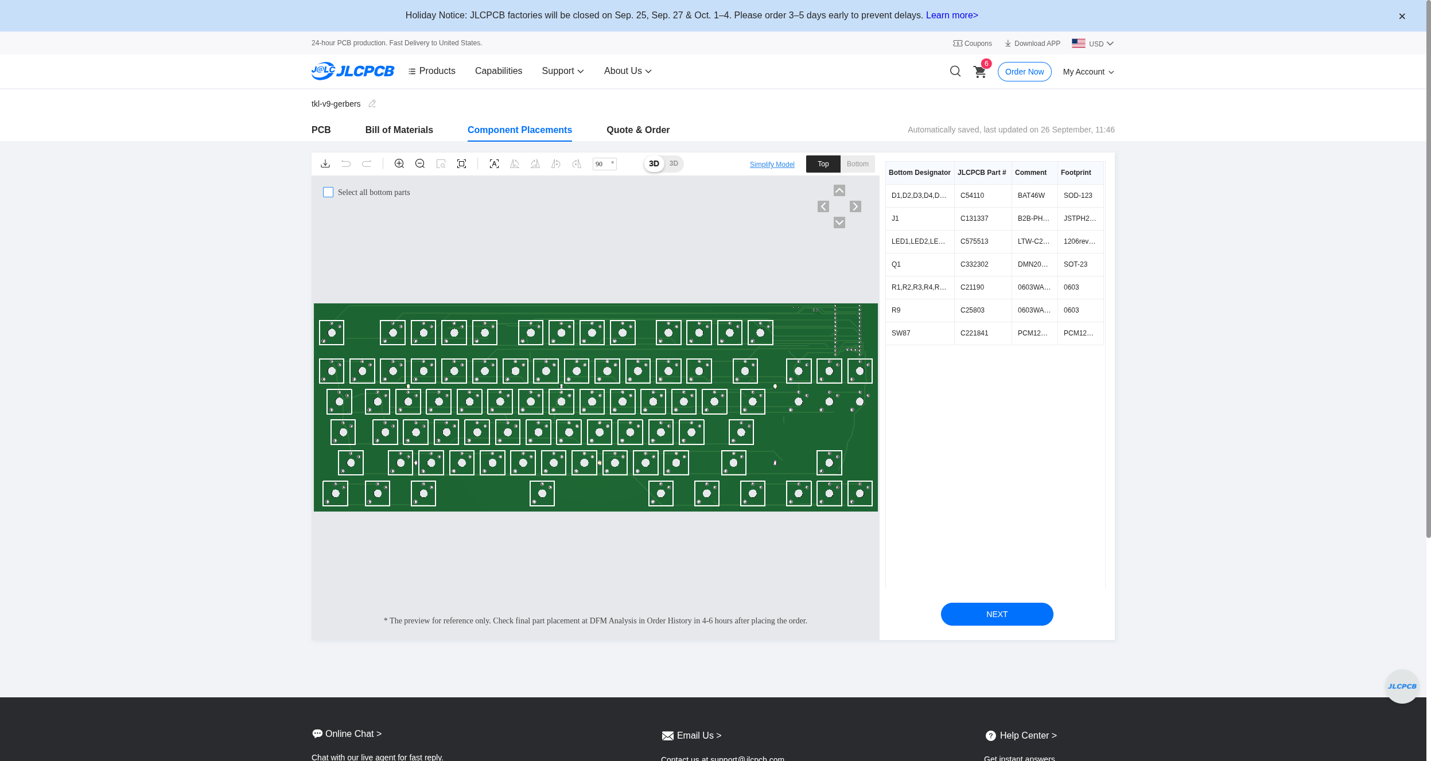
tkl/tkl9/manufacturing/quote-v9-2026-09-26/hasl-economic/placements-top.png
