davidkellis/keyboards/tkl/tkl10/case-hidden-mounts/assembled-preview.png

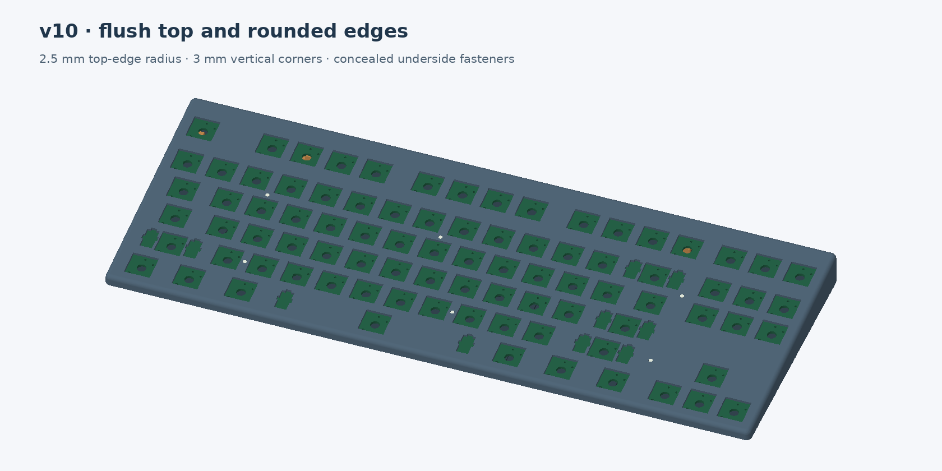
tkl/tkl10/case-hidden-mounts/assembled-preview.png
