davidkellis/keyboards/tkl/tkl10/case/assembled-exploded.png

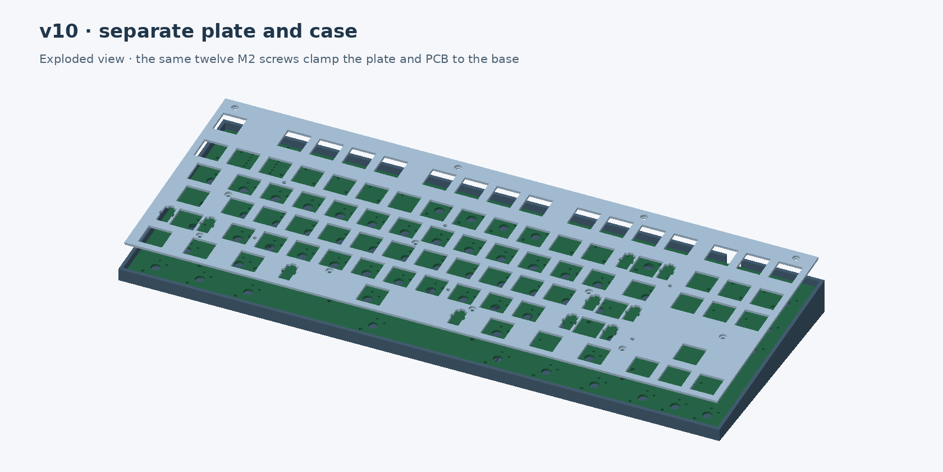
tkl/tkl10/case/assembled-exploded.png
