davidkellis/keyboards/tkl/tkl10/lighting-guide-12-study/mobile-preview.png

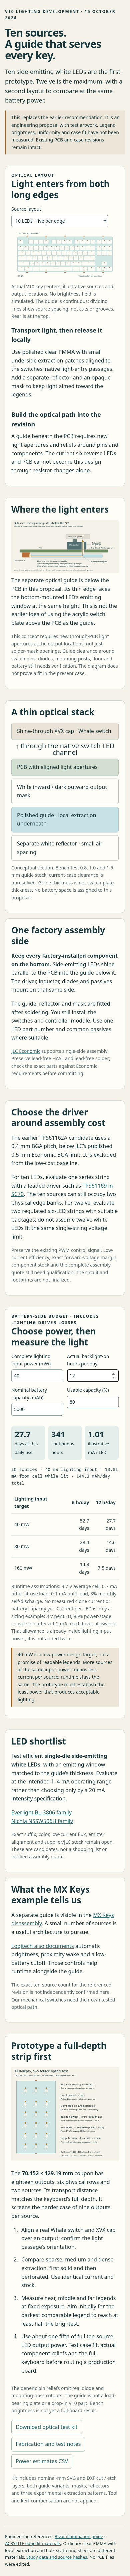
tkl/tkl10/lighting-guide-12-study/mobile-preview.png
