davidkellis/keyboards/tkl/tkl10/manufacturing/quote-v10-2026-09-29/cart-final.png

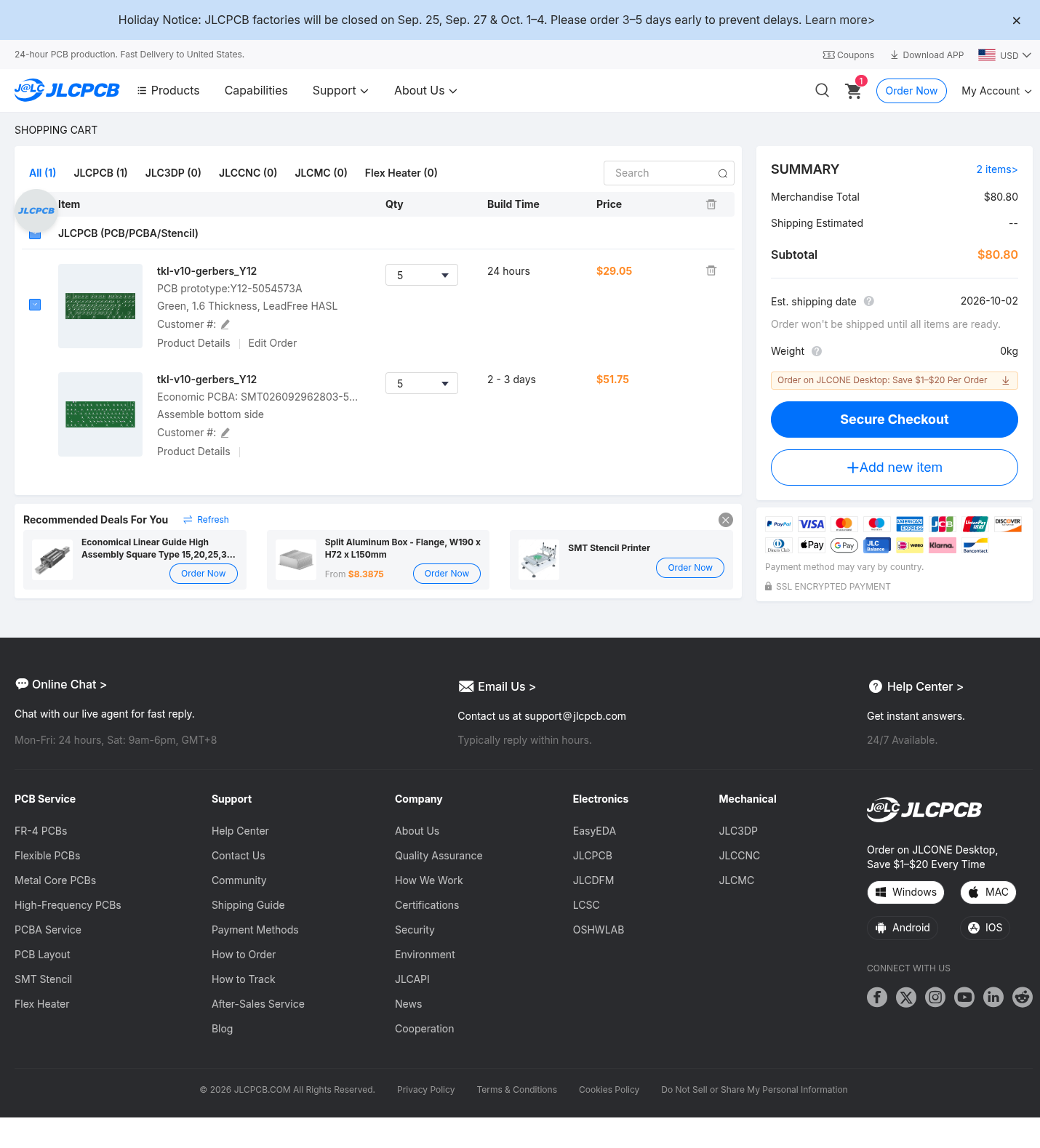
tkl/tkl10/manufacturing/quote-v10-2026-09-29/cart-final.png
