davidkellis/keyboards/tkl/tkl10/manufacturing/quote-v10-2026-09-29/hasl-economic/configured.png

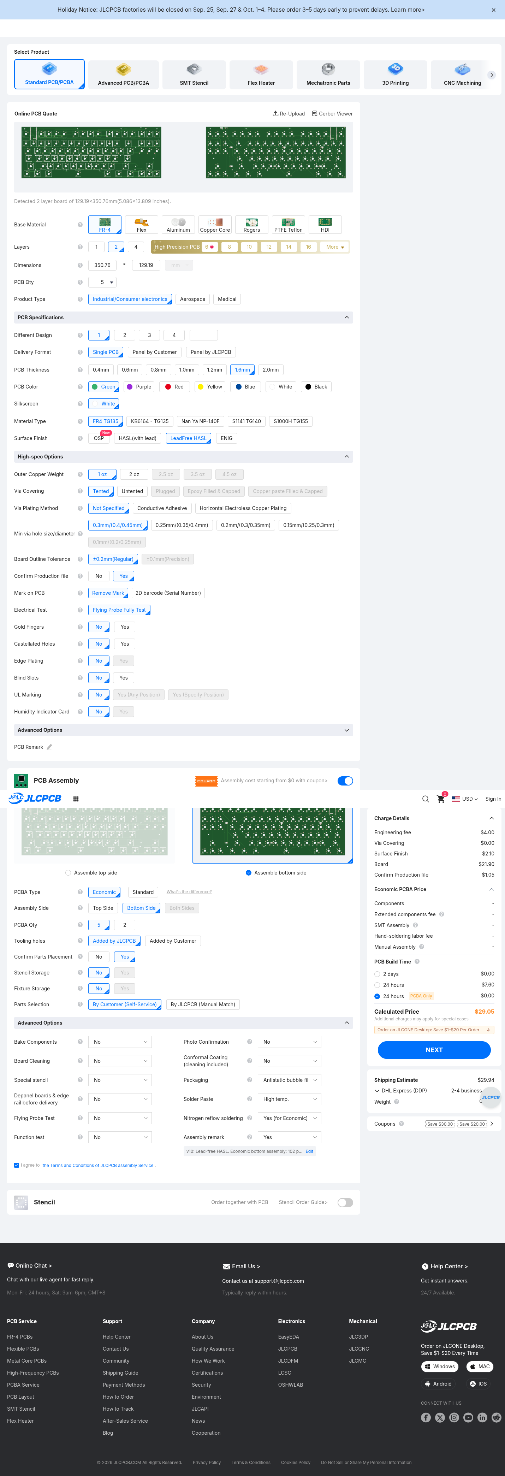
tkl/tkl10/manufacturing/quote-v10-2026-09-29/hasl-economic/configured.png
