davidkellis/keyboards/tkl/tkl10/manufacturing/quote-v10-2026-09-29/osp-standard/configured.png

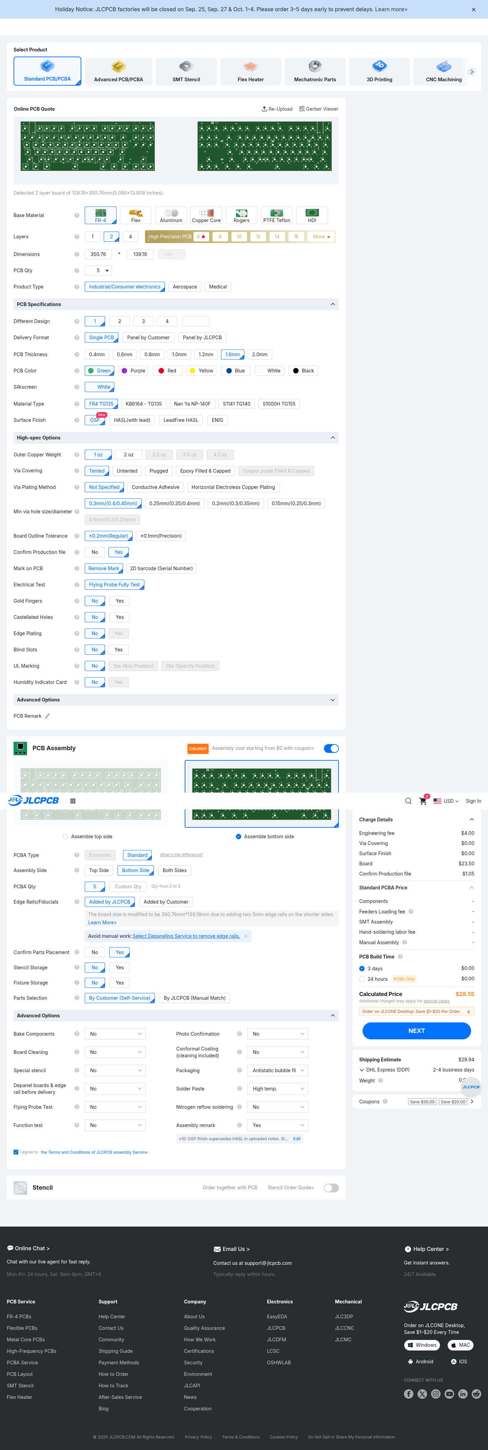
tkl/tkl10/manufacturing/quote-v10-2026-09-29/osp-standard/configured.png
