davidkellis/keyboards/tkl/tkl11/manufacturing/quote-v11-2026-10-16/hasl-economic/configured.png

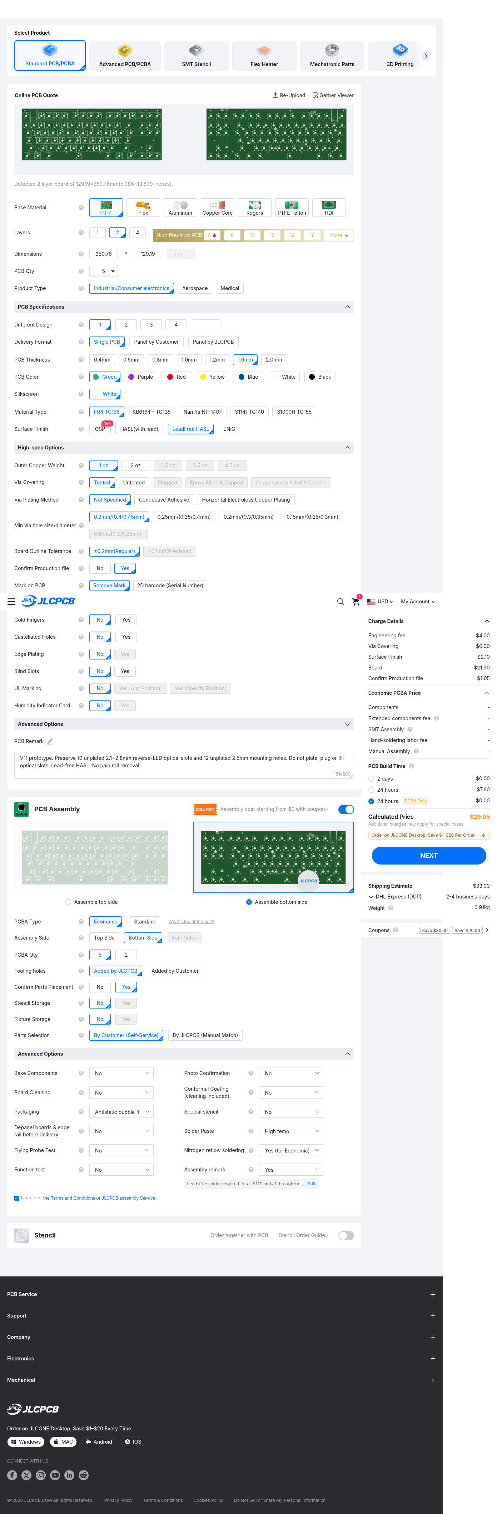
tkl/tkl11/manufacturing/quote-v11-2026-10-16/hasl-economic/configured.png
