davidkellis/keyboards/tkl/tkl11/manufacturing/quote-v11-2026-10-16/hasl-economic/placements-bottom.png

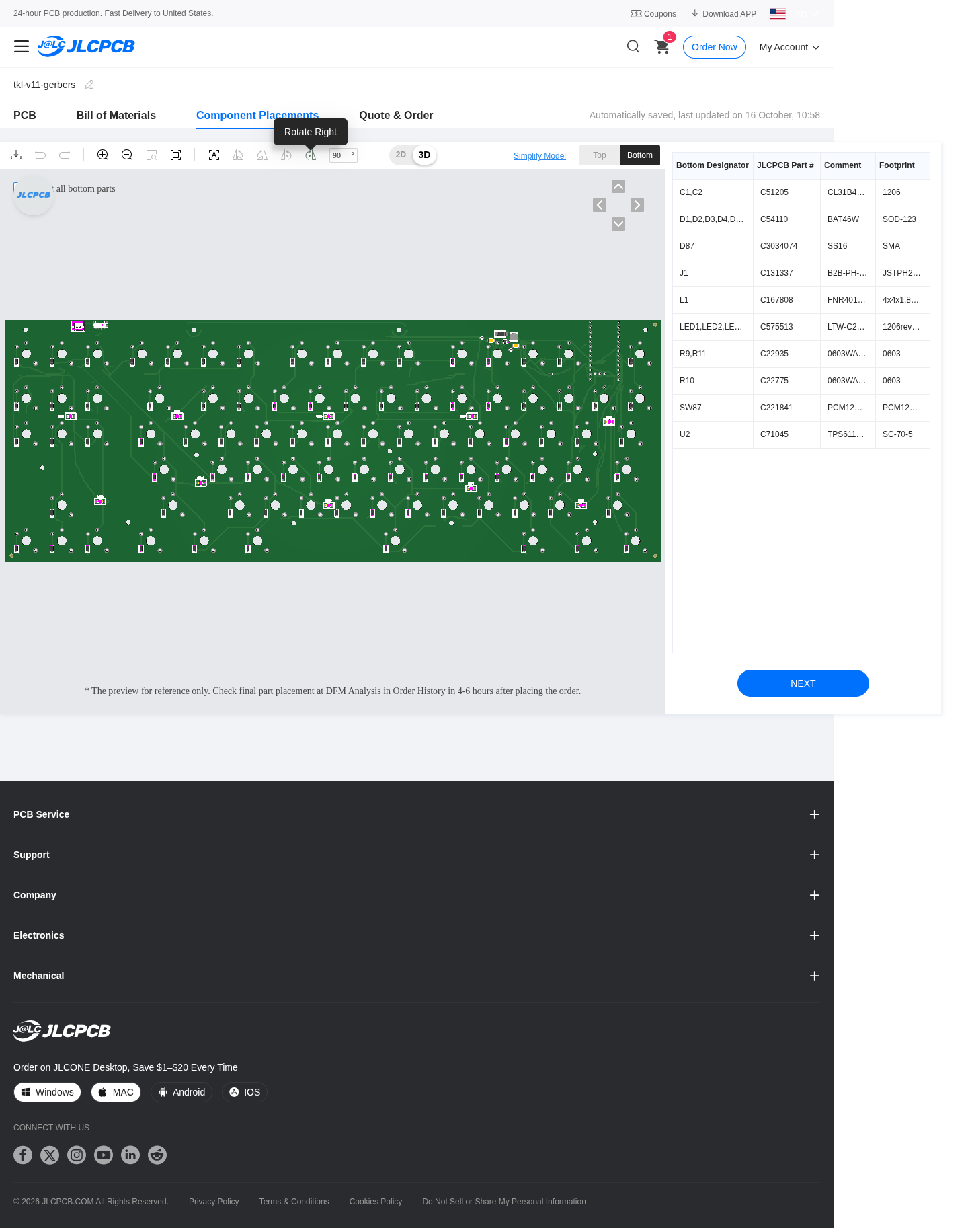
tkl/tkl11/manufacturing/quote-v11-2026-10-16/hasl-economic/placements-bottom.png
