davidkellis/keyboards/tkl/tkl11/render-assembly/exploded-preview.png

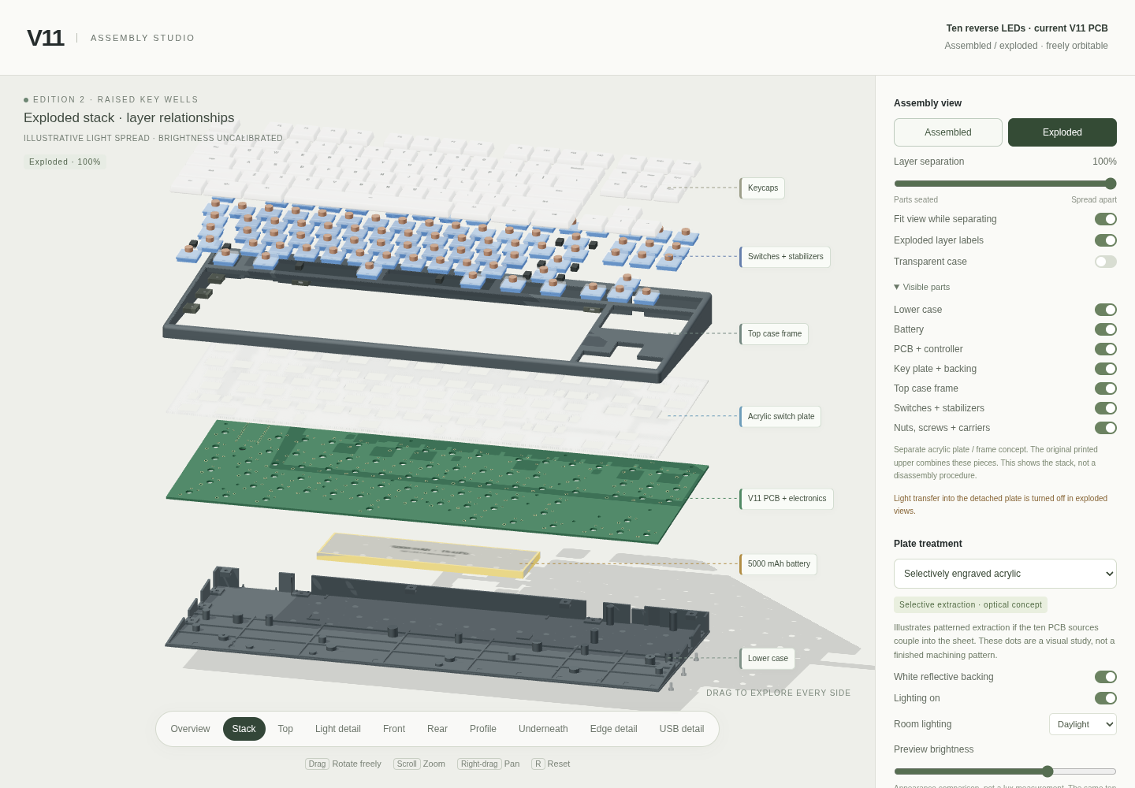
tkl/tkl11/render-assembly/exploded-preview.png
