davidkellis/keyboards/tkl/tkl11/render-assembly/mobile-preview.png

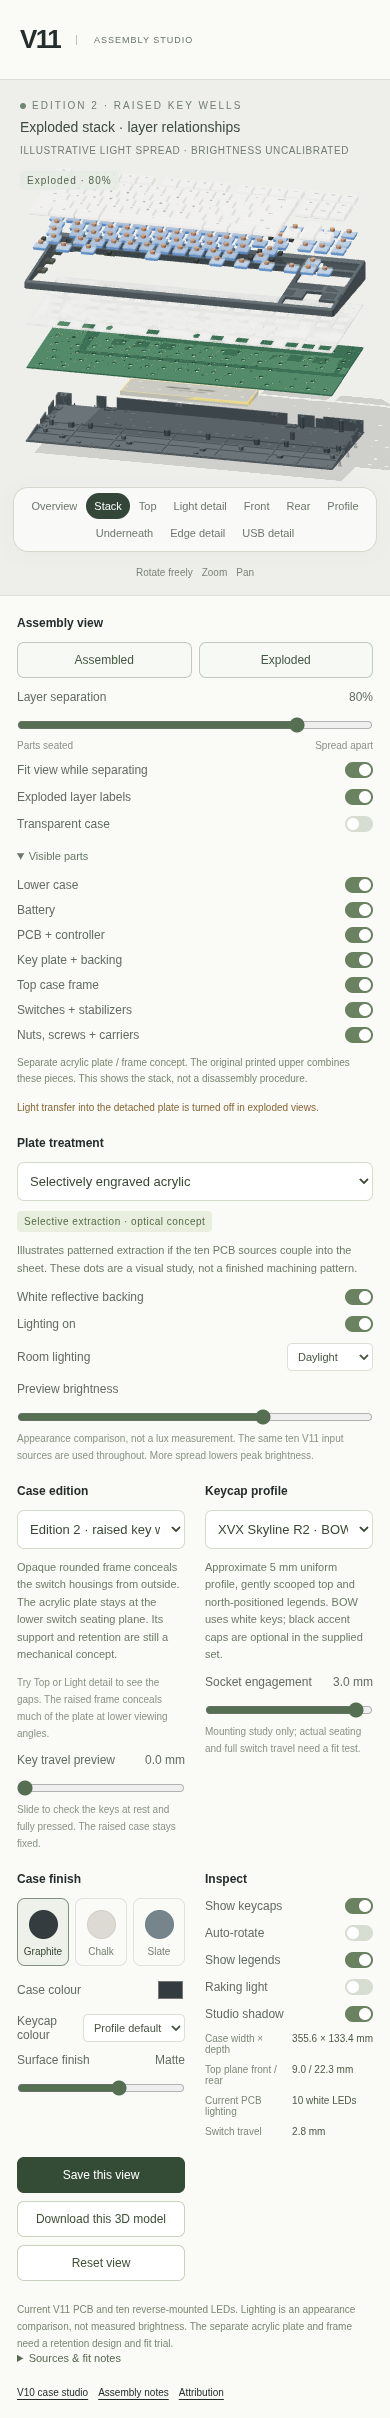
tkl/tkl11/render-assembly/mobile-preview.png
