davidkellis/keyboards/tkl/tkl11/render-assembly/studio-preview.png

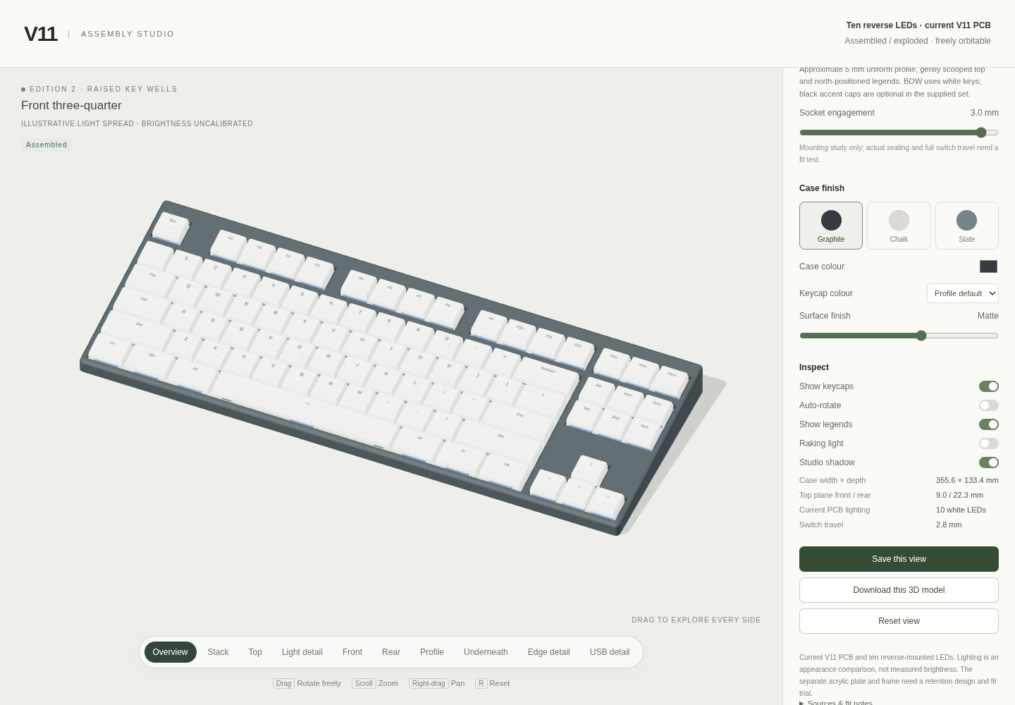
tkl/tkl11/render-assembly/studio-preview.png
