davidkellis/keyboards/tkl/tkl11/render-assembly/v11-assembled.png

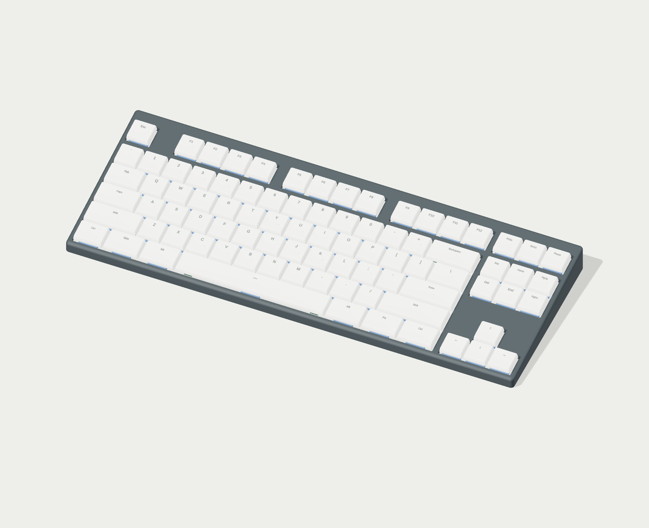
tkl/tkl11/render-assembly/v11-assembled.png
