davidkellis/keyboards/tkl/tkl11/render-assembly/v11-exploded.png

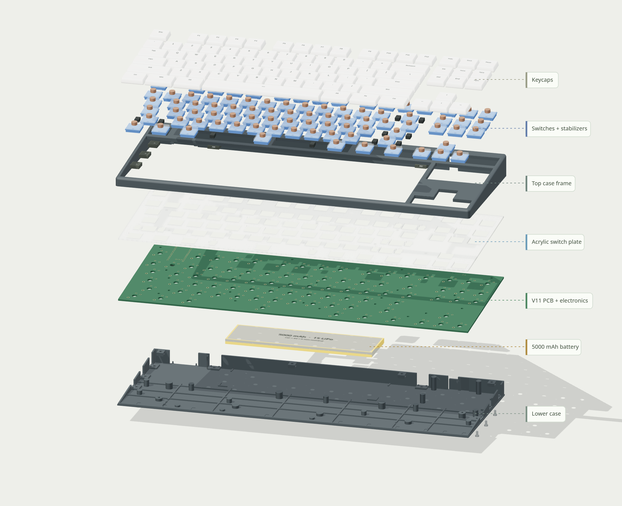
tkl/tkl11/render-assembly/v11-exploded.png
