davidkellis/keyboards/tkl/tkl11/render-assembly/views/assembled-edge.png

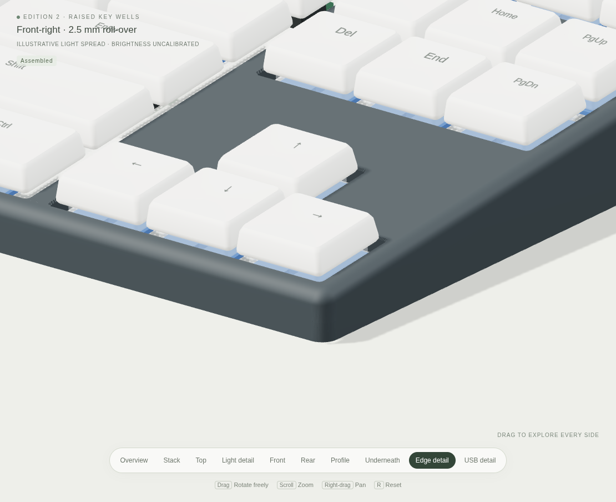
tkl/tkl11/render-assembly/views/assembled-edge.png
