davidkellis/keyboards/tkl/tkl11/render-assembly/views/assembled-front.png

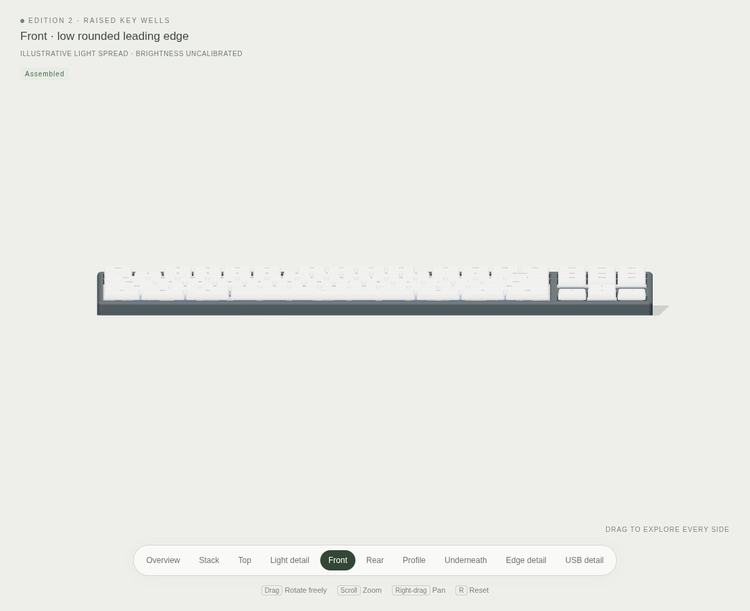
tkl/tkl11/render-assembly/views/assembled-front.png
