davidkellis/keyboards/tkl/tkl11/render-assembly/views/assembled-light.png

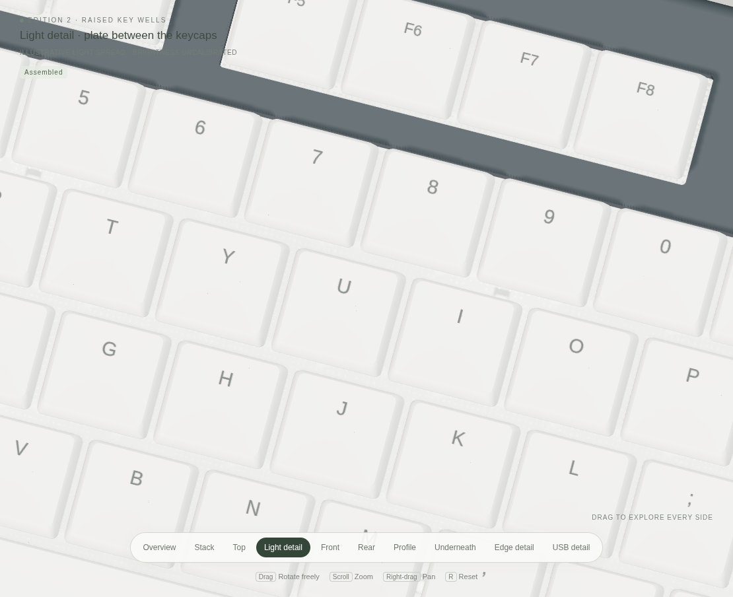
tkl/tkl11/render-assembly/views/assembled-light.png
