davidkellis/keyboards/tkl/tkl11/render-assembly/views/assembled-rear.png

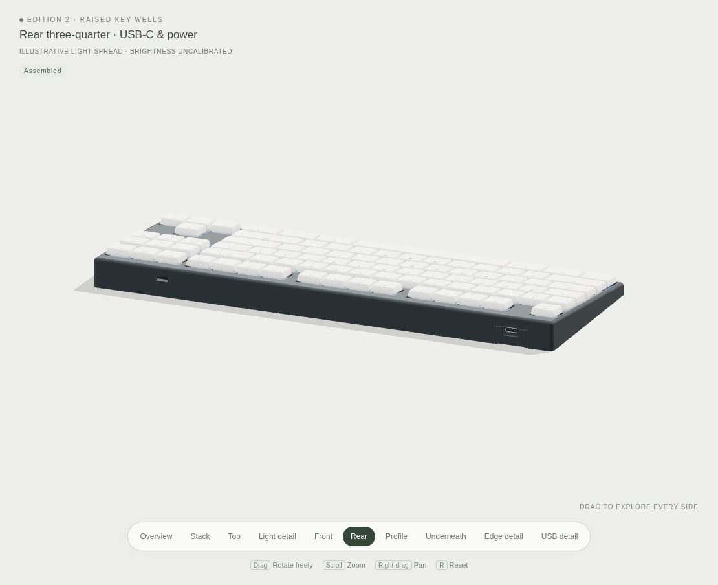
tkl/tkl11/render-assembly/views/assembled-rear.png
