davidkellis/keyboards/tkl/tkl11/render-assembly/views/assembled-side.png

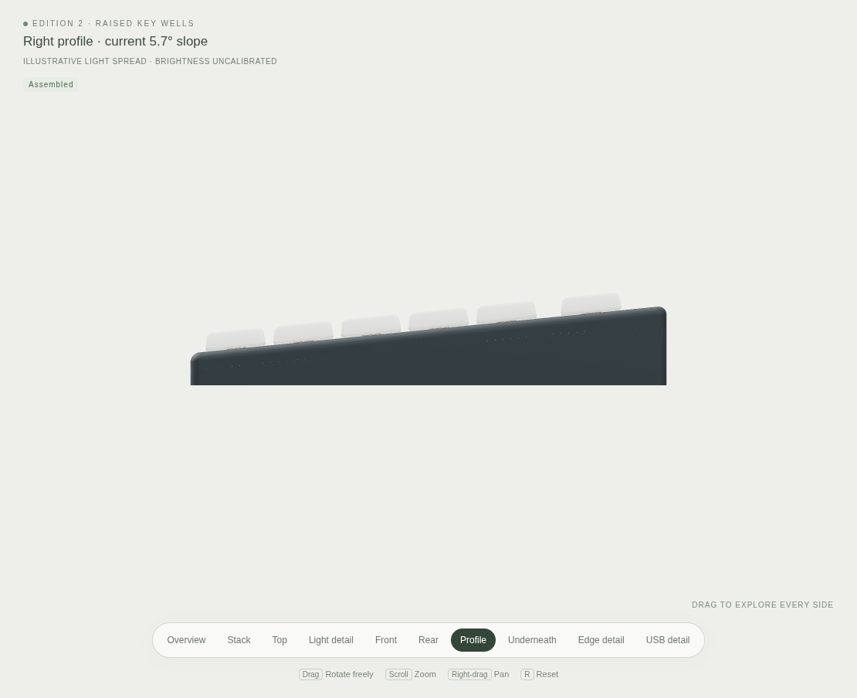
tkl/tkl11/render-assembly/views/assembled-side.png
