davidkellis/keyboards/tkl/tkl11/render-assembly/views/assembled-top.png

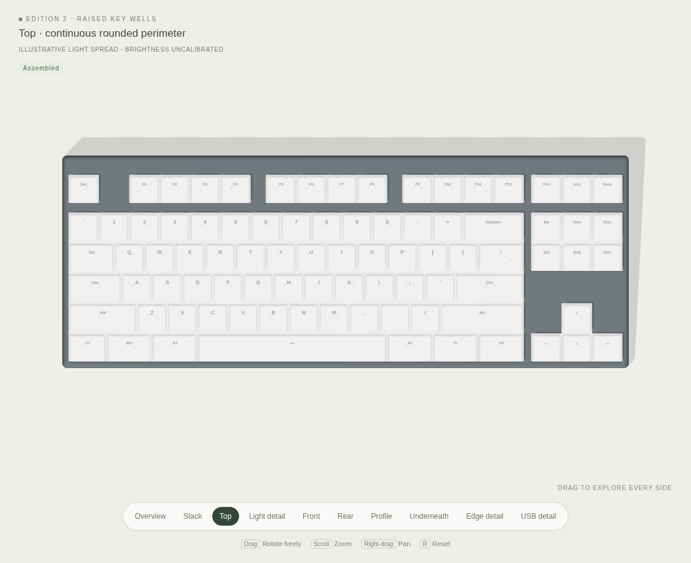
tkl/tkl11/render-assembly/views/assembled-top.png
