davidkellis/keyboards/tkl/tkl11/render-assembly/views/assembled-usb.png

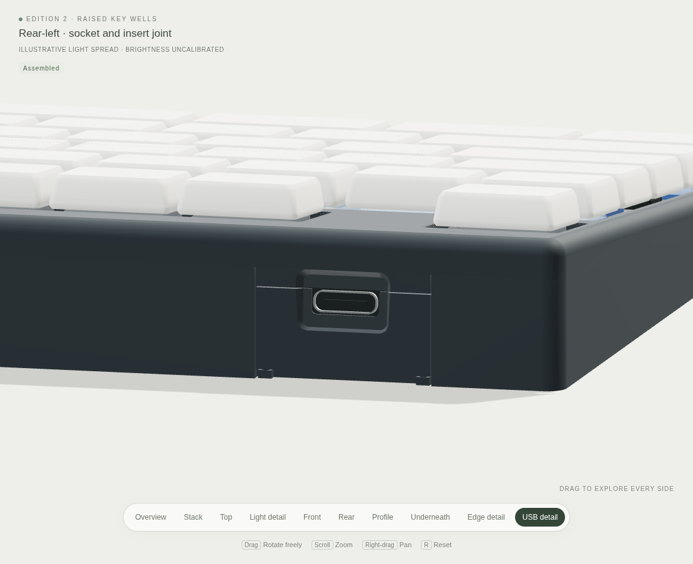
tkl/tkl11/render-assembly/views/assembled-usb.png
