davidkellis/keyboards/tkl/tkl11/render-assembly/views/dim-xvx-wob.png

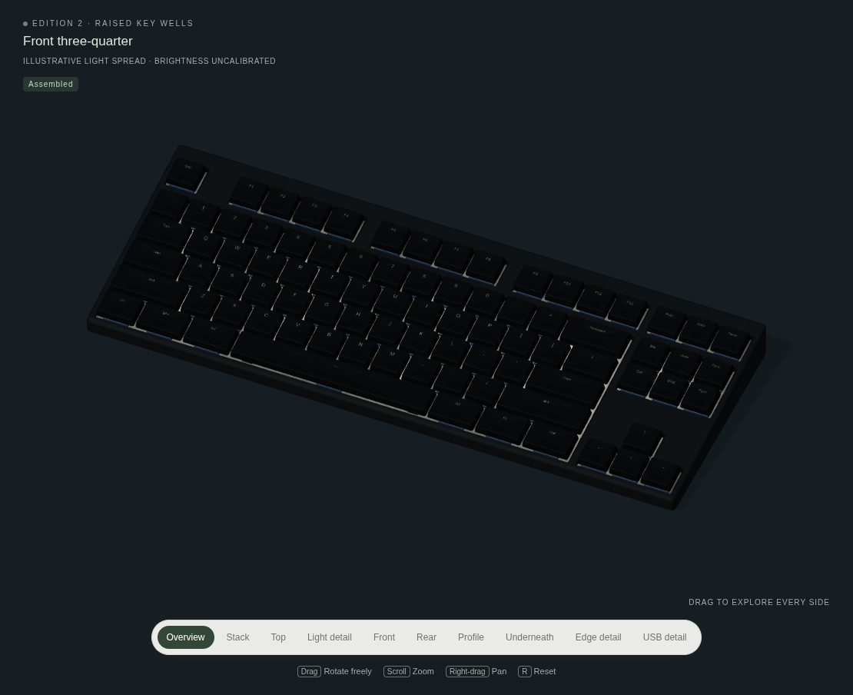
tkl/tkl11/render-assembly/views/dim-xvx-wob.png
