davidkellis/keyboards/tkl/tkl11/render-assembly/views/partially-exploded.png

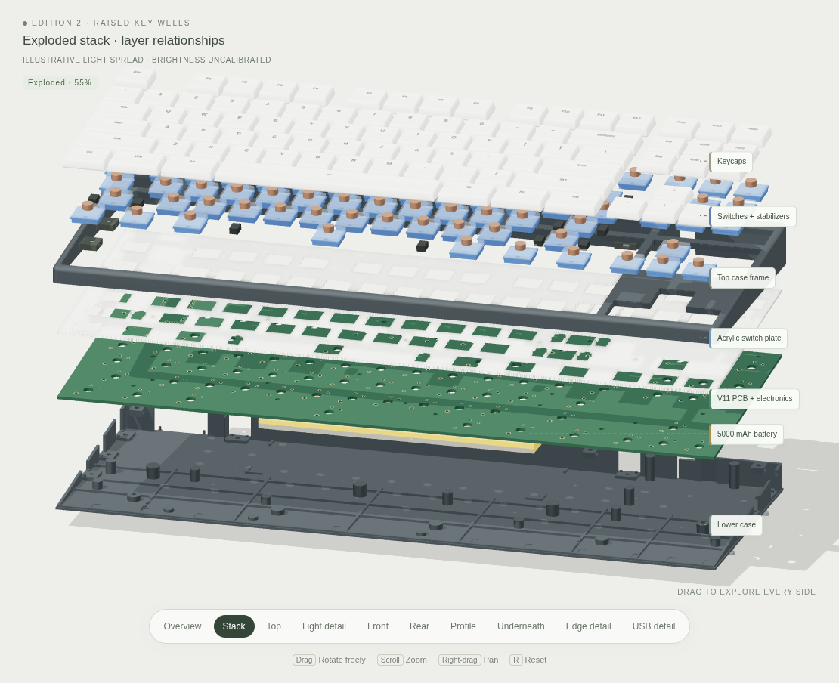
tkl/tkl11/render-assembly/views/partially-exploded.png
