davidkellis/keyboards/tkl/tkl11/render-assembly/views/pcb-ten-led-locations.png

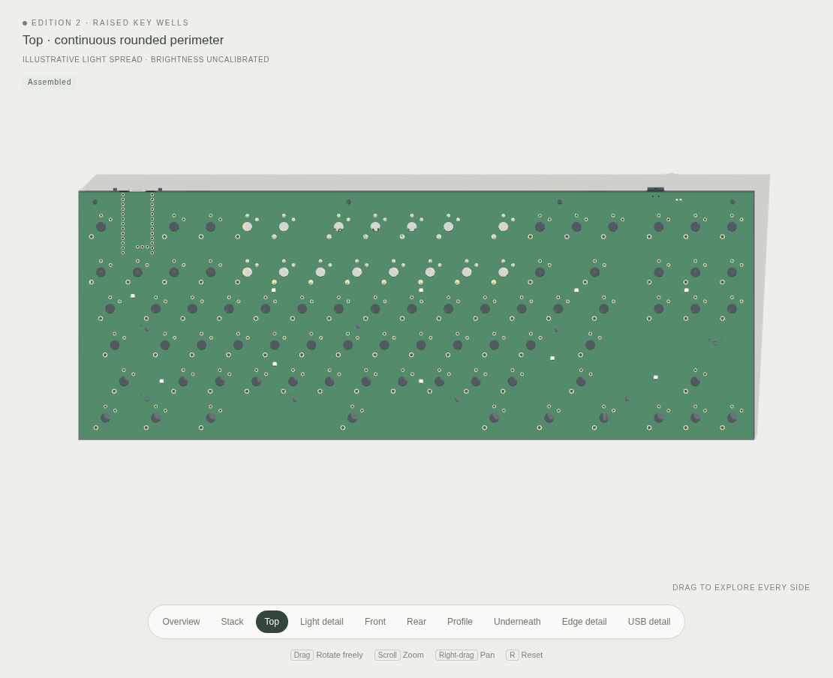
tkl/tkl11/render-assembly/views/pcb-ten-led-locations.png
