davidkellis/keyboards/tkl/tkl12/manufacturing/quote-v12-2026-10-16/hasl-economic/configured.png

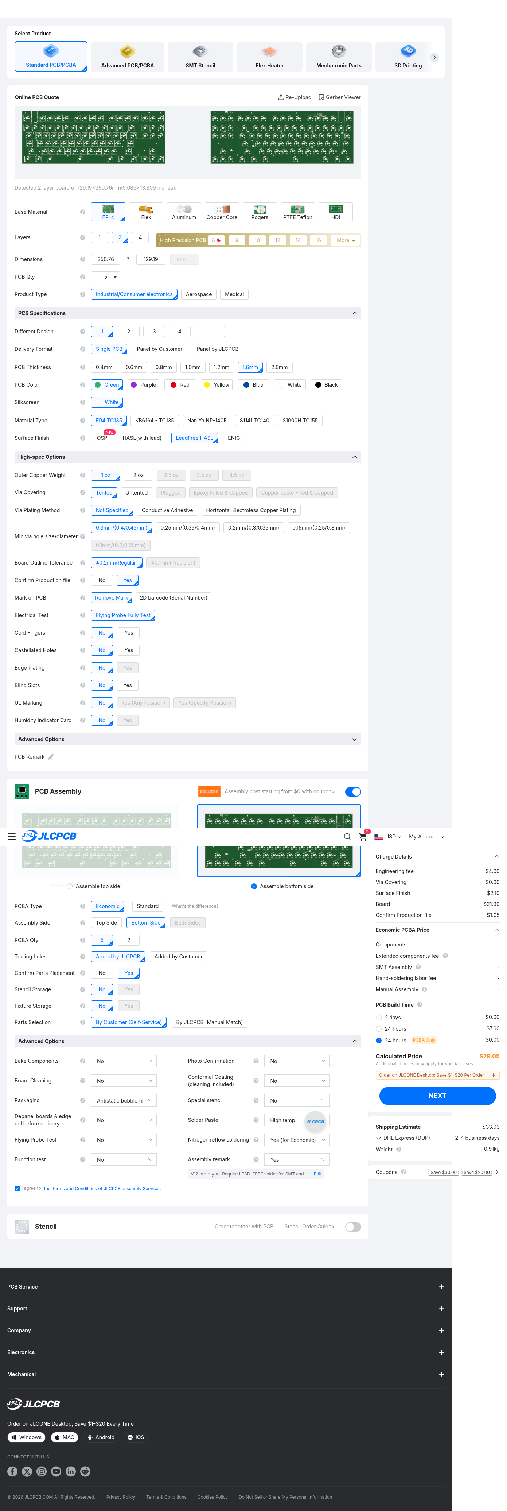
tkl/tkl12/manufacturing/quote-v12-2026-10-16/hasl-economic/configured.png
