davidkellis/keyboards/tkl/tkl12/manufacturing/quote-v12-2026-10-16/hasl-economic/placements.png

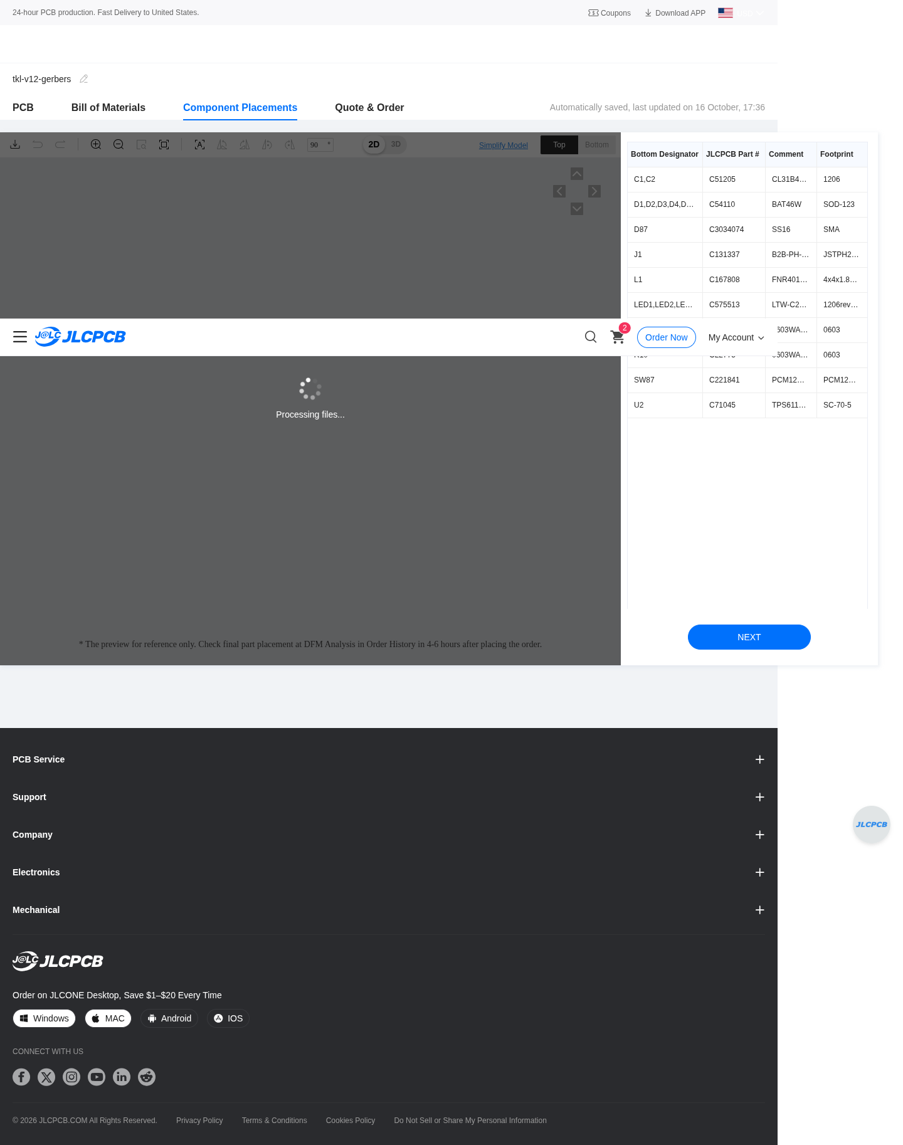
tkl/tkl12/manufacturing/quote-v12-2026-10-16/hasl-economic/placements.png
