davidkellis/keyboards/tkl/tkl12/reference/routing-history/README.md

# Intermediate routing diagnostics

These reports describe construction stages and temporary cleanup trials. They
do not describe the current PCB. The current checks are in ../../validation/;
summary.json, revision-audit.json and handoff-check.json are authoritative.
