davidkellis/keyboards/tkl/tkl10/validation/routing-history/README.md

# Historical routing diagnostics

These are intermediate placement/routing/cleanup reports. They do not describe
the final board. Use ../summary.json and ../drc.json for the final checked PCB.
