davidkellis/keyboards/tkl/tkl12/manufacturing/assembly-bottom.pdf

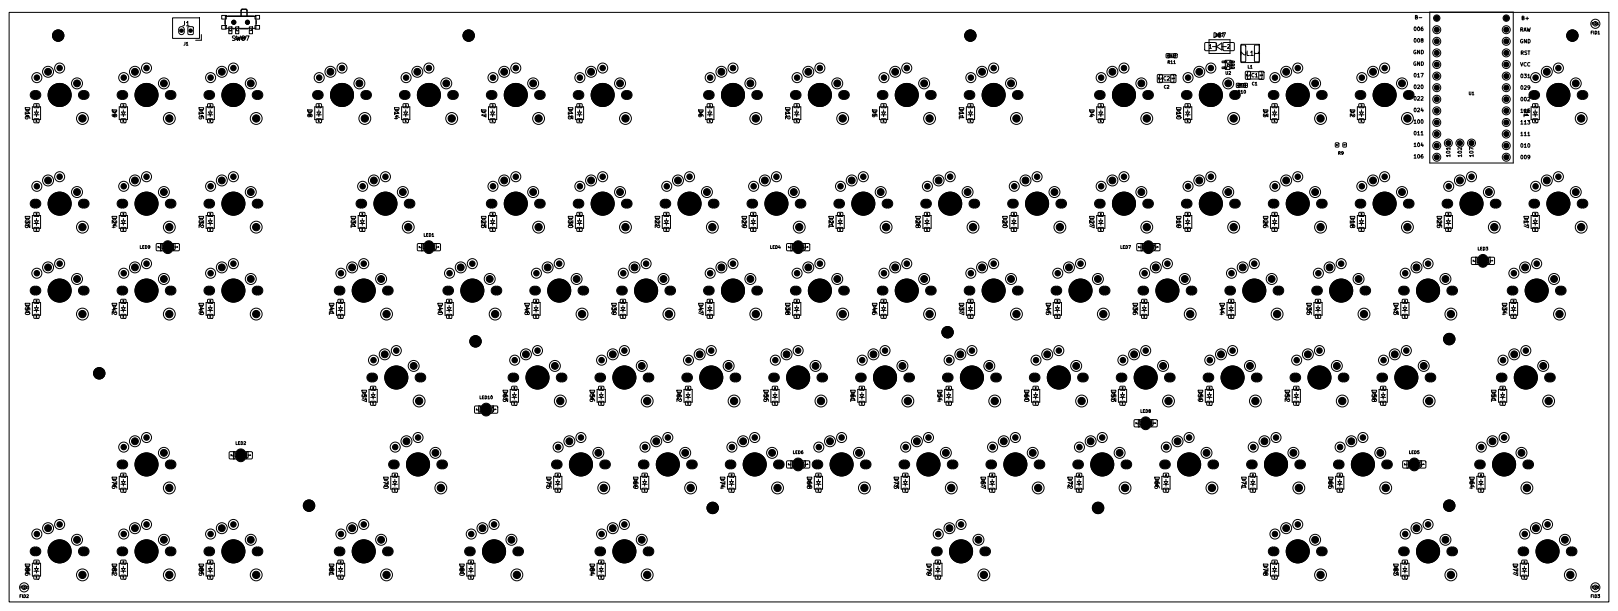
[picture p256: page 1]
