davidkellis/keyboards/tkl/tkl12/manufacturing/assembly-top.pdf

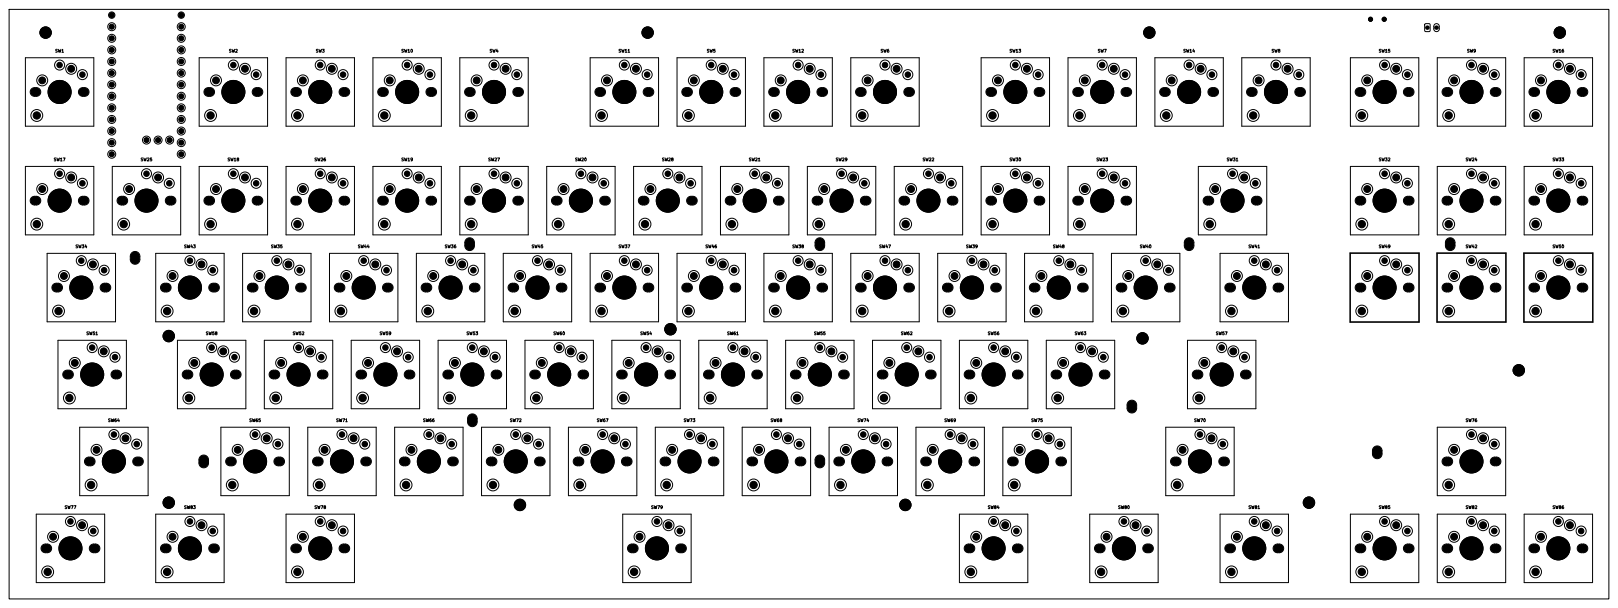
[picture p257: page 1]
