davidkellis/keyboards/tkl/tkl10/manufacturing/schematic.pdf

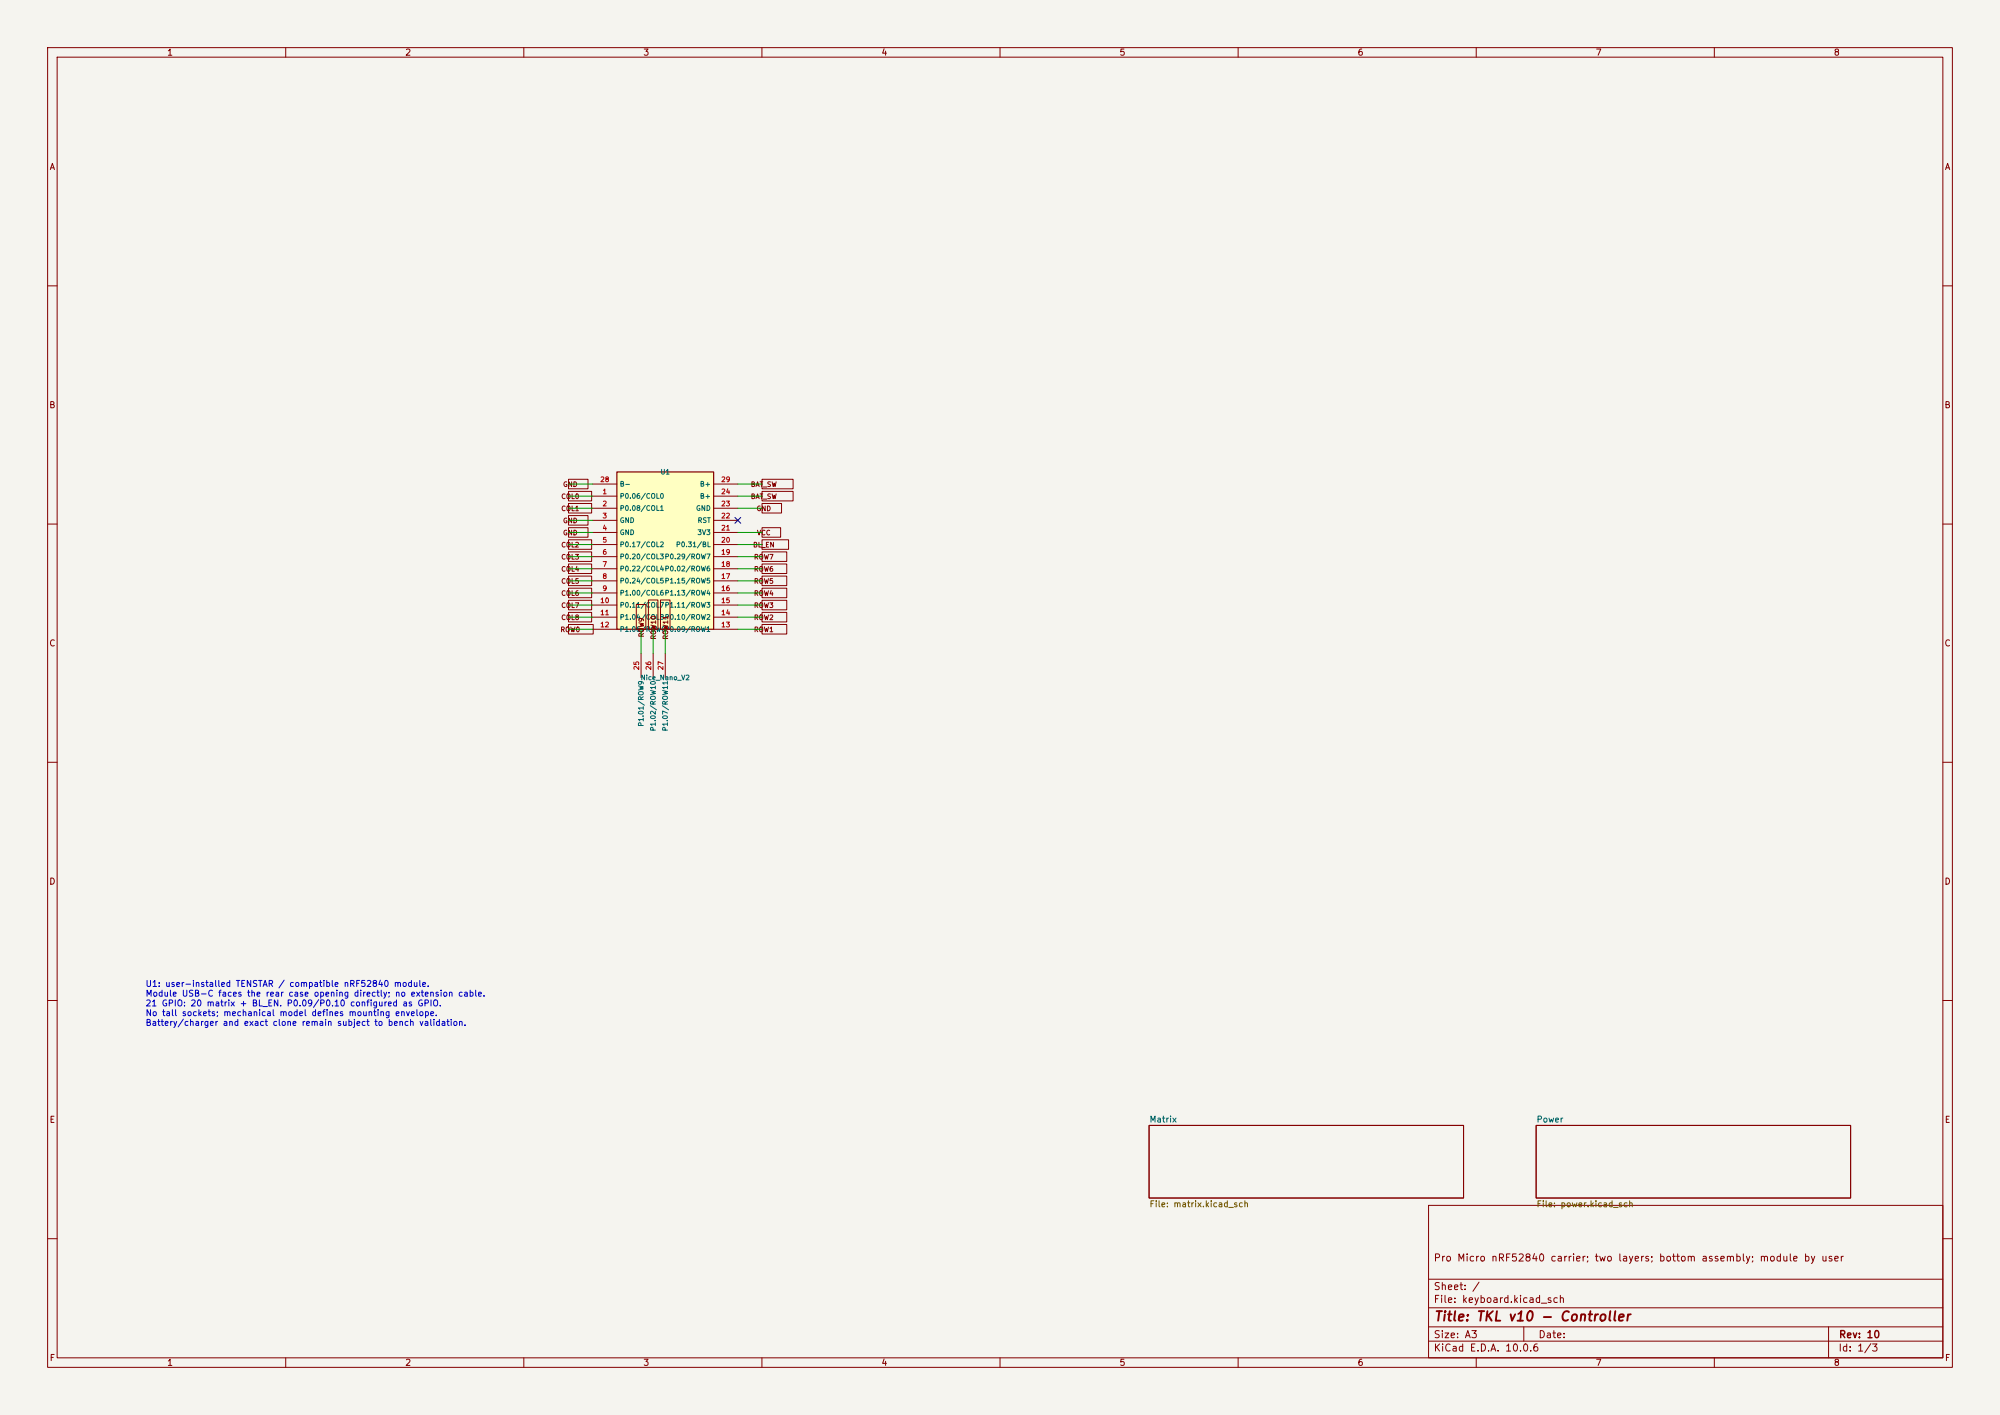
[picture p258: page 1]

COL5 U1: user-installed TENSTAR / compatible nRF52840 module. Module USB-C faces the rear case opening directly; no extension cable. 21 GPIO: 20 matrix + BL_EN. P0.09/P0.10 configured as GPIO. No tall sockets; mechanical model defines mounting envelope.

Battery/charger and exact clone remain subject to bench validation.

Pro Micro nRF52840 carrier; two layers; bottom assembly; module by user Power File: power.kicad_sch Matrix File: matrix.kicad_sch

Size: A3 | Rev: 10 | F Date:
KiCad E.D.A. 10.0.6 | Id: 1/3

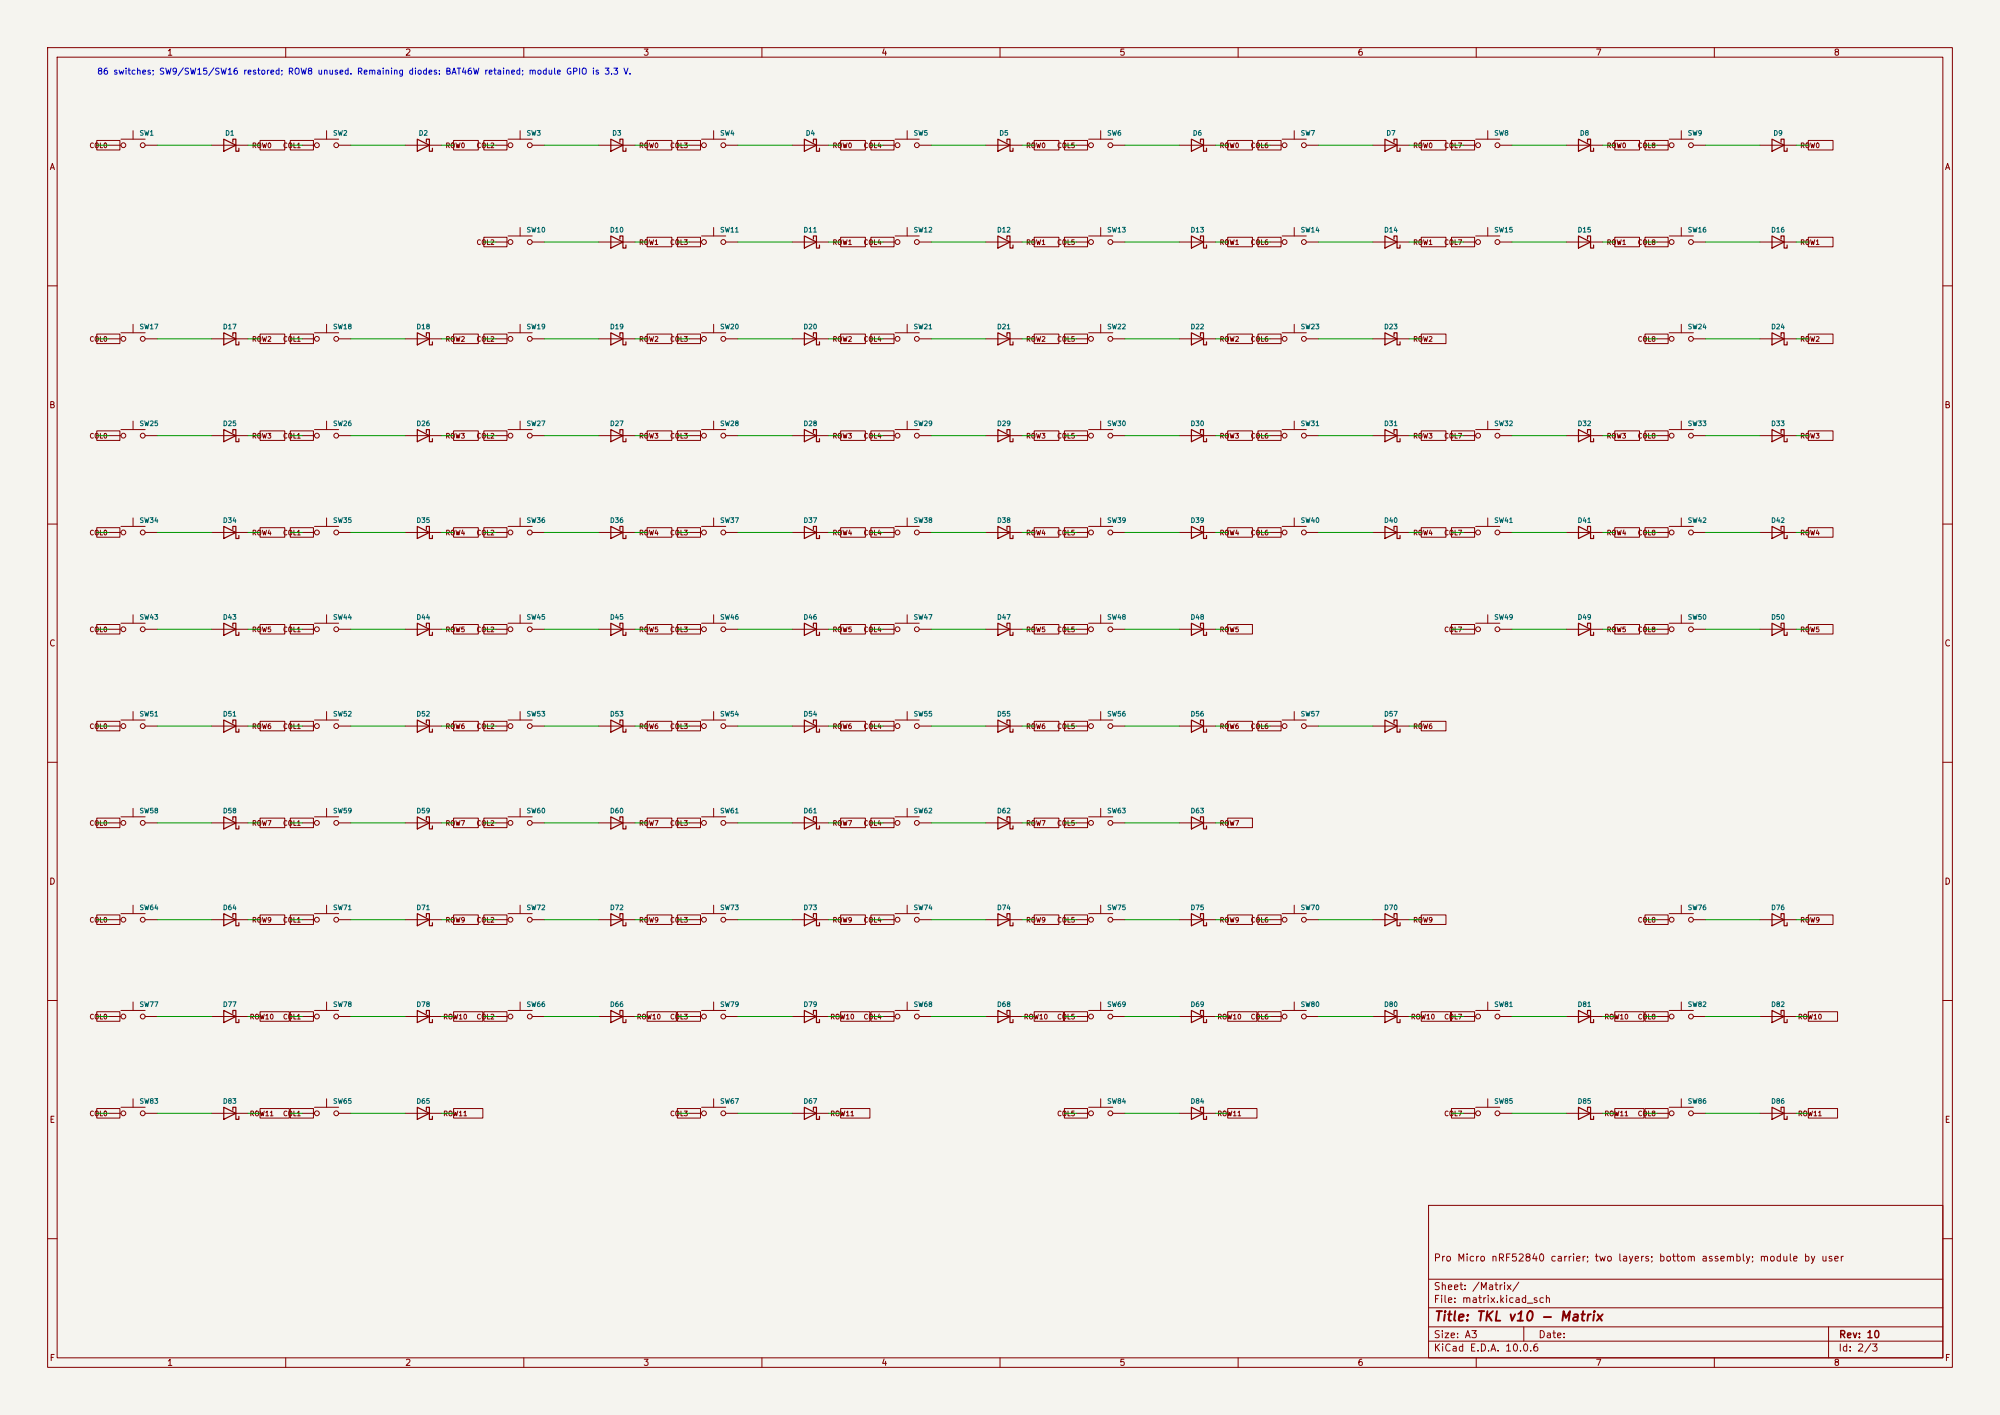
[picture p259: page 2]

Pro Micro nRF52840 carrier; two layers; bottom assembly; module by user

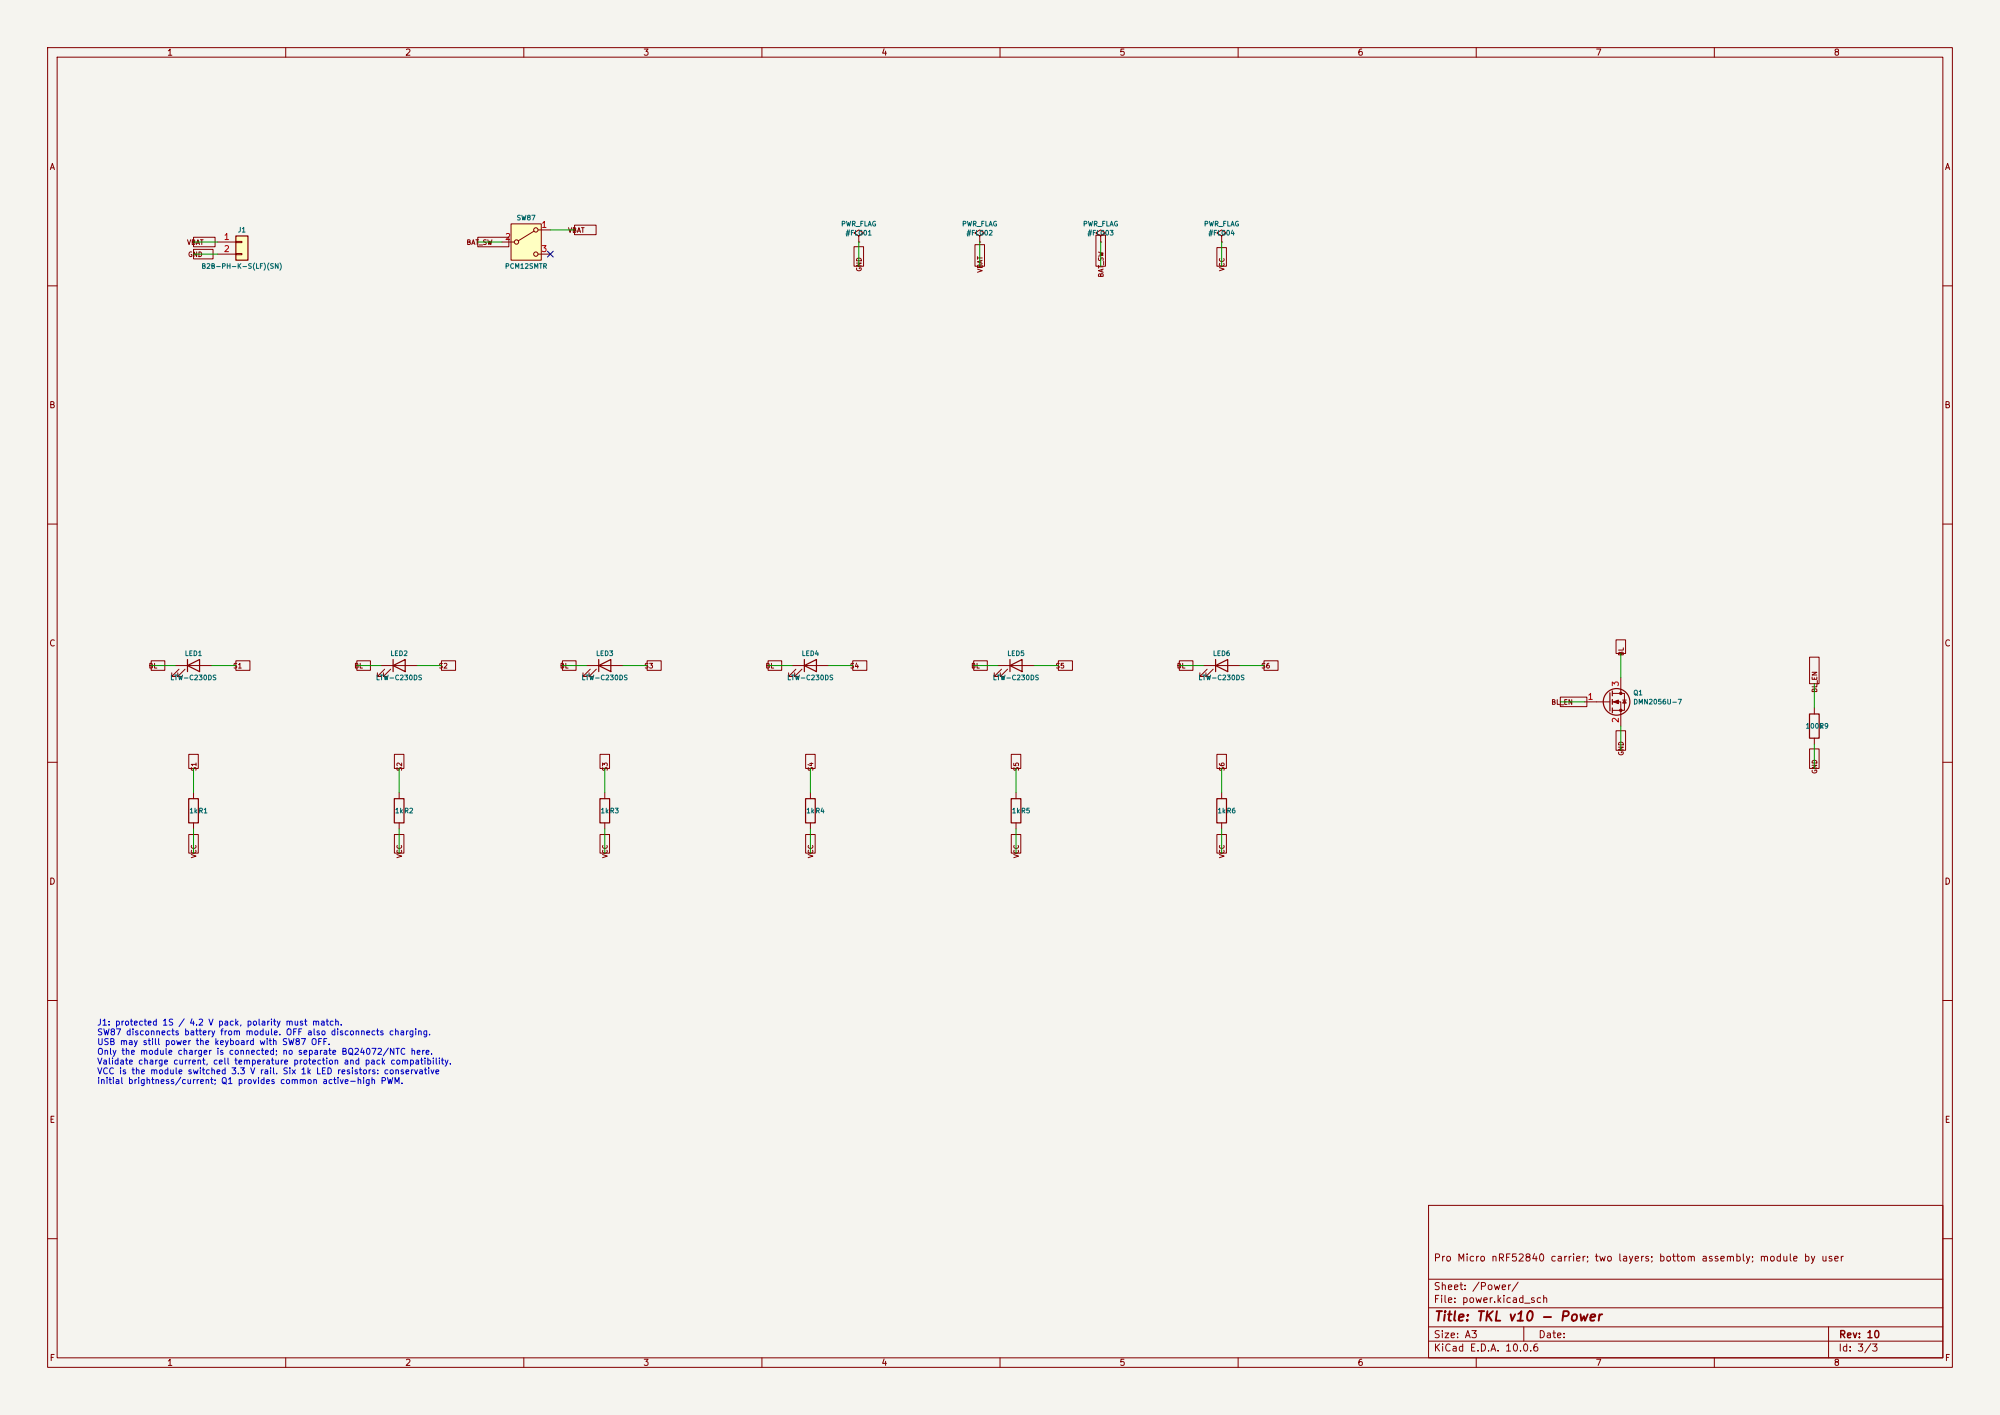
[picture p260: page 3]

S3 J1: protected 1S / 4.2 V pack, polarity must match. SW87 disconnects battery from module. OFF also disconnects charging. USB may still power the keyboard with SW87 OFF. Only the module charger is connected; no separate BQ24072/NTC here. Validate charge current, cell temperature protection and pack compatibility. VCC is the module switched 3.3 V rail. Six 1k LED resistors: conservative

initial brightness/current; Q1 provides common active-high PWM.

Pro Micro nRF52840 carrier; two layers; bottom assembly; module by user
