davidkellis/keyboards/tkl/tkl10/manufacturing/assembly-bottom.pdf

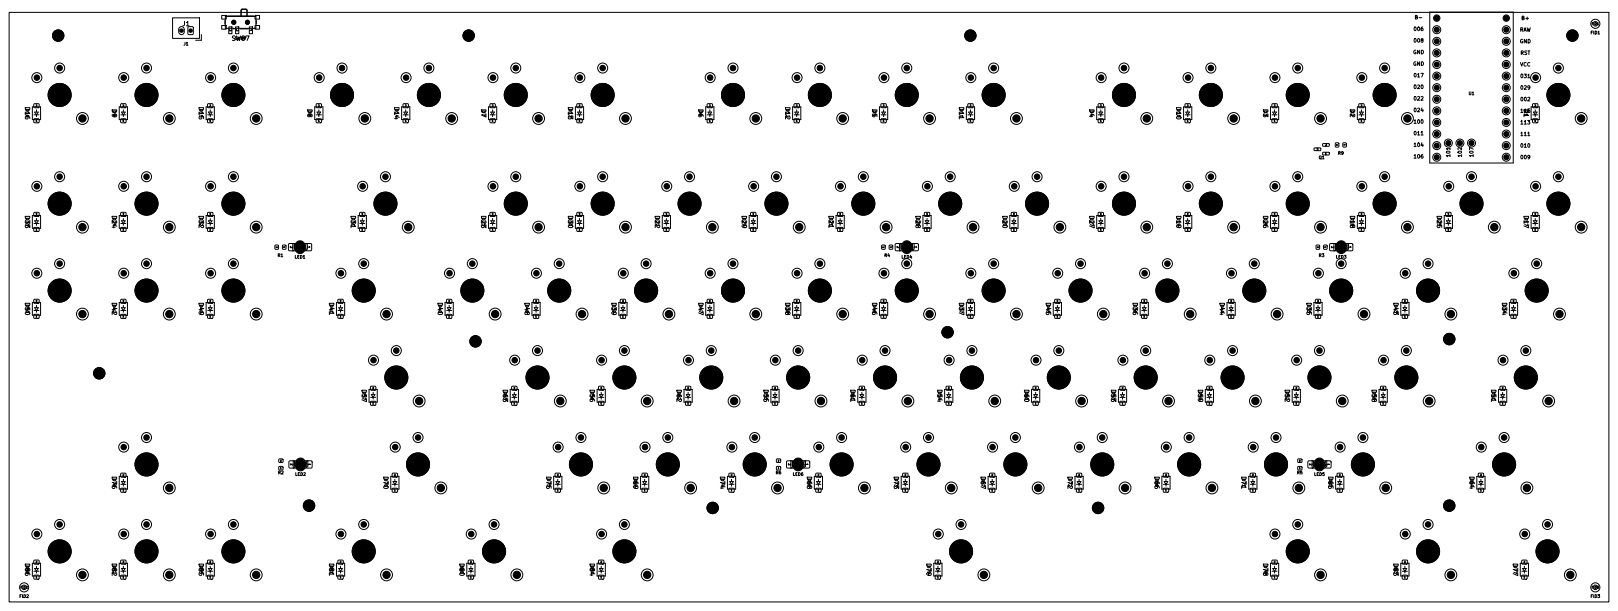
[picture p261: page 1]
