davidkellis/keyboards/tkl/tkl10/manufacturing/assembly-top.pdf

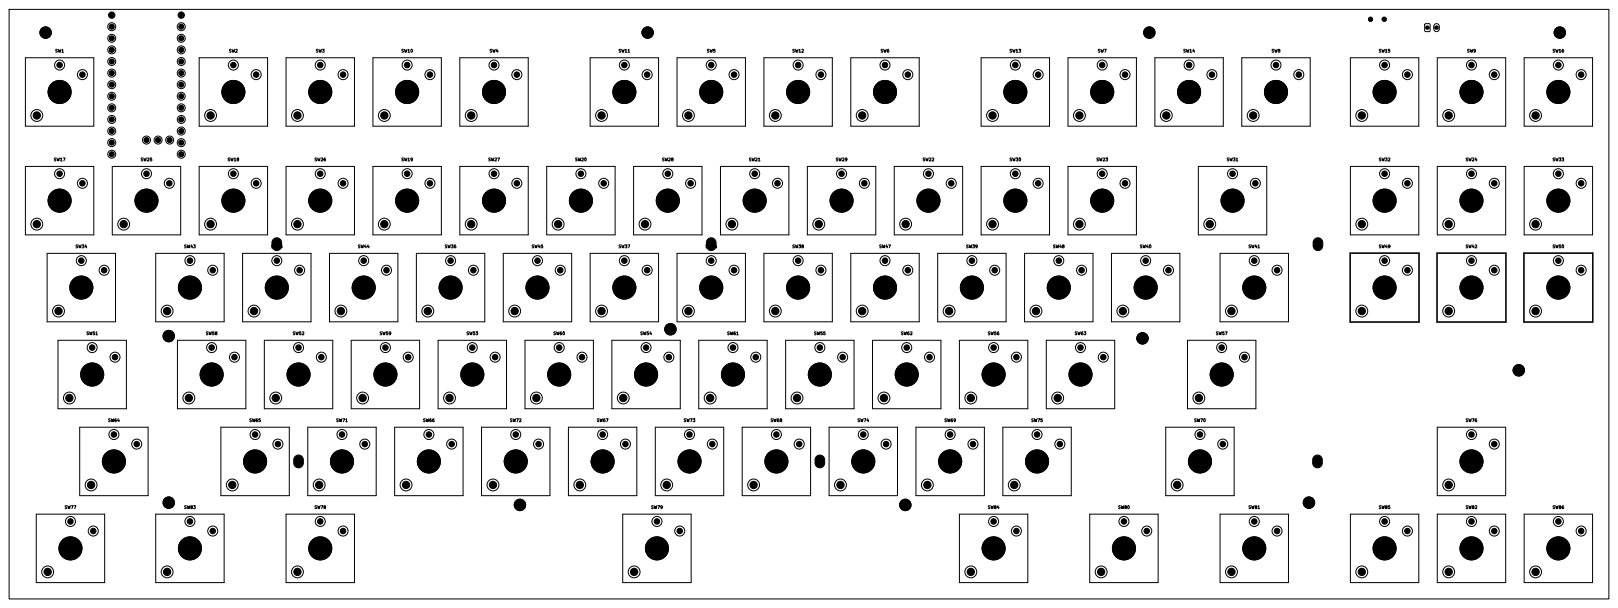
[picture p262: page 1]
