davidkellis/keyboards/(list of files, drawings)

Other design files:
tkl/tkl12/case/pcb-models.json
