davidkellis/keyboards/tkl/tkl1/tkl.kicad_pcb

## KiCad design tkl/tkl1/tkl.kicad_pcb (continued)

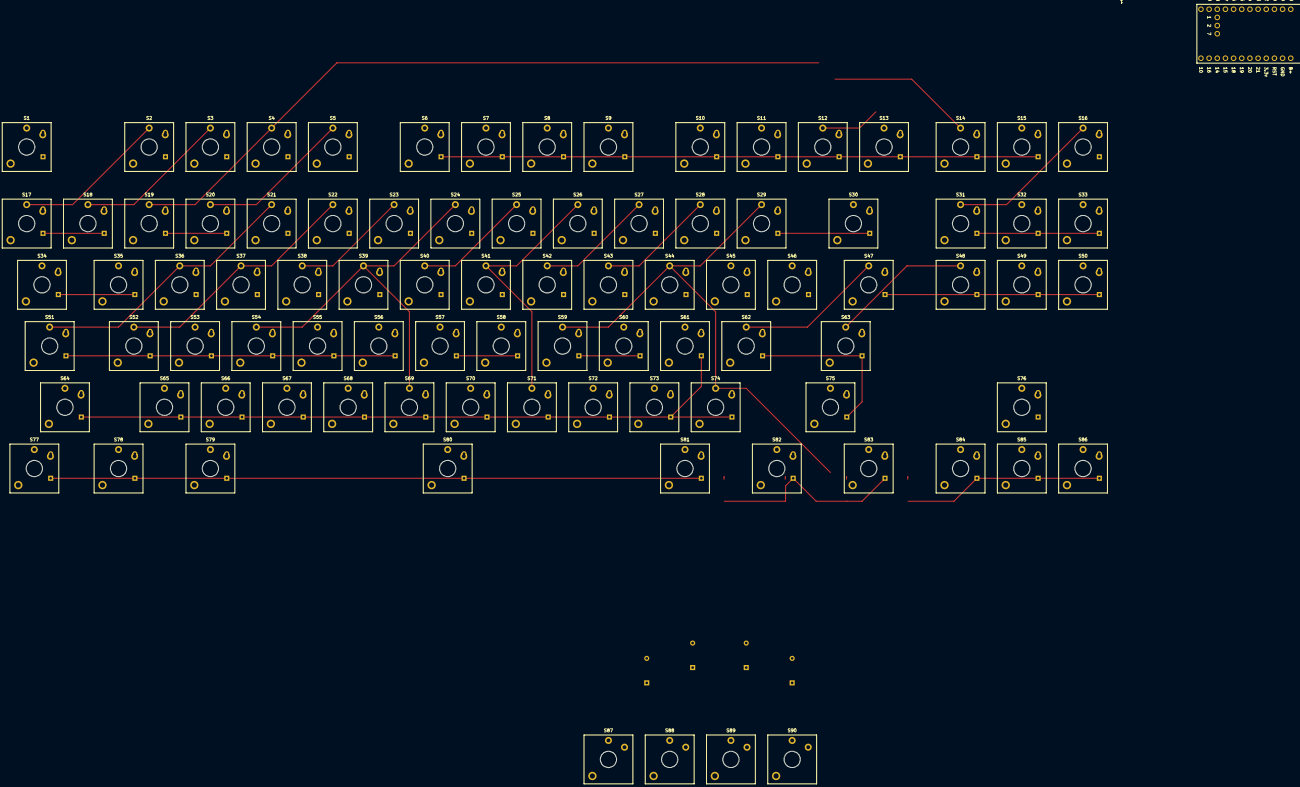
[picture p271: board tkl.kicad_pcb from above]

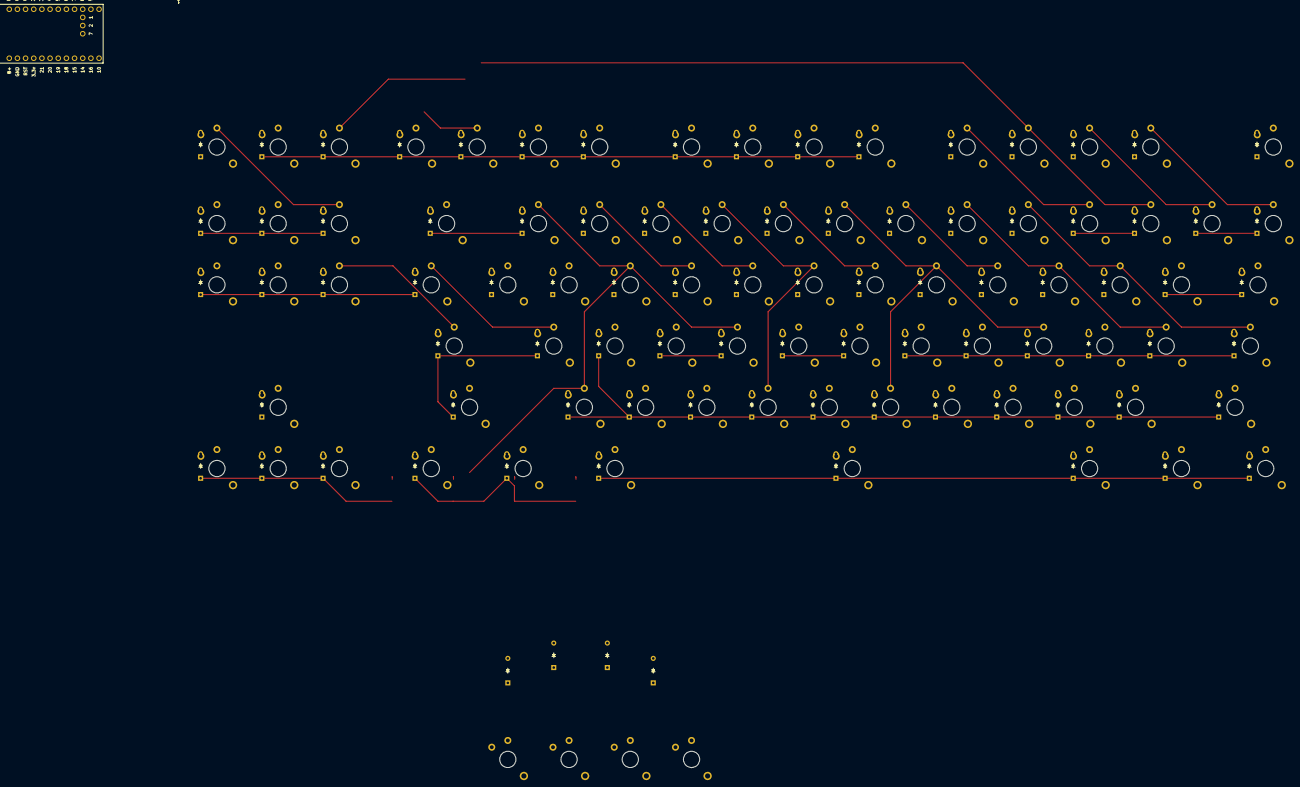
[picture p272: board tkl.kicad_pcb from below]

Board: 2 copper layers, 181 parts (90 on the bottom side), 111 nets.
