davidkellis/keyboards/tkl/tkl7.3/reference/nordic-config7.kicad_pcb

## KiCad design tkl/tkl7.3/reference/nordic-config7.kicad_pcb (2026-10-31)

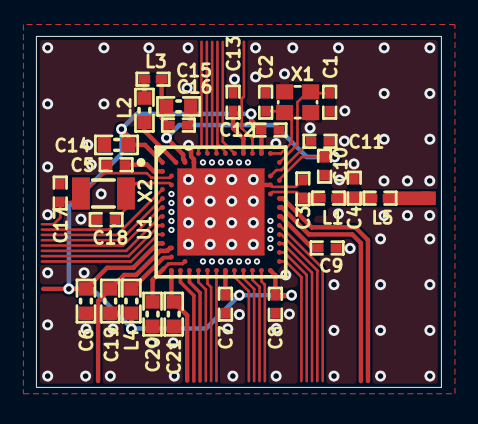
[picture p273: board nordic-config7.kicad_pcb from above]

Board: 4 copper layers, 22.5 x 19.5 mm, 29 parts (0 on the bottom side), 19 nets.

Parts:
C1, C2, C17, C18: 12pF; CAPC1005X04L
C3: 1.0pF; CAPC1005X04L
C4: 1.2pF; CAPC1005X04L
C5, C7, C8, C12: 100nF; CAPC1005X04L
C6, C19, C20, C21: 4.7µF; CAPC1608X06L
C9: 820pF; CAPC1005X04L
C10, C13: N.C.; CAPC1005X04L
C11: 100pF; CAPC1005X04L
C14, C15: 1.0µF; CAPC1608X06L
C16: 47nF; CAPC1005X04L
L1: 4.7nH; INDC1005X04L
L2, L4: 10µH; INDC1608X06L
L3: 15nH; INDC1005X04L
L5: 2.2nH; INDC1005X04L
U1: nRF52840-QIAA; AQFN50P700X700X85_HS-74N
X1: 32MHz; BT-XTAL_2016
X2: 32.768kHz; XTAL_3215

Connections:
DEC1: C5.1, U1.C1
DEC3: C11.1, U1.D23
DEC4_6: C10.2, C15.2, C16.1, L3.1, U1.B5, U1.E24
GND: C1.2, C2.2, C3.1, C4.1, C5.2, C6.2, C7.2, C8.2, C9.2, C10.1, C11.2, C12.2, C13.2, C14.2, C15.1, C16.2, C17.2, C18.2, C19.2, C20.2, C21.2, U1.74, U1.B7, U1.F23, X1.2, X1.4
NetC3_2: C3.2, L1.1, U1.H23
NetC4_2: C4.2, L1.2, L5.1
NetC9_1: C9.1, U1.N24
NetC13_1: C13.1, U1.A18
NetC20_1: C20.1, U1.AC5
NetL2_1: L2.1, L3.2
NetL2_2: L2.2, U1.B3
NetL4_2: L4.2, U1.AB2
P0.00/XL1: C17.1, U1.D2, X2.1
P0.01/XL2: C18.1, U1.F2, X2.2
VBUS: C21.1, U1.AD2
VDD_HV: C19.1, U1.Y2
VDD_NRF: C6.1, C7.1, C8.1, C12.1, C14.1, L4.1, U1.A22, U1.AD14, U1.AD23, U1.B1, U1.W1
XC1: C1.1, U1.B24, X1.1
XC2: C2.1, U1.A23, X1.3
