davidkellis/keyboards/tkl/tkl12/manufacturing/quote-v12-2026-10-16/hasl-economic/configured.txt

24
SMT
2
USD 
My Account 

Select Product

Standard PCB/PCBA

Advanced PCB/PCBA

SMT Stencil

Flex Heater

Mechatronic Parts

3D Printing

CNC Machining

PCB Layout

Sheet Metal

Online PCB Quote
 Re-Upload
 Gerber Viewer
Detected 2 layer board of 129.19x350.76mm(5.086x13.809 inches).
Base Material
FR-4
Flex
Aluminum
Copper Core
Rogers
PTFE Teflon
HDI
Layers
124
High Precision PCB
6 
8
10
12
14
16
Dimensions
 *  
PCB Qty
5
Product Type
Industrial/Consumer electronicsAerospaceMedical
PCB Specifications
Different Design
1 234 
Delivery Format
Single PCB Panel by Customer Panel by JLCPCB
PCB Thickness
0.4mm0.6mm0.8mm1.0mm1.2mm1.6mm2.0mm
PCB Color
Green
 
Purple
 
Red
 
Yellow
 
Blue
 
White
 
Black
Silkscreen
White
Material Type
FR4 TG135KB6164 - TG135Nan Ya NP-140FS1141 TG140S1000H TG155
Surface Finish
OSP
New
 HASL(with lead) LeadFree HASL ENIG
High-spec Options
Outer Copper Weight
1 oz2 oz2.5 oz3.5 oz4.5 oz
Via Covering
TentedUntentedPluggedEpoxy Filled & CappedCopper paste Filled & Capped
Via Plating Method
Not SpecifiedConductive AdhesiveHorizontal Electroless Copper Plating
Min via hole size/diameter
0.3mm/(0.4/0.45mm)0.25mm/(0.35/0.4mm)0.2mm/(0.3/0.35mm)0.15mm/(0.25/0.3mm)0.1mm/(0.2/0.25mm)
Board Outline Tolerance
±0.2mm(Regular)±0.1mm(Precision)
Confirm Production file
NoYes
Mark on PCB
Remove Mark2D barcode (Serial Number)
Electrical Test
Flying Probe Fully Test
Gold Fingers
No Yes
Castellated Holes
No Yes
Edge Plating
NoYes
Blind Slots
NoYes
UL Marking
NoYes (Any Position)Yes (Specify Position)
Humidity Indicator Card
NoYes
Advanced Options
PCB Remark 
PCB Assembly
 Assembly cost starting from $0 with coupon>
 Assemble top side
 Assemble bottom side
PCBA Type
Economic Standard What's the difference?
Assembly Side
Top Side Bottom Side Both Sides
PCBA Qty
5 2
Tooling holes
Added by JLCPCB Added by Customer
Confirm Parts Placement
No Yes
Stencil Storage
No Yes
Fixture Storage
No Yes
Parts Selection
By Customer (Self-Service) By JLCPCB (Manual Match)
Advanced Options
Bake Components
Photo Confirmation
Board Cleaning
Conformal Coating (cleaning included)
Packaging
Special stencil
Depanel boards & edge rail before delivery
Solder Paste
Flying Probe Test
Nitrogen reflow soldering
Function test
Assembly remark
V12 prototype. Require LEAD-FREE solder for SMT and J1 through-hole joints. LED1-LED10 are LTW-C230DS reverse-mount parts on Bottom, emitting upward through the PCB slots. Follow BOM/CPL polarity. Populate all 10 LEDs; do not omit or substitute. Please quote any mandatory reverse-LED fixture/handling charge before production. No paid rail removal. Customer installs MCU module and key switches.
Edit

I agree to the Terms and Conditions of JLCPCB assembly Service .

Stencil
Stencil Order Guide>
Order together with PCB
Charge Details
Engineering fee
$4.00
Via Covering
$0.00
Surface Finish
$2.10
Board
$21.90
Confirm Production file
$1.05
Economic PCBA Price
Components
-
Extended components fee 
-
SMT Assembly 
-
Hand-soldering labor fee
-
Manual Assembly 
-
PCB Build Time 
 2 days
$0.00
 24 hours
$7.60
 24 hours PCBA Only
$0.00
Calculated Price
$29.05

Additional charges may apply for special cases

Order on JLCONE Desktop: Save $1–$20 Per Order
NEXT
Shipping Estimate
$33.03
DHL Express (DDP)
2-4 business days
Weight 
0.91kg
Coupons 
Save $30.00Save $20.00 
PCB Service
Support
Company
Electronics
Mechanical
Order on JLCONE Desktop, Save $1–$20 Every Time
Windows
MAC
Android
IOS
CONNECT WITH US
© 2026 JLCPCB.COM All Rights Reserved.
Privacy Policy
Terms & Conditions
Cookies Policy
Do Not Sell or Share My Personal Information
Assembly remark Remark
