davidkellis/keyboards/(commit log)

2026-10-31 Add TKL v0 original KiCad project
    Preserve the current design snapshot in the consistent numbered directory layout.
    [tkl.kicad_pcb, tkl.kicad_sch]
2026-10-31 Add TKL v1 keyboard designs
    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
    [tkl.kicad_pcb, tkl.kicad_sch]
2026-10-31 Add TKL v2 keyboard design
    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
    [keyboard.kicad_pcb, keyboard.kicad_sch]
2026-10-31 Add TKL v3 keyboard design
    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
    [keyboard-plate.dxf, keyboard.kicad_pcb, keyboard.kicad_sch, tklplate.stl]
2026-10-31 Add TKL v4 keyboard and case design
    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
    [case-left.stl, case-right.stl, case.scad, keyboard-plate.dxf, keyboard.kicad_pcb, keyboard.kicad_sch, plate-laser.dxf, plate-left.stl]
2026-10-31 Add TKL v5 keyboard and case design
    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
    [bom-top.csv, bom.csv, case-left.stl, case-right.stl, case.scad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]
2026-10-31 Add TKL v6 keyboard and case design
    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
    [case.scad, case.stl, cover.stl, fit.scad, keyboard-plate.dxf, keyboard.kicad_pcb, keyboard.kicad_sch, keycaps-left.stl]
2026-10-31 Add TKL v7 designs and v7.x variants
    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
    [2u-assembly.step, 2u-pcb-diagnostic-relief.stl, 2u-pcb-for-1.2mm-plate.stl, 2u-pcb-for-1.5mm-plate.stl, 2u-pcb-for-1.6mm-plate.stl, 2u-plate-1.2mm.stl, 2u-plate-1.5mm.stl, 2u-plate-1.6mm.stl]
2026-10-31 Add TKL v8 top LED keyboard design
    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
    [2u-assembly.step, 2u-pcb-diagnostic-relief.stl, 2u-pcb-for-1.2mm-plate.stl, 2u-pcb-for-1.5mm-plate.stl, 2u-pcb-for-1.6mm-plate.stl, 2u-plate-1.2mm.stl, 2u-plate-1.5mm.stl, 2u-plate-1.6mm.stl]
2026-10-31 Add TKL v9 designs and v9.x case revisions
    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
    [assembled-exploded.scad, assembled-preview.scad, assembly-notes.csv, base-preview.scad, base-split.step, battery-pack-max-gauge-264x50x5.5-left.stl, battery-pack-max-gauge-264x50x5.5-right.stl, battery-pack-max-gauge-264x50x5.5.stl]
2026-10-31 Add TKL v10 controller, case, and lighting studies
    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
    [M1-carrier-assembly.stl, M1-nut-assembly.stl, M1-screw-assembly.stl, M2-carrier-assembly.stl, M2-nut-assembly.stl, M2-screw-assembly.stl, M3-carrier-assembly.stl, M3-nut-assembly.stl]
2026-10-31 Add TKL v11 reverse LED acrylic plate design
    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
    [acrylic-plate-trial.dxf, assembly-notes.csv, comparison.csv, configured.txt, dimensions-and-compatibility.csv, jlcpcb-bom.csv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]
2026-10-31 Add TKL v12 multi-switch keyboard design
    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
    [assembly-notes.csv, configured.txt, dimensions-and-compatibility.csv, jlcpcb-bom.csv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]
